2AMLogic/sky130-bandgap/layout/README.md

# layout/ — the klayout-tools (`klt`) DRC/LVS flow

Issue #14's deliverable: a headless, repeatable DRC/LVS flow driven by
[`klayout-tools`](https://github.com/2AMLogic/klayout-tools) (`klt`),
**proven on a trivial known-good cell**. Bandgap-core-specific layout
starts with issue #15's floorplan + matching plan (see "Extending to the
bandgap core" below) — the material above this section predates that and
is not core-specific.

Two rules from the root `CLAUDE.md` shape this directory the same way they
shape `sim/`:

- **Verification is the product.** A DRC/LVS "pass" claim ships with the
  actual reports it came from, plus a negative control proving the flow can
  also report failure.
- **Friction protocol, with force.** Every `klt` gap/awkwardness hit while
  standing this up gets checked against the public
  [`2AMLogic/klayout-tools`](https://github.com/2AMLogic/klayout-tools)
  tracker and filed (or, if already tracked, cross-confirmed) there —
  tool-gap description only, never this repo's design/spec content. See
  "Friction protocol: what was found" below.

## Quick start (cold machine)

```bash
# 1. install the pinned klt build (~10s; see requirements.txt for the pin)
layout/bin/setup-venv.sh

# 2. sanity-check the sky130A PDK resolves (same pin as sim/pdk.json)
layout/.venv/bin/klt pdk find --pdk sky130A

# 3. run the trivial-cell DRC/LVS proof (~5s)
layout/bin/run-trivial-cell-flow.sh
```

The last command writes a fresh, timestamped record under
`trivial-cell/reports/<record-id>/` and updates
`trivial-cell/reports/LATEST` to point at it. The current record is
whichever directory `trivial-cell/reports/LATEST` names (today
[`trivial-cell/reports/20260806-055840-3a4293a/record.md`](trivial-cell/reports/20260806-055840-3a4293a/record.md))
— **read that file first**; it is the actual pass/fail evidence this issue
delivers, not this README.

The oldest record, `20260803-133256-69a6ac2` (the original issue #14 proof
under `klt 0.1.0`, a different cell geometry and different LVS counts), is
retained as a historical citation, along with the other pre-`20260804-162626`
runs. Eight later runs that reproduced the current record's outcome were
pruned; see [`trivial-cell/PRUNED-RUNS.md`](trivial-cell/PRUNED-RUNS.md) for
the list and the recovery command.

## Why `klt`, and why a PyPI release pin

`klayout-tools` v0.8.0 on PyPI ships every verb this flow needs (`gen`,
`extract`, `lvs`, `drc`, `erc`, `pdk`, ...). Earlier in this repo's history
the PyPI release lagged `main` and the flow pinned an exact git commit
([2AMLogic/klayout-tools#342](https://github.com/2AMLogic/klayout-tools/issues/342));
issue #448 moved both requirements files to `klayout-tools==0.8.0`. A git
build now reports a dev version that fails an `==0.8.0` pin
(klayout-tools#2823), so the PyPI pin is preferred. `requirements.txt`
pins an **exact version**, not floating `main`, for the same reproducibility
discipline `sim/pdk.json` applies to the PDK version — a re-run months from
now installs the identical `klt` build instead of whatever `main` has
drifted to since. Bump the pin deliberately (and re-run
`layout/bin/run-trivial-cell-flow.sh` to refresh the checked-in report)
when picking up new `klt` capability.

## The flow

```
klt gen mos_array --pdk sky130A         (1) build the trivial known-good cell
        |
        v
klt drc <cell>.gds --deck sky130        (2) DRC against the sky130 deck
        |
        v
klt extract <cell>.gds --deck sky130    (3) layout -> schematic-equivalent netlist
        |
        v
klt lvs (extracted vs. hand-written      (4) LVS: topology compare
         reference netlist)
```

**The trivial cell**: `klt gen mos_array`'s documented defaults (a 2x2
array of unit NMOS devices with a one-column dummy guard on each side,
`nfet` flavor, no well) are chosen because the project's own docs guarantee
every generator's default `params` pass `klt drc --deck sky130` clean —
exactly the "trivial known-good cell" this issue's acceptance criteria
call for. `res_array` (the resistor-array generator — closer in spirit to
this repo's own poly-resistor-heavy topology) was tried first and rejected
for this specific proof: its output cannot round-trip through `klt
extract`'s resistor recognition today, a real `klt` gap, not a mistake on
this repo's side — see "Friction protocol" below. `mos_array` has no such
gap and round-trips cleanly through the whole flow.

**The reference netlist** (`trivial-cell/reference.spice`) is hand-written
to match `mos_array`'s pinned-default topology: 4 independent *real* unit
NMOS devices, each with its own isolated source/drain/gate net, bodies tied
to one shared `vsubs` pin. `klt lvs`/`NetlistComparer` compares topology, not
net *names* (see
[`docs/cli/lvs.md`](https://github.com/2AMLogic/klayout-tools/blob/main/docs/cli/lvs.md)
in the `klayout-tools` repo), so the reference's arbitrary net names do not
need to match the extracted netlist's own arbitrary `$N`-style names.
`mos_array` still physically draws 8 units (4 real + 4 dummy, the default
2x2-array-with-1-dummy-column shape) -- since issue #62's fourteenth
increment (2AMLogic/klayout-tools#490/#491, merged via #494/#495), sky130's
curated deck recognizes the 4 dummy-column units as dummies (no schematic
counterpart by construction) and `klt extract` drops them from the
comparison, so the reference only needs to state the 4 that matter. See
`trivial-cell/reference.spice`'s own header for the full history.

**Two negative controls** (`reference.broken-device.spice`,
`reference.broken-topology.spice`) prove the flow actually *fails* on a
real defect, not just that it produces a report — per `klt lvs`'s own
documented guidance, a device-parameter-only corruption and an independent
topology (shorted-net) corruption, since a single corruption class can
pass by accident on a compare that ignores the other axis. Both must (and
do) report `status: "mismatch"`.

## Repeatability

`layout/bin/run-trivial-cell-flow.sh` was run twice in immediate succession
from a clean worktree; both runs produced the identical four-way verdict
(DRC clean, LVS match on the good reference, LVS mismatch on both negative
controls) — `layout/bin/render-record.py` asserts all four and exits
non-zero if any flips, so a silent regression on a future `klt` pin bump
would fail loudly instead of quietly shipping a stale-looking "clean"
report. Only one of the two runs' reports is checked in (the redundant
second run added no evidence).

## Directory layout

```
layout/
  README.md                  # this file
  requirements.txt           # pinned `klt` install (PyPI `==0.8.0`) for the DRC/LVS flow
  bin/
    setup-venv.sh             # create/refresh layout/.venv from requirements.txt
    run-trivial-cell-flow.sh  # the repeatable driver: gen -> drc -> extract -> lvs -> report
    run-erc-supply-flow.sh    # T1 item 11: klt erc supply-spec run -> bandgap-core/erc/
    erc_supply_record.py      # that flow's gate + record.md renderer
    met1_bus.py               # hand-drawn met1 bussing + the met2/via1 escape plane
    met2_drc.py               # DRC for the met2 plane the curated deck has no rules for
    measure_mim_overlay_feasibility.py  # re-runnable "can MCC be a MiM overlay?" measurement
    measure_combine_devices_determinism.py  # re-runnable "does klt lvs's verdict reproduce?" measurement
    render-record.py          # renders + verdict-checks a record's record.md
  tests/                      # PDK-free unit coverage for the flows' own gates
  .venv/                      # gitignored -- `klt` install, created by setup-venv.sh
  bandgap-core/
    erc-supply-spec.json                    # T1 item 11 supply spec (klt 0.7.0 rejects comment keys)
    erc-supply-spec.rationale.md            # per-field rationale for that spec
    erc-nwell-tie-spec.negative-control.json  # same well boxes, nets swapped: must fail
    erc-nwell-tie-spec.known-gap.{vdd,vss}.json  # superseded klayout-tools#2339 reproduction (evidence)
    erc/
      README.md               # what the item-11 evidence does and does not establish
      <record-id>/            # erc.<gds-record-id>.json + record.md, one dir per flow run
    combine-determinism/
      <record-id>/            # determinism.<build-tag>.{json,md}: is the committed
                              # klt lvs verdict reproducible on a given klt build?
  trivial-cell/
    reference.spice                    # known-good LVS reference netlist
    reference.broken-device.spice      # negative control 1: device.property corruption
    reference.broken-topology.spice    # negative control 2: net.merged corruption
    reports/
      LATEST                    # plain-text pointer to the newest record id
      <record-id>/              # <YYYYMMDD-HHMMSS>-<short-git-sha>, one per run
        gen.json, trivial_mos_array.gds
        drc.json
        extract.json, trivial_mos_array.extract.spice
        lvs.request.json, lvs.json
        lvs.broken-device.request.json, lvs.broken-device.json
        lvs.broken-topology.request.json, lvs.broken-topology.json
        reference*.spice           # snapshot of the reference(s) used for this record
        report.md                  # `klt report --format github-summary` rendering
        record.md                  # human-readable pass/fail summary (read this first)
```

`<record-id>` mirrors `sim/`'s `<YYYYMMDD>-<HHMMSS>-<short-git-sha>` (UTC)
convention (see `sim/README.md`) so the two evidence trails read the same
way. Unlike `sim/`, this flow does not yet enforce a PDK-version pin the
way `sim/bin/corner-run.py` does — `record.md` surfaces the resolved PDK
version as a manual cross-check against `sim/pdk.json` instead.

## Friction protocol: what was found

Standing this flow up surfaced two real `klt` gaps. Both turned out to
already be tracked publicly (this canary's friction protocol has already
been exercised against this same tool from the sibling `gf180-bandgap`
repo, so a fresh, unrelated gap on every attempt is not expected) —
independently confirmed with a short reproduction comment on each rather
than filed as new duplicate issues, per the protocol's actual goal (surface
the gap, not inflate the tracker):

1. **[`klt gen res_array` never draws the resistor-ID marker layer its own
   PDK deck's resistor recognition requires](https://github.com/2AMLogic/klayout-tools/issues/369)**
   (open). Running the resistor-array generator's own output straight
   through `klt extract --deck sky130` extracts zero devices — the body
   geometry is silently absorbed into ordinary interconnect instead of
   recognized as a resistor. This is why the trivial-cell proof above uses
   `mos_array`, not `res_array`, even though poly resistors are closer to
   this repo's actual device mix — confirmed independently reproducing on
   `sky130`, tracked upstream, not re-filed.
2. **[PyPI's `klayout-tools` release lags `main` by 13 verbs](https://github.com/2AMLogic/klayout-tools/issues/342)**
   (open) — `gen`/`extract`/`lvs` (everything this flow needs beyond `drc`)
   were `main`-only when this was filed, hence this directory's then
   git-commit pin (superseded by the PyPI `==0.8.0` pin, issue #448). Confirmed as a downstream-consumer data point.

Both closed/already-fixed gaps hit along the way
([`__version__` drift from the released version](https://github.com/2AMLogic/klayout-tools/issues/69),
[no path to compose more than a single-generator layout](https://github.com/2AMLogic/klayout-tools/issues/210))
needed no action.

If a *new* gap (not already covered by the above) turns up in follow-on
layout issues, file it at `2AMLogic/klayout-tools` per the root `CLAUDE.md`
— tool-gap description only, no spec values or design content from this
repo.

## Known klt-deck limitations relevant to later, core-specific layout issues

Not gaps to file (both are documented, deliberate scope limits of the
curated `sky130` deck, not bugs) but worth flagging now for whichever later
issue takes on bandgap-core layout/LVS, since this issue's own scope
stops at the trivial-cell proof:

- **No NMOS substrate-tap extraction.** The curated deck ties every NMOS
  body to a single global `vsubs` net rather than a real drawn tap
  (`docs/cli/extract.md` → "Coverage"). Harmless for this issue's trivial
  cell (see `record.md`'s `device.body_unverified` note) but means an LVS
  reference netlist for a real block should also tie NMOS bodies to a
  single net, not model per-tap connectivity the extractor can't see.
- **No voltage-flavor distinction on MOS devices.** `klt extract`'s `nfet`/
  `pfet` classes are flavor-agnostic — a 5 V-flavor (thick-oxide) device
  and a core-voltage device both extract as the same generic class, with
  no `L`/`W`/oxide-thickness-based disambiguation. A future bandgap-core
  LVS reference netlist that mixes voltage flavors (per this repo's own
  device survey) will need `hints`/manual review to confirm the *intended*
  flavor correspondence, since `klt lvs` cannot check it structurally.
- The deck does recognize `pnp` (vertical bipolar) and three poly-resistor
  sheet-rho flavors as distinct device classes (see `klt extract`'s own
  `device_classes` field) — the primitive families this repo's core will
  need are already modeled in principle; #1's finding above is the one
  concrete blocker on the resistor family specifically, and only for the
  `klt gen`-generated fixture path, not for hand-drawn or PCell-instanced
  resistor geometry that already carries the marker layer.

## Extending to the bandgap core (issue #15)

Issue #15's deliverable: a floorplan + written matching plan for
`bandgap_core`/`error_amp`, plus an **initial placed layout skeleton**
proving the floorplan composes and DRC-cleans. Read
[`matching-plan.md`](matching-plan.md) first — it is the actual matching
rationale (which mismatch term dominates, per issue #12's Monte Carlo
contributor breakdown, and why the floorplan prioritizes it); this section
only points at where the generated evidence and tooling live.

The generate-place-guard-ring-DRC driver that produced this skeleton was
retired in issue #215 once issue #62 superseded it with a routed flow — see
"Routing the core and closing on LVS (issue #62)" below for the current
`layout/bin/run-bandgap-routed-flow.sh` command, which supersedes it end to
end (placement plus routing plus LVS). This section's own evidence stays
checked in as the historical record of issue #15's deliverable: it wrote a
fresh record under `bandgap-core/reports/<record-id>/` (same
`<YYYYMMDD-HHMMSS>-<short-sha>` convention as `trivial-cell/reports/`), and
the checked-in run is
[`bandgap-core/reports/20260803-192947-e7a30b4/record.md`](bandgap-core/reports/20260803-192947-e7a30b4/record.md)
— read that for the actual DRC-clean / area-budget evidence, and its
`renders/overview.png` for a visual check of the common-centroid/dummy-ring
placement.

`layout/requirements.txt`'s `klt` pin was bumped for this issue (see that
file's own comment) to pick up `gen-compose`'s `placement.strategy:
"explicit"` (2AMLogic/klayout-tools#330), which is what makes a real 2D
floorplan possible instead of the single-row-only composition #14's flow
used. The bump was verified non-regressing by re-running
`run-trivial-cell-flow.sh` unmodified before building on it — see
`trivial-cell/reports/` for the refreshed record with an identical PASS
verdict to the pre-bump one.

This skeleton is DRC-clean but explicitly **not** LVS-checked (two of its
matched-device generators, `bjt_array` and `res_array`, don't round-trip
through `klt extract` as recognized devices yet — see
`matching-plan.md` Section 7) and **not** a tape-out-ready layout (no
routing, and the resistor ladder is at reduced scale pending
2AMLogic/klayout-tools#415 — see `matching-plan.md` Section 4). Routing and
LVS are issue #62's scope, below.

## Routing the core and closing on LVS (issue #62)

```bash
layout/bin/setup-venv.sh                 # once, or after a requirements.txt bump
layout/bin/run-bandgap-routed-flow.sh    # gen -> draw -> compose+route -> drc -> extract -> lvs
```

Stages raw outputs in the git-ignored `bandgap-core/staging/<record-id>/`,
stores them in the fleet artifact store
(`manifests/artifacts/layout-bandgap-core-<record-id>.manifest.json`), and
commits only `record.md` and the verdict JSONs under
`bandgap-core/reports/<record-id>/` alongside (never replacing) earlier
records (issue #426). The records are kept in git;
the GDS blobs of the superseded 2026-08-03..05 runs now live in the artifact
store too, with pointers (sha256 per file) in
`manifests/artifacts/layout-bandgap-core-superseded-reports-440.manifest.json`
and the list in
[`bandgap-core/reports/ARTIFACT-STORE-RUNS.md`](bandgap-core/reports/ARTIFACT-STORE-RUNS.md)
(issue #440). It needs `$KLT_ARTIFACT_BROKER` and a `klt` with
`artifact put` on PATH, and exits before writing anything otherwise. It no
longer updates `bandgap-core/reports/LATEST`, which stays pinned to the last
fully tracked record (the label-collision regression test reads it).
`run-erc-supply-flow.sh` only checks the tracked GDS records; for a
store-backed record, fetch the GDS with `klt artifact get` first. **Read that record's `record.md` first** — it
carries a per-criterion scoreboard, the routed-net table, the promoted-pin
table, and a quantitative LVS mismatch analysis. Summary of what it measures:

| | #15 skeleton | #62 routed |
|---|---|---|
| inter-block routing | none drawn | 13/13 declared nets routed — **12/12 schematic inter-block nets fully joined** (criterion 1 MET), 7 hops via the met2 escape plane |
| promoted top-level pins | 0 | 11 |
| R2A/R2B ladder | 16 units (reduced) | **250 µm/leg (the real length, issue #99/#108-resized; was 270 µm before)** — 48 coarse 5 µm units folded into 10 rows, plus 40 fine 0.5 µm trim units in 4 rows carrying each leg's last 10 µm (issue #106/#112 halved the fine unit body length; was 46 coarse/20 fine 1 µm units before) |
| extracted `pnp` | 0 | 16 |
| extracted `nfet` | 0 | 16 |
| DRC | clean | clean |
| LVS | not attempted | runs; **`mismatch_count: 0`** as of issue #62's thirty-first increment (`MCC` now drawn) — see below |

Getting from the #15 skeleton to this state took roughly twenty-three
increments (`layout/matching-plan.md` Section 7 keeps a short entry for each
one; the full narratives are archived in
[`matching-plan-history.md`](matching-plan-history.md), not repeated here); a few changes are worth knowing before reading a record:

1. **Full-length ladder.** `res_array` gained a `rows` fold parameter
   (2AMLogic/klayout-tools#415, merged upstream), so the real R2A/R2B ladder
   folds into a compact block instead of a ~610 µm-long single row. It draws
   the schematic's whole 250 µm per leg (issue #99/#108's resize; was 270 µm
   before) — 48 coarse 5 µm units plus 20 fine 0.5 µm trim units (issue
   #106/#112 halved the fine unit body length, forcing the coarse count
   46 -> 48 to hold the leg fixed; was 46 coarse/20 fine 1 µm units before),
   so the trim taps *subtract* from the specified length rather than adding
   to it (issue #91; it drew 286 µm before that fix). The whole routed cell
   is 45,968 µm², inside the 50,000 µm² budget.
2. **PNP recognition is drawn by the generator itself now.** `klt gen
   bjt_array` originally drew no bipolar device-recognition marker on sky130
   and no well tap for its base pads, so its output extracted as *zero*
   devices — filed as
   [2AMLogic/klayout-tools#432](https://github.com/2AMLogic/klayout-tools/issues/432),
   resolved via [#440](https://github.com/2AMLogic/klayout-tools/issues/440):
   `bjt_array` now draws sky130's bipolar marker and a well tap per unit
   device on its own. The local `klt draw` overlay this flow used to compose
   to close the gap is retired.
3. **A met2 escape plane for inter-block hops met1 has no corridor for.**
   sky130's curated deck originally exposed exactly one routing metal above
   the device pads (`li1`/met1, the same layer every generator draws its own
   pads on) — filed as
   [2AMLogic/klayout-tools#433](https://github.com/2AMLogic/klayout-tools/issues/433),
   resolved via [#508](https://github.com/2AMLogic/klayout-tools/issues/508)
   (merged via #511): the curated *extraction* deck now has a met2/via1
   level too, which `gen_bandgap_routed.py`'s router uses as a last-resort
   escape for the three hops (`D1`, `GDRV`, `VSS`) that had no met1 corridor
   under any router lever tried (search depth, channel window, row-0
   margin/re-placement, a genuine 2D row split — `matching-plan.md` Sections
   7d-7o). The escape plane's own DRC is checked by this repo's own
   `layout/bin/met2_drc.py` against the installed PDK's source rules, since
   the curated *DRC* deck's met2/via coverage is still incomplete:
   [klayout-tools#513](https://github.com/2AMLogic/klayout-tools/issues/513)
   (closed, merged via #515) added the met2/via width, spacing, and
   via-enclosure rules, but the met2 min-area rule (`m2.6`) is still missing.

**All 12 of 12 schematic inter-block nets are joined across every block they
reach — criterion 1 is MET, not partial.** Measured against
`design/bandgap_core.sch`'s own inter-block node list, not just the flow's
own `connectivity[]` declaration; the record's "Schematic inter-block nets:
drawn vs. labelled only" table is the per-net evidence.

**LVS is not clean, but the one remaining cause is disclosed, non-topology,
and a deliberate scope choice, not a defect.** `mismatch_count` is **1** as
of issue #108 (was **4** from issue #62's twenty-first increment through
issue #98/#99's head-resistance investigation and resize); `devices.matched`
is 15, and there is no `device.class`, `net.split`, `net.merged`, or
`net.unmatched` mismatch left. Issue #112's `r_lseg_trim` propagation
(re-partitioning the R2A/R2B coarse/fine split and re-deriving
`reference.spice`'s chained values to match) re-measured this at the new
decomposition and holds it at 1 — not a carried-over number. The one cause:

1. **`MCC`** (the error amp's compensation cap) is in the schematic and
   deliberately not drawn — a single-ended layout omission documented since
   issue #15's own area-budget section, not a defect. The only
   `device.unmatched` entry.

**Update (issue #62's thirtieth/thirty-first increments, 2026-08-11):** the
operator ruled `MCC` is not a waivable exception (it sets the amp's
dominant pole; the loop-stability sim assumes it exists) and directed
realizing it — a `cap_mim` MIM-cap overlay if feasible, or the MOS cap the
schematic already states otherwise. Checked and found infeasible on two
independent grounds (tooling: PR #124, `layout/matching-plan.md` Section
7bb, filed as [klayout-tools#775](https://github.com/2AMLogic/klayout-tools/issues/775);
LVS device-class matching: Section 7cc, `MCC_MIM_INFEASIBLE_NOTE` in
`gen_bandgap_routed.py`). `MCC` is now drawn as the `pfet` MOS-as-capacitor
device the schematic already specifies (block `amp_cc`), and `klt lvs`
reports **`mismatch_count: 0`** — the cause above is retired. The composed
cell now measures 73,989 µm². The Area budget was relaxed from 50,000 µm² to
80,000 µm² (`< 0.08 mm²`) by
[DR-007](../spec/decision-records/DR-007-mcc-area-budget.md) (operator-ratified,
#62) to accommodate the drawn `MCC` cap, so `run-bandgap-routed-flow.sh`'s
`within_budget` gate now passes (73,989 ≤ 80,000 µm²) alongside the clean
`klt lvs` — see `layout/matching-plan.md` Section 7cc for the full measurement.

**A second cause was open through issue #62's twenty-third increment and is
now closed (issue #108): `res_high_po`'s per-device head/contact resistance
was charged once per drawn primitive, not once per logical device.**
sky130's real `sky130_fd_pr__res_high_po` SPICE model card has a fixed
per-instance head/end-resistance term in addition to its length-scaling
term, and `klt extract` models that term
([klayout-tools#518](https://github.com/2AMLogic/klayout-tools/issues/518),
merged). This repo's own trim-tap ladder draws each schematic `R1`/`R2A`/
`R2B` device as many (66, or 7) separately-contacted series primitives —
required so every DR-002 trim tap lands on real, individually contacted
metal — and `klt lvs`'s `combine_devices` sums the per-instance offset once
per primitive when it folds the series chain, not once for the logical
device (filed generically as
[klayout-tools#559](https://github.com/2AMLogic/klayout-tools/issues/559),
still open as a **request for a continuous-poly-with-taps generator
capability**, not as a live blocker of this repo's own LVS result). What
closed the cause on this repo's side, without needing #559: `reference.spice`
now states the CHAINED value (the sum of every drawn primitive's own
sheet-resistance-plus-head-offset, using the real device model's own two
constants) instead of design/bandgap_core.sch's single-device approximation
— exactly what `combine_devices` sums the layout side to, and exactly the
value issue #99's own resize was PVT-verified against. See
`layout/bandgap-core/reference.spice`'s own RESISTOR VALUE CONVENTION note
and `layout/matching-plan.md` Section 7y.

**The upstream tool fix for that cause now exists, is reachable, and is
deliberately not adopted — because adopting it would put the cause back.**
[klayout-tools#583](https://github.com/2AMLogic/klayout-tools/pull/583)
(closing #559) defers the `fixed_offset_ohm` correction until after
`combine_devices()` folds a series chain, applying it once per combined
device, and
[klayout-tools#587](https://github.com/2AMLogic/klayout-tools/pull/587)
(closing #585/#586) made that deferral reachable from this flow's own
pre-extracted (`{netlist, top}`) request shape. The reason #583 alone did not
reach it is worth stating precisely, because an earlier draft of this
increment got it wrong: `klt lvs` does **not** ignore `layout.deck` on the
pre-extracted shape — `layout_deck` resolves unconditionally inside
`run_lvs`, straight from the request dict. The real blocker was a
case-sensitivity bug, fixed by #587: the post-combine correction looked its
device class up by the deck's lowercase name (`res_high_po`) while a netlist
round-tripped through `kdb.NetlistSpiceReader` reports it uppercased
(`RES_HIGH_PO`).

`layout/bin/measure_fixed_offset_variants.py` re-runs `klt lvs` against the
shipped record's own drawn `.gds` under all four accounting combinations and
writes the evidence to
`layout/bandgap-core/fixed-offset-variants/<record-id>/`. At the shipped
record: the flow's own per-primitive/no-deck shape reports
`mismatch_count=1` with `devices.matched=15` and every resistor matched,
while #587's intended defer-plus-deck pairing reports `mismatch_count=4`,
`devices.matched=12`, and `R2A`/`R2B` at 81,586.52 Ω against the reference's
106,267.35 Ω. Since `reference.spice` now states the chained value the
layout's own decomposition sums to, the shipped accounting is the only one
that agrees with it — so the deferral is declined as a measured regression,
not merely on principle. The principle agrees anyway: DR-003 ratified that
this layout physically pays the head resistance once per separately contacted
instance, so re-reporting each leg at the single-device value would state a
resistance the fabricated cell does not have. See
`layout/matching-plan.md` Section 7z.

### The LVS verdict is reproducible on the pinned build — and not on newer ones

A `mismatch_count: 0` is only evidence if re-running the same request gets the
same answer. `layout/bin/measure_combine_devices_determinism.py` checks exactly
that: it re-runs the record's own committed `lvs.combined.request.json` N times
and tallies the verdict, writing to
`layout/bandgap-core/combine-determinism/<record-id>/`.

At the shipped record, on the `klt` build `requirements.txt` pins, the answer is
`mismatch_count: 0` on **1000 of 1000** trials. On the newer `klt` builds it is
`0` on 762 and a false `mismatch_count: 12` on 238 — same request, same
netlists, same process. Setting `options.combine_devices_max_attempts: 1`
restores 1000/1000, which isolates the cause to the `Netlist.dup()` copy that
klayout-tools#1185/#1186's combine-retry mitigation runs its adopted attempt
against (bisected to `66f73d0c`, the #1186 merge itself). The twelve findings
are all `device.property` on the two PNP groups, reporting a combined device
whose emitter/base/collector geometry was accumulated under an inverted rule —
so it is a tool defect, not a newly-detected layout defect, and **not** a
repeat of the `fixed_offset_ohm` accounting question above (the resistors match
in both outcomes). Filed as
[klayout-tools#2374](https://github.com/2AMLogic/klayout-tools/issues/2374);
full disposition in `layout/matching-plan.md` Section 7ff.

Two consequences worth stating plainly: (1) any future `requirements.txt` bump
that crosses `66f73d0c` inherits this, so it should wait for #2374 or pass
`options.combine_devices_max_attempts: 1` in this flow's request documents as
part of the same bump; (2) T1 item 4 stays uncited in
`signoff/block-manifest.json` — the only builds that populate
`provenance.input.content_hash` (which a manifest citation needs) are the ones
whose combine step is intermittently wrong.

**The underlying real-electrical finding behind that cause is still true and
is why the resize happened at all — issue #98 confirmed it is real and
material, independent of the LVS numbers themselves.** A standalone SPICE
testbench (`sim/res-array-head-resistance/run_res_array_head_resistance.py`)
chains real `sky130_fd_pr__res_high_po` unit-device model instances at the
routed array's own N/L shapes and reproduces `klt`'s LVS-extracted
`R1`/`R2A`/`R2B` values to 5-6 significant figures via a completely
independent mechanism — ruling out an extraction-only bookkeeping artifact.
At the pre-resize sizing this pushed `VOUT(27 °C)` outside the draft ±1%
window at all 5 PVT corners checked and collapsed regulation entirely at the
two hot corners issue #46/#91 already flagged as margin-thin. Ratified in
[DR-003](../spec/decision-records/DR-003-res-array-head-resistance-sizing.md);
the corrective resize (`n_r2` 54 -> 50, `n_r1` held at 7) landed in
`design/bandgap_core.sch` via issue #99 (PR #105) and was propagated into
this drawn layout, its `reference.spice` and this record by issue #108 —
DR-003's closure section and `layout/matching-plan.md` Section 7y have the
full before/after.

`MCC` is the only thing left between this layout and an LVS-clean result,
and it is a deliberate scope choice (see above), not something either
netlist needs a fix for — see `layout/matching-plan.md` Section 7y for the
current, fully-reasoned status and what it means for issue #62 and for
issue #16 (the post-layout extracted verification-suite re-run this issue
exists to unblock).

### The flow's own gates, and their unit tests

`run-bandgap-routed-flow.sh`'s exit status is not `klt`'s verdict — it is
`gen_bandgap_routed.flow_gate()`, ten named conditions that must all hold
(DRC clean, met2 DRC clean, area within budget, ladder at full scale, **the
drawn R2 leg length equal to the schematic's**, every device class extracted,
pins promoted, **no drawn shorts**, **no merged pin names**, **no split
routed nets**).
`klt lvs`-clean and full schematic-net coverage are deliberately *not* gated:
both are blocked on open upstream `klt` gaps, and gating on them would stop
the flow producing the very record that measures how far short it falls.

Two of those conditions are checks nothing else performs, and both catch the
same class of defect — the layout claiming connectivity the schematic does
not contain, which reads as a *better* LVS result and is therefore the one
failure mode that must never pass silently:

- **Drawn-short check** (`met1_bus.Met1Bus.conflicts()`). Every met1
  rectangle this flow hand-draws is tagged with its electrical node, so two
  nodes' wires touching — or sitting inside the deck's `met1.space.1` /
  `mcon.space.1` thresholds — is detectable here rather than showing up as a
  mystery LVS merge.
- **Label-collision check**
  (`gen_bandgap_routed.assert_no_merged_pin_names()`). A pin label landing on
  a pad another node's metal already contacts renames *that* node, and
  `klt extract` emits the result as a single `A|B` net with no diagnostic
  ([2AMLogic/klayout-tools#470](https://github.com/2AMLogic/klayout-tools/issues/470)).
  Invisible to DRC and to the drawn-short check — the shapes are legal and
  well separated; it is the labels that collide.
- **met2 DRC** (`layout/bin/met2_drc.py`). Since
  [klayout-tools#511](https://github.com/2AMLogic/klayout-tools/pull/511)
  sky130's curated *extraction* deck has a third connectivity level (met2
  over `via.drawing`), which is what lets the router escape a saturated met1.
  [klayout-tools#513](https://github.com/2AMLogic/klayout-tools/issues/513)
  (closed, merged via #515) has since added the width/spacing/enclosure rules
  for that level to the curated *DRC* deck (`met2.width.1`, `met2.space.1`,
  `via.width.1`, `via.space.1`, `met1.enclosing.via.1`, `met2.enclosing.via.1`),
  so `klt drc` now checks met2/via1 width, spacing, and via enclosure. What it
  still can't check is the met2 min-area rule (`m2.6`): #515 left it out because
  no `area` check primitive exists in the curated deck's rule vocabulary. This
  checker applies the installed sky130A PDK's own source rules (`m2.1`, `m2.2`,
  `m2.6`, `via.1a`, `via.2`, `via.4a`/`via.5a`, `m2.4`/`m2.5`) to the composed
  stream instead — its remaining reason to exist is the uncovered `m2.6` area
  gate.
- **R2 leg-length check** (`gen_bandgap_routed.r2_leg_length()`). The drawn
  divider leg's length against `design/bandgap_core.sch`'s own
  `L = r_lseg*n_r2 + r_lseg_trim*n_r2_trim`. `klt lvs` can only report a
  resistor's *value*, and only once both sides pair; `klt drc` has no opinion
  about length at all. For nineteen increments neither noticed that the trim
  ladder was wired in series *after* a full-length leg, drawing 286 um where
  the schematic states 270 and making every trim tap move the leg the one
  direction DR-002 forbids (issue #91). The check itself already existed and
  reported the defect — into `record.md` only. It is a gate row now.
- **Split-node check** (`met1_bus.Met1Bus.components()` scored by
  `gen_bandgap_routed.split_routed_nets()`). The inverse of the drawn-short
  check: a node this router reports as routed whose own metal is still in
  two pieces. It spans both routing planes — a met1 piece counts as joined
  to a met2 piece only where a via1 cut of the same net sits inside both —
  so a via stack that missed its own met1 is reported rather than reading as
  connected because each plane is individually in one piece.

Alongside them, `schematic_net_coverage()` scores acceptance criterion 1
against `design/bandgap_core.sch`'s own inter-block node list (never against
this flow's `connectivity[]` declaration) and also drives the router's
ordering search, so a scoring bug silently changes which layout gets drawn.

```bash
npm run test:unit    # or: python3 -m unittest discover -s layout/tests
```

`layout/tests/test_routed_flow_gates.py` covers those plus the gate
composition, in milliseconds, with **no `klt` install and no PDK** — so they
run in `npm run check:ci` on every push. Before these existed the three were
exercised only end-to-end, which meant their *failure* paths were never
exercised at all: a passing flow run by construction never reaches them. The
suite includes two regression cases read from this directory's own
append-only evidence (the record whose `VOUT`/trim-tap labels really did
collide, and the current clean one), so the gates are pinned against the
exact netlists they were written to judge.

`bandgap-core/reference.spice` is the schematic side of that comparison —
transcribed from `design/bandgap_core.sch` + `design/error_amp.sch`
(topology corroborated by the checked-in `n_r2=54` xschem snapshot its
header cites (`sim/output-voltage-tc/netlist-snapshots/`), which predates
issue #99's resize but is still correct evidence for the topology; the R2A/
R2B/R1 *values* are transcribed from the resized `n_r2=50` chained-array
sizing instead, per `sim/res-array-resize/records/` and the file's own
RESISTOR VALUE CONVENTION note), never derived from the layout.
It states the schematic even where the layout falls short of it: there is no
0-ohm bridge device standing in for the unrouted `AOUT`→`GDRV` net.

## Structural power-delivery check (`klt erc`, T1 item 11, issue #281)

A third flow lives alongside the trivial-cell and routed-core flows above,
answering the one question neither of them asks: **is the supply actually
connected to what it powers.** DRC checks geometry against rules; LVS checks
the extracted netlist against a reference; neither of them asserts that `VDD`
and `VSS` each form a single electrical island across the drawn stack. That is
T1 checklist **item 11** (power delivery, *structural*), added upstream on
2026-09-17, and it is graded from a `klt erc` supply-spec run.

```bash
layout/bin/run-erc-supply-flow.sh    # ~seconds, no PDK install needed
```

The flow needs **no PDK**: `--deck sky130` resolves the curated extraction deck
from inside the `klt` package, and `--pdk sky130` selects a built-in
antenna-limit table. It writes one record per run under
`bandgap-core/erc/<record-id>/` — same `<YYYYMMDD-HHMMSS>-<short-sha>` UTC
convention as `bandgap-core/reports/` — containing the raw `klt erc --format
json` output for every committed routed GDS plus a gated `record.md`.

- **The spec**: `bandgap-core/erc-supply-spec.json`, with
  `erc-supply-spec.rationale.md` beside it justifying every `stackup` entry,
  every `label_layer`, and the two n-well `ties[]` (klt 0.7.0 rejects unknown
  spec keys, so the rationale can no longer live inside the JSON). Each layer/datatype pair was resolved twice — against the sky130A
  PDK's own `libs.tech/klayout/tech/sky130A.lyp` **and** against
  klayout-tools' curated sky130 deck layer table.
- **The gate** (`layout/bin/erc_supply_record.py`, unit-covered by
  `layout/tests/test_erc_supply_gate.py`) is item 11's own pass condition and
  deliberately **not** the report's overall `status`: both supplies present in
  `erc_coverage.checked`, zero `erc.unconnected_net` / `erc.supply_short`
  naming either of them, and the report's `provenance.input.content_hash`
  equal to the sha256 of the GDS it names; both n-well ties in
  `erc_coverage.checked`, `skipped` empty, zero `erc.missing_tie`, and no
  `ties_disclosure`; and the swapped-net negative control must flag every
  n-well shape. An antenna verdict or a
  floating-gate finding is a real defect but is not this item's subject and
  does not fail the gate (klayout-tools#1994).
- **One `klt` pin.** The ERC flow runs from the same `layout/.venv` and
  `requirements.txt` pin as DRC/LVS. It was once pinned separately
  (`requirements-erc.txt` / `layout/.venv-erc`, so `klt erc`'s September
  capability did not drag the DRC/LVS evidence trail along); the two pins
  converged on `==0.8.0` in issue #448 and the split was removed. Committed
  v0.7.0 ERC records still cite the old file in their provenance.
- **Result**: the supply half and the `erc.missing_tie` half are both
  computed. The eight n-well shapes (five PMOS-body wells at `VDD`, three
  vertical-PNP base tubs at `VSS`) are scoped per class with
  `ties[].well_requires_boxes`, so the ties rest on caller-named coordinates
  (listed in `erc_coverage.checked_by_well_assertion`); the swapped-net
  negative control committed beside each record is what makes the clean result
  falsifiable. Read [`bandgap-core/erc/README.md`](bandgap-core/erc/README.md)
  for the full claim.

### Friction protocol: what this flow found

**[2AMLogic/klayout-tools#2339](https://github.com/2AMLogic/klayout-tools/issues/2339)**
(filed from this flow, **cleared on klt 0.7.0**): `ties[].well_layer` checked
*every* merged shape on its layer against one `net`, so a block whose single
tub layer holds two differently-biased well classes could not declare either
tie. 0.7.0 adds `ties[].well_requires_boxes` / `well_excludes_boxes` (#2540),
which this flow now uses. The pre-0.7.0 reproduction
(`bandgap-core/erc-nwell-tie-spec.known-gap.{vdd,vss}.json` and the reports in
the older records) is kept as append-only evidence and is no longer run.

Two already-tracked upstream gaps were **re-confirmed fixed** rather than
re-filed, per this directory's own protocol (surface the gap, do not inflate
the tracker):

- [klayout-tools#2169](https://github.com/2AMLogic/klayout-tools/issues/2169)
  (`ties[]` collapsing a routed design into one island and reporting a false
  `erc.supply_short`) — fixed by #2186 and confirmed not to reproduce here:
  both known-gap runs declared a real tie and reported **zero**
  `erc.supply_short`; so does the current spec.
- [klayout-tools#2183](https://github.com/2AMLogic/klayout-tools/issues/2183)
  (a drawn resistor body read as a wire, fabricating a supply short across any
  rail-to-rail device string) — fixed by the `--deck` device-marker
  auto-detection, which carves this block's `res_high_po` poly bodies out of
  the `poly` conductor role; the carve-out and its area are recorded in every
  report's own `provenance.devices`.
