2AMLogic/sky130-bandgap/sim/startup-stability-post-layout/README.md

# `startup-stability-post-layout` — divergence finding

Post-layout (`provenance: extracted`) re-run of `sim/startup-stability`'s
degenerate-state / single-equilibrium claim against the ROUTED, LVS-clean
`layout/bandgap-core/` GDS (issue #62) wired to the SCHEMATIC-netlisted
`design/startup_injector.sch` (issue #10 has no layout yet for the
injector), for issue #16. Records here are append-only and are **new**
evidence — they neither overwrite nor retire `sim/startup-stability/`'s
schematic-level records.

This file exists because issue #16 requires any divergence from the
schematic-level result to be **documented as a finding, not reconciled
away**. The core claim — exactly one DC equilibrium, actively driven away
from the degenerate state — holds identically post-layout; the divergence is
a quantitative one, in the injector-attach cost (`dvref`), that grows at
every corner but stays well inside the bench's own bound.

## What the record says

Record `20260812-065107-7eb5be4` — worst-corner 8-point subset (process in
{ff, ss} x temperature in {-40, 125} °C x supply in {2.97, 3.63} V; see the
record body for the full subset justification), `Overall: PASS`, 8/8.

| Quantity | Post-layout (extracted) range | Limit | Verdict |
|---|---|---|---|
| `ncross_su` (equilibrium count, injector attached) | 1 at every corner | == 1 | pass, 8/8 |
| `ncross_bare` (control: bare-core equilibrium count) | ~1.00001 … 3 | reported, not gated | n/a (control) |
| `dvref` (injector-attach cost) | 0.0215 … 15.5479 mV | ±20 mV | pass, 8/8 |
| `vgdrv_dut` spread check | 0.9136 V observed | ≥ 0.3 V | pass |
| `vref_dut` spread check | 0.0512 V observed | ≥ 0.01 V | pass |

## Why a new schematic-level baseline was needed

`sim/startup-stability/`'s existing committed records all predate the `n_r2`
resize chain (`54 -> 50`, DR-003 close-out issue #99, PR #105/#110/#111/#113)
— the same conflation-with-a-resize trap `sim/line-regulation-post-layout/README.md`
and `sim/startup-ramp-post-layout/README.md` already document for their own
benches. A new same-sizing schematic-level record,
`sim/startup-stability/records/20260812-081515-7eb5be4`, was appended at the
identical 8-point worst-corner subset for a clean, corner-for-corner
comparison against this post-layout record (same bench, same manifest, same
measurement expressions, same commit `7eb5be4`; the only variable is the DUT
body).

## The divergence: `dvref` (injector-attach cost) grows at every corner

`dvref` is `v(vrefd)[0] - v(vrefr)[0]` — the shift attaching the injector
puts on the reference, measured within one DUT (free-running core+injector
minus the bare-core control at the same corner), not a schematic-vs-layout
comparison by itself. Comparing the two same-sizing, same-corner records:

| Corner | schematic `dvref` | post-layout `dvref` | delta |
|---|---|---|---|
| `ff_-40c_2.97v` | 0.2845 mV | 0.4537 mV | +0.1692 mV |
| `ff_-40c_3.63v` | 0.9242 mV | 1.4633 mV | +0.5391 mV |
| `ff_125c_2.97v` | 0.2442 mV | 0.3911 mV | +0.1468 mV |
| `ff_125c_3.63v` | **8.0001 mV** | **15.5479 mV** | **+7.5479 mV** |
| `ss_-40c_2.97v` | 0.0215 mV | 0.0349 mV | +0.0134 mV |
| `ss_-40c_3.63v` | 0.0748 mV | 0.1206 mV | +0.0458 mV |
| `ss_125c_2.97v` | 0.0594 mV | 0.0910 mV | +0.0316 mV |
| `ss_125c_3.63v` | 0.2154 mV | 0.7592 mV | +0.5438 mV |

`dvref` grows at all 8 corners, roughly in proportion to its own schematic
value (worst corner nearly doubles: 8.00 -> 15.55 mV), and the worst corner
is the same one in both records (`ff/125 °C/3.63 V`) — the same shape as
`sim/quiescent-current-post-layout/README.md`'s finding that extraction acts
as a *scale factor* rather than a new mechanism. `dvref`'s own note in
`sim/startup-stability/experiment.json` explains why: it is a residual
current out of the high-impedance `GDRV` node read back as a voltage
(roughly 0.2 mV per nA), so anything that changes the resistance network
around that node moves it — exactly the star-R parasitic network
`sim/quiescent-current-post-layout/README.md` (R1 +55 %) and
`sim/line-regulation-post-layout/README.md` (K = R2/R1 -0.2 % from
parasitics alone, +9.7 % from the drawn chained array) already attribute
this extraction's other shifts to.

**The claim itself does not weaken.** `ncross_su` is exactly 1 at every one
of the 8 corners in both records — the single-equilibrium property `sim/startup-stability`
exists to verify is untouched by extraction. Even at its worst corner,
post-layout `dvref` (15.5 mV) is comfortably inside the bench's own ±20 mV
bound, with headroom to spare; the finding is that the margin shrinks from
schematic's 12.0 mV to 4.45 mV at that one corner, not that the bound is
threatened.

## Update (2026-09-10, issue #279): re-run against the post-#193 chained-array design — margin now thin, not just narrowed

Issue #279 re-ran this bench (and its schematic-level sibling, at the same
8-point worst-corner subset) against the current design after issue #193
changed `design/bandgap_core.sch`'s resistor network (chained-array model,
`n_r2` 50 → 51). New records:
`sim/startup-stability/records/20260909-232410-e8e2e46.md` (schematic,
supersedes `20260815-032111-001d1b7`) and
`sim/startup-stability-post-layout/records/20260909-232410-e8e2e46.md`
(post-layout, supersedes `20260815-040144-001d1b7`), both against the routed
layout report `layout/bandgap-core/reports/20260817-020222-13476b7/`.

Both are `Overall: PASS`, 45/45 and 8/8 respectively — `ncross_su` is still
exactly 1 at every corner in both, so the single-equilibrium claim itself is
untouched. **But the worst-corner `dvref` margin has shrunk sharply**, not
merely narrowed as the prior cycle's finding described:

| Corner | prior schematic | prior post-layout | **new schematic** | **new post-layout** |
|---|---|---|---|---|
| `ff_125c_3.63v` (worst) | 8.00 mV | 15.55 mV | **14.66 mV** | **19.31 mV** |

Post-layout `dvref` at the worst corner is now **19.31 mV against the ±20 mV
bound — 0.69 mV of headroom**, down from the prior cycle's 4.45 mV headroom
and the cycle before that's comfortable margin. The verdict is still PASS,
but this is materially closer to the bound than either prior record showed,
and worth flagging explicitly rather than only noting "the margin shrinks":
a further resistor-network change of similar magnitude to #193's could flip
this corner to FAIL without any change to the single-equilibrium property
itself. All 7 non-worst corners remain far from the bound (see the record for
full values), so this is a single-corner watch item, not a broad regression.
Same attributed mechanism as before (the `GDRV`-node residual-current
readback scaling with the resistance network around it) — `dvref` grew at
schematic level too (8.00→14.66 mV), confirming the shift is the design
change, not a new extraction artifact.

Per this repo's append-only convention, the sections above are left exactly
as written — this is a dated addendum, not a rewrite.

## Known gaps (not closed by this record)

- This record and its schematic-level comparison baseline only cover the
  8-corner worst-case subset, not the full 45-point matrix — see the record
  body's subset justification (citing `sim/startup-ramp`'s and
  `sim/startup-stability`'s own notes for where this design's margin is
  thinnest). The sibling `sim/startup-ramp-post-layout/` runs the full
  matrix instead, since a single corner there is far cheaper.

## Update (2026-09-24, issue #299): the bench was restructured, and `dvref` is no longer measured here

Issue #285 drew `design/startup_injector.sch` into the composed layout cell.
That ended the mixed-provenance construction every record above was taken
with — extracted core + separately netlisted schematic injector + bare-core
control instances — because against an injector-inclusive extracted body the
DUT instances (XDUT/XSW) would carry **two** injectors and the control
instances (XREF/XSWN) would silently stop being bare. Neither shows up in the
output.

**Decided DUT shape: the composed cell alone, with no schematic-level
control.** This bench no longer wraps `sim/startup-stability/`'s testbench or
manifest. It carries its own `testbench/tb_startup_stability_pl.sch` —
`design/bandgap_core.sym` instances only (XSW with GDRV forced, XDUT
free-running), with no `design/startup_injector.sym` anywhere in the deck —
and its own `experiment.json`.

A schematic-netlisted bare core placed *alongside* the extracted one was
considered and rejected: every difference it produced would be a mixture of
"what the injector costs" and "what the extraction costs", which is the
mixed-provenance mistake being removed rather than a repair of it.

### What that costs, stated rather than absorbed

Six measurements are gone from this bench: `imin_off_bare`, `i_off_bare`,
`ncross_bare` (statements about the unprotected core) and `dvref`,
`i_standing`, `i_su_standing` (the price of *attaching* the injector). The
first three remain a schematic-level claim, carried by report row 8a. The
last three have **no post-layout meaning at all** against a monolithic drawn
cell — there is no "before attaching" instance to difference against.

**So the `dvref` watch item this README's 2026-09-10 addendum raised is no
longer tracked by this bench.** That is a real, disclosed reduction in
coverage, not a resolution: the 19.31 mV-against-±20 mV worst corner was a
post-layout number, and nothing post-layout measures it now. What did not
disappear is the schematic-level half of the same trend (8.00 → 14.66 mV over
the same two cycles), which `sim/startup-stability/` still measures at all 45
corners, and the post-layout *consequences* of the injector being in the cell,
which report rows 1b / 4b / 6b each measured by re-running the same layout
record before and after #285. Anyone picking the watch item back up should
start from row 4b (`sim/psrr-dc-with-injector/`, #300), which is the
schematic-level-control pattern that works here.

### What replaces the control's falsifiability job

Two things, both in-bench:

- **Structurally**: `post_layout_common.require_layout_draws_injector()` — the
  mirror image of the `refuse_if_layout_draws_injector()` guard this bench used
  to call — aborts before any ngspice time is spent unless the layout record
  under test states the injector's six device cards (`MMPC1`, `MMPC2`,
  `MMNS`, `MMNI`, `MMNC`, `QQS` — the SPICE cards `design/startup_injector.sch`'s
  `MPC1`/`MPC2`/`MNS`/`MNI`/`MNC`/`QS` netlist to) in its own LVS reference
  netlist. The dangerous direction
  is now a core-only layout being measured and recorded as the composed cell.
- **Numerically**: `imin_off_su` (≥ 1e-8 A) and `i_off_su` (≥ 1e-6 A) *are* the
  bare core's failure mode stated as a bound. An absent injector collapses both
  onto the leakage level `imin_off_bare`/`i_off_bare` used to report — orders of
  magnitude under the floor.

### First record from the new shape

`20260924-041313-999407b`, against layout record `20260923-070209-dbd57a9`
(the injector-inclusive composed cell), same 8-point worst-corner subset:
`Overall: PASS`, 8/8, plus both corner-sensitivity checks. `ncross_su = 1` at
every corner. `imin_off_su` 23.5 µA – 1.00 mA and `i_off_su` 306 µA – 1.25 mA,
three to five orders of magnitude clear of their floors.

Comparison with the records above is **not** a like-for-like extraction
divergence: the DUT construction changed at the same time as the layout, so
the two are not separable in this pair. That is why this addendum reports the
new record's own absolute numbers and their distance from their own bounds,
rather than a delta against `20260909-232410-e8e2e46`.

Per this repo's append-only convention, the sections above are left exactly as
written — this is a dated addendum, not a rewrite.

## Experiment description and record history

Moved verbatim from the "Experiments that do not go through the corner runner" table in `sim/README.md` (issue #339). The newest entry under `records/` is authoritative for the current verdict; the text below was written when the cited records were current.

**RESTRUCTURED by issue #299 — this is one of only two post-layout benches that does NOT wrap its schematic-level sibling.** It carries its own `testbench/tb_startup_stability_pl.sch` and its own `experiment.json`. The DUT is the **composed cell alone**: `design/bandgap_core.sym` instances only (XSW forced, XDUT free-running), with no `design/startup_injector.sym` anywhere in the deck, because since issue #285 the extracted body supplies the injector itself. The manifest **drops** the six measurements that were readings on or differences against a bare-core control instance (`imin_off_bare`, `i_off_bare`, `ncross_bare`, `dvref`, `i_standing`, `i_su_standing`) — a drawn monolithic cell cannot express such a control, and a schematic-netlisted bare core placed alongside an extracted one would mix "what the injector costs" with "what the extraction costs". Those claims stay at schematic level (report row 8a). What replaces the delta is a bound plus a precondition: `imin_off_su` ≥ 1e-8 A and `i_off_su` ≥ 1e-6 A are the bare core's failure mode stated as a floor, and `post_layout_common.require_layout_draws_injector()` refuses the run outright against a layout record whose LVS reference netlist does not state the injector's six device cards (`MMPC1`, `MMPC2`, `MMNS`, `MMNI`, `MMNC`, `QQS`) (the mirror image of the `refuse_if_layout_draws_injector()` guard it replaces). Current record `20260924-041313-999407b`, `Overall: PASS` 8/8, against layout record `20260923-070209-dbd57a9`; report row 8b. Historical description (the pre-#299 mixed-provenance shape, which produced every earlier record here): **Post-layout (`provenance: extracted`) re-run of `sim/startup-stability`'s degenerate-state / single-equilibrium claim (issue #16, the first of the two remaining "#10 startup/degenerate-state checks" increments)** — a MIXED-provenance DUT, not all-extracted like the six rows above: the extracted, translated `bandgap_core` swaps in for every `design/bandgap_core.sym` instance, but `design/startup_injector.sch` stays netlisted unmodified since it has no layout yet (`layout/bandgap-core/` composes core + amplifier only). Worst-corner 8-point SUBSET (process in {ff, ss} x temperature in {-40, 125} C x supply in {2.97, 3.63} V — issue #16's Acceptance Criteria phrase this bullet "at worst corners", unlike the full-matrix "#11 testbench suite" bullet). `Overall: PASS`, 8/8 — exactly one DC operating point at every corner, the degenerate zero-current state actively driven away from by microamps. Its own worst injector-attach cost (`dvref`) is +15.5 mV at `ff/125 C/3.63 V`, well inside the bench's ±20 mV bound but nearly double the schematic-level design's own +8.70 mV worst case (record `20260803-204236-f41373d`) — a real, documented divergence, see its `README.md`. This pair of benches is also where a `sim/bin/post_layout_common.py` `strip_schematic_subckts()` bug was found and fixed: a lazy-wildcard header-matching gap could let stripping `error_amp` collaterally delete the `startup_injector` block sandwiched between it and `bandgap_core` in netlisting order — see that function's docstring

### Note shared with `sim/startup-ramp-post-layout/` (moved verbatim from `sim/README.md`)

Both `startup-stability-post-layout` and `startup-ramp-post-layout` needed no
new body-assembly code beyond the bugfix above: `build_extracted_body()`'s
`.subckt`-scoped `strip_schematic_subckts()` already only removes the NAMED
`bandgap_core`/`error_amp` blocks, so a testbench that also netlists
`design/startup_injector.sym` (untouched by that name) gets a correct mixed
extracted-core/schematic-injector body for free once the collateral-deletion
bug above is fixed — no separate mixed-provenance assembly path was required
after all. This closes out issue #16's own "Adding the remaining post-layout
re-runs" note that used to live here.

**Superseded by issue #285/#299, kept for the record.** The paragraph above
describes a construction that no longer exists: the composed cell draws the
injector now, so there is no schematic injector left to assemble alongside the
extracted core, and both benches instantiate `design/bandgap_core.sym` alone.
`build_extracted_body()` and `strip_schematic_subckts()` are unchanged and the
bugfix they carry is still load-bearing for every other bench — what changed is
only that these two benches no longer exercise the mixed case. The DUT-shape
decision and what it costs are stated in each bench's own `experiment.json`
("WHY THIS MANIFEST EXISTS" / "DROPPED MEASUREMENTS") and in
`design/block-characterization-report.md`'s 2026-09-24 revision entry.
