2AMLogic/sky130-bandgap/layout/bandgap-core/reports/20260923-070209-dbd57a9/record.md

# Bandgap-core routed layout record: 20260923-070209-dbd57a9

Routed-and-extracted successor to the issue #15 placement-only floorplan skeleton (`layout/bandgap-core/reports/` earlier records). Read `layout/matching-plan.md` for the matching rationale this layout implements; this record is the measured evidence, not the rationale.

## Acceptance-criteria scoreboard (issue #62)

| # | Criterion | Status | Evidence |
| --- | --- | --- | --- |
| 1 | Full inter-block routing | MET | 14/14 **schematic** inter-block nets fully drawn (15/15 declared met1 nets routed, 0 unrouted) -- see "Schematic inter-block nets" below |
| 2 | Resistor ladder at real unit count | MET | `res_r2` num=98 (= 2 legs x 49 coarse 5um units) + `res_trim` num=40 (= 2 legs x 20 fine 0.5um units) = 255 um/leg at DR-002 code 0, against design/bandgap_core.sch's `r_lseg*n_r2` = 255 um (delta +0 um); composed bbox 70,360 um^2 vs 80,000 um^2 budget |
| 3 | Extract: correct device classes + promoted pins | MET | device_counts={"nfet": 19, "pfet": 54, "pnp": 24, "res_high_po": 145}, pin_count=13 |
| 4 | `klt lvs` clean | MET | status=match, mismatch_count=0 |
| 5 | Blocking `klt` gaps filed as friction | MET | every gap this flow ever named as *blocking* is now CLOSED upstream and this record is the re-run against them: 2AMLogic/klayout-tools#461 via #474, #462 via #471, #463 via #475, #454 via #468, #470 via #481, #490 via #495, #491 via #494, #492 via #497/#498, #504 via #505, and -- turned on by the nineteenth increment -- **#508 via #511** (sky130's curated deck gains met2 as a third connectivity level, which is what makes criterion 1's escape plane real connectivity rather than inert geometry; see ROUTING_PLANE_NOTE / MET2_ESCAPE_NOTE). 2AMLogic/klayout-tools#506 (the generic arity reconciliation #505 deferred, filed by the fifteenth increment) has since closed as COMPLETED too -- this flow never needed it, because its own reference can state the bulk net directly. **Every gap this flow has ever filed as blocking is now closed upstream.** Two non-blocking gaps were filed by the nineteenth increment: **klayout-tools#513** is the flip side of #511 -- the curated sky130 **DRC** deck was not extended alongside the extraction deck, so `klt drc` returns violation_count=0 on any met2 geometry whatsoever, and this flow checks the plane itself instead (`layout/bin/met2_drc.py`, gated; see the met2 DRC row in Results). **klayout-tools#514** is the labelling gap INTERNAL_NODE_LABEL_NOTE describes: there is no way to name a net without promoting it to a pin, and a pin on a node interior to a schematic device silently blocks `combine_devices` with nothing attributing the resulting mismatches to it. The twenty-first increment filed no new gap (the PNP `ae`/`pe`/`ne` fix was a `reference.spice` transcription fix, needing no new `klt` capability). **This (twenty-third) increment picks up 2AMLogic/klayout-tools#518 via #519 and #521 via #526** (the `res_high_po` fixed head/end-resistance term, and the fix that makes it reach the written netlist `klt lvs` compares) and, having measured that picking them up does not close AC4's resistor cause, files one new non-blocking gap: **klayout-tools#559** -- `ResistorDevice.fixed_offset_ohm` is charged once per drawn primitive, not once per logical device, so `combine_devices` folding a caller's own multi-primitive series decomposition (this flow's trim-tap ladder) sums it once per primitive instead of once for the schematic-level device. **This (twenty-eighth) increment bumps the klt pin past #583 (which closed #559 by deferring that correction until after `combine_devices()` folds) and #587 (which made the deferral reachable from this flow's own pre-extracted request shape, closing #585/#586 -- the real blocker was a case-sensitive device-class lookup that missed the `NetlistSpiceReader`-uppercased `RES_HIGH_PO` name, NOT `layout.deck` being ignored on that shape: `layout_deck` resolves unconditionally in `run_lvs`).** The once-per-combined-device correction is therefore reachable now, and is measured with `layout/bin/measure_fixed_offset_variants.py` across all four accounting combinations (`layout/bandgap-core/fixed-offset-variants/<record-id>/`). It is **deliberately NOT adopted**, and at this repo's current state adopting it would be a measured REGRESSION rather than a neutral choice: since issue #108 settled `reference.spice` on the CHAINED value this flow's own multi-primitive decomposition sums to, the shipped per-primitive accounting is the only variant that matches at all -- #587's own defer-plus-deck pairing takes `mismatch_count` 1 -> 4 and `devices.matched` 15 -> 12. DR-003's ratified finding points the same way: this layout physically pays the head resistance once per separately-contacted instance, so re-reporting each leg at the single-device value would state a resistance the fabricated cell does not have. See RES_HEAD_RESISTANCE_NOTE, DR-003 and layout/matching-plan.md Section 7z |

- [x] DRC on the composed, routed layout is clean
- [x] Composed bbox area (70,360 um^2) is within the < 0.05 mm^2 (80,000 um^2) budget, **at the real full-length ladder count** (98 coarse + 40 fine units)

## Flow

1. `klt gen` once per matched device group (16 blocks).
2. `klt draw` once, for the whole cell: every intra-block bus and every inter-block net, on met1 over mcon -- plus, for the hops met1 has no corridor for, a met2 escape over `via.drawing` (MET2_ESCAPE_NOTE) -- and one met1 net label per *schematic* node. `bandgap_core_bus.draw.json`, summarised in `bus-summary.json`.
3. `klt gen-compose` with `placement.strategy: "explicit"`, an empty `connectivity[]` (routing is drawn above) and an empty `pins[]` -- every pin this cell promotes is now a net label from step 2, and the four trim-tap pin entries earlier records carried are gone (INTERNAL_NODE_LABEL_NOTE). `compose.request.json`.
4. `klt drc <composed> --deck sky130`.
4b. `layout/bin/met2_drc.py <composed>` -- the escape plane's own DRC, because the curated deck step 4 runs is still missing the met2 min-area rule (`m2.6`; klayout-tools#513/#515 added the rest).
5. `klt extract <composed> --deck sky130 --top bandgap_core_routed`.
6. `klt lvs` against the xschem-derived reference netlist (issue #8), twice -- with and without `options.combine_devices`.
7. `klt render` for the visual check below.

## Device-half binding

A `klt gen diff_pair` reports its two transistors as two port families (`M1_*`/`M2_*`, or `Q1_*`/`Q2_*` when `mirror` is false). Which family is which schematic device is *this flow's* choice, not the generator's -- the halves are geometrically interchangeable. Until this increment that choice was never made: every net picked whichever candidate pad sat nearest its own centroid, independently. Two consequences were live in the previous record. `PN` took a finger of the same amp_pmirr half the `AOUT` label named, so MP3's drain and MP4's drain were the same physical transistor; and amp_nload's `D1` route and `D1_GATE` label disagreed about which half is MN1. Neither is visible to DRC or to the drawn-short check -- every terminal involved is legal, well-separated metal.

| block | port family | schematic device | drain pad | source pad |
| --- | --- | --- | --- | --- |
| `core_mirror` | `M1_*` | `MPOUT` | `M1_*_D` | `M1_*_S` |
| `core_mirror` | `M2_*` | `MPAMP` | `M2_*_D` | `M2_*_S` |
| `amp_input_pair` | `Q2_*` | `MP1` | `Q2_*_D` | `Q2_*_S` |
| `amp_input_pair` | `Q1_*` | `MP2` | `Q1_*_D` | `Q1_*_S` |
| `amp_nload` | `M1_*` | `MN1` | `M1_*_S` | `M1_*_D` |
| `amp_nload` | `M2_*` | `MN2` | `M2_*_S` | `M2_*_D` |
| `amp_pmirr` | `M1_*` | `MP3` | `M1_*_D` | `M1_*_S` |
| `amp_pmirr` | `M2_*` | `MP4` | `M2_*_D` | `M2_*_S` |
| `amp_nmirr` | `M1_*` | `MN4` | `M1_*_S` | `M1_*_D` |
| `amp_nmirr` | `M2_*` | `MN3` | `M2_*_S` | `M2_*_D` |
| `amp_cc` | `M1_*` | `MCC_A` | `M1_*_D` | `M1_*_S` |
| `amp_cc` | `M2_*` | `MCC_B` | `M2_*_D` | `M2_*_S` |
| `su_ref` | `M1_*` | `MPC1` | `M1_*_D` | `M1_*_S` |
| `su_ref` | `M2_*` | `MPC2` | `M2_*_D` | `M2_*_S` |

Every routed terminal and every gate pin label now resolves through that table (`mos_terminal()` / `bulk_terminal()`), so a node can only land on the transistor the schematic names.

## Blocks

| id | generator | matched group | real target |
| --- | --- | --- | --- |
| `pnp_ctat` | `bjt_array` | Q1 (CTAT PNP, small unit W0p68L0p68) | m=8 sky130_fd_pr__pnp_05v5_W0p68L0p68 (design/bandgap_core.sch); drawn 1:1 (8 real units, 2x4 common-centroid) |
| `res_r2` | `res_array` | R2A/R2B interdigitated ladder (K = R2/R1 divider) | 49 coarse 5um segments PER LEG x 2 legs = 98 total = 245 um/leg, the coarse part of design/bandgap_core.sch's 255 um (`r_lseg*n_r2` at n_r2=51); the remaining 10 um is `res_trim`'s fine ladder, so the trim taps subtract from the specified length instead of adding to it (issue #91). The skeleton's 16-unit reduction is closed by `res_array`'s `rows` fold parameter (2AMLogic/klayout-tools#415, merged via #418) |
| `res_trim` | `res_array` | Downward-only trim ladder taps (both legs) | 20 fine 0.5um units PER LEG x 2 legs = 40 unit taps, the fine part of the same 255 um leg -- code 0 puts all 20 in circuit and code -k skips k of them, so the ladder spans 0..-20 of which DR-002 certifies 0..-16 (design/bandgap_core.sch CORE_PARAMS, DR-002); drawn 1:1 |
| `res_r1` | `res_array` | R1 (dVBE-to-current leg) | n_r1=7 unit segments (design/bandgap_core.sch); drawn 1:1 |
| `pnp_ptat` | `bjt_array` | Q2 (PTAT PNP, large unit W3p40L3p40) | m=8 sky130_fd_pr__pnp_05v5_W3p40L3p40 (design/bandgap_core.sch); drawn 1:1 (8 real units, 2x4 common-centroid) |
| `core_mirror` | `diff_pair` | MPOUT/MPAMP (core PMOS output/bias mirror) | m_out=m_ampbias=2, W=8 L=2 (design/bandgap_core.sch); drawn 1:1 |
| `amp_input_pair` | `diff_pair` | MP1/MP2 (amp PMOS input pair) | amp_m_in=8, W=20 L=10 (design/error_amp.sch); drawn 1:1 -- the dominant mismatch contributor per layout/matching-plan.md Section 1 |
| `amp_nload` | `diff_pair` | MN1/MN2 (amp NMOS diode loads) | amp_m_nmirr=4, W=8 L=20 (design/error_amp.sch); drawn 1:1 |
| `amp_pmirr` | `diff_pair` | MP3/MP4 (amp PMOS mirror) | amp_m_pmirr=8, W=6 L=20 (design/error_amp.sch); drawn 1:1 |
| `amp_nmirr` | `diff_pair` | MN3/MN4 (amp NMOS mirror outputs) | amp_m_nmirr=4, W=8 L=20 (design/error_amp.sch); drawn 1:1 |
| `su_clamp` | `mos_array` | MNC (railed-branch clamp NMOS, issue #52) | m_clamp=1, W=4 L=1 (design/startup_injector.sch); drawn 1:1 as a single unit device -- it pairs with nothing else in the cell |
| `su_sense` | `mos_array` | MNS (VBE-referenced sense NMOS) | m_sense=1, W=48 L=0.5 (design/startup_injector.sch); drawn 1:1 as a single unit device, gate on the core's own VOUT (the schematic's VSENSE input) |
| `pnp_su` | `bjt_array` | QS (startup threshold PNP, small unit W0p68L0p68) | m_pnp=8 sky130_fd_pr__pnp_05v5_W0p68L0p68 (design/startup_injector.sch); drawn 1:1 (8 real units, 2x4 common-centroid) -- the identical unit device and count as `pnp_ctat`, so it is drawn with identical params |
| `su_ref` | `diff_pair` | MPC1/MPC2 (two-high diode-connected PMOS reference, fed from GDRV) | m_ref=1, W=1 L=20 each (design/startup_injector.sch); drawn 1:1 -- the injector's only matched pair, and the only one of its six devices a `diff_pair` can express. NC1, the node between the two diodes, is entirely internal to this block and is drawn by its own intra-block comb |
| `su_inj` | `mos_array` | MNI (degenerate-state eviction NMOS) | m_inj=1, W=10 L=0.5 (design/startup_injector.sch); drawn 1:1 as a single unit device |
| `amp_cc` | `diff_pair` | MCC (amp Miller compensation cap, PMOS-as-capacitor) | amp_m_cc=16, W=30 L=20 (design/error_amp.sch); drawn as two mult=8 groups (`MCC_A`/`MCC_B`) tied identically to VDD (drain+source) and GDRV (gate) so `combine_devices` folds them into the schematic's single m=16 device -- see MCC_MIM_INFEASIBLE_NOTE for why a `cap_mim` overlay (the operator's primary-path ruling on issue #62) cannot close this device instead |

Note: MCC (amp compensation cap, amp_m_cc=16 x W=30 x L=20 = 9600 um^2 analytic) is now drawn, as of issue #62's thirtieth increment -- see the `amp_cc` block above and MCC_MIM_INFEASIBLE_NOTE for why it is a MOS-as-capacitor block rather than a cap_mim overlay. Drawing it pushes the composed cell over the ratified 50,000 um^2 (DR-005) Area budget; see spec/decision-records/DR-007-mcc-area-budget.md (proposed, not ratified) and this record's own `within_budget` gate result

## Intra-block busses drawn on met1

Each matched group's units are tied into the node the schematic says they form, on met1 over mcon -- the sky130 extraction deck's own second conductor and via (`metals = (li1, met1, met2)`, `vias = (mcon, via)` since klayout-tools#511; met2 is reserved for the inter-block escape plane above and no intra-block bus uses it). This flow draws them itself from each block's reported `ports[]` (MET1_BUS_NOTE). That is what turns a 100-segment coarse ladder (and its 40-segment fine trim ladder) into two real series resistors, an 8-unit PNP array into one real m=8 device, and -- new in this increment -- each split MOS group's 4 to 32 fingers into the single m=N transistor the schematic names.

| block | bus | detail |
| --- | --- | --- |
| `pnp_ctat` | parallel unit bus | `VA` = 8 pads on 4 columns; `VSS` = 8 pads on 4 columns |
| `res_r2` | 2 interdigitated series string(s) | 96 unit-to-unit met1 links |
| `res_trim` | 2 interdigitated series string(s) | 38 unit-to-unit met1 links |
| `res_r1` | 1 interdigitated series string(s) | 6 unit-to-unit met1 links |
| `pnp_ptat` | parallel unit bus | `VBQ` = 8 pads on 4 columns; `VSS` = 8 pads on 4 columns |
| `core_mirror` | split-device finger bus | `VDD` = 4 finger pads joined on the W spine; `GDRV` = 4 finger pads (4 gate contacts) joined on the W spine; `TAIL` = 2 finger pads joined on the W spine; `VOUT` = 2 finger pads joined on the W spine |
| `amp_input_pair` | split-device finger bus | `D1` = 8 finger pads joined on the W spine; `D2` = 8 finger pads joined on the W spine; `VB` = 8 finger pads (8 gate contacts) joined on the W spine; `VA` = 8 finger pads (8 gate contacts) joined on the W spine; `TAIL` = 16 finger pads joined on the W spine |
| `amp_nload` | split-device finger bus | `D1` = 8 finger pads (4 gate contacts) joined on the E spine; `D2` = 8 finger pads (4 gate contacts) joined on the E spine; `VSS` = 8 finger pads joined on the E spine |
| `amp_pmirr` | split-device finger bus | `GDRV` = 8 finger pads joined on the W spine; `PN` = 24 finger pads (16 gate contacts) joined on the W spine; `VDD` = 16 finger pads joined on the W spine |
| `amp_nmirr` | split-device finger bus | `GDRV` = 4 finger pads joined on the E spine; `PN` = 4 finger pads joined on the E spine; `D1` = 4 finger pads (4 gate contacts) joined on the E spine; `D2` = 4 finger pads (4 gate contacts) joined on the E spine; `VSS` = 8 finger pads joined on the E spine |
| `pnp_su` | parallel unit bus | `NE` = 8 pads on 4 columns; `VSS` = 8 pads on 4 columns |
| `su_ref` | split-device finger bus | `NC1` = 3 finger pads (1 gate contacts) joined on the W spine; `NG` = 2 finger pads (1 gate contacts) joined on the W spine; `GDRV` = 1 finger pads joined on the W spine |
| `amp_cc` | split-device finger bus | `VDD` = 32 finger pads joined on the W spine; `GDRV` = 16 finger pads (16 gate contacts) joined on the W spine |

Drawn-short / spacing proof: every met1 rectangle carries the electrical node it belongs to, and **0** pairs of rectangles belonging to *different* nodes come within the deck's 0.14 um `met1.space.1` clearance. The flow fails on any nonzero count -- a drawn short the DRC deck happens not to model would otherwise read as connectivity.

Split-node proof (the inverse check): every node's own met1 is counted into connected components, and **0** of the nodes this router reports as fully routed are drawn in more than one piece. The flow fails on any nonzero count. A node drawn as two islands that never touch is not a connected node, and unlike a drawn short *nothing downstream reports it*: DRC sees two legal wires, `klt extract` sees two anonymous nets with nothing in `warnings[]`, and the coverage table below scores this flow's own hop bookkeeping rather than the geometry, so it would still call the node drawn. Nodes that came up a hop short are excluded on purpose -- they are *supposed* to be in more than one piece, and the coverage table already says so. Their piece counts, and every other node's, are in `bus-summary.json`'s `_components` (every node is a single piece).

Label-collision proof: **0** extracted net(s) carry more than one label. This is the pad-side counterpart of the check above and is gated the same way. A `pins[]` entry labels a *port*, i.e. a pad, so a label placed on a pad another node's metal already contacts does not name its own node -- it renames that node, and `klt extract` emits the result as a single net called `A|B` with nothing in `warnings[]` and DRC still clean. The previous increment's composed layout shipped exactly that: `VOUT`'s label sat on `core_mirror.M2_1_D`, which is MPAMP's drain and the pad the drawn `TAIL` net contacts, so its extracted netlist contained a net named `TAIL|VOUT` -- the layout asserting that the reference output and the amp tail are one node. The pin selector and the router now share one claimed-pad set, and this line is the proof. Filed upstream as 2AMLogic/klayout-tools#470 (the silence, not the collision, is the tool gap).
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
