2AMLogic/sky130-bandgap/layout/trivial-cell/reports/20260806-055840-3a4293a/record.md

# Layout DRC/LVS record: 20260806-055840-3a4293a

Trivial-cell proof of the `klt`-driven DRC/LVS flow (issue #14) -- **not** bandgap-core layout, which is a later issue's scope.

## Overall verdict: PASS

- [x] DRC on trivial_mos_array is clean
- [x] LVS matches the known-good reference
- [x] LVS negative control (device-parameter corruption) reports mismatch
- [x] LVS negative control (topology corruption) reports mismatch

## Flow

1. `klt gen mos_array --pdk sky130A --cell-name trivial_mos_array` -- default params (2x2 array, 1 dummy column/side, nfet, no well).
2. `klt drc trivial_mos_array.gds --deck sky130`
3. `klt extract trivial_mos_array.gds --deck sky130 --top trivial_mos_array`
4. `klt lvs` against `reference.spice` (known-good) and two negative-control references (`reference.broken-device.spice`, `reference.broken-topology.spice`).

## Cell

- Generator: `mos_array` (`klt gen --list` for the full params schema)
- `device_count` (real, non-dummy): 4
- bbox (um): {'x0': -1.52, 'y0': 0.0, 'x1': 4.16, 'y1': 2.08}
- `matched_group_id`: mos_array:2x2:common_centroid
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
