2AMLogic/sky130-bandgap/layout/bandgap-core/reports/20260803-232955-05e1b99/renders/67_5.png

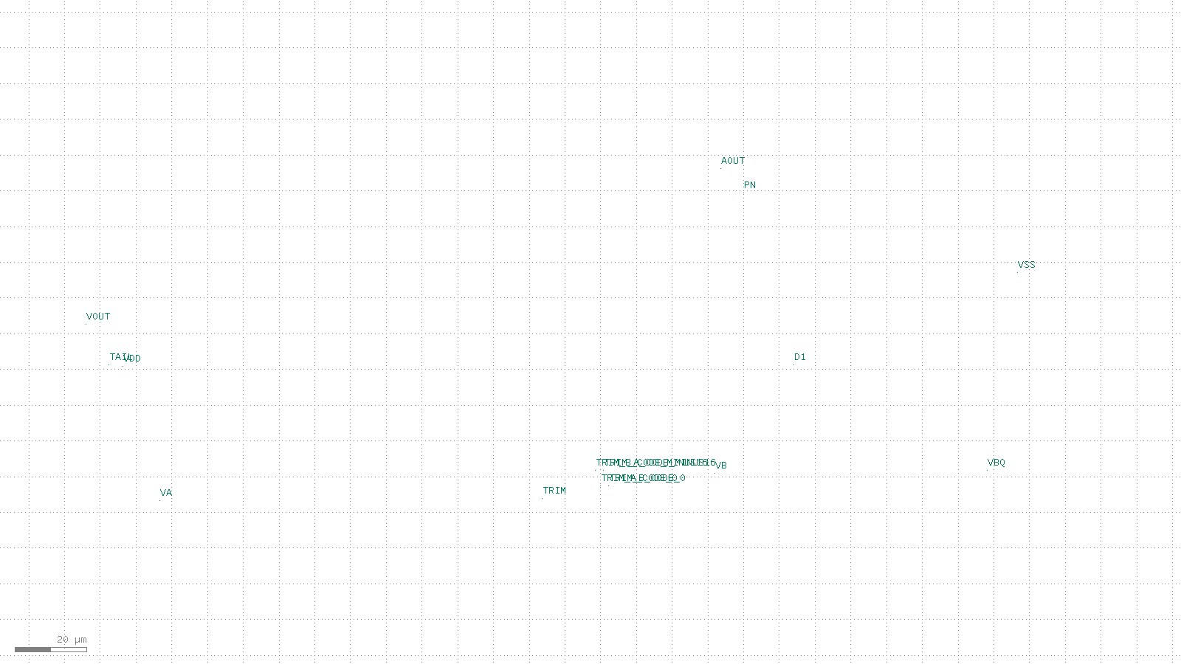
layout/bandgap-core/reports/20260803-232955-05e1b99/renders/67_5.png
