2AMLogic/sky130-bandgap/layout/bandgap-core/reports/20260923-070209-dbd57a9/renders/65_44.png

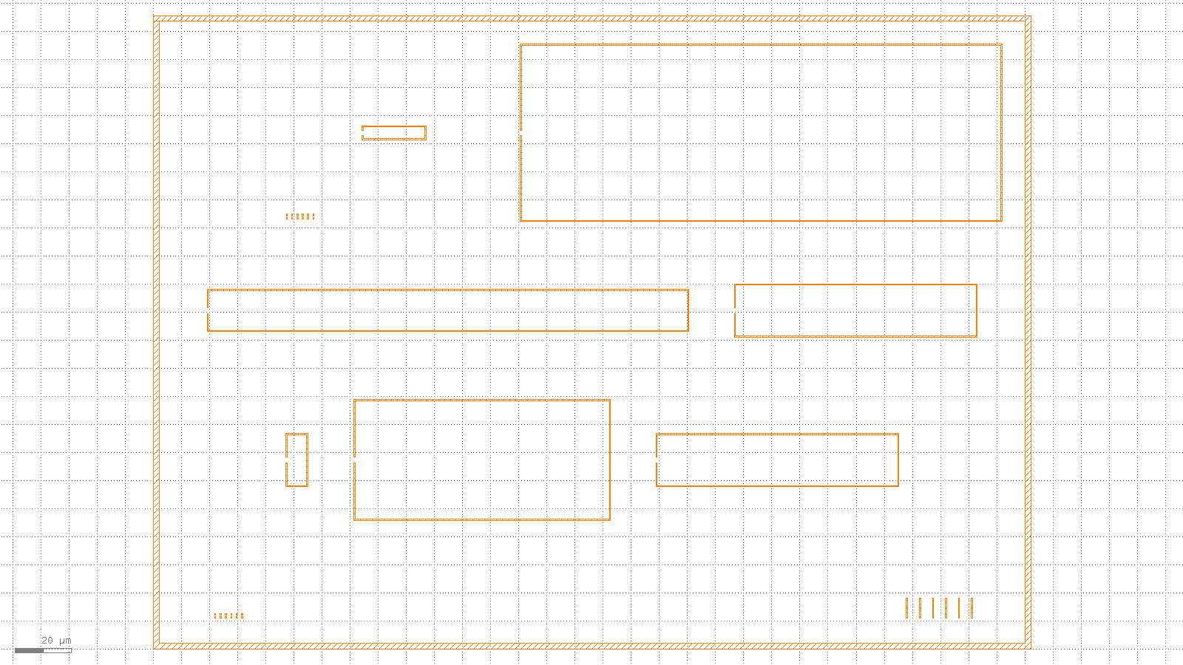
layout/bandgap-core/reports/20260923-070209-dbd57a9/renders/65_44.png
