2AMLogic/sky130-bandgap/layout/bandgap-core/reports/20260923-070209-dbd57a9/renders/66_13.png

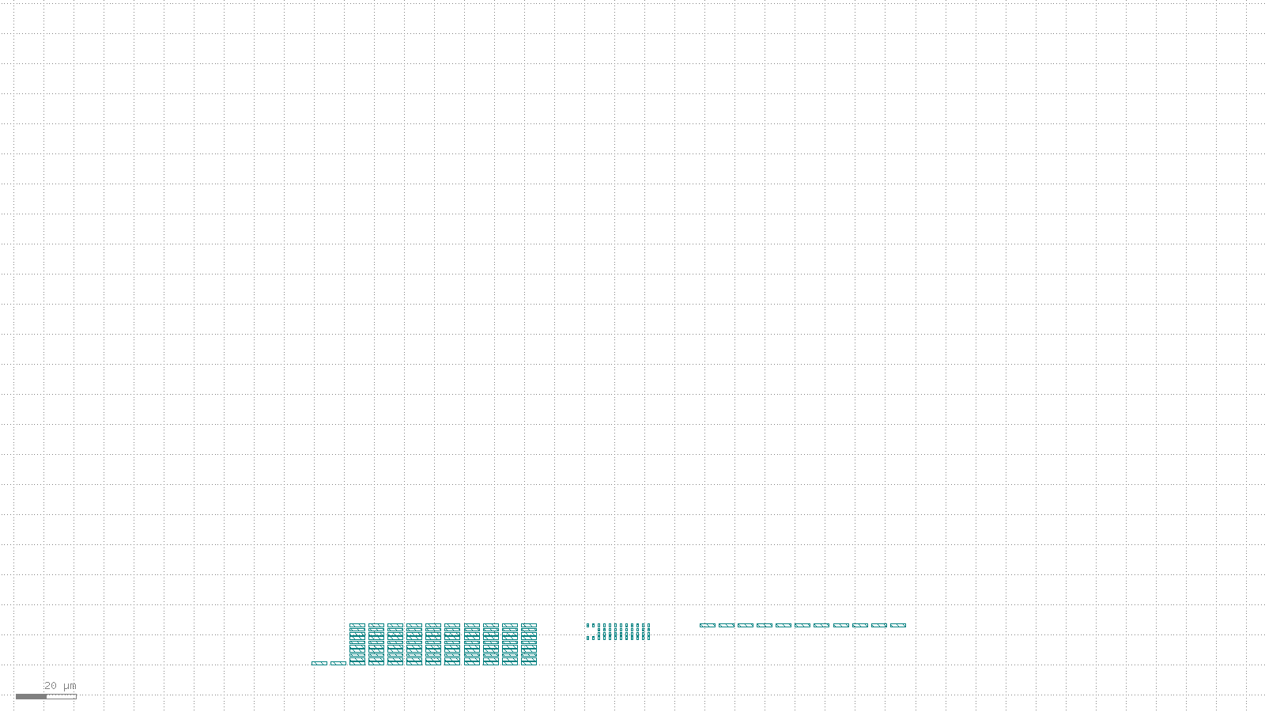
layout/bandgap-core/reports/20260923-070209-dbd57a9/renders/66_13.png
