2AMLogic/sky130-bandgap/layout/bandgap-core/combine-determinism/20260923-062919-1e38c62/record.installed-0.5.0-g2f64ab8.md

# `klt lvs` combine-determinism measurement

- Record ID: `20260923-062919-1e38c62`
- Source layout record: `layout/bandgap-core/reports/20260817-020222-13476b7`
- Request measured: `layout/bandgap-core/reports/20260817-020222-13476b7/lvs.combined.request.json` (committed, unmodified)
- Trials per variant: 1000
- `klt` build measured: `0.5.0+g2f64ab88bfcc` (`git_commit` `2f64ab88bfccbdeb9e9b5e46325977fe82a6e17f`, `is_release` `False`), klayout `0.30.10`
- `klayout_tools` imported from: `(outside this repo -- pinned by lvs_module_sha256 below)`
- `klayout_tools/lvs.py` `sha256`: `sha256:4e89c659a40632a867348f220bf5087cc2731d0799e0aacad75ffb512d2cb9f2` (declared as `git 2f64ab88bfccbdeb9e9b5e46325977fe82a6e17f (editable checkout on PATH)`)
- `layout/requirements.txt` pin: `klayout-tools @ git+https://github.com/2AMLogic/klayout-tools@acb0ae6c11e667eb93ee7de272d64298517f7fab`
- Repo state: `1e38c626225f7e338f72f4ceac10945cb1ad4308`
- Host python: `3.12.3`

Generated by `layout/bin/measure_combine_devices_determinism.py`. Re-runs
the source record's own committed `klt lvs` request document N times and
tallies the verdict, under two `options.combine_devices_max_attempts`
settings. Nothing here feeds the routed flow's gate.

| variant | `combine_devices_max_attempts` | deterministic | verdict tally |
| --- | --- | --- | --- |
| `as_committed` | build default | **NO** | 762x `0`, 238x `12` |
| `max_attempts_1` | 1 | **yes** | 1000x `0` |

`verdict tally` counts trials by the `mismatch_count` they reported.

## Where the findings land

Summed over all trials, keyed `<category>/<device class>/<reference device>/<parameter>`. A flake confined to one device class, with every other class matched on every trial, is a mis-combine rather than a newly-detected layout defect.

| variant | finding | total across trials |
| --- | --- | --- |
| `as_committed` | `device.property/PNP/Q1/ab` | 238 |
| `as_committed` | `device.property/PNP/Q1/ac` | 238 |
| `as_committed` | `device.property/PNP/Q1/ae` | 238 |
| `as_committed` | `device.property/PNP/Q1/ne` | 238 |
| `as_committed` | `device.property/PNP/Q1/pb` | 238 |
| `as_committed` | `device.property/PNP/Q1/pc` | 238 |
| `as_committed` | `device.property/PNP/Q2/ab` | 238 |
| `as_committed` | `device.property/PNP/Q2/ac` | 238 |
| `as_committed` | `device.property/PNP/Q2/ae` | 238 |
| `as_committed` | `device.property/PNP/Q2/ne` | 238 |
| `as_committed` | `device.property/PNP/Q2/pb` | 238 |
| `as_committed` | `device.property/PNP/Q2/pc` | 238 |

## Conclusion recorded by this run

The committed request is **not deterministic** on this build: across 1000 repetitions of the *same* request document against the *same* committed netlists it reported `mismatch_count` = 0 on 762 trials, `mismatch_count` = 12 on 238 trials (76.2% clean). Nothing about the inputs changed between trials.

A verdict that is only sometimes `match` cannot be cited as signoff evidence in either direction: the clean runs do not establish that the layout matches, and the dirty runs do not establish that it does not.

Setting `options.combine_devices_max_attempts: 1` restores determinism: 1000/1000 trials reported `mismatch_count` = 0. A budget of 1 makes the only combine attempt the *last* one, which klayout-tools#1185's `_combine_devices_safely` runs directly against the netlist instead of against a `Netlist.dup()` copy adopted back via `Netlist.assign()`. The variable is therefore that round trip, not the netlists, the request, or the comparer.

See `layout/matching-plan.md` Section 7ff for the disposition this
measurement supports, and `signoff/README.md`'s item-4 row for what it
means for the T1 checklist.
