2AMLogic/sky130-bandgap/design/block-characterization-report.md

# Block-level characterization report — `bandgap-core` (sky130)

**T1/bronze checklist item 8 artifact** (the gap #39 flagged 2026-08-04 and #175's
2026-08-15 re-read confirmed still open). This is the single, current, block-level
roll-up of items 3–7's evidence — one row per **ratified** spec parameter
([DR-005](../spec/decision-records/DR-005-ratify-target-spec.md), amended by
[DR-006](../spec/decision-records/DR-006-psrr-frequency-qualification.md),
[DR-007](../spec/decision-records/DR-007-mcc-area-budget.md),
[DR-008](../spec/decision-records/DR-008-psrr-post-layout-margin-proposal.md)) —
with target, measured value, binding corner, verdict, and the evidence record each
verdict rests on.

**Coverage-honesty rule (this repo's own, restated so it travels with the claim
below): a FAIL is reported as FAIL, with its number, not omitted or rounded toward
the target.** One row (box-method temp coefficient, schematic and post-layout) fails
at every corner on the freshest evidence — the TC-floor disposition is an open
operator question tracked in #179, out of this report's scope to resolve. The
post-layout output-accuracy row also fails at almost every corner; re-investigated by
issue #283, it is neither a resolved "fixed-upstream" tool artifact (the prior
citation, klayout-tools#800, was closed **not planned**, not fixed) nor
confirmed to be a design defect — a re-run against a `klt` build five weeks past
#800's closure reproduces the same parasitics bit-for-bit and matches a different,
still-**open** upstream defect (klayout-tools#2359) digit-for-digit. **Row 4b (PSRR,
post-layout) now fails 25 of 45 corners** — a verdict flip, and the single most
important number in this revision: it is the measured cost of drawing the startup
injector into the composed cell (#285), and it is tracked as a real, open spec
violation in **#300**, not re-graded away here. **Its cause is now measured, not
inferred**: new row 4d attaches the injector at *schematic* level, where no
extraction step exists, and reproduces the same collapse at the same binding
corner (24.78 dB vs. 22.75 dB, FAIL 24/45) — so row 4b is a design property of
the injector, not a `klt extract --parasitics` artifact. **And the dominant device
inside the injector is now measured too** (new row 4e, #306): cutting the
`MPC1`/`MPC2` diode-connected PMOS reference stack recovers the bench to PASS 45/45
(worst 65.64 dB), while cutting the `MNC` clamp changes nothing (≤0.25 dB at every
corner) — so the `MPC1`/`MPC2` attribution is no longer a corner-signature
inference. **The fix itself has not landed**: three resize candidates were tried
and rejected
([DR-011](../spec/decision-records/DR-011-startup-injector-psrr-fix-infeasible-by-resize.md)),
so row 4b and row 4d stay FAILing and the remaining fix-plus-layout cycle is
tracked in **#315**. The startup-ramp rows (schematic and
post-layout) partially fail at the fastest process corners. Trim now has
current-design evidence and passes DR-002's engineering checks (issue #327), but
**fails** the literal DR-005 Trim row on range and ≥5-bit code coverage
(resolution passes; issue #333, row 2). Everything else — output
accuracy (schematic), Iq, supply operability, line regulation, area, and startup
self-starting — passes (schematic accuracy). The mismatch Monte Carlo passes only its
≥50 % harness sanity floor; the literal DR-005 3σ accuracy qualification **FAILS** and is
incomplete on N and joint coverage (issue #334, row 1c). **The startup-time row 8e's post-layout half flips the other
way, FAIL 45/45 → PASS 45/45**, for the same reason: the composed cell that used to
ship no injector now draws one. All of that is stated plainly below, not summarized
away.

## 0. Freshness / regeneration rule

- **Generated against**: commit `e8e2e46` (2026-09-09), the tip of `main` at the time
  this report was written (regenerated by issue #279, re-running the PSRR / Iq /
  startup benches — the five ratified rows issue #178/#193 left on superseded
  evidence — and re-deriving every other row from the newest record on disk).
  **Read every citation's own commit/record-id, not this header** — this report is a
  snapshot; a record it cites is authoritative for its own claim only as of that
  record's own `Repo state` field.
- **Freshest layout report cited throughout**: `layout/bandgap-core/reports/20260923-070209-dbd57a9/`
  (routed, DRC-clean, met2-DRC-clean, `klt lvs`-clean, `mismatch_count: 0`, **22/22
  devices matched — 16 core + the 6 startup-injector devices #285 drew in**,
  generated against the current chained-array `n_r2=51` design). It supersedes
  `20260817-020222-13476b7`, which is still on disk but is no longer cited by any row:
  rows 8b/8d, the last two holdouts, were restructured and re-run against the
  injector-inclusive record by issue #299. **Every post-layout row in this report now
  cites the same layout record.**
- **This artifact is stale, not wrong, the moment any of the following changes**:
  a new `sim/output-voltage-tc(-post-layout)/`, `sim/monte-carlo-untrimmed/`,
  `sim/psrr-dc(-post-layout)/`, `sim/psrr-dc-with-injector/` (row 4d),
  `sim/psrr-injector-attribution/` (row 4e), `sim/quiescent-current(-post-layout)/`,
  `sim/startup-*/` record is appended, a new `layout/bandgap-core/reports/<stamp>/`
  lands, or a spec/DR is ratified/amended. **Regeneration rule**: re-derive every row
  below from the *newest* record under each cited `sim/*/records/` and
  `layout/bandgap-core/reports/` directory (not the ones named here) before relying on
  this report; `sim/README.md`'s "Draft-graded vs. ratified-graded records" section is
  the authoritative way to tell which record is graded against which spec vintage —
  read the record's own `**Claim**` line, never infer from its date or this report's.
  Whoever regenerates this report should append a **new** file revision noting the
  commit/report-dir it was generated against (this file is a normal committed doc, not
  an append-only `sim/` record, but should still name its own freshness basis in its
  first commit and every subsequent one).
- **A pointer to this rule also lives in [`sim/README.md`](../sim/README.md)** (added by
  this same change) so a reader who starts there is routed here.
- **Revision, 2026-09-23 (issue #292) — tool-claim correction only, no row re-derived.**
  §1, §3 row 7, and §4 asserted three things about `klt` that had gone stale since this
  report was generated: that `klt signoff --manifest` "does not work in this
  environment" (klayout-tools#1050, closed upstream 2026-08-16) and that `klt pex` "is
  still not implemented upstream" (klayout-tools Epic #709, closed 2026-08-14). Both are
  corrected in place, with the superseded claim quoted rather than deleted. **No
  measured value, verdict, binding corner, or citation in §2/§3 was touched** — the
  "Generated against `e8e2e46`" basis above still describes every row, and this revision
  is not a regeneration. It does change this file's bytes, which is deliberate: T1 item
  8 pins this report's `sha256`, so `./signoff/regenerate.sh` was re-run and
  `signoff/evidence/characterization.generic.json`, `signoff/block-manifest.json`, and
  `signoff/signoff-report.json` were re-committed with it.
- **Revision, 2026-09-23 (issue #285) — the composed cell now contains the startup
  injector, and six rows are re-derived against it.** `design/startup_injector.sch`
  had no layout, so every post-layout row in this report was a measurement of a
  circuit the schematic rows do not describe. It is now drawn into the composed cell
  (`layout/bandgap-core/reports/20260923-070209-dbd57a9/`, DRC-clean, LVS-clean at
  22/22 devices) and `layout/bandgap-core/reference.spice` carries its six devices
  too, so both sides of LVS stop sharing the omission. Rows **1b, 3b, 4b, 4c, 5c, 6b,
  7 and 8e** are re-derived from post-layout records appended the same day against
  that layout record; rows **8b and 8d** are deliberately **not** re-run (see their
  own rows and #299). Two verdict flips, both real and both disclosed: 8e's
  post-layout half FAIL 45/45 → **PASS 45/45**, and 4b PASS 45/45 → **FAIL 25/45**
  (tracked as #300). §3 items 3/4/5/7 are re-derived to match.
- **Revision, 2026-09-23 (issue #300) — row 4b's cause determined by a new
  schematic-level experiment; one row added, no existing row re-measured.** #285 changed
  two things at once in row 4b's record (the injector was added to the cell, *and* the
  injector was extracted), so that record alone could not say whether the PSRR collapse
  is a property of the design or of `klt extract --parasitics` (klayout-tools#2359, the
  defect already implicated on rows 1b/6b). A new schematic-level bench,
  `sim/psrr-dc-with-injector/`, attaches `design/startup_injector.sym` to
  `design/bandgap_core.sym` with **no extraction step in the loop** and reuses
  `sim/psrr-dc/experiment.json`'s 45-corner matrix, measurements and DR-006 floor
  unchanged. It reproduces the collapse: **FAIL 24/45, `psrr_band_min` 24.78 dB at the
  same binding corner** `ff / 125 °C / 3.63 V`, median per-corner agreement with row 4b
  of 0.21 dB, exactly one corner differing in verdict. **Row 4d is new** (the bench and
  its record); rows **4b and 4c** gain that disposition and the new citation; **no
  measured value, verdict or binding corner on any pre-existing row changed** — row 4b is
  still FAIL 25/45 on the same record, now with its cause attributed. §3 items 5/7 and §5
  are updated to match. The remaining `MPC1`/`MPC2`-side circuit fix is deliberately not
  in this revision (see row 4d's own note and #300's scope); it is filed as **#306**.
- **Revision, 2026-09-24 (issue #299) — rows 8b and 8d re-derived against the
  injector-inclusive layout; the last superseded-layout citations in this report are
  retired.** #285's revision entry above left these two rows deliberately un-re-run,
  because their DUT was the extracted core wired to a *separately netlisted* schematic
  injector plus bare-core control instances — a construction that, against a cell which
  now draws its own injector, would have put two injectors on every DUT instance and
  silently made the controls injector-equipped, with nothing in the output saying so.
  **The decided DUT shape is the composed cell alone, with no schematic-level control.**
  Each bench now carries its own testbench (`tb_startup_stability_pl.sch`,
  `tb_startup_ramp_pl.sch` — `design/bandgap_core.sym` instances only, no
  `design/startup_injector.sym` anywhere) and its own `experiment.json`, which drops the
  control-dependent measurements **with a stated reason and a pointer to where the claim
  still lives** rather than silently. What is dropped: `imin_off_bare`, `i_off_bare`,
  `ncross_bare`, `dvref`, `i_standing`, `i_su_standing` (8b) and `vref_n`, `gn_n` (8d).
  Where those claims live instead: rows **8a/8c** (bare-core statements, schematic level,
  where the control is a real instance) and row **8e** (`gdrv_final`, the post-layout
  counterpart of `gn_n`, on this same composed cell). The injector-attach *cost* —
  `dvref`/`i_standing` — is **not representable** against a monolithic drawn cell and is
  no longer claimed post-layout; that is a real, disclosed reduction in this report's
  coverage, not a re-derivation. Rows **8b and 8d** are re-derived; §0's freshest-layout
  bullet, §2's "Reading the Startup row as one ratified claim" subsection and §3 item 7
  are updated to match. **No verdict changed in kind**: 8b stays PASS (8/8), 8d stays
  MIXED with its ratified `< 1 ms` half PASS 45/45; 8d's DR-010 consistency-check count
  moves 16/45 → **13/45**, which is now identical to row 8c's schematic-level count
  (12 of the 13 corners are the same corners). No other row was touched.
- **Revision, 2026-10-02 (issue #306) — the PSRR violation is now localized to a
  device by measurement; no verdict moves, and no fix lands.** #300's revision above
  closed the design-vs-extraction question but explicitly left open *which* of the
  injector's six devices dominates — row 4d attaches the whole cell at once, so the
  `MPC1`/`MPC2` attribution was a corner-signature inference. A new bench,
  `sim/psrr-injector-attribution/`, closes that: it runs the full 45-corner matrix on
  **five bodies that differ by exactly one GDRV-touching device branch each** (225
  ngspice points), cutting the netlist snapshot row 4d's own record measured rather
  than re-netlisting `design/`, so every number is corner-for-corner comparable to
  rows 4a/4d. Result (**new row 4e**): cutting `MPC1`/`MPC2` recovers **PASS 45/45**
  (worst 65.64 dB, vs. the bare core's 67.34 dB), cutting `MNI` recovers only to
  **43/45** (worst 48.48 dB), and cutting `MNC` recovers **nothing** (FAIL 24/45,
  ≤0.25 dB from `base` at every corner — the #52 railed-branch clamp is exonerated).
  **Reported honestly, the record's own verdict is `Overall: FAIL`** — 425 of its 429
  attribution assertions hold, and the 4 that do not are the limit of the claim: at
  `sf, 125 °C, 3.30/3.63 V` cutting the stack leaves **2.03/3.07 dB** unrecovered
  against the bare-core control, and at `ff, 125 °C, 3.30 V` / `sf, 125 °C, 3.63 V`
  cutting `MNI` instead recovers marginally *more* than cutting the stack (by 0.69 dB
  and 0.10 dB). So the stack is the **dominant** contributor, not the only one, and
  `MNI`'s own GDRV conductance is a measured hot-corner residual. **No fix lands in
  this revision, and not for lack of trying**: three device-resize candidates (a
  3-high `MPC1`/`MPC2`/`MPC3` stack, resizing `MNI`, and re-verifying the 3-high
  stack) were each investigated and rejected — see
  [DR-011](../spec/decision-records/DR-011-startup-injector-psrr-fix-infeasible-by-resize.md),
  which records why, including that the 3-high candidate's `sim/startup-stability`
  re-run was *inconclusive* (per-corner `gmin` homotopy stepping past the harness
  timeout), not failed. **Row 4e is new**; rows **4b and 4d** gain the measured
  attribution and the new citation; **no measured value, verdict or binding corner on
  any pre-existing row changed** — row 4b is still FAIL 25/45 and row 4d still FAIL
  24/45, on the same records. §3 item 5, §4's localization bullet and §5 are updated
  to match. The remaining circuit fix plus its whole layout/DRC/LVS/post-layout
  re-sim cycle is tracked in **#315**; #306 stays open until its own criteria can be
  checked against that work. This revision changes this file's bytes, so — as with the
  #292 revision above — `./signoff/regenerate.sh` was re-run and
  `signoff/evidence/characterization.generic.json`, `signoff/block-manifest.json` and
  `signoff/signoff-report.json` were re-committed with it.
- **Revision, 2026-10-02 (issue #315) — DR-011's three-high-stack candidate is
  dead on *startup margin*, not on convergence; a non-resize `NG` clamp is the
  surviving half; no verdict moves.** The #306 revision above left two things
  open: whether that candidate survives its own `sim/startup-stability`
  regression, and what a *non-resize* fix for `MNI`'s residual GDRV conductance
  would look like. Both are answered, in
  [DR-012](../spec/decision-records/DR-012-startup-injector-psrr-ng-clamp-and-stack-height-margin.md),
  and neither answer moves a verdict. (i) A second bench,
  `sim/psrr-injector-candidates/`, is the **ADD-side counterpart** of row 4e's
  cut-side attribution: it adds candidate devices to the same committed snapshot
  row 4d's FAIL was measured on, and runs the same 45-corner matrix (**new row
  4f**). It records the three-high stack alone at **27/45** (worst 30.35 dB,
  reproducing DR-011's hand-run FAIL 18/45) and the two-device candidate
  `+MPC3` + `+MNG` at **45/45** (worst 65.64 dB). (ii) **That 45/45 is still not
  a fix**: a targeted 11-point probe of `sim/startup-stability`'s own
  degenerate-region window — the only quantity needed, at 340 s per body instead
  of 6.4 ks, validated against the committed record to within 1.5 % on the stock
  design — measures `+MPC3` taking the matrix's tightest `itrav_min` corner
  (`ss, 125 °C, 2.97 V`) from **6.87 nA (6.9× the 1 nA floor) to 0.65 nA, below
  it**, while `+MNG` alone costs 3 %. So the device that buys the hot corners is
  the device that breaks the startup floor, and DR-011's candidate 1 is dead for
  a *measured margin* reason rather than an inconclusive run. (iii) The
  certifying 45-corner regression is also unaffordable here, priced rather than
  asserted: that bench's 251-point DC sweep costs **≈ 114 s + ≈ 25 s per sweep
  point ≈ 1.8 h per corner** on an x86_64 Linux sweep host (≈ 17–33 h for the
  matrix), against 285.8 s for the identical deck and corner on the Darwin host
  that minted its 45/45 record — and ≈ 10× faster again under `ngspice-47`, per
  that bench's own record chain; filed as **#320**.
  **Row 4f is new**; **no measured value, verdict, binding corner or
  citation on any pre-existing row changed** — rows 4b/4d keep their FAIL
  verdicts and their records, because `design/startup_injector.sch` is
  unchanged. §4's PSRR bullet is updated to match. This revision changes this
  file's bytes, so `./signoff/regenerate.sh` was re-run and
  `signoff/evidence/characterization.generic.json`, `signoff/block-manifest.json`
  and `signoff/signoff-report.json` were re-committed with it.

## 1. What `klt signoff` already produces, and what it does not

Per this issue's own instruction, this was evaluated **before** hand-rolling the table
below.

- **Envelope-aggregation mode (`klt signoff <files...>`) works and is used**: running it
  against the freshest layout report's own four `klt`-envelope JSON files —

  ```
  klt signoff layout/bandgap-core/reports/20260817-020222-13476b7/{drc,met2-drc,lvs.combined,extract}.json
  ```

  returns `status: "pass"`, `check_count: 4`, `passed_count: 4`, `failed_count: 0`,
  `provenance_consistency.ok: true` — a machine-checked, cross-validated (same
  input-layout `content_hash` on every check) confirmation of DRC, the met2 DRC
  supplement, LVS (11/11 nets, 16/16 devices matched, `mismatch_count: 0`), and
  extraction agreeing on one input. That result backs item 3/4's rows in Section 2
  directly, instead of this report re-deriving pass/fail by hand. Re-run directly for
  this regeneration (issue #279), not merely re-cited.
- **Tier-verdict mode (`klt signoff --manifest`) works, and is now this block's T1
  verdict of record** (corrected 2026-09-23, issue #292 — see the revision note in §0).
  `signoff/block-manifest.json` + the committed, mechanically re-graded
  `signoff/signoff-report.json` are the authoritative per-item T1 reading for this
  block; [`signoff/README.md`](../signoff/README.md) explains the verdict row by row and
  CI re-grades it on every push/PR. **This report is no longer the T1 checklist's
  reading**; it remains item 8's own evidence artifact (the aggregated per-spec-row
  roll-up in §2), cited from that manifest via
  `signoff/evidence/characterization.generic.json`.

  The earlier revision of this section recorded the opposite, correctly for its time:
  the then-pinned `klt` build (`0.2.0`, `uv tool install`) could not locate
  `docs/design-evidence-tiers.md`, because the doc-parsing modes computed that path
  relative to the installed package's own site-packages location, which resolves only
  for an in-place source checkout and not a packaged install — and there was no
  `--tiers-doc` override flag. That was a packaging gap in `klt` itself, generic to any
  consumer installing it the documented way, and was filed upstream per this repo's
  friction protocol as
  **[2AMLogic/klayout-tools#1050](https://github.com/2AMLogic/klayout-tools/issues/1050)** —
  **closed upstream 2026-08-16**. `--tiers-doc` is exactly how `signoff/regenerate.sh`
  now grades (against a vendored, pinned copy of the checklist doc).

  What has *not* changed: items 5–7 (PVT vs. ratified spec, Monte Carlo, post-layout)
  are still graded by hand below, and are still **uncited** in the manifest. This repo's
  `sim/*/records/*.json` use **this repo's own** corner-run/record schema
  (`record_id`/`matrix`/`corners`/…), not `klt`'s `schema_version`/`kind` envelope
  contract (`klt` has no `sim` verb of its own), so a working `--manifest` mode still
  needs a translation step for items 5–7 that items 3/4 do not — citing a near-miss
  envelope to turn those rows green is the documented anti-pattern, not a shortcut.

## 2. Per-ratified-spec-row scoreboard

Read against DR-005's eight rows (Output reference, Trim, Temp coefficient, PSRR,
Supply, Iq, Area, Startup), each amended where a later DR applies.

| # | Parameter | Target | Measured (binding corner) | Verdict | Evidence |
|---|---|---|---|---|---|
| 1a | Output reference — untrimmed, corner-matrix half (schematic) | 1.20 V ±2 % (1.176–1.224 V), −40…125 °C | `vref_27` 1.210068–1.212093 V; `vref_min` 1.186028–1.189076 V — inside the [1.176, 1.224] V window at **every** corner (this row's own `vref_min`/`vref_27`/`vref_max` measurements all pass; the bench's separate `tc_ppm` measurement is what fails, see row 3a — the two are graded independently within the same corner run) | **PASS 45/45** — a verdict flip from the pre-#193 evidence, which measured `vref_min` as low as 1.12969 V (below the floor at every corner) | `sim/output-voltage-tc/records/20260817-015751-13476b7.md` (post-#193 chained-array design; unchanged since — out of this issue's rerun scope, cited as the newest record on disk) |
| 1b | Output reference — untrimmed, corner-matrix half, post-layout (extracted) | same | `vref_27` 1.193300–1.199550 V (passes); `vref_min` 1.167045–1.186483 V — below the 1.176 V floor at 14 of 15 corners (`ff, 3.63 V` clears it at 1.186483 V). Re-measured for issue #285 against the injector-inclusive composed cell, which moved the numbers (the injector loads GDRV — see rows 4b/5c) without changing the disposition; the immediately preceding record, `20260923-061116-1e38c62` (#283, pre-injector), read 1.166584–1.169708 V and failed at every corner. **The prior "artifact FAIL" attribution was corrected by issue #283 and stands**: klayout-tools#800 was closed **not planned** (2026-08-12), not fixed — its own closing investigation showed the described body-double-count mechanism does not exist in the code, and a fresh `klt extract --parasitics` at the currently-installed `klt` 0.5.0 (git `6bf5610`, released 2026-09-15, 5+ weeks past #800's closure) reproduced the prior snapshot's parasitics bit-for-bit (`total_resistance_ohm` 226256.0625; internal chain-node signature 2×229.7271/229.7272=459.4543 Ω), so no `klt` version bump clears this row. The matching signature is instead traced to a different, still-**open** upstream defect, klayout-tools#2359 (a sibling investigation under issue #284): `klt extract --parasitics`'s single-rectangle squares-fit overstates a short/wide fragment's resistance (a resistor's own unmarked head + landing pad) — that issue's own generic repro reports 359.96 Ω on an internal chain node, matching this design's measured 359.9576 Ω to four significant figures. This is evidence *against*, not for, a real design defect, though it remains formally unconfirmed either way pending an upstream fix | **FAIL 14/15 (disclosed, open upstream defect klayout-tools#2359 — not a version-bumpable artifact, not confirmed as a design defect)** | `sim/output-voltage-tc-post-layout/records/20260923-074724-dbd4dda.md` (issue #285 re-run against the injector-inclusive cell; supersedes `20260923-061116-1e38c62`, which supersedes `20260817-020357-13476b7` and its "artifact, fixed upstream" citation) |
| 1c | Output reference — untrimmed, mismatch-MC half (3σ, N≥300, local mismatch, `tt_mm`) | The record's own per-point PASS/FAIL gate: ≥50 % of converged draws inside the ±2 % window — a **sanity floor**, per the record's own caveat, not itself the literal 3σ spec threshold | Yield (of converged draws) inside [1.176, 1.224] V: **79.41 %** (−40 °C) / **95.67 %** (27 °C) / **93.33 %** (125 °C), N=300 each, MC-off control and second-seed checks pass. Binding: **−40 °C** (79.41 %, still comfortably above the 50 % sanity floor) | Three separately graded verdicts (issue #334). **(i) Evidence existence: PRESENT.** **(ii) Harness sanity floor (≥50 % in window): PASS** — a verdict flip from the pre-#193 evidence, which measured 0.00 % yield at 125 °C; this is a sanity check, not conformance. **(iii) DR-005 spec (mean ± 3σ inside [1.176, 1.224] V): FAIL** — mean/sample σ/mean±3σ: −40 °C 1.21884 V / 6.771 mV / [1.19853, 1.23915] V; 27 °C 1.21117 V / 7.145 mV / [1.18974, 1.23261] V; 125 °C 1.18714 V / 7.347 mV / [1.16510, 1.20918] V — outside the window at every temperature; empirical yield 79.41 % [73.71, 84.36] / 95.67 % [92.70, 97.67] / 93.33 % [89.89, 95.88] (Clopper-Pearson 95 %). Requested N=300 at each temperature, but only **238** converged at −40 °C (below N≥300). Disclosed: a 3σ calculation is parametric, not an empirical confidence guarantee; `tt_mm` is local mismatch at the nominal process point only; joint process×mismatch coverage is **unavailable** and the process-corner extrema (row 1a) are deliberately not combined with the MC spread. A FAIL/incomplete verdict is a reporting outcome — circuit correction or broader MC is follow-up work, DR-005 is not relaxed | `sim/monte-carlo-untrimmed/records/20260817-121131-d7d85b6.md` (post-#193 chained-array design, closed by issue #180/PR #196; out of this issue's rerun scope, cited as the newest record on disk); derived qualification, recomputed from the same committed samples with no new simulation: `sim/monte-carlo-untrimmed/records/20260817-121131-d7d85b6-dr005-qualification.md` |
| 2 | Trim (1-point `res_high_po`, ≥±5 % range, ≤0.25 %/step) — two separately graded layers: **(i) DR-002 engineering checks**, **(ii) DR-005 ratified-spec qualification** | (i) monotonic-in-code, downward span ≥1.5×3σ MC spread, LSB ≤25 % of window half-width; (ii) range ≥±5 % of 1.20 V (60 mV each direction), adjacent-code step ≤0.25 % (3.0 mV), ≥5 bits equivalent (≥32 effective codes) | Re-derived at the current design (`n_r1=7`, `n_r2=51`, `r_lseg_trim=0.5` µm, explicit chained fine-trim topology, 5 process × 3 supply × 17 codes, −40…125 °C, Spot batch fleet). Monotonic 15/15; downward span 38.46–38.75 mV (needs ≥23.43 mV on DR-002's ratified 3σ and ≥33.06 mV on the current-design MC 3σ) 15/15; LSB 2.404–2.422 mV/code vs ≤3.000 15/15; collapse-free 15/15; schematic lumped model agrees with the explicit chain to 0.0000 mV. Schematic-level only (a post-layout extracted-chain trim check remains a possible follow-up). **DR-005 qualification (issue #333, derived from the same measurements, no new simulation):** range up **0.000 mV** (no upward code exists; DR-002 certifies downward only) vs 60 mV; range down **38.46–38.75 mV = 3.20–3.23 % of 1.20 V** vs 60 mV (5 %); largest adjacent step **2.43 mV = 0.2025 %** vs ≤0.25 %; effective coverage **17 monotonic codes = 4.09 bits** vs ≥5 bits (32 codes). 'Magnitude only' is undefined in DR-005; the range verdict is the same under either reading (even a one-sided trim must reach 5 % and reaches only 3.2 %), narrow operator question disclosed in the qualification record, range not waived | **(i) DR-002 engineering: PASS** (15/15 corners, unchanged). **(ii) DR-005 qualification: FAIL** — range up FAIL, range down FAIL, resolution PASS, ≥5-bit coverage FAIL | `sim/trim-lsb-chained/records/20261008-163545-ffa415c.md` (2026-10-08; supersedes the STALE `20260806-052035-dea0ca5.md`, left unchanged); DR-005 qualification: `sim/trim-lsb-chained/records/20261008-163545-ffa415c-dr005-qualification.md` (derived, append-only; pins the source record and its input hashes) |
| 3a | Temp coefficient (schematic) | < 50 ppm/°C (box method) | 142.44–158.97 ppm/°C at **every** corner. Binding: **fs** (158.97 ppm/°C, worst; best corner `sf` at 142.44 ppm/°C still fails) | **FAIL 45/45** | `sim/output-voltage-tc/records/20260817-015751-13476b7.md` (TC-floor disposition tracked in #179; out of this issue's rerun scope) |
| 3b | Temp coefficient, post-layout | same | 89.81–185.61 ppm/°C. Binding: **sf, 3.63 V** (185.61 ppm/°C, worst); the best corner (`ff, 3.63 V`, 89.81 ppm/°C) is the same one whose `vref_min` clears row 1b's floor, and is still 1.8× the 50 ppm/°C line | **FAIL 15/15** | `sim/output-voltage-tc-post-layout/records/20260923-074724-dbd4dda.md` (supersedes `20260817-020357-13476b7`) |
| 4a | PSRR (schematic) | > 60 dB DC–1 kHz (band-min, DR-006) | `psrr_band_min` 67.34–75.18 dB. Binding: **sf, −40 °C, 2.97 V** (67.34 dB, closest to the floor). **This row instantiates `design/bandgap_core.sym` ALONE** — no startup injector. That is not a defect in the row (it is the bare-core claim, and the core is what DR-006's PSRR line was written against), but it does mean this row does not describe the composed cell, which has contained the injector since #285: **see row 4d for the same bench with the injector attached** | **PASS 45/45** | `sim/psrr-dc/records/20260909-232410-e8e2e46.md` (re-run against the post-#193 design; supersedes `20260815-020301-001d1b7`) |
| 4b | PSRR, post-layout | same | `psrr_band_min` **22.75**–74.32 dB. Binding: **ff, 125 °C, 3.63 V** (22.75 dB — **37.25 dB below** the floor). **Verdict flip, and a real open spec violation (#300), not a re-grade**: the bench, its manifest and the harness are unchanged from the 45/45-PASS baseline (`20260909-232410-e8e2e46`, 66.30–75.54 dB); the only variable is that the composed cell now contains the startup injector (#285). Degradation is monotone in supply and fast-PMOS-selective (worst at `sf`/`ff` and 3.63 V, ~0 dB at `fs`/−40 °C), the signature of MPC1/MPC2's supply-dependent standing current out of the amplifier's high-impedance GDRV node. Independently corroborated by row 5c, which moved the same way at the same corners. **This is the first PSRR number this repo has ever measured with the injector attached at all** — row 4a instantiates `design/bandgap_core.sym` alone — so it is newly *measured*, not necessarily newly *introduced*. **Cause determined 2026-09-23 (#300): DESIGN, not extraction.** Row 4d re-measures the same claim with the injector attached at *schematic* level (no extraction step in the loop) and reproduces this collapse — same binding corner, 24.78 dB vs. 22.75 dB, median per-corner agreement 0.21 dB across all 45 points, exactly one corner differing in verdict. `klt extract --parasitics` (klayout-tools#2359) is therefore **exonerated as the dominant term here** (unlike rows 1b/6b) and accounts for at most ≈2 dB, concentrated at the 125 °C corners. **Device localized 2026-10-02 (#306): the `MPC1`/`MPC2` hypothesis in #300's body is now PROVEN by measurement, not just corroborated.** Row 4d attaches the whole injector cell at once, so it identified *the injector*, not which of its six devices dominates; new row 4e cuts one GDRV-touching device branch at a time on row 4d's own netlist snapshot and measures the recovery — cutting `MPC1`/`MPC2` restores PASS 45/45, cutting `MNC` restores nothing, cutting `MNI` restores only 43/45. **The verdict on this row does not move**: no fix has landed (DR-011 rejected three resize candidates), so row 4b is still FAIL 25/45 on the same record, now with both its cause *and* its dominant device attributed. Remaining fix + layout cycle tracked in **#315** | **FAIL 25/45** (was PASS 45/45) | `sim/psrr-dc-post-layout/records/20260923-073641-dbd4dda.md` (supersedes `20260909-232410-e8e2e46`); cause established by `sim/psrr-dc-with-injector/records/20260923-124813-af9ff1e.md` (row 4d); dominant device established by `sim/psrr-injector-attribution/records/20261002-070506-29da08e.md` (row 4e); disposition tracked in **#300** (cause) and **#315** (fix) |
| 4c | PSRR stretch (> 30 dB @ 1 MHz) | informational | `psrr_1m` 15.72–16.87 dB (schematic, bare core), **15.53–16.71 dB (schematic, injector attached — row 4d)**, 13.40–14.69 dB (post-layout) — **below** the stretch line at every corner. The injector costs essentially nothing at 1 MHz (≤0.2 dB), in stark contrast to its 20–44 dB cost inside the DC–1 kHz band: the ≈1.5–2 dB the post-layout column loses at this spot is extraction's, not the injector's, which is consistent with row 4b's cause being a low-frequency loop effect rather than a broadband one | **FAIL (stretch, non-blocking)** | `sim/psrr-dc/records/20260909-232410-e8e2e46.md` (schematic), `sim/psrr-dc-with-injector/records/20260923-124813-af9ff1e.md` (schematic + injector), `sim/psrr-dc-post-layout/records/20260923-073641-dbd4dda.md` (post-layout) |
| 4d | PSRR, schematic, **with the startup injector attached** — the design-vs-extraction discriminator for row 4b (#300) | same (> 60 dB DC–1 kHz band-min, DR-006) | `psrr_band_min` **24.78**–73.03 dB. Binding: **ff, 125 °C, 3.63 V** (24.78 dB — **35.22 dB below** the floor), the *same* binding corner as row 4b. Bench is `sim/psrr-dc/testbench/tb_vref_psrr.sch` with exactly one change — an `XSU` `design/startup_injector.sym` instance on GDRV/VREF — and reuses `sim/psrr-dc/experiment.json`'s corners, deck, measurements, limits and spread checks unchanged, so the injector is the only variable between this row and row 4a. **This is the decisive experiment #300 asked for**: no extraction step exists anywhere in this bench, and the collapse reproduces in full (median per-corner agreement with row 4b 0.21 dB, mean 0.96 dB, max 4.32 dB; 29/45 corners within 0.5 dB; exactly one corner — `fs, 27 °C, 3.63 V`, 62.29 dB here vs. 59.14 dB post-layout — differs in verdict, which is why the counts read 24/45 and 25/45). Corner signature reproduces too: monotone in supply (mean −21.51 dB at 3.63 V vs. −6.21 dB at 2.97 V) and fast-PMOS-selective (mean −21.58 dB at `sf`, −21.02 dB at `ff`, −6.91 dB at `fs`). Also the **first** record in this repo where issue #127's band-interior guard is not redundant: 11 of 45 corners show a genuine interior dip below both band edges (largest 0.90 dB at `sf, −40 °C, 2.97 V`), so the monotonic-rolloff assumption the pre-#127 two-edge check rested on is now empirically false for this circuit. **No fix has landed as of 2026-10-02, and this row is still the one that certifies the DR-006 claim.** #306 carried this evidence forward and (a) localized the collapse to `MPC1`/`MPC2` by measurement — see row 4e — and (b) tried and rejected three device-resize fixes (DR-011), each of which either failed to clear 45/45 or eroded `sim/startup-stability`'s own margin/convergence. The remaining fix, its `sim/startup-stability` / `sim/startup-time-post-layout` re-verification, and the layout/extraction cycle it implies are tracked in **#315** | **FAIL 24/45** | `sim/psrr-dc-with-injector/records/20260923-124813-af9ff1e.md` (new bench, first record; `sim/psrr-dc-with-injector/README.md` carries the full cross-record comparison) |
| 4e | PSRR, schematic, **per-device attribution inside the startup injector** — which of row 4d's six devices dominates (#306) | not a spec row: an **attribution**, graded against row 4a's bare-core control and DR-006's 60 dB floor as a recovery target | Five bodies differing by exactly one GDRV-touching device branch, each over the full 45-corner matrix (225 ngspice points), cut from row 4d's own committed netlist snapshot (`sim/psrr-dc-with-injector/netlist-snapshots/20260923-124813-af9ff1e.spice`) rather than from a fresh netlist of `design/`, so every number is corner-for-corner comparable to rows 4a/4d. `base` (all six devices) reproduces row 4d exactly: worst **24.78 dB** at `ff, 125 °C, 3.63 V`, 21/45 above the floor. `ref_open` (**`MPC1`/`MPC2` cut**, `NG` held at `VSS`): worst **65.64 dB**, **45/45** — a recovery to within 1.7 dB of the bare core's 67.34 dB, and up to **+42.29 dB** at the binding corner. `inj_open` (**`MNI` cut**): worst **48.48 dB**, 43/45 — partial only. `clamp_open` (**`MNC` cut**, the #52 railed-branch clamp): worst **24.78 dB**, 21/45, within **0.25 dB of `base` at every corner** — exonerated outright. `core_only` (CONTROL, no injector): 45/45, matching row 4a. **Mechanism**: at the binding corner `v(NG)` reads **0.2560 V** in `base` and 0 V in `ref_open` — the reference stack's failure to switch fully off is what leaves `MNI`'s gate biased and turns it into a supply-dependent drain current out of the amplifier's high-impedance GDRV node. **Limits of the claim, reported rather than rounded away (the record's own verdict is `Overall: FAIL` — 425 of 429 attribution assertions hold, 4 do not)**: at `sf, 125 °C, 3.30 V` and `sf, 125 °C, 3.63 V`, cutting the stack leaves **2.03 dB** and **3.07 dB** unrecovered against the bare-core control (over the record's 2.0 dB "nothing large left unattributed" bar); and at `ff, 125 °C, 3.30 V` and `sf, 125 °C, 3.63 V`, cutting `MNI` instead recovers marginally *more* than cutting the stack (+0.69 dB, +0.10 dB). So `MPC1`/`MPC2` is the **dominant** contributor, not the sole one, and `MNI`'s own GDRV conductance is a measured hot-corner residual — which is exactly the residual DR-011 found blocks a resize-only fix | **ATTRIBUTION ESTABLISHED** (`MPC1`/`MPC2` dominant; `MNC` exonerated; `MNI` a measured residual). Record's own `Overall: FAIL` — 4/429 assertions unmet, quantified above. **No spec verdict is claimed or changed by this row** | `sim/psrr-injector-attribution/records/20261002-070506-29da08e.md` (new bench, first record; 45-corner × 5-variant table and per-axis degradation breakdowns in the record itself); fix disposition in [DR-011](../spec/decision-records/DR-011-startup-injector-psrr-fix-infeasible-by-resize.md) and **#315** |
| 4f | PSRR, schematic, **candidate screening for the injector fix** — does a non-resize change to row 4d's circuit clear DR-006 at 45/45 *before* the layout/DRC/LVS/post-layout cycle is paid for (#315) | not a spec row: a **screen** against DR-006's 60 dB DC–1 kHz band-min floor, read against row 4a's bare-core ceiling | Three bodies over the full 45-corner matrix (135 ngspice points), each **adding** devices to the same committed snapshot row 4e cuts from (`sim/psrr-dc-with-injector/netlist-snapshots/20260923-124813-af9ff1e.spice`), so every number is corner-for-corner comparable to rows 4a/4d/4e. **No existing device is resized in any variant** — DR-011 closed the resize path empirically. `base` (shipped): worst **24.78 dB**, 21/45, reproducing row 4d within 0.5 dB at every corner. `ref3` (**+`MPC3`**, the reference stack extended two-high → three-high, DR-011's candidate 1 and #315's item 1): worst **30.35 dB** at `sf, −40 °C, 3.63 V`, **27/45** — the hot-corner failure closes outright (24.78 → 67.50 dB at `ff, 125 °C, 3.63 V`) and a *cold-corner* residual appears, so it reproduces DR-011's hand-run FAIL 18/45 as a committed record. `ref3_ngclamp` (**+`MPC3` and +`MNG`**, `MNG` = a weak `W=1 L=20` NMOS from `NG` to `VSS` gated by `VSENSE`): **45/45, worst 65.64 dB** at `sf, 125 °C, 3.63 V`. **Mechanism measured, not inferred**: at `sf, −40 °C, 3.63 V` the shipped body reads `v(NG)` = `v(NE)` = **0.506 V** — `NG` pinned at `QS`'s VBE with `MNS` in deep triode, i.e. `MNI`'s gate parked within a few hundred mV of its threshold — and **0.000 V** with `MNG`, taking `psrr_band_min` 34.79 → 68.47 dB against a 68.30 dB ceiling. Cutting one branch at a time out of the best *stacking-only* candidate at that corner shows why stacking saturates ≈5 dB short: cutting **either** the stack (68.47 dB) **or** `MNI` (68.35 dB) recovers the whole ceiling, so the residual is the **series path `GDRV → stack → NG → MNI → VSS`**, not either device | **PSRR SCREEN PASS 45/45 FOR `ref3_ngclamp` — NOT A FIX, AND NOT LANDED.** `design/startup_injector.sch` is unchanged, so rows 4b/4d keep their FAIL verdicts, and two separate findings keep it that way. (a) **`+MPC3` breaks a different ratified floor**: an 11-point probe of `sim/startup-stability`'s own degenerate-region window (orientation, validated to within 1.5 % against that bench's committed record on the stock design) measures the tightest `itrav_min` corner `ss, 125 °C, 2.97 V` at **6.87 nA stock → 0.65 nA with `+MPC3`**, i.e. **below** the manifest's 1 nA floor, with `+MNG` alone costing 3 % — so the device that buys the hot corners is the one that breaks startup, and DR-011's candidate 1 is dead on margin rather than inconclusive. (b) The certifying 45-corner regression costs ≈17–33 h on an x86_64 Linux sweep host (DR-012 Part 1, filed as **#320**), and landing a change next to a regression that cannot be run to a conclusion is what DR-011 refused. The record's own verdict is `Overall: FAIL` on **2 of 317** checks — the ceiling-margin bar (2.0 dB) at `sf, 125 °C, 3.30/3.63 V`, where the candidate sits 2.018/3.062 dB under row 4a; those are the *same two corners, to within 0.01 dB*, where row 4e already measured 2.03/3.07 dB unrecovered when the stack is cut outright, i.e. the second-order contributor that row disclosed, 5.6 dB **above** DR-006's floor rather than below it. **No spec verdict is claimed or changed by this row** | `sim/psrr-injector-candidates/records/20261002-200944-fe334b1.md` (new bench, first record; 45-corner × 3-variant table, per-candidate summary and the binding-corner operating points in the record itself); the startup-window probe numbers and the full candidate table (including the ones this bench does not carry — bulk-to-`GDRV`, `MNI` cascoding, a four-high stack) are in [DR-012](../spec/decision-records/DR-012-startup-injector-psrr-ng-clamp-and-stack-height-margin.md) Parts 1b/3; the landing + layout cycle stays in **#315**, its compute blocker in **#320** |
| 5 | Supply — operability (3.3 V ±10 %) | operate 2.97–3.63 V | every corner-matrix bench in this table (rows 1a/1b/3a/3b/4a/4b/4d/4e/6a/6b/8a–8d) sweeps this full 2.97–3.63 V range without solver divergence | **PASS** | as cited per row |
| 5b | Supply — line-regulation shift (informational; no dedicated ratified line item yet, see `sim/line-regulation`'s own claim text) | shift must fit inside the ±2 % accuracy window (48 mV p-p) — necessary, not sufficient | Overall: PASS 45/45 (out of this issue's rerun scope) | **PASS 45/45** | `sim/line-regulation/records/20260817-021208-13476b7.md` |
| 5c | Supply — line regulation, post-layout | same | Overall: PASS 15/15, but with the **margin substantially eroded** by the injector (#285): `line_shift_mv` 0.065–**18.47** mV (was 0.015–0.038 mV) against the 48 mV p-p window, and `line_psrr_db` **31.06**–80.19 dB (was 84.90–93.13 dB). Worst corner `ff, 125 °C` — the same corner and the same magnitude as row 4b's worst, which is what makes the two benches corroborate each other rather than repeat each other. Still passes its own bound; recorded here because the shift is 480× and the cause is #300's | **PASS 15/15 (margin eroded)** | `sim/line-regulation-post-layout/records/20260923-075227-dbd4dda.md` (supersedes `20260817-022402-13476b7`) |
| 5d | Supply stretch (1.8 V-core Banba variant) | — | not implemented; wave-1 scope explicitly defers it | **N/A / deferred** | [DR-001](../spec/decision-records/DR-001-supply-flavor-scope.md) |
| 6a | Iq (schematic) | < 50 µA | 20.08–32.82 µA | **PASS 45/45** | `sim/quiescent-current/records/20260909-232410-e8e2e46.md` (re-run against the post-#193 design; supersedes `20260816-085818-69a8867`) |
| 6b | Iq, post-layout | same | 14.62–26.85 µA — the injector costs at most **+0.74 µA** (worst corner `ff, 125 °C, 3.63 V`: 26.85 µA against the pre-injector 26.11 µA), leaving 23 µA of headroom under the 50 µA line | **PASS 45/45** | `sim/quiescent-current-post-layout/records/20260923-072514-dbd57a9.md` (re-run against the injector-inclusive layout, #285; supersedes `20260909-232410-e8e2e46`) |
| 6c | Iq stretch (< 20 µA) | informational | not met at any corner (20.08 µA best case, schematic) | **FAIL (stretch, non-blocking)** | same two records |
| 7 | Area | < 0.08 mm² (80,000 µm², DR-007) | composed bbox **70,360 µm²** (≈12 % margin under budget). Grew 66,293 → 70,360 µm² (+4,067 µm², +6.1 %) when the startup injector's five blocks were drawn in (#285); they share the existing `amp_cc` row rather than opening a sixth one, which is what keeps the growth to one row's width instead of ~21,000 µm² of new cell height. **DR-007's 80,000 µm² budget is unchanged** — this row records a measured area inside the ratified budget, not a request to raise it, so the AREA-EFF efficiency-read precondition on *growing* an AREA row is not engaged | **PASS** | `layout/bandgap-core/reports/20260923-070209-dbd57a9/record.md` |
| 8a | Startup — self-starting (no other stable state), schematic, core+injector | exactly one DC operating point over 0…VDD on GDRV | **45/45 corner-point checks PASS** (plus 2 corner-sensitivity checks, also PASS) | **PASS** | `sim/startup-stability/records/20260909-232410-e8e2e46.md` (re-run against the post-#193 design; supersedes `20260815-032111-001d1b7`) |
| 8b | Startup — self-starting, post-layout, **composed cell** (core + drawn injector) | same | **8/8 corner-point checks PASS** (by-design worst-corner subset — see the record's own subset reason), plus both corner-sensitivity checks. **Re-run against the freshest, injector-inclusive layout record; the superseded-layout disclosure this row carried is retired (#299).** The bench no longer wraps `sim/startup-stability/`'s testbench and manifest. It carries its own `testbench/tb_startup_stability_pl.sch`, which instantiates `design/bandgap_core.sym` **alone** — the extracted body supplies the injector, and no `design/startup_injector.sym` appears anywhere in the deck — and its own `experiment.json`, which **drops the six bare-core-control measurements** (`imin_off_bare`, `i_off_bare`, `ncross_bare`, `dvref`, `i_standing`, `i_su_standing`) because a drawn monolithic cell cannot express a bare-core control at all. Those claims are relocated, not discarded: the bare-core statements are **row 8a's**, at schematic level, where the control is a real instance; the injector-attach *cost* (`dvref`, `i_standing`) is **not representable post-layout** and is not claimed here. What replaces the delta is a bound, which is stronger: `ncross_su = 1` at every corner, and `imin_off_su` 23.5 µA–1.00 mA / `i_off_su` 306 µA–1.25 mA — three to five orders of magnitude above the 10 nA / 1 µA floors an injector-less core collapses onto, i.e. the bare core's failure mode stated as a bound rather than as a difference. `sim/bin/post_layout_common.require_layout_draws_injector()` structurally refuses to run this bench against a layout record whose own LVS reference netlist does not state the injector's six device cards (`MMPC1`, `MMPC2`, `MMNS`, `MMNI`, `MMNC`, `QQS`) | **PASS 8/8** | `sim/startup-stability-post-layout/records/20260924-041313-999407b.md` (layout record `20260923-070209-dbd57a9`). The prior `20260909-232410-e8e2e46` stays on disk as history; it measures a different DUT construction against a different layout record, so it is superseded **in role** rather than by a `Supersedes` field |
| 8c | Startup — time < 1 ms, schematic, core+injector | **Two things, graded separately since #284/DR-010.** (i) the ratified half: `t_start` < 1 ms; (ii) the bench's own additional cross-condition `vref` convergence-spread check, ≤ 1 mV — a bound **no ratified row states** | (i) **PASS 45/45** — worst `t_start` over all corners and all three ramp profiles is `+147 µs` (147.143 µs, unchanged from the superseded record) against the 1 ms bound, and no `t_start_*` measurement has failed in any record this bench has ever produced. (ii) **FAIL 13/45** at `ff`/`sf` process plus `tt/−40 °C/3.63 V`, 1.15–13.66 mV. Root-caused by #284 as a **fixed-sample-time artifact, not a second operating point**: cross-reading `sim/startup-stability/`'s free-running DC solve (`vref_dut`) at the same 45 corners puts the DC equilibrium **strictly inside** the interval the three copies span at all 13 failing corners — the slow-ramp copy above it at 13/13, the fast-ramp copy below it at 13/13 — i.e. all three are still converging on one point from opposite sides. The #303 full-matrix re-run `20260923-202758-81803b1` now carries the contraction gate at all 45 corners: `vref_converge` **PASS 45/45** (≤ 0 V everywhere, so the spread is still shrinking at every corner when the sample window ends). `ncross_su = 1` at all 45 corners (row 8a) independently excludes a second equilibrium | **MIXED** — ratified `< 1 ms` half **PASS 45/45**; consistency check **FAIL 13/45** (up from 10/45 pre-#193 — the resistor-array resize measurably widens this margin gap), carried as the bounded, characterized exception **DR-010**, which keeps the 1 mV bound and the sample point unchanged and leaves the residual charged against issue #11's budget | `sim/startup-ramp/records/20260923-202758-81803b1.md` (full 45-point matrix on the post-#284 manifest, #303 — the first full-matrix record carrying the convergence gates: **`vref_converge` PASS 45/45** and `vref_spread_early` informational at every corner; supersedes `20260910-010233-e8e2e46.md`, which it re-derives **bit-identically** on every shared measurement at all 45 corners, so this row's counts are unchanged by construction; the superseded record and the #284 4-point subset `20260923-092903-079a778.md` remain in `records/` as history). Disposition: [DR-010](../spec/decision-records/DR-010-startup-ramp-vref-spread-settling-tail.md) |
| 8d | Startup — time, post-layout, **composed cell** (core + drawn injector) | same two things as 8c, graded separately. **Re-run against the freshest, injector-inclusive layout record; the superseded-layout disclosure this row carried is retired (#299).** Restructured the same way as row 8b: own `testbench/tb_startup_ramp_pl.sch` (`XSLOW`/`XFAST`/`XDEG`, each `design/bandgap_core.sym` **alone**, no `design/startup_injector.sym` in the deck) and own `experiment.json`, which **drops the two bare-core-control measurements** `vref_n` and `gn_n` — readings on the control copy `XDEGN` the drawn cell cannot express. Those claims relocate to **row 8c** (schematic level, control real) and **row 8e** (`sim/startup-time-post-layout/`'s `gdrv_final` measures `gn_n`'s post-layout counterpart on this same composed cell, 1.598–2.611 V, 45/45) | (i) **PASS 45/45** — worst `t_start` over all 45 corners and all three ramp profiles is **+169 µs** (`t_start_s` at `ss/125 °C/2.97 V`) against the 1 ms bound; `t_start_f` ≤ 27.1 µs, `t_start_g` ≤ 45.6 µs. `t_start_g` **resolving at all** is itself the injector working: it is the time to leave the degenerate state, and a cell with no working injector never produces the `v(VREFG) = 1.05 V` crossing the measurement is the difference of. (ii) **FAIL 13/45**, worst 18.46 mV at `sf/−40 °C/3.63 V`; `vref_converge` **PASS 45/45** (≤ 0 V everywhere — the spread is still contracting at the sample point at every corner). Post-layout **inherits** 8c's DR-010 artifact rather than adding a mechanism, and now does so almost exactly: this record fails the **same 13-corner count and 12 of the same 13 corners** as the 8c record (`ff_27c_3.63v` fails at schematic and passes here; `tt_-40c_3.30v` the reverse), so extraction only nudges already-near-threshold corners across the 1 mV cliff, in both directions | **MIXED** — ratified `< 1 ms` half **PASS 45/45**; consistency check **FAIL 13/45**, same DR-010 exception as 8c, at the same corner count | `sim/startup-ramp-post-layout/records/20260924-041313-999407b.md` (full 45-point matrix, layout record `20260923-070209-dbd57a9`). The prior `20260910-004925-e8e2e46` (FAIL 16/45) and the #284 2-point subset `20260923-093126-079a778` stay on disk as history; both measure the pre-#299 mixed-provenance DUT against the pre-#285 layout, so they are superseded **in role** rather than by a `Supersedes` field |
| 8e | Startup — core-as-composed | informational — and no longer a by-construction FAIL on the post-layout side. `design/startup_injector.sch` is now **drawn into the composed cell** (#285), so the two halves of this row deliberately measure different circuits: the schematic half is still `design/bandgap_core.sym` alone (the unprotected core), the post-layout half is the cell that would be fabricated | Schematic: 45/45 **FAIL**, unchanged and still expected — the bare core parks in the all-off degenerate state. Post-layout: **45/45 PASS**, `t_start` 0.0678–0.1818 ms against the < 1 ms budget, and `gdrv_final` 1.598–2.611 V at every corner (the degenerate state parks GDRV at VDD ≥ 2.97 V, so this is the drawn injector actively evicting it) | **Schematic FAIL 45/45 (expected) · post-layout PASS 45/45 (verdict flip)** | `sim/startup-time/records/20260909-232410-e8e2e46.md` (schematic, unchanged), `sim/startup-time-post-layout/records/20260923-070906-dbd57a9.md` (supersedes `20260910-010233-e8e2e46`) |

### Reading the "Startup" row as one ratified claim

DR-005's single "Startup: self-starting, < 1 ms" line is verified by **three** distinct
benches, each disclosing exactly what it does and doesn't cover in its own `**Claim**`
text (not a report-writing simplification — the benches say this themselves):
`startup-stability` (the no-other-stable-state half, **passes**),
`startup-ramp` (the < 1 ms half — **the ratified `t_start` measurement passes at every
corner of every record this bench has ever produced**; what fails at 13–16 of 45 corners
is the bench's *own additional* `vref_spread` convergence-consistency check, a 1 mV bound
no ratified row states, up from 10–12/45 pre-#193), and `startup-time` (the core
exactly as composed today — which, since #285, **includes** the drawn injector on the
post-layout side and still excludes it on the schematic side, so that bench now
**passes 45/45 post-layout** and still **fails 45/45 at schematic level**, both
correctly). Reporting only `startup-stability`'s PASS (as the
top-level README currently does in its maturity-ladder summary line) would round the
Startup row toward the target — this report does not do that; the row is **mixed**, not
a clean PASS, and the `startup-ramp` partial FAIL plus the bare-core `startup-time`
FAIL are both disclosed here rather than omitted. This report does not modify the
README; see §5.

**What #285 changed about this subsection.** Before it, all three benches agreed that
the *composed* cell had no injector, and row 8e's FAIL was the honest statement of
that gap. Now the composed cell has one. That splits the three benches into two
groups rather than three: `startup-time` measures the composed cell directly and its
post-layout half flipped to PASS; `startup-stability` and `startup-ramp` still wired a
*separately netlisted* schematic injector onto the core and therefore could not be
re-run post-layout without double-counting it (#299).

**What #299 then changed (2026-09-24).** The two post-layout benches were given their
own testbenches and their own manifests instead of wrapping their schematic-level
siblings', so all three benches now measure the composed cell on the post-layout side
and the grouping collapses to one. The cost is stated rather than absorbed: the
**bare-core control instances are gone** from the post-layout side, because a drawn
monolithic cell cannot express one, and with them the eight control-dependent
measurements (`imin_off_bare`, `i_off_bare`, `ncross_bare`, `dvref`, `i_standing`,
`i_su_standing` on 8b; `vref_n`, `gn_n` on 8d). A schematic-netlisted bare core placed
*alongside* an extracted one was considered and rejected: every difference it produced
would mix "what the injector costs" with "what the extraction costs", which is the
mixed-provenance mistake being removed, not a repair of it. The bare-core claims
therefore stay where they are already carried and falsifiable — **rows 8a/8c** at
schematic level, where the control is a real instance, and **row 8e**, whose
post-layout half is the bare-vs-drawn comparison stated as two separately graded
halves of one row. What the post-layout rows keep in place of a delta is a *bound*
that an injector-less cell cannot clear (8b's `imin_off_su`/`i_off_su` floors, 8d's
`t_start_g` resolving at all) plus a structural precondition,
`require_layout_draws_injector()`, that refuses the run outright if the layout record
under test does not draw the injector.

**Update (2026-09-23, issue #284 / [DR-010](../spec/decision-records/DR-010-startup-ramp-vref-spread-settling-tail.md)):
rounding the other way is also a rounding.** Rows 8c/8d previously folded
`startup-ramp`'s `vref_spread` check into the same Target cell as `t_start`, so a
`vref_spread` FAIL read as the ratified `< 1 ms` line failing. It is not: `vref_spread`
is a consistency check this bench invented on top of the ratified halves, with a bound no
ratified row states, and #284 root-caused its failures as a **fixed-sample-time artifact**
— `sim/startup-stability/`'s free-running DC solve puts the true equilibrium strictly
inside the interval the three startup-condition copies span, at all 13 failing corners, so
they are converging on one point from opposite sides rather than settling anywhere
different. The response was deliberately *not* to loosen anything: the 1 mV bound, the
`at=2.45e-3` sample point and the 2.5 ms window are all unchanged, the rows stay **FAIL**
on that check, and the residual stays charged against issue #11's ±1 % budget. What
changed is that rows 8c/8d now grade the two claims in separate cells, the bench measures
its own convergence (`vref_converge`, a new bounded gate), and the residual is carried
under a numbered, bounded exception (DR-010) instead of a testbench comment. The Startup
row remains **mixed** — DR-010 makes the mixture legible, it does not dissolve it.

## 3. Items 3–7 verification rollup, with freshness

| Item | Verdict | Freshness | Artifact(s) |
|---|---|---|---|
| 3. DRC | **PASS, disclosed gaps** | 2026-09-23, `layout/bandgap-core/reports/20260923-070209-dbd57a9/` (the injector-inclusive cell, #285) | `drc.json` (`violation_count: 0`, deck `sky130` content-hash `sha256:aa7aca65…`) + `met2-drc.json` (supplementary met2-min-area checker, `violation_count: 0`). The `klt signoff` envelope-aggregation run quoted in §1 was made against the previous report dir; its four envelopes are the same four checks, still clean, on the new one |
| 4. LVS | **PASS, single-engine** | same report dir | `lvs.combined.json` (`mismatch_count: 0`, 14/14 nets, **22/22 devices** — 16 core + the 6 injector devices #285 drew in, up from 11/11 and 16/16 — engine `klayout` only). This is the item the whole of #285 turns on: LVS was previously clean across a gap **both sides shared**, because `reference.spice` transcribed `design/bandgap_core.sch` alone. Both sides now carry the injector |
| 5. Full PVT vs. ratified spec | **MIXED, one new open violation** | 2026-08-17 (schematic rows) through 2026-09-23 (`sim/*-post-layout/records/20260923-*-dbd*`, #285; `sim/psrr-dc-with-injector/records/20260923-124813-af9ff1e`, #300) | row 1a (output accuracy, schematic) **PASSES 45/45**; row 1b (post-layout) **FAILs 14/15**, attributed to the still-open upstream defect klayout-tools#2359 rather than to a design defect (issue #283 corrected the earlier "fixed upstream, klayout-tools#800" citation — #800 was closed *not planned*, and no `klt` version bump clears this row), and re-measured by #285 against the injector-inclusive cell; rows 3a/3b (box-method TC) still **FAIL 45/45 and 15/15** — TC-floor disposition tracked in #179, out of scope here; **row 4b (PSRR, post-layout) flipped to FAIL 25/45** once the injector was drawn into the cell, tracked as an open spec violation in **#300** and corroborated by row 5c's eroded line-regulation margin. **New row 4d (#300) closes the design-vs-extraction question on that row**: the same claim, measured at schematic level with the injector attached and no extraction step in the loop, **FAILs 24/45 at the same binding corner** (24.78 dB vs. 22.75 dB) — so row 4b is a design property, not a `klt extract --parasitics` artifact, and unlike row 1b it is **not** attributable to klayout-tools#2359. The open violation therefore stands and is a circuit problem; the `MPC1`/`MPC2`-side fix is out of #300's own scope. **#306 then localized it to a device by measurement (new row 4e, 2026-10-02)** — cutting `MPC1`/`MPC2` recovers PASS 45/45, cutting `MNC` recovers nothing, cutting `MNI` recovers only 43/45 — and **rejected three device-resize fixes for it (DR-011)**, so the violation is unchanged in verdict but no longer unlocalized. The remaining fix and its layout cycle are tracked in **#315** |
| 6. Monte Carlo | **Evidence present** (fresh, not stale); harness sanity floor PASS; DR-005 3σ spec **FAIL** (row 1c, issue #334) | 2026-08-17, commits `d7d85b6`/`aa5324e` | `sim/monte-carlo-untrimmed/records/20260817-121131-d7d85b6.md` — re-run against the **current** chained-array design (`n_r2=51`, issue #193) and the ratified ±2 % window; yield is now 79.4–95.7 % across all three temperatures (row 1c), a verdict flip from the pre-#193 0.00 % yield at 125 °C. The contributor-breakdown half `sim/error-amp-offset-mc/records/20260817-130441-aa5324e.md` (closed by issue #180/PR #196) is likewise current, closing the staleness this report previously flagged. |
| 7. Post-layout | **CURRENT, one disclosed artifact, one open violation** | 2026-09-24 (#285, #299), layout report `20260923-070209-dbd57a9` | **The extracted netlist is now a netlist of the whole ratified design, and every post-layout row measures it.** Until #285 the composed cell omitted `design/startup_injector.sch` entirely, so every row in this section measured a circuit the schematic rows do not describe; that is closed. Mechanism is unchanged: `klt extract --parasitics` → `sim/bin/post_layout_common.py`. Five of the seven post-layout benches were re-run against the injector-inclusive cell on 2026-09-23 (rows 1b, 3b, 4b, 5c, 6b, 8e); the remaining two — `startup-stability-post-layout` and `startup-ramp-post-layout`, rows 8b/8d — were **restructured and re-run on 2026-09-24 by #299**, closing the deferral this item previously carried. Those two no longer *re-run a schematic-level bench* at all: their mixed-provenance construction (extracted core + separately netlisted schematic injector + bare-core control instances) became unrunnable the moment the cell drew its own injector, so each was given its own testbench and its own manifest, instantiating `design/bandgap_core.sym` alone and dropping the eight measurements that were differences against a bare-core control the drawn cell cannot express. Neither row's verdict moved in kind (8b PASS 8/8; 8d MIXED — ratified half PASS 45/45, DR-010 consistency check FAIL 13/45, now matching row 8c's count exactly). Outcomes: one verdict flip up (8e, FAIL 45/45 → PASS 45/45 — the injector demonstrably works in the drawn cell), one verdict flip down (4b, PASS 45/45 → FAIL 25/45, **#300**), one margin erosion inside its bound (5c), and no change of disposition on rows 1b [artifact] / 3b / 6b. **Attribution discipline within this item (#300, 2026-09-23)**: two of these rows now point in *opposite* directions about extraction, and that is a measured distinction rather than a stylistic one. Row 1b's FAIL is attributed to klayout-tools#2359 because a schematic-level control passes; row 4b's FAIL is attributed to the **design**, because the schematic-level control with the injector attached (new row 4d, `sim/psrr-dc-with-injector/`) fails the same way at the same binding corner with no extraction step in the loop. Whenever a post-layout row in this item is attributed to an extraction artifact, that attribution should rest on a schematic-level control like row 4d's, not on plausibility — row 4b is the case where the plausible attribution turned out to be the wrong one. `klt pex` (the machine-checkable parasitic-delta grader `docs/cli/signoff.md` names as the only accepted automated evidence for this item) **has landed upstream** — [klayout-tools Epic #709](https://github.com/2AMLogic/klayout-tools/issues/709) closed 2026-08-14 and `docs/cli/pex.md` documents the verb (corrected 2026-09-23, issue #292; this row previously said it was "still not implemented upstream"). What is true is that **this repo has not produced a `klt pex` report**: the extraction-based re-run above is still the substitute it actually has, and T1 item 7 is uncited in `signoff/block-manifest.json` for exactly that reason (`klt extract --parasitics` output is not the `delta[]`/`reference_netlist`/`corner_count` shape item 7 accepts). The gap is now this repo's, not the tool's. **No bench remains draft-graded**: `sim/quiescent-current-post-layout/` and `sim/startup-time-post-layout/` (the two issue #279 named) now carry their first ratified-graded records; `sim/line-regulation-post-layout/` was already cleared by issue #193. |

## 4. Known blind spots (disclosed, not fixed here)

Carried forward from items 3/4/7's own citations, plus what this rollup itself
surfaced:

- **DRC deck coverage gap.** `drc.json`'s own `layers_in_stream_without_rules` lists 8
  layers the curated sky130 deck does not check (`64/20`, `65/44`, `66/13`, `68/5`,
  `82/44`, `83/20`, `86/20`, `94/20`).
- **met2 deck gap.** The curated sky130 **DRC** deck lacked met2 rules until
  [klayout-tools#513](https://github.com/2AMLogic/klayout-tools/issues/513) (merged via
  #515) added width/spacing/enclosure; the met2 **min-area** rule (`m2.6`) is still
  outside the deck's rule vocabulary and is covered by this repo's own supplementary
  checker (`met2-drc.json`, `layout/bin/met2_drc.py`), not upstream `klt drc` alone.
- **Single-engine LVS.** `lvs.combined.json`'s `mismatch_count: 0` is one toolchain
  (`klayout`) agreeing with itself — the independent-second-engine cross-check
  [klayout-tools#343](https://github.com/2AMLogic/klayout-tools/issues/343) describes
  has not landed.
- **No `klt pex` *run* in this repo** (corrected 2026-09-23, issue #292 — this bullet
  previously read "No `klt pex`", claiming the verb did not exist upstream). The
  machine-checkable parasitic-delta post-layout grader named by `docs/cli/signoff.md`
  **does** exist upstream now:
  [klayout-tools Epic #709](https://github.com/2AMLogic/klayout-tools/issues/709) closed
  2026-08-14 and `docs/cli/pex.md` documents it. This repo has simply never run it — its
  post-layout evidence is still extraction-based re-simulation (`klt extract
  --parasitics` translated and re-run through every schematic-level bench), which T1
  item 7 does not accept, so that item stays uncited in `signoff/block-manifest.json`.
  The blind spot is real; its cause is this repo's, not the tool's.
- **`klt signoff --manifest`/`--fleet` — resolved, no longer a blind spot** (corrected
  2026-09-23, issue #292; this bullet previously read "unusable from a packaged
  install"). [2AMLogic/klayout-tools#1050](https://github.com/2AMLogic/klayout-tools/issues/1050)
  closed upstream 2026-08-16, and tier-verdict mode is what
  [`signoff/`](../signoff/README.md) now grades this block with on every push/PR (§1
  above). The envelope-aggregation mode (no `--manifest`) also still works and is used
  in §1/§3.
- **A manifest pin does not prove the artifact behind it is unchanged** (issue #292).
  `klt signoff` compares each citation's `content_hash` against the hash the cited
  envelope *recorded*, never against the artifact itself
  (`citation.input_verified: null` on every row of `signoff/signoff-report.json`), so
  re-grading alone cannot detect an edit to this report or a rewrite of the routed GDS.
  That is covered separately, and only since #292, by `scripts/ci/check_signoff_pins.py`
  in CI's `checks` job — which is why editing this file requires re-running
  `./signoff/regenerate.sh` (it re-pins item 8's envelope from this file's bytes).
- **Trim-network evidence refreshed** (row 2, issue #327) — `sim/trim-lsb-chained/` was
  re-run at the current `n_r2=51` design and passes all of DR-002's criteria at every
  corner (engineering checks). Issue #333 grades the ratified DR-005 Trim row separately
  from the same measurements and it **FAILS** range (0 mV up, 3.2 % down vs ±5 %) and
  ≥5-bit coverage (17 codes = 4.09 bits); resolution (0.2025 % ≤ 0.25 %) passes. It is schematic-level only; a post-layout (extracted routed chain) trim check
  is a possible follow-up, not currently tracked.
- **No post-layout bench remains draft-graded** (resolved by issue #279 — previously
  three benches, `sim/line-regulation-post-layout/` [cleared by #193],
  `sim/quiescent-current-post-layout/`, `sim/startup-time-post-layout/` [both cleared by
  #279], carried pre-ratification claim text on their newest record; none do now, per
  `sim/README.md`'s own "Draft-graded vs. ratified-graded records" grep). Kept as a
  bullet here, now marked resolved, so the history travels with the claim.
- **The PSRR violation is in the schematic design and is now localized to a device —
  but it is not fixed** (issue #300 for the cause, issue #306 for the device, updated
  2026-10-02). Row 4d establishes that the composed circuit — core *plus* the startup
  injector the cell has drawn since #285 — misses DR-006's 60 dB band-min floor at 24
  of 45 corners **at schematic level**, so this is not a post-layout-only problem and
  cannot be cleared by any `klt` fix. Row 4e then closes the per-device question #300
  left open: cutting `MPC1`/`MPC2` recovers the bench to **PASS 45/45** (worst
  65.64 dB, +42.29 dB at the binding corner), cutting `MNC` recovers **nothing**
  (≤0.25 dB everywhere), and cutting `MNI` recovers only to **43/45** — so the
  `MPC1`/`MPC2` attribution is a measurement now, not a corner-signature inference.
  Three limits on what all of that buys: (i) the dominance is **not exclusive** — the
  attribution record's own verdict is `Overall: FAIL` on 4 of 429 assertions, because
  the two hot `sf, 125 °C` corners leave 2.03/3.07 dB unrecovered when only the stack
  is cut, and at two 125 °C corners cutting `MNI` recovers marginally more; `MNI`'s
  own GDRV conductance is a real residual, which is precisely why a resize-only fix
  did not close the matrix; (ii) **no fix has landed** — DR-011 records three resize
  candidates tried and rejected (a 3-high `MPC1`/`MPC2`/`MPC3` stack, resizing `MNI`,
  and a re-verification of the 3-high stack whose `sim/startup-stability` run was
  *inconclusive* rather than failed, timing out under per-sweep-point `gmin` homotopy),
  so rows 4b/4d keep their FAIL verdicts and this report claims no improvement; (iii)
  row 4a still passes 45/45 and is still the row DR-006 was written against, so the
  two schematic rows disagree about the same spec line for a legitimate reason
  (different DUT), and a reader who quotes only row 4a will overstate this design's
  supply rejection. Any `MPC1`/`MPC2` change still has to be re-verified against
  `sim/startup-stability` and `sim/startup-time-post-layout`, since starving that stack
  is what would stop the injector working. The remaining fix, that re-verification,
  and the layout/DRC/LVS/post-layout re-sim cycle it implies are tracked in **#315**;
  **#306** stays open until its own criteria can be checked against that work.
  **Updated 2026-10-02 (#315, DR-012)**: the cold-corner residual DR-011 could not
  resize away is now explained — it is the series path
  `GDRV → stack → NG → MNI → VSS`, with `NG` pinned at `QS`'s VBE (measured
  0.506 V at `sf, −40 °C, 3.63 V`) so `MNI` never fully turns off — and a body that
  clears DR-006 at **45/45** at schematic level exists (new row 4f: `+MPC3` plus
  `+MNG`, a weak `W=1 L=20` NMOS clamping `NG` to ~0 V once the core is running;
  worst corner 65.64 dB). **It is not a fix**: a targeted probe of
  `sim/startup-stability`'s degenerate-region window measures `+MPC3` taking the
  tightest `itrav_min` corner from 6.87 nA to **0.65 nA, below the 1 nA floor**
  (`+MNG` alone costs 3 %), so the half that buys the hot corners breaks a
  *different* ratified row, and DR-011's candidate 1 is dead on margin rather than
  inconclusive. The certifying 45-corner regression is separately unaffordable on
  the sweep hosts (≈1.8 h/corner, ≈17–33 h for the matrix, vs 285.8 s for the
  identical deck and corner on the Darwin host that minted its 45/45 record, and
  ~10× faster again under `ngspice-47`) — filed as **#320**. Rows 4b/4d therefore
  keep their FAIL verdicts and their records, unchanged, and the surviving device
  for the next attempt is `+MNG`, with the hot corner still needing a remedy that
  is not reference-stack height.
- **Area figure drift across docs, not fixed here.** The top-level `README.md`,
  `layout/README.md`, and DR-007/DR-008 all cite a composed-bbox figure of
  **73,989 µm²**, measured against an earlier layout report
  (`layout/bandgap-core/reports/20260811-221633-a0ee5e7/`). The freshest layout report
  (`20260923-070209-dbd57a9`, the injector-inclusive cell of #285) measures
  **70,360 µm²** — still smaller than the figure those docs cite, and still comfortably
  within the DR-007 80,000 µm² budget either way, so no verdict changes. The
  intermediate `20260817-020222-13476b7` (pre-injector) measured 66,293 µm². This
  report cites the freshest number (row 7) and flags the drift rather than editing
  those other files, which are outside this issue's scope.

## 5. What this report deliberately does not do

- **Does not modify** any spec row, decision record, `product/` file, or existing
  `sim/*/records/*` file (append-only, per `CLAUDE.md` and this issue's own
  constraints). Row values above are transcribed from records, never re-derived by
  hand. (The 2026-09-23 #285 revision *appended* new records — five post-layout benches
  re-run against the injector-inclusive layout — and transcribed those; it edited none.
  In particular it does **not** relax DR-006 to accommodate row 4b's new FAIL: that
  disposition is #300's, and a failing row is reported failing. The 2026-09-23 #300
  revision likewise only *appends*: one new bench directory and its first record, plus
  row 4d transcribed from it. It determines row 4b's **cause** — design, not extraction —
  and it does not change row 4b's verdict, its numbers, or DR-006's floor, and it does
  not attempt the circuit fix that cause implies. The 2026-10-02 #306 revision is
  append-only in the same way: one new bench directory (`sim/psrr-injector-attribution/`)
  and its first record, plus row 4e transcribed from it. It determines **which device**
  dominates row 4b/4d's collapse, and it does not change either row's verdict, numbers
  or binding corner, does not relax DR-006, and does not land a circuit fix — the three
  resize candidates it investigated were all rejected in DR-011 rather than
  half-landed, and `design/startup_injector.sch` is byte-unchanged by it.)
- **Does not fix** the currently-failing TC-floor row — its disposition is an open
  operator question tracked in #179, a separate issue by design (see #175's
  decomposition, #176), and this report's job is to state the current verdicts
  honestly, not improve them. Does not touch the TC row's verdict logic or any spec
  text, per #279's own scope.
- **Does not duplicate** device-level characterization. `design/device-characterization-summary.md`
  (654 lines: PNP/resistor/MOS local-matching, five experiment families, all PASS at the
  *device* level) stands as the device-level companion to this *block*-level report and
  is cited, not re-derived, here.
- **Does not record a tier grant.** `product/everyblock/grants.md` is the authoritative
  ledger and grants are the operator's call, per its own "How a grant gets recorded
  here" procedure — nothing here should be read as one.
