2AMLogic/sky130-bandgap/sim/pnp-characterization/records/20260801-041501-48ac24d.md

# Record 20260801-041501-48ac24d

- **Record ID**: 20260801-041501-48ac24d
- **Experiment**: `pnp-characterization` — Substrate PNP (pnp_05v5) VBE / dVBE vs Ic and temperature
- **Claim**: Issue #4 -- characterizes sky130_fd_pr__pnp_05v5_W0p68L0p68 (small unit) and sky130_fd_pr__pnp_05v5_W3p40L3p40 (large unit) VEB vs collector current (100nA..100uA, half-decade steps) and vs temperature/process corner, plus the PTAT dVBE between the two emitter sizes at matched current. Informs the usable current-density window / effective ideality factor for spec/topology-survey.md and the amplifier offset budget (#9). Supply axis intentionally fixed at nominal 3.30V: both devices are diode-connected (base=collector=0) and biased by ideal DC current sources with no supply-referenced terminal in the DUT, so sweeping supply would not change any result -- see design/device-characterization-summary.md. Issue #35: the EMITTER is the driven terminal (the connection a bandgap core has); the original record 20260731-043353-a8c4147 drove the collector by mistake and is superseded. The veb_* sanity window is [0.30, 1.10] V: the upper bound admits the legitimate -40C/100uA point (~1.00V, still well under the ~1.2V 0-K VEB extrapolation), and the lower bound is set below the emitter-driven 125C floor (0.403V) but ABOVE the collector-driven 125C values (0.22-0.26V), so a recurrence of the pin-order mis-wire fails the harness at the hot corners instead of passing silently.
- **Netlist provenance**: schematic (`sim/pnp-characterization/testbench/tb_pnp_vbe.sch`)
- **PDK**: sky130A @ open_pdks `c6d73a35f524070e85faff4a6a9eef49553ebc2b` (matches sim/pdk.json pin); models `/Users/rwalters/.volare/sky130A/libs.tech/combined/sky130.lib.spice`
- **Tools**: ngspice-46 : Circuit level simulation program; XSCHEM V3.4.7; Darwin 25.6.0 arm64
- **Repo state**: `48ac24d` on `feature/issue-35` (working tree dirty at run time)
- **Corner matrix run**:
  - Process: tt, ss, ff, sf, fs
  - Temperature: -40 °C, 27 °C, 125 °C
  - Supply: 3.30 V
  - 15 corner point(s) executed
  - Full PVT matrix declared in `experiment.json` (−40/27/125 °C × ±10 % supply × process corners)
- **Statistical convention**: N/A (corner-matrix / bias-ladder characterization, not a distribution claim)
- **Result**:
  - tt_-40c_3.30v: PASS (veb_small_100n=0.805168V; veb_large_100n=0.757329V; dvbe_100n=0.0478391V; veb_small_316n=0.829201V; veb_large_316n=0.780722V; dvbe_316n=0.0484783V; veb_small_1u=0.853575V; veb_large_1u=0.804122V; dvbe_1u=0.0494524V; veb_small_3p16u=0.878946V; veb_large_3p16u=0.827537V; dvbe_3p16u=0.0514091V; veb_small_10u=0.907341V; veb_large_10u=0.851195V; dvbe_10u=0.0561457V; veb_small_31p6u=0.943347V; veb_large_31p6u=0.87552V; dvbe_31p6u=0.0678264V; veb_small_100u=0.998624V; veb_large_100u=0.901838V; dvbe_100u=0.0967858V)
  - tt_27c_3.30v: PASS (veb_small_100n=0.679826V; veb_large_100n=0.619309V; dvbe_100n=0.060517V; veb_small_316n=0.710923V; veb_large_316n=0.649424V; dvbe_316n=0.0614994V; veb_small_1u=0.742539V; veb_large_1u=0.679573V; dvbe_1u=0.0629664V; veb_small_3p16u=0.775606V; veb_large_3p16u=0.709761V; dvbe_3p16u=0.0658453V; veb_small_10u=0.812833V; veb_large_10u=0.740293V; dvbe_10u=0.0725403V; veb_small_31p6u=0.859405V; veb_large_31p6u=0.771736V; dvbe_31p6u=0.0876683V; veb_small_100u=0.925727V; veb_large_100u=0.80577V; dvbe_100u=0.119956V)
  - tt_125c_3.30v: PASS (veb_small_100n=0.483709V; veb_large_100n=0.40457V; dvbe_100n=0.0791382V; veb_small_316n=0.5248V; veb_large_316n=0.444554V; dvbe_316n=0.0802452V; veb_small_1u=0.566849V; veb_large_1u=0.48461V; dvbe_1u=0.0822389V; veb_small_3p16u=0.611515V; veb_large_3p16u=0.524764V; dvbe_3p16u=0.0867503V; veb_small_10u=0.662951V; veb_large_10u=0.565476V; dvbe_10u=0.0974755V; veb_small_31p6u=0.726975V; veb_large_31p6u=0.607638V; dvbe_31p6u=0.119337V; veb_small_100u=0.811449V; veb_large_100u=0.653631V; dvbe_100u=0.157819V)
  - ss_-40c_3.30v: PASS (veb_small_100n=0.805564V; veb_large_100n=0.757735V; dvbe_100n=0.0478289V; veb_small_316n=0.829603V; veb_large_316n=0.781135V; dvbe_316n=0.0484685V; veb_small_1u=0.85399V; veb_large_1u=0.804539V; dvbe_1u=0.0494513V; veb_small_3p16u=0.879393V; veb_large_3p16u=0.827957V; dvbe_3p16u=0.0514357V; veb_small_10u=0.907868V; veb_large_10u=0.85162V; dvbe_10u=0.0562482V; veb_small_31p6u=0.944014V; veb_large_31p6u=0.875952V; dvbe_31p6u=0.0680625V; veb_small_100u=0.999168V; veb_large_100u=0.902272V; dvbe_100u=0.0968958V)
  - ss_27c_3.30v: PASS (veb_small_100n=0.680124V; veb_large_100n=0.61965V; dvbe_100n=0.0604744V; veb_small_316n=0.711227V; veb_large_316n=0.64977V; dvbe_316n=0.0614574V; veb_small_1u=0.742857V; veb_large_1u=0.679922V; dvbe_1u=0.0629342V; veb_small_3p16u=0.775961V; veb_large_3p16u=0.710115V; dvbe_3p16u=0.065845V; veb_small_10u=0.813288V; veb_large_10u=0.740655V; dvbe_10u=0.0726327V; veb_small_31p6u=0.860077V; veb_large_31p6u=0.772116V; dvbe_31p6u=0.0879609V; veb_small_100u=0.926493V; veb_large_100u=0.80618V; dvbe_100u=0.120313V)
  - ss_125c_3.30v: PASS (veb_small_100n=0.483915V; veb_large_100n=0.404844V; dvbe_100n=0.0790711V; veb_small_316n=0.525012V; veb_large_316n=0.444831V; dvbe_316n=0.080181V; veb_small_1u=0.567078V; veb_large_1u=0.484891V; dvbe_1u=0.0821866V; veb_small_3p16u=0.611788V; veb_large_3p16u=0.525051V; dvbe_3p16u=0.0867373V; veb_small_10u=0.663354V; veb_large_10u=0.565773V; dvbe_10u=0.097581V; veb_small_31p6u=0.727694V; veb_large_31p6u=0.607962V; dvbe_31p6u=0.119732V; veb_small_100u=0.812535V; veb_large_100u=0.654013V; dvbe_100u=0.158522V)
  - ff_-40c_3.30v: PASS (veb_small_100n=0.804771V; veb_large_100n=0.756904V; dvbe_100n=0.0478678V; veb_small_316n=0.828798V; veb_large_316n=0.78029V; dvbe_316n=0.048508V; veb_small_1u=0.85316V; veb_large_1u=0.803686V; dvbe_1u=0.0494739V; veb_small_3p16u=0.878501V; veb_large_3p16u=0.827097V; dvbe_3p16u=0.0514044V; veb_small_10u=0.90682V; veb_large_10u=0.85075V; dvbe_10u=0.0560701V; veb_small_31p6u=0.942699V; veb_large_31p6u=0.875069V; dvbe_31p6u=0.0676293V; veb_small_100u=0.998086V; veb_large_100u=0.901385V; dvbe_100u=0.0967013V)
  - ff_27c_3.30v: PASS (veb_small_100n=0.679526V; veb_large_100n=0.618943V; dvbe_100n=0.0605833V; veb_small_316n=0.710617V; veb_large_316n=0.649058V; dvbe_316n=0.0615583V; veb_small_1u=0.742219V; veb_large_1u=0.679203V; dvbe_1u=0.0630158V; veb_small_3p16u=0.77525V; veb_large_3p16u=0.709386V; dvbe_3p16u=0.0658637V; veb_small_10u=0.81238V; veb_large_10u=0.73991V; dvbe_10u=0.0724693V; veb_small_31p6u=0.858746V; veb_large_31p6u=0.771337V; dvbe_31p6u=0.087409V; veb_small_100u=0.924982V; veb_large_100u=0.80534V; dvbe_100u=0.119642V)
  - ff_125c_3.30v: PASS (veb_small_100n=0.483499V; veb_large_100n=0.40428V; dvbe_100n=0.0792194V; veb_small_316n=0.524584V; veb_large_316n=0.44426V; dvbe_316n=0.0803235V; veb_small_1u=0.566618V; veb_large_1u=0.484312V; dvbe_1u=0.0823055V; veb_small_3p16u=0.611239V; veb_large_3p16u=0.52446V; dvbe_3p16u=0.086778V; veb_small_10u=0.662547V; veb_large_10u=0.56516V; dvbe_10u=0.0973867V; veb_small_31p6u=0.726266V; veb_large_31p6u=0.607296V; dvbe_31p6u=0.11897V; veb_small_100u=0.810401V; veb_large_100u=0.653228V; dvbe_100u=0.157173V)
  - sf_-40c_3.30v: PASS (veb_small_100n=0.803248V; veb_large_100n=0.755109V; dvbe_100n=0.0481388V; veb_small_316n=0.827252V; veb_large_316n=0.778485V; dvbe_316n=0.0487674V; veb_small_1u=0.851572V; veb_large_1u=0.801866V; dvbe_1u=0.0497067V; veb_small_3p16u=0.87681V; veb_large_3p16u=0.825261V; dvbe_3p16u=0.0515493V; veb_small_10u=0.904878V; veb_large_10u=0.848899V; dvbe_10u=0.0559799V; veb_small_31p6u=0.940357V; veb_large_31p6u=0.873196V; dvbe_31p6u=0.0671605V; veb_small_100u=0.996078V; veb_large_100u=0.899498V; dvbe_100u=0.0965803V)
  - sf_27c_3.30v: PASS (veb_small_100n=0.678349V; veb_large_100n=0.617403V; dvbe_100n=0.0609453V; veb_small_316n=0.709416V; veb_large_316n=0.647503V; dvbe_316n=0.0619135V; veb_small_1u=0.740969V; veb_large_1u=0.677631V; dvbe_1u=0.0633375V; veb_small_3p16u=0.773868V; veb_large_3p16u=0.707795V; dvbe_3p16u=0.0660735V; veb_small_10u=0.810649V; veb_large_10u=0.738287V; dvbe_10u=0.0723624V; veb_small_31p6u=0.856319V; veb_large_31p6u=0.769649V; dvbe_31p6u=0.0866702V; veb_small_100u=0.922285V; veb_large_100u=0.803527V; dvbe_100u=0.118759V)
  - sf_125c_3.30v: PASS (veb_small_100n=0.482668V; veb_large_100n=0.403025V; dvbe_100n=0.0796429V; veb_small_316n=0.523728V; veb_large_316n=0.44299V; dvbe_316n=0.0807374V; veb_small_1u=0.565701V; veb_large_1u=0.483025V; dvbe_1u=0.0826759V; veb_small_3p16u=0.610151V; veb_large_3p16u=0.523149V; dvbe_3p16u=0.0870023V; veb_small_10u=0.66098V; veb_large_10u=0.563801V; dvbe_10u=0.0971792V; veb_small_31p6u=0.723614V; veb_large_31p6u=0.605826V; dvbe_31p6u=0.117788V; veb_small_100u=0.806643V; veb_large_100u=0.651513V; dvbe_100u=0.15513V)
  - fs_-40c_3.30v: PASS (veb_small_100n=0.806025V; veb_large_100n=0.75818V; dvbe_100n=0.0478451V; veb_small_316n=0.830072V; veb_large_316n=0.781585V; dvbe_316n=0.0484865V; veb_small_1u=0.854474V; veb_large_1u=0.804994V; dvbe_1u=0.0494803V; veb_small_3p16u=0.879915V; veb_large_3p16u=0.828416V; dvbe_3p16u=0.0514991V; veb_small_10u=0.908492V; veb_large_10u=0.852085V; dvbe_10u=0.0564067V; veb_small_31p6u=0.94482V; veb_large_31p6u=0.876425V; dvbe_31p6u=0.0683945V; veb_small_100u=0.999805V; veb_large_100u=0.902746V; dvbe_100u=0.0970592V)
  - fs_27c_3.30v: PASS (veb_small_100n=0.680468V; veb_large_100n=0.620019V; dvbe_100n=0.0604481V; veb_small_316n=0.711578V; veb_large_316n=0.650146V; dvbe_316n=0.0614328V; veb_small_1u=0.743224V; veb_large_1u=0.680302V; dvbe_1u=0.0629215V; veb_small_3p16u=0.776371V; veb_large_3p16u=0.7105V; dvbe_3p16u=0.0658708V; veb_small_10u=0.81382V; veb_large_10u=0.741049V; dvbe_10u=0.0727706V; veb_small_31p6u=0.860878V; veb_large_31p6u=0.772529V; dvbe_31p6u=0.0883489V; veb_small_100u=0.927416V; veb_large_100u=0.806626V; dvbe_100u=0.12079V)
  - fs_125c_3.30v: PASS (veb_small_100n=0.484152V; veb_large_100n=0.405139V; dvbe_100n=0.0790128V; veb_small_316n=0.525257V; veb_large_316n=0.44513V; dvbe_316n=0.0801264V; veb_small_1u=0.567341V; veb_large_1u=0.485194V; dvbe_1u=0.082146V; veb_small_3p16u=0.612103V; veb_large_3p16u=0.52536V; dvbe_3p16u=0.0867431V; veb_small_10u=0.663822V; veb_large_10u=0.566095V; dvbe_10u=0.0977275V; veb_small_31p6u=0.728545V; veb_large_31p6u=0.608313V; dvbe_31p6u=0.120232V; veb_small_100u=0.813854V; veb_large_100u=0.654427V; dvbe_100u=0.159426V)
  - corner-sensitivity check on `veb_small_1u`: PASS (observed spread 0.288773 over 15 points, required ≥ 0.01)
  - **Overall: PASS**
- **Links**:
  - Testbench: `sim/pnp-characterization/testbench/tb_pnp_vbe.sch`
  - Netlist snapshot: `sim/pnp-characterization/netlist-snapshots/20260801-041501-48ac24d.spice`
  - Raw per-corner logs: `sim/pnp-characterization/corners/20260801-041501-48ac24d/`
  - Machine-readable record: `sim/pnp-characterization/records/20260801-041501-48ac24d.json`
  - Experiment manifest: `sim/pnp-characterization/experiment.json`
- **Timestamp / author**: 2026-08-01T04:15:01Z, robb@2amlogic.com
- **Supersedes**: 20260731-043353-a8c4147

Written by `sim/bin/corner-run.py`. Append-only: never edit this file — a correction is a new record with a `Supersedes` field (see `sim/README.md`).
