2AMLogic/sky130-bandgap/sim/mos-matching-characterization/records/20260731-045825-a8c4147.md

# Record 20260731-045825-a8c4147

- **Record ID**: 20260731-045825-a8c4147
- **Experiment**: `mos-matching-characterization` — 5V thick-oxide mirror device operating point (nfet_g5v0d10v5 / pfet_g5v0d10v5)
- **Claim**: Issue #4 -- sweeps the BSIM operating point (Id, Vth, Vov=Vgs-Vth, gm/Id) of diode-connected sky130_fd_pr__nfet_g5v0d10v5 and sky130_fd_pr__pfet_g5v0d10v5 at two mirror-device sizes (A: W=4/L=1um, area 4um^2; B: W=8/L=2um, area 16um^2, 4x A) and three bias currents (2/5/20 uA, spanning the per-branch range implied by a <50uA total Iq bandgap core) across process/temperature. Combined with the PDK's own static Vth-mismatch (AVT) coefficients (sw_mm_vth0_sky130_fd_pr__nfet_g5v0d10v5 / __pfet_g5v0d10v5 in continuous/models_global.spice -- the PDK models expose no separate beta/mobility mismatch term for this device family, only Vth0), this gives an analytic dId/Id-vs-Vov mismatch projection (dId/Id ~= (gm/Id)*sigma_Vth) reported in design/device-characterization-summary.md, and picks the recommended mirror operating region. Supply axis intentionally fixed at nominal 3.30V: all devices are diode-connected and biased by ideal DC current sources with no supply-referenced terminal in the DUT.
- **Netlist provenance**: schematic (`sim/mos-matching-characterization/testbench/tb_mos_matching.sch`)
- **PDK**: sky130A @ open_pdks `c6d73a35f524070e85faff4a6a9eef49553ebc2b` (matches sim/pdk.json pin); models `/Users/rwalters/.volare/sky130A/libs.tech/combined/sky130.lib.spice`
- **Tools**: ngspice-46 : Circuit level simulation program; XSCHEM V3.4.7; Darwin 25.6.0 arm64
- **Repo state**: `a8c4147` on `feature/issue-4` (working tree dirty at run time)
- **Corner matrix run**:
  - Process: tt, ss, ff, sf, fs
  - Temperature: -40 °C, 27 °C, 125 °C
  - Supply: 3.30 V
  - 15 corner point(s) executed
  - Full PVT matrix declared in `experiment.json` (−40/27/125 °C × ±10 % supply × process corners)
- **Statistical convention**: N/A for the corner-matrix operating-point sweep above (deterministic, MC_MM_SWITCH=0). The dId/Id mismatch figure reported in the summary record is an analytic Pelgrom-style projection from the PDK's static AVT coefficient, not a simulated Monte Carlo distribution -- see the summary for the method and its limitations (only Vth mismatch is modeled by the PDK for this device family).
- **Result**:
  - tt_-40c_3.30v: PASS (mna2u_id=2e-06A; mna2u_vth=0.894266V; mna2u_vov=0.0433984V; mna2u_gmid=19.39961/V; mna5u_id=5e-06A; mna5u_vth=0.894305V; mna5u_vov=0.0972596V; mna5u_gmid=14.59231/V; mna20u_id=2e-05A; mna20u_vth=0.894498V; mna20u_vov=0.228396V; mna20u_gmid=7.594491/V; mnb2u_id=2e-06A; mnb2u_vth=0.879772V; mnb2u_vov=0.0557389V; mnb2u_gmid=18.67931/V; mnb5u_id=5e-06A; mnb5u_vth=0.879793V; mnb5u_vov=0.112478V; mnb5u_gmid=13.76291/V; mnb20u_id=2e-05A; mnb20u_vth=0.879896V; mnb20u_vov=0.251922V; mnb20u_gmid=7.228861/V; mpa2u_id=2e-06A; mpa2u_vth=1.10557V; mpa2u_vov=0.119028V; mpa2u_gmid=14.10961/V; mpa5u_id=5e-06A; mpa5u_vth=1.10569V; mpa5u_vov=0.197712V; mpa5u_gmid=9.404861/V; mpa20u_id=2e-05A; mpa20u_vth=1.10628V; mpa20u_vov=0.416843V; mpa20u_gmid=4.306281/V; mpb2u_id=1.99999e-06A; mpb2u_vth=1.14868V; mpb2u_vov=0.111906V; mpb2u_gmid=12.48811/V; mpb5u_id=4.99998e-06A; mpb5u_vth=1.14874V; mpb5u_vov=0.200023V; mpb5u_gmid=8.52921/V; mpb20u_id=1.99999e-05A; mpb20u_vth=1.14902V; mpb20u_vov=0.433495V; mpb20u_gmid=4.189411/V)
  - tt_27c_3.30v: PASS (mna2u_id=2e-06A; mna2u_vth=0.811889V; mna2u_vov=0.0506902V; mna2u_gmid=15.39491/V; mna5u_id=5e-06A; mna5u_vth=0.811928V; mna5u_vov=0.118048V; mna5u_gmid=11.73011/V; mna20u_id=2e-05A; mna20u_vth=0.812123V; mna20u_vov=0.279383V; mna20u_gmid=6.208011/V; mnb2u_id=2e-06A; mnb2u_vth=0.797394V; mnb2u_vov=0.0654333V; mnb2u_gmid=14.86821/V; mnb5u_id=5e-06A; mnb5u_vth=0.797415V; mnb5u_vov=0.136224V; mnb5u_gmid=11.09071/V; mnb20u_id=2e-05A; mnb20u_vth=0.79752V; mnb20u_vov=0.308017V; mnb20u_gmid=5.886861/V; mpa2u_id=2e-06A; mpa2u_vth=0.966336V; mpa2u_vov=0.153107V; mpa2u_gmid=12.17241/V; mpa5u_id=5e-06A; mpa5u_vth=0.966455V; mpa5u_vov=0.243363V; mpa5u_gmid=8.226721/V; mpa20u_id=2e-05A; mpa20u_vth=0.967051V; mpa20u_vov=0.496013V; mpa20u_gmid=3.674151/V; mpb2u_id=1.99999e-06A; mpb2u_vth=1.02381V; mpb2u_vov=0.133324V; mpb2u_gmid=10.8271/V; mpb5u_id=4.99998e-06A; mpb5u_vth=1.02387V; mpb5u_vov=0.23514V; mpb5u_gmid=7.359281/V; mpb20u_id=1.99999e-05A; mpb20u_vth=1.02415V; mpb20u_vov=0.507631V; mpb20u_gmid=3.566181/V)
  - tt_125c_3.30v: PASS (mna2u_id=2.00001e-06A; mna2u_vth=0.691397V; mna2u_vov=0.0597972V; mna2u_gmid=11.83461/V; mna5u_id=4.99998e-06A; mna5u_vth=0.691437V; mna5u_vov=0.146711V; mna5u_gmid=9.128021/V; mna20u_id=2e-05A; mna20u_vth=0.691635V; mna20u_vov=0.351916V; mna20u_gmid=4.893671/V; mnb2u_id=1.99997e-06A; mnb2u_vth=0.676901V; mnb2u_vov=0.0777071V; mnb2u_gmid=11.47711/V; mnb5u_id=4.99995e-06A; mnb5u_vth=0.676922V; mnb5u_vov=0.168751V; mnb5u_gmid=8.667031/V; mnb20u_id=2e-05A; mnb20u_vth=0.677028V; mnb20u_vov=0.387159V; mnb20u_gmid=4.637031/V; mpa2u_id=2e-06A; mpa2u_vth=0.762676V; mpa2u_vov=0.203776V; mpa2u_gmid=10.11981/V; mpa5u_id=5e-06A; mpa5u_vth=0.762798V; mpa5u_vov=0.310271V; mpa5u_gmid=7.042321/V; mpa20u_id=2e-05A; mpa20u_vth=0.763404V; mpa20u_vov=0.604506V; mpa20u_gmid=3.095611/V; mpb2u_id=1.99999e-06A; mpb2u_vth=0.841162V; mpb2u_vov=0.167007V; mpb2u_gmid=9.366651/V; mpb5u_id=4.99999e-06A; mpb5u_vth=0.84122V; mpb5u_vov=0.284378V; mpb5u_gmid=6.371261/V; mpb20u_id=2e-05A; mpb20u_vth=0.841508V; mpb20u_vov=0.603748V; mpb20u_gmid=2.995081/V)
  - ss_-40c_3.30v: PASS (mna2u_id=2e-06A; mna2u_vth=0.929078V; mna2u_vov=0.0446213V; mna2u_gmid=19.29451/V; mna5u_id=5e-06A; mna5u_vth=0.929116V; mna5u_vov=0.0988765V; mna5u_gmid=14.46511/V; mna20u_id=2e-05A; mna20u_vth=0.92931V; mna20u_vov=0.231443V; mna20u_gmid=7.505041/V; mnb2u_id=2e-06A; mnb2u_vth=0.905648V; mnb2u_vov=0.0562983V; mnb2u_gmid=18.62361/V; mnb5u_id=5e-06A; mnb5u_vth=0.905669V; mnb5u_vov=0.113251V; mnb5u_gmid=13.70261/V; mnb20u_id=2e-05A; mnb20u_vth=0.905773V; mnb20u_vov=0.253428V; mnb20u_gmid=7.187921/V; mpa2u_id=2e-06A; mpa2u_vth=1.15024V; mpa2u_vov=0.121026V; mpa2u_gmid=13.89161/V; mpa5u_id=5e-06A; mpa5u_vth=1.15036V; mpa5u_vov=0.201136V; mpa5u_gmid=9.226921/V; mpa20u_id=2e-05A; mpa20u_vth=1.15095V; mpa20u_vov=0.424374V; mpa20u_gmid=4.237521/V; mpb2u_id=1.9825e-06A; mpb2u_vth=1.19019V; mpb2u_vov=0.113125V; mpb2u_gmid=12.41841/V; mpb5u_id=4.95265e-06A; mpb5u_vth=1.19025V; mpb5u_vov=0.201737V; mpb5u_gmid=8.471091/V; mpb20u_id=1.97757e-05A; mpb20u_vth=1.19052V; mpb20u_vov=0.436541V; mpb20u_gmid=4.1621/V)
  - ss_27c_3.30v: PASS (mna2u_id=2e-06A; mna2u_vth=0.8467V; mna2u_vov=0.0523773V; mna2u_gmid=15.30881/V; mna5u_id=5e-06A; mna5u_vth=0.846739V; mna5u_vov=0.120252V; mna5u_gmid=11.62241/V; mna20u_id=2e-05A; mna20u_vth=0.846935V; mna20u_vov=0.28347V; mna20u_gmid=6.129511/V; mnb2u_id=2e-06A; mnb2u_vth=0.823225V; mnb2u_vov=0.0662303V; mnb2u_gmid=14.82121/V; mnb5u_id=5e-06A; mnb5u_vth=0.823246V; mnb5u_vov=0.137309V; mnb5u_gmid=11.03791/V; mnb20u_id=2e-05A; mnb20u_vth=0.823351V; mnb20u_vov=0.310096V; mnb20u_gmid=5.850081/V; mpa2u_id=2e-06A; mpa2u_vth=1.01131V; mpa2u_vov=0.155057V; mpa2u_gmid=12.01121/V; mpa5u_id=5e-06A; mpa5u_vth=1.01143V; mpa5u_vov=0.246816V; mpa5u_gmid=8.077141/V; mpa20u_id=2e-05A; mpa20u_vth=1.01202V; mpa20u_vov=0.504333V; mpa20u_gmid=3.613791/V; mpb2u_id=1.9889e-06A; mpb2u_vth=1.06532V; mpb2u_vov=0.135089V; mpb2u_gmid=10.75951/V; mpb5u_id=4.96909e-06A; mpb5u_vth=1.06537V; mpb5u_vov=0.237582V; mpb5u_gmid=7.300841/V; mpb20u_id=1.98439e-05A; mpb20u_vth=1.06565V; mpb20u_vov=0.512043V; mpb20u_gmid=3.537661/V)
  - ss_125c_3.30v: PASS (mna2u_id=2e-06A; mna2u_vth=0.726209V; mna2u_vov=0.0622494V; mna2u_gmid=11.76571/V; mna5u_id=4.99998e-06A; mna5u_vth=0.726248V; mna5u_vov=0.149876V; mna5u_gmid=9.038561/V; mna20u_id=2e-05A; mna20u_vth=0.726447V; mna20u_vov=0.357689V; mna20u_gmid=4.826371/V; mnb2u_id=1.99996e-06A; mnb2u_vth=0.702666V; mnb2u_vov=0.0789147V; mnb2u_gmid=11.43811/V; mnb5u_id=4.99995e-06A; mnb5u_vth=0.702687V; mnb5u_vov=0.170367V; mnb5u_gmid=8.621451/V; mnb20u_id=2e-05A; mnb20u_vth=0.702793V; mnb20u_vov=0.390193V; mnb20u_gmid=4.604631/V; mpa2u_id=2e-06A; mpa2u_vth=0.808084V; mpa2u_vov=0.205702V; mpa2u_gmid=10.01771/V; mpa5u_id=5e-06A; mpa5u_vth=0.808204V; mpa5u_vov=0.313671V; mpa5u_gmid=6.931491/V; mpa20u_id=2e-05A; mpa20u_vth=0.80881V; mpa20u_vov=0.613474V; mpa20u_gmid=3.043661/V; mpb2u_id=1.9952e-06A; mpb2u_vth=0.882666V; mpb2u_vov=0.169485V; mpb2u_gmid=9.302981/V; mpb5u_id=4.98589e-06A; mpb5u_vth=0.882723V; mpb5u_vov=0.287765V; mpb5u_gmid=6.313791/V; mpb20u_id=1.99187e-05A; mpb20u_vth=0.88301V; mpb20u_vov=0.610018V; mpb20u_gmid=2.966751/V)
  - ff_-40c_3.30v: PASS (mna2u_id=2e-06A; mna2u_vth=0.859456V; mna2u_vov=0.0421893V; mna2u_gmid=19.50271/V; mna5u_id=5e-06A; mna5u_vth=0.859494V; mna5u_vov=0.0956661V; mna5u_gmid=14.71841/V; mna20u_id=2e-05A; mna20u_vth=0.859687V; mna20u_vov=0.225403V; mna20u_gmid=7.68411/V; mnb2u_id=2e-06A; mnb2u_vth=0.853895V; mnb2u_vov=0.0551888V; mnb2u_gmid=18.73431/V; mnb5u_id=5e-06A; mnb5u_vth=0.853915V; mnb5u_vov=0.111717V; mnb5u_gmid=13.82251/V; mnb20u_id=2e-05A; mnb20u_vth=0.854019V; mnb20u_vov=0.250443V; mnb20u_gmid=7.269471/V; mpa2u_id=2e-06A; mpa2u_vth=1.06087V; mpa2u_vov=0.11709V; mpa2u_gmid=14.3261/V; mpa5u_id=5e-06A; mpa5u_vth=1.06099V; mpa5u_vov=0.194393V; mpa5u_gmid=9.583831/V; mpa20u_id=2e-05A; mpa20u_vth=1.06157V; mpa20u_vov=0.409544V; mpa20u_gmid=4.374041/V; mpb2u_id=2e-06A; mpb2u_vth=1.10717V; mpb2u_vov=0.109997V; mpb2u_gmid=12.59741/V; mpb5u_id=5e-06A; mpb5u_vth=1.10723V; mpb5u_vov=0.197216V; mpb5u_gmid=8.626011/V; mpb20u_id=2e-05A; mpb20u_vth=1.10751V; mpb20u_vov=0.427809V; mpb20u_gmid=4.242891/V)
  - ff_27c_3.30v: PASS (mna2u_id=2e-06A; mna2u_vth=0.777079V; mna2u_vov=0.0490185V; mna2u_gmid=15.47951/V; mna5u_id=5e-06A; mna5u_vth=0.777118V; mna5u_vov=0.115871V; mna5u_gmid=11.83711/V; mna20u_id=2e-05A; mna20u_vth=0.777312V; mna20u_vov=0.275362V; mna20u_gmid=6.28691/V; mnb2u_id=2e-06A; mnb2u_vth=0.771563V; mnb2u_vov=0.0646457V; mnb2u_gmid=14.91481/V; mnb5u_id=5e-06A; mnb5u_vth=0.771583V; mnb5u_vov=0.135153V; mnb5u_gmid=11.14311/V; mnb20u_id=2e-05A; mnb20u_vth=0.771688V; mnb20u_vov=0.305967V; mnb20u_gmid=5.923531/V; mpa2u_id=2e-06A; mpa2u_vth=0.921322V; mpa2u_vov=0.151229V; mpa2u_gmid=12.33041/V; mpa5u_id=5e-06A; mpa5u_vth=0.921441V; mpa5u_vov=0.240038V; mpa5u_gmid=8.376021/V; mpa20u_id=2e-05A; mpa20u_vth=0.922038V; mpa20u_vov=0.487961V; mpa20u_gmid=3.734341/V; mpb2u_id=2e-06A; mpb2u_vth=0.982304V; mpb2u_vov=0.131053V; mpb2u_gmid=10.91661/V; mpb5u_id=5e-06A; mpb5u_vth=0.982361V; mpb5u_vov=0.231874V; mpb5u_gmid=7.440121/V; mpb20u_id=2e-05A; mpb20u_vth=0.982644V; mpb20u_vov=0.501071V; mpb20u_gmid=3.610551/V)
  - ff_125c_3.30v: PASS (mna2u_id=2.00002e-06A; mna2u_vth=0.656587V; mna2u_vov=0.0573622V; mna2u_gmid=11.90211/V; mna5u_id=4.99998e-06A; mna5u_vth=0.656626V; mna5u_vov=0.143579V; mna5u_gmid=9.216991/V; mna20u_id=2e-05A; mna20u_vth=0.656824V; mna20u_vov=0.346225V; mna20u_gmid=4.961511/V; mnb2u_id=1.99997e-06A; mnb2u_vth=0.651136V; mnb2u_vov=0.0765081V; mnb2u_gmid=11.51581/V; mnb5u_id=4.99995e-06A; mnb5u_vth=0.651158V; mnb5u_vov=0.167149V; mnb5u_gmid=8.712451/V; mnb20u_id=2e-05A; mnb20u_vth=0.651264V; mnb20u_vov=0.384153V; mnb20u_gmid=4.669511/V; mpa2u_id=2e-06A; mpa2u_vth=0.717212V; mpa2u_vov=0.201938V; mpa2u_gmid=10.21821/V; mpa5u_id=5e-06A; mpa5u_vth=0.717333V; mpa5u_vov=0.30702V; mpa5u_gmid=7.15161/V; mpa20u_id=2e-05A; mpa20u_vth=0.717941V; mpa20u_vov=0.595842V; mpa20u_gmid=3.147861/V; mpb2u_id=2e-06A; mpb2u_vth=0.79966V; mpb2u_vov=0.164273V; mpb2u_gmid=9.43861/V; mpb5u_id=5e-06A; mpb5u_vth=0.799718V; mpb5u_vov=0.280556V; mpb5u_gmid=6.438181/V; mpb20u_id=2e-05A; mpb20u_vth=0.800006V; mpb20u_vov=0.596152V; mpb20u_gmid=3.030911/V)
  - sf_-40c_3.30v: PASS (mna2u_id=2e-06A; mna2u_vth=0.815905V; mna2u_vov=0.0436198V; mna2u_gmid=19.39441/V; mna5u_id=5e-06A; mna5u_vth=0.815943V; mna5u_vov=0.0974917V; mna5u_gmid=14.58381/V; mna20u_id=2e-05A; mna20u_vth=0.816137V; mna20u_vov=0.228642V; mna20u_gmid=7.592781/V; mnb2u_id=2e-06A; mnb2u_vth=0.821703V; mnb2u_vov=0.0558008V; mnb2u_gmid=18.67881/V; mnb5u_id=5e-06A; mnb5u_vth=0.821724V; mnb5u_vov=0.112536V; mnb5u_gmid=13.76341/V; mnb20u_id=2e-05A; mnb20u_vth=0.821827V; mnb20u_vov=0.251927V; mnb20u_gmid=7.232991/V; mpa2u_id=2e-06A; mpa2u_vth=1.19429V; mpa2u_vov=0.120221V; mpa2u_gmid=14.01681/V; mpa5u_id=5e-06A; mpa5u_vth=1.1944V; mpa5u_vov=0.199541V; mpa5u_gmid=9.324891/V; mpa20u_id=2e-05A; mpa20u_vth=1.19499V; mpa20u_vov=0.420754V; mpa20u_gmid=4.269891/V; mpb2u_id=1.99999e-06A; mpb2u_vth=1.23207V; mpb2u_vov=0.113733V; mpb2u_gmid=12.37021/V; mpb5u_id=4.99997e-06A; mpb5u_vth=1.23212V; mpb5u_vov=0.202815V; mpb5u_gmid=8.428951/V; mpb20u_id=1.99999e-05A; mpb20u_vth=1.2324V; mpb20u_vov=0.439287V; mpb20u_gmid=4.136121/V)
  - sf_27c_3.30v: PASS (mna2u_id=2e-06A; mna2u_vth=0.733528V; mna2u_vov=0.0506598V; mna2u_gmid=15.40331/V; mna5u_id=5e-06A; mna5u_vth=0.733566V; mna5u_vov=0.117948V; mna5u_gmid=11.73911/V; mna20u_id=2e-05A; mna20u_vth=0.733762V; mna20u_vov=0.279019V; mna20u_gmid=6.216671/V; mnb2u_id=2e-06A; mnb2u_vth=0.739325V; mnb2u_vov=0.0652736V; mnb2u_gmid=14.87961/V; mnb5u_id=5e-06A; mnb5u_vth=0.739346V; mnb5u_vov=0.135986V; mnb5u_gmid=11.10421/V; mnb20u_id=2e-05A; mnb20u_vth=0.739451V; mnb20u_vov=0.307475V; mnb20u_gmid=5.898271/V; mpa2u_id=2e-06A; mpa2u_vth=1.05505V; mpa2u_vov=0.154319V; mpa2u_gmid=12.10951/V; mpa5u_id=5e-06A; mpa5u_vth=1.05517V; mpa5u_vov=0.245183V; mpa5u_gmid=8.16871/V; mpa20u_id=2e-05A; mpa20u_vth=1.05577V; mpa20u_vov=0.499954V; mpa20u_gmid=3.648311/V; mpb2u_id=1.99999e-06A; mpb2u_vth=1.10719V; mpb2u_vov=0.135365V; mpb2u_gmid=10.73071/V; mpb5u_id=4.99998e-06A; mpb5u_vth=1.10725V; mpb5u_vov=0.238239V; mpb5u_gmid=7.277391/V; mpb20u_id=1.99999e-05A; mpb20u_vth=1.10753V; mpb20u_vov=0.514025V; mpb20u_gmid=3.524481/V)
  - sf_125c_3.30v: PASS (mna2u_id=2.00001e-06A; mna2u_vth=0.613036V; mna2u_vov=0.0592016V; mna2u_gmid=11.85151/V; mna5u_id=4.99998e-06A; mna5u_vth=0.613075V; mna5u_vov=0.145885V; mna5u_gmid=9.149821/V; mna20u_id=2e-05A; mna20u_vth=0.613273V; mna20u_vov=0.350289V; mna20u_gmid=4.910141/V; mnb2u_id=1.99997e-06A; mnb2u_vth=0.618832V; mnb2u_vov=0.0770635V; mnb2u_gmid=11.49651/V; mnb5u_id=4.99995e-06A; mnb5u_vth=0.618853V; mnb5u_vov=0.167886V; mnb5u_gmid=8.690351/V; mnb20u_id=2e-05A; mnb20u_vth=0.618959V; mnb20u_vov=0.385517V; mnb20u_gmid=4.653811/V; mpa2u_id=2e-06A; mpa2u_vth=0.851391V; mpa2u_vov=0.204994V; mpa2u_gmid=10.0861/V; mpa5u_id=5e-06A; mpa5u_vth=0.851512V; mpa5u_vov=0.312011V; mpa5u_gmid=7.009041/V; mpa20u_id=2e-05A; mpa20u_vth=0.852118V; mpa20u_vov=0.608143V; mpa20u_gmid=3.081731/V; mpb2u_id=1.99999e-06A; mpb2u_vth=0.924546V; mpb2u_vov=0.169287V; mpb2u_gmid=9.29281/V; mpb5u_id=4.99999e-06A; mpb5u_vth=0.924604V; mpb5u_vov=0.287772V; mpb5u_gmid=6.30621/V; mpb20u_id=1.99999e-05A; mpb20u_vth=0.924893V; mpb20u_vov=0.610691V; mpb20u_gmid=2.96461/V)
  - fs_-40c_3.30v: PASS (mna2u_id=2e-06A; mna2u_vth=0.972628V; mna2u_vov=0.0432426V; mna2u_gmid=19.3991/V; mna5u_id=5e-06A; mna5u_vth=0.972666V; mna5u_vov=0.0971113V; mna5u_gmid=14.5941/V; mna20u_id=2e-05A; mna20u_vth=0.97286V; mna20u_vov=0.228298V; mna20u_gmid=7.591741/V; mnb2u_id=2e-06A; mnb2u_vth=0.937841V; mnb2u_vov=0.0557108V; mnb2u_gmid=18.67681/V; mnb5u_id=5e-06A; mnb5u_vth=0.937862V; mnb5u_vov=0.112464V; mnb5u_gmid=13.7591/V; mnb20u_id=2e-05A; mnb20u_vth=0.937966V; mnb20u_vov=0.252V; mnb20u_gmid=7.22251/V; mpa2u_id=2e-06A; mpa2u_vth=1.01686V; mpa2u_vov=0.117871V; mpa2u_gmid=14.19991/V; mpa5u_id=5e-06A; mpa5u_vth=1.01698V; mpa5u_vov=0.195941V; mpa5u_gmid=9.482941/V; mpa20u_id=2e-05A; mpa20u_vth=1.01757V; mpa20u_vov=0.413045V; mpa20u_gmid=4.341861/V; mpb2u_id=1.99999e-06A; mpb2u_vth=1.0653V; mpb2u_vov=0.110078V; mpb2u_gmid=12.60751/V; mpb5u_id=4.99998e-06A; mpb5u_vth=1.06535V; mpb5u_vov=0.197234V; mpb5u_gmid=8.631271/V; mpb20u_id=1.99999e-05A; mpb20u_vth=1.06563V; mpb20u_vov=0.427713V; mpb20u_gmid=4.243911/V)
  - fs_27c_3.30v: PASS (mna2u_id=2e-06A; mna2u_vth=0.890251V; mna2u_vov=0.0507831V; mna2u_gmid=15.38311/V; mna5u_id=5e-06A; mna5u_vth=0.890289V; mna5u_vov=0.118226V; mna5u_gmid=11.71681/V; mna20u_id=2e-05A; mna20u_vth=0.890485V; mna20u_vov=0.279878V; mna20u_gmid=6.196481/V; mnb2u_id=2e-06A; mnb2u_vth=0.855463V; mnb2u_vov=0.0656223V; mnb2u_gmid=14.85521/V; mnb5u_id=5e-06A; mnb5u_vth=0.855484V; mnb5u_vov=0.1365V; mnb5u_gmid=11.07531/V; mnb20u_id=2e-05A; mnb20u_vth=0.855589V; mnb20u_vov=0.308628V; mnb20u_gmid=5.874221/V; mpa2u_id=2e-06A; mpa2u_vth=0.877622V; mpa2u_vov=0.151926V; mpa2u_gmid=12.23331/V; mpa5u_id=5e-06A; mpa5u_vth=0.877741V; mpa5u_vov=0.241592V; mpa5u_gmid=8.282981/V; mpa20u_id=2e-05A; mpa20u_vth=0.878337V; mpa20u_vov=0.492172V; mpa20u_gmid=3.699161/V; mpb2u_id=1.99999e-06A; mpb2u_vth=0.940425V; mpb2u_vov=0.131265V; mpb2u_gmid=10.92491/V; mpb5u_id=4.99999e-06A; mpb5u_vth=0.940482V; mpb5u_vov=0.232023V; mpb5u_gmid=7.442971/V; mpb20u_id=1.99999e-05A; mpb20u_vth=0.940766V; mpb20u_vov=0.501208V; mpb20u_gmid=3.608961/V)
  - fs_125c_3.30v: PASS (mna2u_id=2.00001e-06A; mna2u_vth=0.769759V; mna2u_vov=0.0604432V; mna2u_gmid=11.81531/V; mna5u_id=4.99998e-06A; mna5u_vth=0.769798V; mna5u_vov=0.147593V; mna5u_gmid=9.103741/V; mna20u_id=2e-05A; mna20u_vth=0.769996V; mna20u_vov=0.35363V; mna20u_gmid=4.875611/V; mnb2u_id=1.99997e-06A; mnb2u_vth=0.73497V; mnb2u_vov=0.0783669V; mnb2u_gmid=11.45691/V; mnb5u_id=4.99995e-06A; mnb5u_vth=0.734991V; mnb5u_vov=0.169637V; mnb5u_gmid=8.642961/V; mnb20u_id=2e-05A; mnb20u_vth=0.735097V; mnb20u_vov=0.388833V; mnb20u_gmid=4.619851/V; mpa2u_id=2e-06A; mpa2u_vth=0.673962V; mpa2u_vov=0.202579V; mpa2u_gmid=10.15171/V; mpa5u_id=5e-06A; mpa5u_vth=0.674083V; mpa5u_vov=0.30856V; mpa5u_gmid=7.073821/V; mpa20u_id=2e-05A; mpa20u_vth=0.67469V; mpa20u_vov=0.600923V; mpa20u_gmid=3.108471/V; mpb2u_id=2e-06A; mpb2u_vth=0.757778V; mpb2u_vov=0.16468V; mpb2u_gmid=9.442191/V; mpb5u_id=4.99999e-06A; mpb5u_vth=0.757835V; mpb5u_vov=0.280924V; mpb5u_gmid=6.438181/V; mpb20u_id=2e-05A; mpb20u_vth=0.758124V; mpb20u_vov=0.59669V; mpb20u_gmid=3.026551/V)
  - corner-sensitivity check on `mna5u_vth`: PASS (observed spread 0.359591 over 15 points, required ≥ 0.03)
  - **Overall: PASS**
- **Links**:
  - Testbench: `sim/mos-matching-characterization/testbench/tb_mos_matching.sch`
  - Netlist snapshot: `sim/mos-matching-characterization/netlist-snapshots/20260731-045825-a8c4147.spice`
  - Raw per-corner logs: `sim/mos-matching-characterization/corners/20260731-045825-a8c4147/`
  - Machine-readable record: `sim/mos-matching-characterization/records/20260731-045825-a8c4147.json`
  - Experiment manifest: `sim/mos-matching-characterization/experiment.json`
- **Timestamp / author**: 2026-07-31T04:58:25Z, robb@2amlogic.com
- **Supersedes**: (none)

Written by `sim/bin/corner-run.py`. Append-only: never edit this file — a correction is a new record with a `Supersedes` field (see `sim/README.md`).
