2AMLogic/sky130-bandgap/sim/pnp-characterization/records/20260731-043353-a8c4147.md

# Record 20260731-043353-a8c4147

- **Record ID**: 20260731-043353-a8c4147
- **Experiment**: `pnp-characterization` — Substrate PNP (pnp_05v5) VBE / dVBE vs Ic and temperature
- **Claim**: Issue #4 -- characterizes sky130_fd_pr__pnp_05v5_W0p68L0p68 (small unit) and sky130_fd_pr__pnp_05v5_W3p40L3p40 (large unit) VEB vs collector current (100nA..100uA, half-decade steps) and vs temperature/process corner, plus the PTAT dVBE between the two emitter sizes at matched current. Informs the usable current-density window / effective ideality factor for spec/topology-survey.md and the amplifier offset budget (#9). Supply axis intentionally fixed at nominal 3.30V: both devices are diode-connected (base=collector=0) and biased by ideal DC current sources with no supply-referenced terminal in the DUT, so sweeping supply would not change any result -- see design/device-characterization-summary.md.
- **Netlist provenance**: schematic (`sim/pnp-characterization/testbench/tb_pnp_vbe.sch`)
- **PDK**: sky130A @ open_pdks `c6d73a35f524070e85faff4a6a9eef49553ebc2b` (matches sim/pdk.json pin); models `/Users/rwalters/.volare/sky130A/libs.tech/combined/sky130.lib.spice`
- **Tools**: ngspice-46 : Circuit level simulation program; XSCHEM V3.4.7; Darwin 25.6.0 arm64
- **Repo state**: `a8c4147` on `feature/issue-4` (working tree dirty at run time)
- **Corner matrix run**:
  - Process: tt, ss, ff, sf, fs
  - Temperature: -40 °C, 27 °C, 125 °C
  - Supply: 3.30 V
  - 15 corner point(s) executed
  - Full PVT matrix declared in `experiment.json` (−40/27/125 °C × ±10 % supply × process corners)
- **Statistical convention**: N/A (corner-matrix / bias-ladder characterization, not a distribution claim)
- **Result**:
  - tt_-40c_3.30v: PASS (veb_small_100n=0.638694V; veb_large_100n=0.63324V; dvbe_100n=0.00545338V; veb_small_316n=0.662062V; veb_large_316n=0.656394V; dvbe_316n=0.00566797V; veb_small_1u=0.685856V; veb_large_1u=0.679658V; dvbe_1u=0.00619854V; veb_small_3p16u=0.710871V; veb_large_3p16u=0.703143V; dvbe_3p16u=0.00772765V; veb_small_10u=0.739878V; veb_large_10u=0.727433V; dvbe_10u=0.012445V; veb_small_31p6u=0.781353V; veb_large_31p6u=0.754013V; dvbe_31p6u=0.0273402V; veb_small_100u=0.862446V; veb_large_100u=0.787484V; dvbe_100u=0.0749613V)
  - tt_27c_3.30v: PASS (veb_small_100n=0.48467V; veb_large_100n=0.470275V; dvbe_100n=0.0143955V; veb_small_316n=0.514702V; veb_large_316n=0.500072V; dvbe_316n=0.01463V; veb_small_1u=0.545166V; veb_large_1u=0.529986V; dvbe_1u=0.0151802V; veb_small_3p16u=0.576844V; veb_large_3p16u=0.560115V; dvbe_3p16u=0.0167289V; veb_small_10u=0.612521V; veb_large_10u=0.591056V; dvbe_10u=0.0214654V; veb_small_31p6u=0.660655V; veb_large_31p6u=0.624277V; dvbe_31p6u=0.0363782V; veb_small_100u=0.748407V; veb_large_100u=0.664396V; dvbe_100u=0.0840112V)
  - tt_125c_3.30v: PASS (veb_small_100n=0.261922V; veb_large_100n=0.224407V; dvbe_100n=0.0375147V; veb_small_316n=0.301687V; veb_large_316n=0.263887V; dvbe_316n=0.0378001V; veb_small_1u=0.341905V; veb_large_1u=0.303519V; dvbe_1u=0.0383861V; veb_small_3p16u=0.383326V; veb_large_3p16u=0.343361V; dvbe_3p16u=0.0399654V; veb_small_10u=0.428759V; veb_large_10u=0.384028V; dvbe_10u=0.0447301V; veb_small_31p6u=0.486631V; veb_large_31p6u=0.426963V; dvbe_31p6u=0.0596671V; veb_small_100u=0.584117V; veb_large_100u=0.476805V; dvbe_100u=0.107312V)
  - ss_-40c_3.30v: PASS (veb_small_100n=0.638694V; veb_large_100n=0.63324V; dvbe_100n=0.00545332V; veb_small_316n=0.662062V; veb_large_316n=0.656394V; dvbe_316n=0.00566798V; veb_small_1u=0.685856V; veb_large_1u=0.679658V; dvbe_1u=0.00619847V; veb_small_3p16u=0.710871V; veb_large_3p16u=0.703143V; dvbe_3p16u=0.00772759V; veb_small_10u=0.739878V; veb_large_10u=0.727433V; dvbe_10u=0.012445V; veb_small_31p6u=0.781353V; veb_large_31p6u=0.754013V; dvbe_31p6u=0.0273402V; veb_small_100u=0.862446V; veb_large_100u=0.787485V; dvbe_100u=0.0749612V)
  - ss_27c_3.30v: PASS (veb_small_100n=0.484671V; veb_large_100n=0.470275V; dvbe_100n=0.0143956V; veb_small_316n=0.514702V; veb_large_316n=0.500072V; dvbe_316n=0.01463V; veb_small_1u=0.545167V; veb_large_1u=0.529987V; dvbe_1u=0.0151802V; veb_small_3p16u=0.576844V; veb_large_3p16u=0.560115V; dvbe_3p16u=0.0167289V; veb_small_10u=0.612521V; veb_large_10u=0.591056V; dvbe_10u=0.0214654V; veb_small_31p6u=0.660655V; veb_large_31p6u=0.624277V; dvbe_31p6u=0.0363782V; veb_small_100u=0.748407V; veb_large_100u=0.664396V; dvbe_100u=0.084011V)
  - ss_125c_3.30v: PASS (veb_small_100n=0.261922V; veb_large_100n=0.224407V; dvbe_100n=0.0375146V; veb_small_316n=0.301687V; veb_large_316n=0.263887V; dvbe_316n=0.0378V; veb_small_1u=0.341905V; veb_large_1u=0.30352V; dvbe_1u=0.038386V; veb_small_3p16u=0.383326V; veb_large_3p16u=0.343361V; dvbe_3p16u=0.0399653V; veb_small_10u=0.428759V; veb_large_10u=0.384029V; dvbe_10u=0.04473V; veb_small_31p6u=0.486631V; veb_large_31p6u=0.426964V; dvbe_31p6u=0.059667V; veb_small_100u=0.584117V; veb_large_100u=0.476805V; dvbe_100u=0.107312V)
  - ff_-40c_3.30v: PASS (veb_small_100n=0.638694V; veb_large_100n=0.63324V; dvbe_100n=0.00545342V; veb_small_316n=0.662062V; veb_large_316n=0.656394V; dvbe_316n=0.00566809V; veb_small_1u=0.685856V; veb_large_1u=0.679658V; dvbe_1u=0.00619848V; veb_small_3p16u=0.710871V; veb_large_3p16u=0.703143V; dvbe_3p16u=0.0077277V; veb_small_10u=0.739878V; veb_large_10u=0.727433V; dvbe_10u=0.0124451V; veb_small_31p6u=0.781353V; veb_large_31p6u=0.754013V; dvbe_31p6u=0.0273403V; veb_small_100u=0.862446V; veb_large_100u=0.787484V; dvbe_100u=0.0749613V)
  - ff_27c_3.30v: PASS (veb_small_100n=0.48467V; veb_large_100n=0.470275V; dvbe_100n=0.0143956V; veb_small_316n=0.514702V; veb_large_316n=0.500072V; dvbe_316n=0.01463V; veb_small_1u=0.545166V; veb_large_1u=0.529986V; dvbe_1u=0.0151802V; veb_small_3p16u=0.576844V; veb_large_3p16u=0.560115V; dvbe_3p16u=0.016729V; veb_small_10u=0.612521V; veb_large_10u=0.591056V; dvbe_10u=0.0214655V; veb_small_31p6u=0.660655V; veb_large_31p6u=0.624277V; dvbe_31p6u=0.0363783V; veb_small_100u=0.748407V; veb_large_100u=0.664396V; dvbe_100u=0.0840112V)
  - ff_125c_3.30v: PASS (veb_small_100n=0.261922V; veb_large_100n=0.224407V; dvbe_100n=0.0375147V; veb_small_316n=0.301687V; veb_large_316n=0.263887V; dvbe_316n=0.0378001V; veb_small_1u=0.341905V; veb_large_1u=0.303519V; dvbe_1u=0.0383861V; veb_small_3p16u=0.383326V; veb_large_3p16u=0.343361V; dvbe_3p16u=0.0399655V; veb_small_10u=0.428758V; veb_large_10u=0.384028V; dvbe_10u=0.0447302V; veb_small_31p6u=0.48663V; veb_large_31p6u=0.426963V; dvbe_31p6u=0.0596672V; veb_small_100u=0.584117V; veb_large_100u=0.476805V; dvbe_100u=0.107312V)
  - sf_-40c_3.30v: PASS (veb_small_100n=0.638694V; veb_large_100n=0.63324V; dvbe_100n=0.0054535V; veb_small_316n=0.662062V; veb_large_316n=0.656394V; dvbe_316n=0.00566817V; veb_small_1u=0.685856V; veb_large_1u=0.679657V; dvbe_1u=0.00619866V; veb_small_3p16u=0.710871V; veb_large_3p16u=0.703143V; dvbe_3p16u=0.00772778V; veb_small_10u=0.739878V; veb_large_10u=0.727433V; dvbe_10u=0.0124451V; veb_small_31p6u=0.781353V; veb_large_31p6u=0.754013V; dvbe_31p6u=0.0273404V; veb_small_100u=0.862446V; veb_large_100u=0.787484V; dvbe_100u=0.0749614V)
  - sf_27c_3.30v: PASS (veb_small_100n=0.48467V; veb_large_100n=0.470275V; dvbe_100n=0.0143957V; veb_small_316n=0.514702V; veb_large_316n=0.500071V; dvbe_316n=0.0146301V; veb_small_1u=0.545166V; veb_large_1u=0.529986V; dvbe_1u=0.0151804V; veb_small_3p16u=0.576844V; veb_large_3p16u=0.560115V; dvbe_3p16u=0.0167291V; veb_small_10u=0.612521V; veb_large_10u=0.591055V; dvbe_10u=0.0214656V; veb_small_31p6u=0.660655V; veb_large_31p6u=0.624277V; dvbe_31p6u=0.0363784V; veb_small_100u=0.748407V; veb_large_100u=0.664396V; dvbe_100u=0.0840114V)
  - sf_125c_3.30v: PASS (veb_small_100n=0.261922V; veb_large_100n=0.224407V; dvbe_100n=0.0375148V; veb_small_316n=0.301687V; veb_large_316n=0.263887V; dvbe_316n=0.0378002V; veb_small_1u=0.341905V; veb_large_1u=0.303519V; dvbe_1u=0.0383863V; veb_small_3p16u=0.383326V; veb_large_3p16u=0.343361V; dvbe_3p16u=0.0399656V; veb_small_10u=0.428758V; veb_large_10u=0.384028V; dvbe_10u=0.0447304V; veb_small_31p6u=0.48663V; veb_large_31p6u=0.426963V; dvbe_31p6u=0.0596674V; veb_small_100u=0.584117V; veb_large_100u=0.476805V; dvbe_100u=0.107312V)
  - fs_-40c_3.30v: PASS (veb_small_100n=0.638694V; veb_large_100n=0.63324V; dvbe_100n=0.0054532V; veb_small_316n=0.662062V; veb_large_316n=0.656394V; dvbe_316n=0.00566786V; veb_small_1u=0.685856V; veb_large_1u=0.679658V; dvbe_1u=0.00619834V; veb_small_3p16u=0.710871V; veb_large_3p16u=0.703144V; dvbe_3p16u=0.00772746V; veb_small_10u=0.739878V; veb_large_10u=0.727434V; dvbe_10u=0.0124448V; veb_small_31p6u=0.781353V; veb_large_31p6u=0.754013V; dvbe_31p6u=0.0273401V; veb_small_100u=0.862446V; veb_large_100u=0.787485V; dvbe_100u=0.074961V)
  - fs_27c_3.30v: PASS (veb_small_100n=0.484671V; veb_large_100n=0.470275V; dvbe_100n=0.0143954V; veb_small_316n=0.514702V; veb_large_316n=0.500072V; dvbe_316n=0.0146298V; veb_small_1u=0.545167V; veb_large_1u=0.529987V; dvbe_1u=0.01518V; veb_small_3p16u=0.576844V; veb_large_3p16u=0.560115V; dvbe_3p16u=0.0167287V; veb_small_10u=0.612521V; veb_large_10u=0.591056V; dvbe_10u=0.0214652V; veb_small_31p6u=0.660655V; veb_large_31p6u=0.624277V; dvbe_31p6u=0.036378V; veb_small_100u=0.748408V; veb_large_100u=0.664397V; dvbe_100u=0.0840109V)
  - fs_125c_3.30v: PASS (veb_small_100n=0.261922V; veb_large_100n=0.224408V; dvbe_100n=0.0375144V; veb_small_316n=0.301687V; veb_large_316n=0.263887V; dvbe_316n=0.0377998V; veb_small_1u=0.341906V; veb_large_1u=0.30352V; dvbe_1u=0.0383858V; veb_small_3p16u=0.383327V; veb_large_3p16u=0.343361V; dvbe_3p16u=0.0399651V; veb_small_10u=0.428759V; veb_large_10u=0.384029V; dvbe_10u=0.0447297V; veb_small_31p6u=0.486631V; veb_large_31p6u=0.426964V; dvbe_31p6u=0.0596667V; veb_small_100u=0.584117V; veb_large_100u=0.476806V; dvbe_100u=0.107312V)
  - corner-sensitivity check on `veb_small_1u`: PASS (observed spread 0.343951 over 15 points, required ≥ 0.01)
  - **Overall: PASS**
- **Links**:
  - Testbench: `sim/pnp-characterization/testbench/tb_pnp_vbe.sch`
  - Netlist snapshot: `sim/pnp-characterization/netlist-snapshots/20260731-043353-a8c4147.spice`
  - Raw per-corner logs: `sim/pnp-characterization/corners/20260731-043353-a8c4147/`
  - Machine-readable record: `sim/pnp-characterization/records/20260731-043353-a8c4147.json`
  - Experiment manifest: `sim/pnp-characterization/experiment.json`
- **Timestamp / author**: 2026-07-31T04:33:53Z, robb@2amlogic.com
- **Supersedes**: (none)

Written by `sim/bin/corner-run.py`. Append-only: never edit this file — a correction is a new record with a `Supersedes` field (see `sim/README.md`).
