2AMLogic/sky130-bandgap/sim/resistor-flavor-characterization/records/20260731-044337-a8c4147.md

# Record 20260731-044337-a8c4147

- **Record ID**: 20260731-044337-a8c4147
- **Experiment**: `resistor-flavor-characterization` — Poly resistor flavor sheet-Rs / TC (res_high_po, res_xhigh_po)
- **Claim**: Issue #4 -- characterizes sky130_fd_pr__res_high_po and sky130_fd_pr__res_xhigh_po (the two PDK poly-resistor flavors named in the issue; there is no separate 'precision p+ poly' cell -- res_high_po IS the precision, non-silicided p+ poly flavor, confirmed against the PDK's continuous/models_resistors.spice, no third flavor exists) via the two-length (L=1um, L=20um; W=1um) slope method, which extracts sheet resistance excluding head/contact resistance: Rs = (R(L20)-R(L1))*W/(L20-L1). Process axis covers BOTH the standard tt/ss/ff/sf/fs MOS/BJT corners (confirmed to leave resistor value unchanged -- all five corners include the same continuous/parameters_res_nom.spice) and the PDK's dedicated resistor-value skew corners ll (low) / hh (high), which is where sky130_fd_pr poly-resistor sheet-Rs actually varies (continuous/parameters_res_low.spice / parameters_res_high.spice); see sim/pdk.json's process_corners notes. Informs the resistor-flavor recommendation (PTAT resistor / output ladder / trim network) that spec/topology-survey.md's provisional res_high_po pick should be checked against. Supply axis intentionally fixed at nominal 3.30V: both flavors are biased by an ideal 1uA DC current source with no supply-referenced terminal in the DUT -- see design/device-characterization-summary.md.
- **Netlist provenance**: schematic (`sim/resistor-flavor-characterization/testbench/tb_res_flavors.sch`)
- **PDK**: sky130A @ open_pdks `c6d73a35f524070e85faff4a6a9eef49553ebc2b` (matches sim/pdk.json pin); models `/Users/rwalters/.volare/sky130A/libs.tech/combined/sky130.lib.spice`
- **Tools**: ngspice-46 : Circuit level simulation program; XSCHEM V3.4.7; Darwin 25.6.0 arm64
- **Repo state**: `a8c4147` on `feature/issue-4` (working tree dirty at run time)
- **Corner matrix run**:
  - Process: tt, ss, ff, sf, fs, ll, hh
  - Temperature: -40 °C, 27 °C, 125 °C
  - Supply: 3.30 V
  - 21 corner point(s) executed
  - Full PVT matrix declared in `experiment.json` (−40/27/125 °C × ±10 % supply × process corners)
- **Statistical convention**: N/A for the corner-matrix Rs/TC claim above. Device-mismatch sigma is reported separately in the summary record as a PDK-derived (not simulated) coefficient: sw_mm_sky130_fd_pr__res_high_po / __res_xhigh_po from continuous/models_global.spice, applied as sigma_R/R = coefficient / sqrt(W*L*mult).
- **Result**:
  - tt_-40c_3.30v: PASS (r_highl1=692.982ohm; r_highl20=6688.72ohm; r_xhighl1=2148.8ohm; r_xhighl20=42403ohm)
  - tt_27c_3.30v: PASS (r_highl1=704.532ohm; r_highl20=6876.25ohm; r_xhighl1=2152.97ohm; r_xhighl20=42407.2ohm)
  - tt_125c_3.30v: PASS (r_highl1=729.43ohm; r_highl20=7280.5ohm; r_xhighl1=2125.46ohm; r_xhighl20=42379.7ohm)
  - ss_-40c_3.30v: PASS (r_highl1=685.871ohm; r_highl20=6616.3ohm; r_xhighl1=2148.8ohm; r_xhighl20=42403ohm)
  - ss_27c_3.30v: PASS (r_highl1=697.295ohm; r_highl20=6801.8ohm; r_xhighl1=2152.97ohm; r_xhighl20=42407.2ohm)
  - ss_125c_3.30v: PASS (r_highl1=721.921ohm; r_highl20=7201.64ohm; r_xhighl1=2125.46ohm; r_xhighl20=42379.7ohm)
  - ff_-40c_3.30v: PASS (r_highl1=700.244ohm; r_highl20=6762.73ohm; r_xhighl1=2148.8ohm; r_xhighl20=42403ohm)
  - ff_27c_3.30v: PASS (r_highl1=711.922ohm; r_highl20=6952.35ohm; r_xhighl1=2152.97ohm; r_xhighl20=42407.2ohm)
  - ff_125c_3.30v: PASS (r_highl1=737.097ohm; r_highl20=7361.1ohm; r_xhighl1=2125.46ohm; r_xhighl20=42379.7ohm)
  - sf_-40c_3.30v: PASS (r_highl1=692.982ohm; r_highl20=6688.72ohm; r_xhighl1=2148.8ohm; r_xhighl20=42403ohm)
  - sf_27c_3.30v: PASS (r_highl1=704.532ohm; r_highl20=6876.25ohm; r_xhighl1=2152.97ohm; r_xhighl20=42407.2ohm)
  - sf_125c_3.30v: PASS (r_highl1=729.43ohm; r_highl20=7280.5ohm; r_xhighl1=2125.46ohm; r_xhighl20=42379.7ohm)
  - fs_-40c_3.30v: PASS (r_highl1=692.982ohm; r_highl20=6688.72ohm; r_xhighl1=2148.8ohm; r_xhighl20=42403ohm)
  - fs_27c_3.30v: PASS (r_highl1=704.532ohm; r_highl20=6876.25ohm; r_xhighl1=2152.97ohm; r_xhighl20=42407.2ohm)
  - fs_125c_3.30v: PASS (r_highl1=729.43ohm; r_highl20=7280.5ohm; r_xhighl1=2125.46ohm; r_xhighl20=42379.7ohm)
  - ll_-40c_3.30v: PASS (r_highl1=597.43ohm; r_highl20=5707.64ohm; r_xhighl1=1830.37ohm; r_xhighl20=36046.5ohm)
  - ll_27c_3.30v: PASS (r_highl1=607.274ohm; r_highl20=5867.48ohm; r_xhighl1=1834.02ohm; r_xhighl20=36050.1ohm)
  - ll_125c_3.30v: PASS (r_highl1=628.494ohm; r_highl20=6212.02ohm; r_xhighl1=1809.94ohm; r_xhighl20=36026ohm)
  - hh_-40c_3.30v: PASS (r_highl1=784.902ohm; r_highl20=7610.81ohm; r_xhighl1=2467.24ohm; r_xhighl20=48759.6ohm)
  - hh_27c_3.30v: PASS (r_highl1=798.052ohm; r_highl20=7824.31ohm; r_xhighl1=2471.92ohm; r_xhighl20=48764.3ohm)
  - hh_125c_3.30v: PASS (r_highl1=826.396ohm; r_highl20=8284.53ohm; r_xhighl1=2440.97ohm; r_xhighl20=48733.3ohm)
  - corner-sensitivity check on `r_highl20`: PASS (observed spread 2576.89 over 21 points, required ≥ 500)
  - **Overall: PASS**
- **Links**:
  - Testbench: `sim/resistor-flavor-characterization/testbench/tb_res_flavors.sch`
  - Netlist snapshot: `sim/resistor-flavor-characterization/netlist-snapshots/20260731-044337-a8c4147.spice`
  - Raw per-corner logs: `sim/resistor-flavor-characterization/corners/20260731-044337-a8c4147/`
  - Machine-readable record: `sim/resistor-flavor-characterization/records/20260731-044337-a8c4147.json`
  - Experiment manifest: `sim/resistor-flavor-characterization/experiment.json`
- **Timestamp / author**: 2026-07-31T04:43:37Z, robb@2amlogic.com
- **Supersedes**: (none)

Written by `sim/bin/corner-run.py`. Append-only: never edit this file — a correction is a new record with a `Supersedes` field (see `sim/README.md`).
