2AMLogic/sky130-bandgap/WORK_LOG.md

# Work Log

Merged PRs and closed issues recorded by Guide. Initial history covers the
30-day window beginning 2026-09-07; earlier history remains in GitHub.

## Archives

- [2026-09](work_log/WORK_LOG_2026-09.md)

### 2026-11-13

- **PR #521**: docs: regenerate the characterization report onto the f6eeac7 records, and re-qualify error-amp-offset-mc
- **PR #520**: refactor(sim): one definition of the psrr-injector run orchestration
- **Issue #511** (closed): Dedup verify/explore/build_deck/run_point between the two psrr-injector sim scripts
- **PR #516**: sim: re-qualify the four analysis_steps post-layout benches and psrr-injector-attribution under open_pdks f6eeac7 (DR-021 slice C'+D4)
- **PR #515**: sim: collect error-amp-offset-mc batch reports into a record
- **PR #513**: docs(spec): record slice D3 dispositions in DR-021 and the stale C' batch refusal
- **PR #512**: sim: run the four analysis_steps post-layout benches on the batch fleet
- **PR #508**: sim: re-qualify psrr-injector-candidates under open_pdks f6eeac7 (DR-021 slice D2)
- **PR #507**: test: run emit_klt record-selector guard under sim/tests discovery
- **Issue #514** (closed): error-amp-offset-mc: batch collector has no open tracking issue (DR-021 cites closed #398)
- **Issue #510** (closed): sim: enable --backend batch for the four analysis_steps post-layout benches (fleet runner now accepts them)
- **Issue #506** (closed): Wire orphaned selector test into CI: sim/signoff-envelopes/test_emit_klt_sim_envelopes.py is never run

### 2026-11-12

- **PR #504**: sim: re-qualify trim-lsb-chained under open_pdks f6eeac7 (DR-021 slice D1)
- **PR #501**: sim: re-qualify three post-layout benches under open_pdks f6eeac7 (DR-021 slice C)
- **PR #500**: sim: re-qualify six pre-layout benches under open_pdks f6eeac7 (DR-021 slice B)
- **PR #498**: sim: re-qualify psrr-dc-with-injector under open_pdks f6eeac7 (DR-021 slice)
- **PR #497**: Bump Repo Skills 0.25.10 -> 0.26.1
- **PR #495**: sim: re-qualify startup-stability under open_pdks f6eeac7 (DR-021 index)

### 2026-11-11

- **PR #493**: feat(sim): enable batch backend for the four analysis_steps pre-layout benches
- **Issue #395** (closed): Enable --backend batch for remaining pre-layout corner-run benches (prereq of #370)

### 2026-11-10

- **PR #491**: chore: remove unreferenced guard-review-332 hook replay
- **Issue #485** (closed): Remove docs/guard-review-332 replay: closed one-off Loom hook review, unreferenced

### 2026-11-07

- **PR #487**: docs: attribute pex-native pilot Vref delta to resistor-leg parasitics
- **Issue #486** (closed): Attribute the pex-native pilot's −27.8 mV Vref delta by leg resistance and node voltage
- **PR #483**: Bump Repo Skills 0.25.1 -> 0.25.10

### 2026-11-06

- **PR #480**: feat: native klt pex pilot for output-voltage TC with recorded 15-corner result
- **PR #478**: fix: skip already-tracked bytes when publishing sim evidence
- **PR #477**: docs: add inert guard replay report and script for write-confinement review
- **Issue #476** (closed): publish_corner_evidence: skip staged files whose bytes are already tracked in git
- **Issue #335** (closed): Produce native klt pex comparison evidence for T1 item 7
- **Issue #332** (closed): Guard decision review: Review historical variable resolution for scoped scratch writes
- **PR #473**: chore(layout): run ERC flow from shared layout venv, drop separate klt pin
- **Issue #466** (closed): Consolidate ERC klt pin into the main layout venv (both pins now ==0.8.0)

### 2026-11-05

- **PR #471**: sim: add --batch-resume pass-through to the untrimmed MC harness
- **PR #470**: sim: add batch max-concurrent-jobs throttle and record throttled N=20 smoke attempt
- **PR #469**: sim: record second N=20 batch smoke attempt as failure evidence

### 2026-11-04

- **PR #463**: fix(sim): netlist testbenches via klt netlist instead of raw xschem
- **Issue #442** (closed): Replace raw-xschem netlist_with_xschem in corner-run.py with klt netlist
- **PR #465**: sim: record failed N=20 batch smoke run (fleet capacity losses)

### 2026-10-31

- **PR #461**: Bump Repo Skills 0.24.7 -> 0.25.1

### 2026-10-28

- **PR #457**: fix: select item-5 corner records by netlist match; re-mint 8a from main's injector
- **Issue #456** (closed): T1 item 5 (Full corner verification): re-mint row 8a startup-stability from a record of main's injector, not the DR-018 three-high candidate
- **PR #455**: chore: move superseded bandgap-core report GDS to artifact store
- **Issue #440** (closed): Prune GDS blobs from superseded bandgap-core report runs
- **PR #452**: fix(layout): snap drawn bus rects to the 5 nm grid for DRC-clean routed flow under klt 0.8.0
- **Issue #448** (closed): Bump klayout-tools pin 0e2362bda730, acb0ae6c11e6 → 0.8.0

### 2026-10-27

- **PR #449**: build: pin klayout-tools==0.8.0 in layout requirements
- **PR #438**: feat(sim): collect batch Monte Carlo reports into the untrimmed-Vref record
- **Issue #437** (closed): monte-carlo-untrimmed: implement --backend batch record collection (blocks #435)
- **PR #439**: feat(signoff): cite minted klt sim envelopes for T1 item 5
- **Issue #434** (closed): T1 item 5 (Full corner verification): cite klt sim envelopes for every DR-005 ratified row

### 2026-10-23

- **PR #431**: feat(layout): publish routed-flow outputs to the artifact store
- **Issue #426** (closed): Adopt the artifact store for new layout/bandgap-core report runs
- **PR #429**: refactor(layout): drop unused mos_pad and fmt_findings helpers
- **Issue #428** (closed): Remove unused mos_pad() and fmt_findings() from layout/bin
- **PR #427**: feat(sim): store new corner evidence in the artifact store, commit manifests only
- **Issue #424** (closed): Adopt the common artifact store for sim evidence (manifests in git, bytes via klt artifact)

### 2026-10-22

- **PR #422**: feat: compute n-well ties in ERC supply spec on klt 0.7.0, item 11 met
- **Issue #389** (closed): T1 item 11: declare both nwell tie classes with the new well-side box selectors (klayout-tools#2552) and re-mint ERC
- **PR #419**: signoff: cite a klt 0.7.0 LVS report for T1 item 4 and pin item 11's LVS half
- **Issue #388** (closed): T1 item 4: mint a hash-pinned LVS report now that klayout-tools#2374 is fixed, with a determinism re-measure
- **PR #417**: fix(signoff): regenerate stale attestation artifacts after PDK re-pin
- **Issue #416** (closed): CI red on main at 87e95da: attest_inventories tests and signoff freshness (T1 item 11 citation drift)
- **PR #390**: feat(signoff): attest T1 items 1, 2, 9, 10 on klt 0.7.0
- **Issue #387** (closed): T1 items 1, 2, 9, 10: move the grader to klt 0.7.0 and cite artifact-anchored inventory envelopes

### 2026-10-21

- **PR #413**: Bump Repo Skills 0.24.3 -> 0.24.7
- **PR #412**: refactor(sim): share psrr-injector batch helpers in sim_common
- **Issue #410** (closed): Dedup batch-backend helpers between the two psrr-injector sim scripts
- **PR #409**: feat(sim): add --backend batch and --dry-run to psrr-injector-attribution
- **PR #408**: feat(sim): build klt Monte Carlo batch requests for monte-carlo-untrimmed
- **PR #407**: refactor(sim): reuse batch_sim.sha256_file in run_trim_lsb_chained
- **PR #406**: feat(sim): build klt Monte Carlo batch requests for error-amp-offset-mc
- **PR #405**: feat(sim): dry-run batch requests for meas post-layout benches, refuse real runs until the runner supports analysis_steps
- **PR #399**: feat(sim): batch backend for the translatable post-layout runners
- **PR #392**: chore(layout): prune 8 redundant trivial-cell report runs, fix README current-record pointer
- **Issue #404** (closed): Dedup sha256_file(): run_trim_lsb_chained.py reimplements batch_sim's canonical helper
- **Issue #398** (closed): Batch backend for the remaining post-layout and MC/offset/attribution runners
- **Issue #396** (closed): Add --backend batch to post-layout, MC and attribution runners (prereq of #370)
- **Issue #381** (closed): Prune 12 unreferenced trivial-cell report runs; fix stale README pointer

### 2026-10-20

- **PR #403**: chore: remove stale tracked manifest.json.tmp and gitignore it
- **PR #402**: ci: pin signoff job Python to 3.11
- **PR #397**: feat(sim): batch backend for psrr-dc and quiescent-current; hold meas benches on runner klt
- **Issue #401** (closed): CI: signoff job red on main — klayout sdist build on unpinned python 3.x
- **Issue #400** (closed): Remove stale tracked .loom/manifest.json.tmp (interrupted-install leftover)
- **PR #373**: build(sim): re-pin PDK to open_pdks f6eeac7 via ciel with SOURCES revision check
- **Issue #369** (closed): Re-pin open_pdks to f6eeac7 (ciel) — fleet retires volare c6d73a3

### 2026-10-17

- **PR #385**: refactor(layout): move shared constants to layout_common to break bus_routing import cycle
- **Issue #384** (closed): Break gen_bandgap_routed <-> bus_routing import cycle: drop sys.modules alias and deferred imports
- **PR #380**: refactor(sim): share corner_id/matrix/band-min loader/run_all across psrr-injector scripts
- **Issue #379** (closed): Dedup corner_id/matrix/band-min loader/run_all between the two psrr-injector sim scripts

### 2026-10-16

- **PR #375**: Bump Repo Skills 0.24.1 -> 0.24.3

### 2026-10-15

- **PR #371**: docs(spec): DR-020 MPC2-on-VSENSE injector screen and mpc2_vs bench variants
- **PR #365**: docs(sim): shard batch PSRR screen requests and record mngq failing the 60 dB floor
- **PR #366**: feat(sim): shard batch requests over remote.hosts to fit the fleet job ceiling
- **Issue #364** (closed): sim: shard PSRR injector screen batch requests across remote hosts (15-unit requests exceed the 3600 s fleet job ceiling)
- **PR #362**: feat(sim): run the PSRR injector screen on the batch fleet
- **Issue #361** (closed): Make the PSRR injector candidate screen submittable via the klt sim batch path
- **PR #360**: docs(sim): record three-high injector stack failing startup-stability at 125C (DR-018)
- **PR #358**: docs(sim): VBE-raised NG clamp restores window-edge eviction current (DR-017)
- **PR #357**: docs(sim): record MNG clamp eviction-loss mechanism and add per-node injector probe mode
- **PR #356**: docs(sim): MNG clamp and weak reference stack fail injector eviction floor at 27C corners (DR-015)
- **PR #354**: sim: route startup-stability 45-corner matrix through Spot batch; live run 45/45 PASS (#320)
- **Issue #320** (closed): Route startup-stability’s full 45-corner regression through the Spot batch backend
- **PR #353**: Bump Repo Skills 0.19.5 -> 0.24.1
- **PR #352**: loom: unpin verdict-staleness-guard.sh and forge-helpers test (2am#4345 Q7)
- **PR #351**: ci(pdk-smoke): build xschem 3.4.7 from source -- apt's 3.4.4 leaves sky130 expr() attrs unevaluated (nightly red 74/74)

### 2026-10-08

- **PR #348**: README: complete Layout tree (#344)
- **Issue #344** (closed): README Layout section omits signoff, CI scripts, docs, ratification and reuse lock
- **PR #347**: sim/README: move per-bench record history out of runner-bypass table (#339)
- **Issue #339** (closed): sim/README.md experiments table embeds per-bench current-record verdicts that go stale
- **PR #346**: ci: widen syntax and JSON lint coverage (#343)
- **Issue #343** (closed): Widen CI syntax and JSON lint coverage beyond hand-listed files
- **PR #345**: reuse: record error_amp as kept in-tree via DR-014
- **Issue #337** (closed): Resolve reuse.lock.json error_amp 'evaluate' entry now that sky130-opamp has answered
- **PR #342**: signoff: single source of truth for klt grader pin (#338)
- **Issue #338** (closed): Consolidate duplicated klt grader pin and identity assertion into one source of truth
- **Issue #334** (closed): Qualify untrimmed 3-sigma accuracy separately from the Monte Carlo sanity floor
- **PR #340**: sim: derived DR-005 3-sigma qualification of untrimmed MC, separate from sanity floor (#334)
- **Issue #333** (closed): Grade the literal DR-005 trim range separately from DR-002 engineering checks
- **PR #336**: Grade literal DR-005 trim range separately from DR-002 engineering checks (#333)
- **Issue #327** (closed): Refresh trim-network evidence (trim-lsb-chained bench) against the current n_r2=51 design
- **PR #331**: Refresh trim-lsb-chained evidence at n_r2=51 (all DR-002 criteria PASS)
- **PR #329**: docs: compact README status scoreboard (8 spec rows)
- **Issue #328** (closed): README status narrative is a hand-maintained changelog that contradicts itself (seven vs eight spec rows)
- **PR #326**: sim: route startup-stability matrix through klt sim batch backend (#320; live run blocked by fleet klt pin)

### 2026-10-03

- **PR #322**: sim(psrr-injector-candidates): m_ref/m_pnp knobs closed for the hot corner; DR-013 (#315 partial)

### 2026-10-02

- **PR #321**: sim(psrr-injector-candidates): screen non-resize injector PSRR fixes; the three-high stack dies on startup margin
- **Issue #318** (closed): Dedup load_base_body(): run_psrr_injector_attribution.py reimplements sim_common's canonical helper
- **PR #319**: refactor(psrr-injector-attribution): delegate base-body load to sim_common's canonical helper
- **PR #317**: docs(report): transcribe #306's measured MPC1/MPC2 attribution into characterization rows 4b/4d/4e
- **PR #316**: sim(psrr-injector-attribution): identify MPC1/MPC2 as dominant PSRR contributor (#306)

### 2026-10-01

- **Issue #313** (closed): Dedup csv_list/csv_floats: post_layout_common.py reimplements corner-run.py's CSV parsers
- **PR #314**: Dedup csv_list/csv_floats: route post_layout_common.py through sim_common.py

### 2026-09-24

- **Issue #303** (closed): startup-ramp + post-layout: re-run the post-#284 manifest over the full 45-point matrix (the #284 records are 10- and 4-point subsets, host-capacity-limited)
- **Issue #299** (closed): Rows 8b/8d: the post-layout startup benches double-count the injector now that it is drawn — they need their own testbench
- **PR #311**: Rows 8b/8d: give the post-layout startup benches their own DUT shape, re-run, and re-grade
- **Issue #308** (closed): sim/bin/corner-run.py: add a -j parallel-corner mode so slow hosts stop forcing subset records
- **PR #310**: sim: add -j/--jobs concurrent-corner mode to corner-run.py
- **Issue #312** (closed): sim/tests/ is not run by CI — npm run check:ci only discovers layout/tests

### 2026-09-23

- **PR #309**: sim(startup-ramp): re-run the full 45-point matrix on the post-#284 manifest
- **Issue #300** (closed): PSRR post-layout FAILs 25/45 (22.75 dB worst vs DR-006's 60 dB floor) once the startup injector is drawn into the composed cell
- **PR #307**: sim(psrr): add schematic-level injector PSRR bench; cause is design, not extraction
- **Issue #284** (closed): Startup convergence-spread FAILs 13/45 (schematic) and 16/45 (post-layout), both worsened by #193's resize — untracked
- **PR #305**: sim(startup-ramp): gate vref convergence directly and disposition the vref_spread FAILs under DR-010
- **Issue #302** (closed): Signoff hygiene after #285: re-pin T1 items 3/11 to the injector-inclusive layout record, plus two doc-rendering artifacts
- **PR #304**: fix(signoff): re-pin T1 items 3/11 to injector-inclusive layout
- **Issue #285** (closed): The startup injector has no layout, so the composed cell omits it — item 2 and item 7 cannot be claimed complete
- **PR #301**: layout: draw the startup injector into the composed cell; re-run the post-layout suite against it
- **Issue #288** (closed): klt lvs mismatch-count regression (0->12) + leaked absolute path in klt-yield evidence block items 4 and 6 from the T1 signoff manifest
- **PR #298**: fix(evidence): repo-relative klt yield paths; measure the klt lvs combine flake
- **Issue #283** (closed): Post-layout row 1b is an artifact FAIL from klayout-tools#800, fixed upstream 2026-08-12 — bump klt and re-grade
- **PR #297**: Row 1b post-layout FAIL: klayout-tools#800 was closed not-planned (not fixed) — real, still-open cause is klayout-tools#2359
- **Issue #292** (closed): signoff: CI does not detect a change to the artifact a manifest pin describes (input_verified is null on every citation)
- **PR #296**: signoff: re-hash the artifact behind every manifest pin in CI (#292)
- **Issue #286** (closed): 2am: reuse rule 9 — in-tree error amplifier duplicates sibling canary sky130-opamp — add reuse.lock.json in_tree entry (evaluate), then adopt or record
- **PR #294**: chore: add reuse.lock.json in_tree entry for error_amp (2am rule 9)
- **Issue #293** (closed): README: embed the fleet burndown chart (one line)
- **PR #295**: README: embed the fleet burndown chart
- **Issue #281** (closed): T1 item 11 (power delivery, structural): no klt erc supply spec or report in this repo
- **PR #290**: layout: klt erc supply spec + report for T1 item 11 (power delivery, structural)

### 2026-09-22

- **Issue #282** (closed): Commit a klt signoff block manifest so this block's T1 state is graded, not hand-read
- **PR #289**: signoff: commit a klt signoff block manifest for this block's T1 state

### 2026-09-14

- **Issue #179** (closed): OPERATOR QUESTION: if the core's TC floor stays above the ratified < 50 ppm/°C, scope curvature correction or stand non-qualifying on item 5?
- **PR #197**: spec: propose DR-009 — TC floor disposition (recommend disclosed-FAIL, not spec relaxation)
- **PR #240**: fix(ratification): remove unwrapped private-repo reference from market-key/SKILL.md
