2AMLogic/sky130-bandgap/layout/bandgap-core/reports/20260923-070209-dbd57a9/bandgap_core_routed.extract.spice

* extracted by klt extract --deck sky130

* cell bandgap_core_routed
* pin D1
* pin D2
* pin GDRV
* pin NE
* pin NG
* pin PN
* pin TAIL
* pin VA
* pin VB
* pin VBQ
* pin VDD
* pin VOUT
* pin VSS
.SUBCKT bandgap_core_routed D1 D2 GDRV NE NG PN TAIL VA VB VBQ VDD VOUT VSS
* device instance $1 r0 *1 180.13,52.67 nfet
M$1 VSS D1 D1 VSS nfet L=20U W=8U AS=3.36P AD=3.36P PS=16.84U PD=16.84U
* device instance $2 r0 *1 201.37,52.67 nfet
M$2 VSS D2 D2 VSS nfet L=20U W=8U AS=3.36P AD=3.36P PS=16.84U PD=16.84U
* device instance $3 r0 *1 222.61,52.67 nfet
M$3 VSS D1 D1 VSS nfet L=20U W=8U AS=3.36P AD=3.36P PS=16.84U PD=16.84U
* device instance $4 r0 *1 243.85,52.67 nfet
M$4 VSS D2 D2 VSS nfet L=20U W=8U AS=3.36P AD=3.36P PS=16.84U PD=16.84U
* device instance $5 r0 *1 180.13,61.49 nfet
M$5 VSS D2 D2 VSS nfet L=20U W=8U AS=3.36P AD=3.36P PS=16.84U PD=16.84U
* device instance $6 r0 *1 201.37,61.49 nfet
M$6 VSS D1 D1 VSS nfet L=20U W=8U AS=3.36P AD=3.36P PS=16.84U PD=16.84U
* device instance $7 r0 *1 222.61,61.49 nfet
M$7 VSS D2 D2 VSS nfet L=20U W=8U AS=3.36P AD=3.36P PS=16.84U PD=16.84U
* device instance $8 r0 *1 243.85,61.49 nfet
M$8 VSS D1 D1 VSS nfet L=20U W=8U AS=3.36P AD=3.36P PS=16.84U PD=16.84U
* device instance $9 r0 *1 208.02,105.9 nfet
M$9 VSS D2 PN VSS nfet L=20U W=8U AS=3.36P AD=3.36P PS=16.84U PD=16.84U
* device instance $10 r0 *1 229.26,105.9 nfet
M$10 VSS D1 GDRV VSS nfet L=20U W=8U AS=3.36P AD=3.36P PS=16.84U PD=16.84U
* device instance $11 r0 *1 250.5,105.9 nfet
M$11 VSS D2 PN VSS nfet L=20U W=8U AS=3.36P AD=3.36P PS=16.84U PD=16.84U
* device instance $12 r0 *1 271.74,105.9 nfet
M$12 VSS D1 GDRV VSS nfet L=20U W=8U AS=3.36P AD=3.36P PS=16.84U PD=16.84U
* device instance $13 r0 *1 208.02,114.72 nfet
M$13 VSS D1 GDRV VSS nfet L=20U W=8U AS=3.36P AD=3.36P PS=16.84U PD=16.84U
* device instance $14 r0 *1 229.26,114.72 nfet
M$14 VSS D2 PN VSS nfet L=20U W=8U AS=3.36P AD=3.36P PS=16.84U PD=16.84U
* device instance $15 r0 *1 250.5,114.72 nfet
M$15 VSS D1 GDRV VSS nfet L=20U W=8U AS=3.36P AD=3.36P PS=16.84U PD=16.84U
* device instance $16 r0 *1 271.74,114.72 nfet
M$16 VSS D2 PN VSS nfet L=20U W=8U AS=3.36P AD=3.36P PS=16.84U PD=16.84U
* device instance $17 r0 *1 0.92,144.06 nfet
M$17 VDD VOUT GDRV VSS nfet L=1U W=4U AS=1.68P AD=1.68P PS=8.84U PD=8.84U
* device instance $18 r0 *1 103.77,173.34 nfet
M$18 GDRV NG VSS VSS nfet L=0.5U W=10U AS=4.2P AD=4.2P PS=20.84U PD=20.84U
* device instance $19 r0 *1 18.51,173.34 nfet
M$19 NG VOUT NE VSS nfet L=0.5U W=48U AS=20.16P AD=20.16P PS=96.84U PD=96.84U
* device instance $20 r0 *1 67.62,46.67 pfet
M$20 D2 VA TAIL VDD pfet L=10U W=20U AS=8.4P AD=8.4P PS=40.84U PD=40.84U
* device instance $21 r0 *1 78.86,46.67 pfet
M$21 D1 VB TAIL VDD pfet L=10U W=20U AS=8.4P AD=8.4P PS=40.84U PD=40.84U
* device instance $22 r0 *1 90.1,46.67 pfet
M$22 D2 VA TAIL VDD pfet L=10U W=20U AS=8.4P AD=8.4P PS=40.84U PD=40.84U
* device instance $23 r0 *1 101.34,46.67 pfet
M$23 D1 VB TAIL VDD pfet L=10U W=20U AS=8.4P AD=8.4P PS=40.84U PD=40.84U
* device instance $24 r0 *1 112.58,46.67 pfet
M$24 D2 VA TAIL VDD pfet L=10U W=20U AS=8.4P AD=8.4P PS=40.84U PD=40.84U
* device instance $25 r0 *1 123.82,46.67 pfet
M$25 D1 VB TAIL VDD pfet L=10U W=20U AS=8.4P AD=8.4P PS=40.84U PD=40.84U
* device instance $26 r0 *1 135.06,46.67 pfet
M$26 D2 VA TAIL VDD pfet L=10U W=20U AS=8.4P AD=8.4P PS=40.84U PD=40.84U
* device instance $27 r0 *1 146.3,46.67 pfet
M$27 D1 VB TAIL VDD pfet L=10U W=20U AS=8.4P AD=8.4P PS=40.84U PD=40.84U
* device instance $28 r0 *1 39.4,61.49 pfet
M$28 TAIL GDRV VDD VDD pfet L=2U W=8U AS=3.36P AD=3.36P PS=16.84U PD=16.84U
* device instance $29 r0 *1 39.4,52.67 pfet
M$29 VOUT GDRV VDD VDD pfet L=2U W=8U AS=3.36P AD=3.36P PS=16.84U PD=16.84U
* device instance $30 r0 *1 42.64,61.49 pfet
M$30 VOUT GDRV VDD VDD pfet L=2U W=8U AS=3.36P AD=3.36P PS=16.84U PD=16.84U
* device instance $31 r0 *1 42.64,52.67 pfet
M$31 TAIL GDRV VDD VDD pfet L=2U W=8U AS=3.36P AD=3.36P PS=16.84U PD=16.84U
* device instance $32 r0 *1 67.62,67.49 pfet
M$32 D1 VB TAIL VDD pfet L=10U W=20U AS=8.4P AD=8.4P PS=40.84U PD=40.84U
* device instance $33 r0 *1 78.86,67.49 pfet
M$33 D2 VA TAIL VDD pfet L=10U W=20U AS=8.4P AD=8.4P PS=40.84U PD=40.84U
* device instance $34 r0 *1 90.1,67.49 pfet
M$34 D1 VB TAIL VDD pfet L=10U W=20U AS=8.4P AD=8.4P PS=40.84U PD=40.84U
* device instance $35 r0 *1 101.34,67.49 pfet
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
R$240 \$163 \$164 VSS 2003.841367 res_high_po
* device instance $241 r0 *1 215.15,13.1 res_high_po
R$241 \$164 \$165 VSS 2003.841367 res_high_po
* device instance $242 r0 *1 221.49,13.1 res_high_po
R$242 \$165 VBQ VSS 2003.841367 res_high_po
.ENDS bandgap_core_routed
