2AMLogic/sky130-bandgap/sim/pex-native/records/20261106-pilot/pex/measure/extracted/measure-extracted/v3.63/netlist.cir

* pex-native batch netlist -- generated, do not edit
.param vsup=3.63
.option wnflag=1
.option reltol=1e-6
.option vntol=1e-9
.option abstol=1e-15
V1 VDD 0 'vsup'
.save i(v1)
XBG VREF GDRV VDD 0 bandgap_core
.nodeset v(vref)=1.2 v(gdrv)=2.2

.subckt bandgap_core VOUT GDRV VDD VSS
XCORE D1_INT D2_INT GDRV NE_INT NG_INT PN_INT TAIL_INT VA_INT VB_INT VBQ_INT VDD VOUT VSS bandgap_core_routed
.ends bandgap_core

.SUBCKT bandgap_core_routed D1 D2 GDRV NE NG PN TAIL VA VB VBQ VDD VOUT VSS
* device instance $1 r0 *1 180.13,52.67 nfet
X$1 VSS__t190 D1__t5 D1__t10 VSS__t169 sky130_fd_pr__nfet_g5v0d10v5 L=20 W=8 AS=3.36 AD=3.36 PS=16.84 PD=16.84 nrd=0.036250 nrs=0.036250 nf=1 mult=1 sa=0 sb=0 sd=0
* device instance $2 r0 *1 201.37,52.67 nfet
X$2 VSS__t199 D2__t7 D2__t10 VSS__t170 sky130_fd_pr__nfet_g5v0d10v5 L=20 W=8 AS=3.36 AD=3.36 PS=16.84 PD=16.84 nrd=0.036250 nrs=0.036250 nf=1 mult=1 sa=0 sb=0 sd=0
* device instance $3 r0 *1 222.61,52.67 nfet
X$3 VSS__t200 D1__t3 D1__t8 VSS__t171 sky130_fd_pr__nfet_g5v0d10v5 L=20 W=8 AS=3.36 AD=3.36 PS=16.84 PD=16.84 nrd=0.036250 nrs=0.036250 nf=1 mult=1 sa=0 sb=0 sd=0
* device instance $4 r0 *1 243.85,52.67 nfet
X$4 VSS__t201 D2__t8 D2__t11 VSS__t172 sky130_fd_pr__nfet_g5v0d10v5 L=20 W=8 AS=3.36 AD=3.36 PS=16.84 PD=16.84 nrd=0.036250 nrs=0.036250 nf=1 mult=1 sa=0 sb=0 sd=0
* device instance $5 r0 *1 180.13,61.49 nfet
X$5 VSS__t202 D2__t2 D2__t1 VSS__t173 sky130_fd_pr__nfet_g5v0d10v5 L=20 W=8 AS=3.36 AD=3.36 PS=16.84 PD=16.84 nrd=0.036250 nrs=0.036250 nf=1 mult=1 sa=0 sb=0 sd=0
* device instance $6 r0 *1 201.37,61.49 nfet
X$6 VSS__t203 D1__t4 D1__t9 VSS__t174 sky130_fd_pr__nfet_g5v0d10v5 L=20 W=8 AS=3.36 AD=3.36 PS=16.84 PD=16.84 nrd=0.036250 nrs=0.036250 nf=1 mult=1 sa=0 sb=0 sd=0
* device instance $7 r0 *1 222.61,61.49 nfet
X$7 VSS__t204 D2__t9 D2__t12 VSS__t175 sky130_fd_pr__nfet_g5v0d10v5 L=20 W=8 AS=3.36 AD=3.36 PS=16.84 PD=16.84 nrd=0.036250 nrs=0.036250 nf=1 mult=1 sa=0 sb=0 sd=0
* device instance $8 r0 *1 243.85,61.49 nfet
X$8 VSS__t205 D1__t6 D1__t11 VSS__t176 sky130_fd_pr__nfet_g5v0d10v5 L=20 W=8 AS=3.36 AD=3.36 PS=16.84 PD=16.84 nrd=0.036250 nrs=0.036250 nf=1 mult=1 sa=0 sb=0 sd=0
* device instance $9 r0 *1 208.02,105.9 nfet
X$9 VSS__t193 D2__t3 PN__t1 VSS__t177 sky130_fd_pr__nfet_g5v0d10v5 L=20 W=8 AS=3.36 AD=3.36 PS=16.84 PD=16.84 nrd=0.036250 nrs=0.036250 nf=1 mult=1 sa=0 sb=0 sd=0
* device instance $10 r0 *1 229.26,105.9 nfet
X$10 VSS__t206 D1__t7 GDRV__t24 VSS__t178 sky130_fd_pr__nfet_g5v0d10v5 L=20 W=8 AS=3.36 AD=3.36 PS=16.84 PD=16.84 nrd=0.036250 nrs=0.036250 nf=1 mult=1 sa=0 sb=0 sd=0
* device instance $11 r0 *1 250.5,105.9 nfet
X$11 VSS__t194 D2__t4 PN__t2 VSS__t179 sky130_fd_pr__nfet_g5v0d10v5 L=20 W=8 AS=3.36 AD=3.36 PS=16.84 PD=16.84 nrd=0.036250 nrs=0.036250 nf=1 mult=1 sa=0 sb=0 sd=0
* device instance $12 r0 *1 271.74,105.9 nfet
X$12 VSS__t192 D1__t0 GDRV__t21 VSS__t180 sky130_fd_pr__nfet_g5v0d10v5 L=20 W=8 AS=3.36 AD=3.36 PS=16.84 PD=16.84 nrd=0.036250 nrs=0.036250 nf=1 mult=1 sa=0 sb=0 sd=0
* device instance $13 r0 *1 208.02,114.72 nfet
X$13 VSS__t195 D1__t1 GDRV__t22 VSS__t181 sky130_fd_pr__nfet_g5v0d10v5 L=20 W=8 AS=3.36 AD=3.36 PS=16.84 PD=16.84 nrd=0.036250 nrs=0.036250 nf=1 mult=1 sa=0 sb=0 sd=0
* device instance $14 r0 *1 229.26,114.72 nfet
X$14 VSS__t196 D2__t5 PN__t3 VSS__t182 sky130_fd_pr__nfet_g5v0d10v5 L=20 W=8 AS=3.36 AD=3.36 PS=16.84 PD=16.84 nrd=0.036250 nrs=0.036250 nf=1 mult=1 sa=0 sb=0 sd=0
* device instance $15 r0 *1 250.5,114.72 nfet
X$15 VSS__t197 D1__t2 GDRV__t23 VSS__t183 sky130_fd_pr__nfet_g5v0d10v5 L=20 W=8 AS=3.36 AD=3.36 PS=16.84 PD=16.84 nrd=0.036250 nrs=0.036250 nf=1 mult=1 sa=0 sb=0 sd=0
* device instance $16 r0 *1 271.74,114.72 nfet
X$16 VSS__t198 D2__t6 PN__t4 VSS__t184 sky130_fd_pr__nfet_g5v0d10v5 L=20 W=8 AS=3.36 AD=3.36 PS=16.84 PD=16.84 nrd=0.036250 nrs=0.036250 nf=1 mult=1 sa=0 sb=0 sd=0
* device instance $17 r0 *1 0.92,144.06 nfet
X$17 VDD__t5 VOUT__t2 GDRV__t2 VSS__t185 sky130_fd_pr__nfet_g5v0d10v5 L=1 W=4 AS=1.68 AD=1.68 PS=8.84 PD=8.84 nrd=0.072500 nrs=0.072500 nf=1 mult=1 sa=0 sb=0 sd=0
* device instance $18 r0 *1 103.77,173.34 nfet
X$18 GDRV__t5 NG__t3 VSS__t191 VSS__t186 sky130_fd_pr__nfet_g5v0d10v5 L=0.5 W=10 AS=4.2 AD=4.2 PS=20.84 PD=20.84 nrd=0.029000 nrs=0.029000 nf=1 mult=1 sa=0 sb=0 sd=0
* device instance $19 r0 *1 18.51,173.34 nfet
X$19 NG__t0 VOUT__t3 NE__t0 VSS__t187 sky130_fd_pr__nfet_g5v0d10v5 L=0.5 W=48 AS=20.16 AD=20.16 PS=96.84 PD=96.84 nrd=0.006042 nrs=0.006042 nf=1 mult=1 sa=0 sb=0 sd=0
* device instance $20 r0 *1 67.62,46.67 pfet
X$20 D2__t0 VA__t1 TAIL__t2 VDD__t57 sky130_fd_pr__pfet_g5v0d10v5 L=10 W=20 AS=8.4 AD=8.4 PS=40.84 PD=40.84 nrd=0.014500 nrs=0.014500 nf=1 mult=1 sa=0 sb=0 sd=0
* device instance $21 r0 *1 78.86,46.67 pfet
X$21 D1__t14 VB__t2 TAIL__t8 VDD__t63 sky130_fd_pr__pfet_g5v0d10v5 L=10 W=20 AS=8.4 AD=8.4 PS=40.84 PD=40.84 nrd=0.014500 nrs=0.014500 nf=1 mult=1 sa=0 sb=0 sd=0
* device instance $22 r0 *1 90.1,46.67 pfet
X$22 D2__t16 VA__t5 TAIL__t7 VDD__t62 sky130_fd_pr__pfet_g5v0d10v5 L=10 W=20 AS=8.4 AD=8.4 PS=40.84 PD=40.84 nrd=0.014500 nrs=0.014500 nf=1 mult=1 sa=0 sb=0 sd=0
* device instance $23 r0 *1 101.34,46.67 pfet
X$23 D1__t13 VB__t1 TAIL__t6 VDD__t61 sky130_fd_pr__pfet_g5v0d10v5 L=10 W=20 AS=8.4 AD=8.4 PS=40.84 PD=40.84 nrd=0.014500 nrs=0.014500 nf=1 mult=1 sa=0 sb=0 sd=0
* device instance $24 r0 *1 112.58,46.67 pfet
X$24 D2__t15 VA__t4 TAIL__t5 VDD__t60 sky130_fd_pr__pfet_g5v0d10v5 L=10 W=20 AS=8.4 AD=8.4 PS=40.84 PD=40.84 nrd=0.014500 nrs=0.014500 nf=1 mult=1 sa=0 sb=0 sd=0
* device instance $25 r0 *1 123.82,46.67 pfet
X$25 D1__t12 VB__t0 TAIL__t4 VDD__t59 sky130_fd_pr__pfet_g5v0d10v5 L=10 W=20 AS=8.4 AD=8.4 PS=40.84 PD=40.84 nrd=0.014500 nrs=0.014500 nf=1 mult=1 sa=0 sb=0 sd=0
* device instance $26 r0 *1 135.06,46.67 pfet
X$26 D2__t14 VA__t3 TAIL__t3 VDD__t58 sky130_fd_pr__pfet_g5v0d10v5 L=10 W=20 AS=8.4 AD=8.4 PS=40.84 PD=40.84 nrd=0.014500 nrs=0.014500 nf=1 mult=1 sa=0 sb=0 sd=0
* device instance $27 r0 *1 146.3,46.67 pfet
X$27 D1__t19 VB__t7 TAIL__t15 VDD__t70 sky130_fd_pr__pfet_g5v0d10v5 L=10 W=20 AS=8.4 AD=8.4 PS=40.84 PD=40.84 nrd=0.014500 nrs=0.014500 nf=1 mult=1 sa=0 sb=0 sd=0
* device instance $28 r0 *1 39.4,61.49 pfet
X$28 TAIL__t16 GDRV__t25 VDD__t74 VDD__t71 sky130_fd_pr__pfet_g5v0d10v5 L=2 W=8 AS=3.36 AD=3.36 PS=16.84 PD=16.84 nrd=0.036250 nrs=0.036250 nf=1 mult=1 sa=0 sb=0 sd=0
* device instance $29 r0 *1 39.4,52.67 pfet
X$29 VOUT__t1 GDRV__t1 VDD__t2 VDD__t3 sky130_fd_pr__pfet_g5v0d10v5 L=2 W=8 AS=3.36 AD=3.36 PS=16.84 PD=16.84 nrd=0.036250 nrs=0.036250 nf=1 mult=1 sa=0 sb=0 sd=0
* device instance $30 r0 *1 42.64,61.49 pfet
X$30 VOUT__t4 GDRV__t26 VDD__t75 VDD__t72 sky130_fd_pr__pfet_g5v0d10v5 L=2 W=8 AS=3.36 AD=3.36 PS=16.84 PD=16.84 nrd=0.036250 nrs=0.036250 nf=1 mult=1 sa=0 sb=0 sd=0
* device instance $31 r0 *1 42.64,52.67 pfet
X$31 TAIL__t17 GDRV__t27 VDD__t76 VDD__t73 sky130_fd_pr__pfet_g5v0d10v5 L=2 W=8 AS=3.36 AD=3.36 PS=16.84 PD=16.84 nrd=0.036250 nrs=0.036250 nf=1 mult=1 sa=0 sb=0 sd=0
* device instance $32 r0 *1 67.62,67.49 pfet
X$32 D1__t15 VB__t3 TAIL__t0 VDD__t4 sky130_fd_pr__pfet_g5v0d10v5 L=10 W=20 AS=8.4 AD=8.4 PS=40.84 PD=40.84 nrd=0.014500 nrs=0.014500 nf=1 mult=1 sa=0 sb=0 sd=0
* device instance $33 r0 *1 78.86,67.49 pfet
X$33 D2__t19 VA__t8 TAIL__t14 VDD__t69 sky130_fd_pr__pfet_g5v0d10v5 L=10 W=20 AS=8.4 AD=8.4 PS=40.84 PD=40.84 nrd=0.014500 nrs=0.014500 nf=1 mult=1 sa=0 sb=0 sd=0
* device instance $34 r0 *1 90.1,67.49 pfet
X$34 D1__t16 VB__t4 TAIL__t9 VDD__t64 sky130_fd_pr__pfet_g5v0d10v5 L=10 W=20 AS=8.4 AD=8.4 PS=40.84 PD=40.84 nrd=0.014500 nrs=0.014500 nf=1 mult=1 sa=0 sb=0 sd=0
* device instance $35 r0 *1 101.34,67.49 pfet
X$35 D2__t17 VA__t6 TAIL__t10 VDD__t65 sky130_fd_pr__pfet_g5v0d10v5 L=10 W=20 AS=8.4 AD=8.4 PS=40.84 PD=40.84 nrd=0.014500 nrs=0.014500 nf=1 mult=1 sa=0 sb=0 sd=0
* device instance $36 r0 *1 112.58,67.49 pfet
X$36 D1__t17 VB__t5 TAIL__t11 VDD__t66 sky130_fd_pr__pfet_g5v0d10v5 L=10 W=20 AS=8.4 AD=8.4 PS=40.84 PD=40.84 nrd=0.014500 nrs=0.014500 nf=1 mult=1 sa=0 sb=0 sd=0
* device instance $37 r0 *1 123.82,67.49 pfet
X$37 D2__t18 VA__t7 TAIL__t12 VDD__t67 sky130_fd_pr__pfet_g5v0d10v5 L=10 W=20 AS=8.4 AD=8.4 PS=40.84 PD=40.84 nrd=0.014500 nrs=0.014500 nf=1 mult=1 sa=0 sb=0 sd=0
* device instance $38 r0 *1 135.06,67.49 pfet
X$38 D1__t18 VB__t6 TAIL__t13 VDD__t68 sky130_fd_pr__pfet_g5v0d10v5 L=10 W=20 AS=8.4 AD=8.4 PS=40.84 PD=40.84 nrd=0.014500 nrs=0.014500 nf=1 mult=1 sa=0 sb=0 sd=0
* device instance $39 r0 *1 146.3,67.49 pfet
X$39 D2__t13 VA__t2 TAIL__t1 VDD__t56 sky130_fd_pr__pfet_g5v0d10v5 L=10 W=20 AS=8.4 AD=8.4 PS=40.84 PD=40.84 nrd=0.014500 nrs=0.014500 nf=1 mult=1 sa=0 sb=0 sd=0
* device instance $40 r0 *1 20.51,106.9 pfet
X$40 PN__t23 PN__t0 VDD__t0 VDD__t1 sky130_fd_pr__pfet_g5v0d10v5 L=20 W=6 AS=2.52 AD=2.52 PS=12.84 PD=12.84 nrd=0.048333 nrs=0.048333 nf=1 mult=1 sa=0 sb=0 sd=0
* device instance $41 r0 *1 20.51,113.72 pfet
X$41 GDRV__t0 PN__t13 VDD__t100 VDD__t85 sky130_fd_pr__pfet_g5v0d10v5 L=20 W=6 AS=2.52 AD=2.52 PS=12.84 PD=12.84 nrd=0.048333 nrs=0.048333 nf=1 mult=1 sa=0 sb=0 sd=0
* device instance $42 r0 *1 41.75,113.72 pfet
X$42 PN__t24 PN__t14 VDD__t101 VDD__t86 sky130_fd_pr__pfet_g5v0d10v5 L=20 W=6 AS=2.52 AD=2.52 PS=12.84 PD=12.84 nrd=0.048333 nrs=0.048333 nf=1 mult=1 sa=0 sb=0 sd=0
* device instance $43 r0 *1 41.75,106.9 pfet
X$43 GDRV__t32 PN__t12 VDD__t99 VDD__t84 sky130_fd_pr__pfet_g5v0d10v5 L=20 W=6 AS=2.52 AD=2.52 PS=12.84 PD=12.84 nrd=0.048333 nrs=0.048333 nf=1 mult=1 sa=0 sb=0 sd=0
* device instance $44 r0 *1 62.99,113.72 pfet
X$44 GDRV__t31 PN__t11 VDD__t98 VDD__t83 sky130_fd_pr__pfet_g5v0d10v5 L=20 W=6 AS=2.52 AD=2.52 PS=12.84 PD=12.84 nrd=0.048333 nrs=0.048333 nf=1 mult=1 sa=0 sb=0 sd=0
* device instance $45 r0 *1 62.99,106.9 pfet
X$45 PN__t22 PN__t10 VDD__t97 VDD__t82 sky130_fd_pr__pfet_g5v0d10v5 L=20 W=6 AS=2.52 AD=2.52 PS=12.84 PD=12.84 nrd=0.048333 nrs=0.048333 nf=1 mult=1 sa=0 sb=0 sd=0
* device instance $46 r0 *1 84.23,106.9 pfet
X$46 GDRV__t30 PN__t9 VDD__t96 VDD__t81 sky130_fd_pr__pfet_g5v0d10v5 L=20 W=6 AS=2.52 AD=2.52 PS=12.84 PD=12.84 nrd=0.048333 nrs=0.048333 nf=1 mult=1 sa=0 sb=0 sd=0
* device instance $47 r0 *1 84.23,113.72 pfet
X$47 PN__t20 PN__t5 VDD__t92 VDD__t77 sky130_fd_pr__pfet_g5v0d10v5 L=20 W=6 AS=2.52 AD=2.52 PS=12.84 PD=12.84 nrd=0.048333 nrs=0.048333 nf=1 mult=1 sa=0 sb=0 sd=0
* device instance $48 r0 *1 105.47,106.9 pfet
X$48 PN__t27 PN__t19 VDD__t106 VDD__t91 sky130_fd_pr__pfet_g5v0d10v5 L=20 W=6 AS=2.52 AD=2.52 PS=12.84 PD=12.84 nrd=0.048333 nrs=0.048333 nf=1 mult=1 sa=0 sb=0 sd=0
* device instance $49 r0 *1 105.47,113.72 pfet
X$49 GDRV__t29 PN__t8 VDD__t95 VDD__t80 sky130_fd_pr__pfet_g5v0d10v5 L=20 W=6 AS=2.52 AD=2.52 PS=12.84 PD=12.84 nrd=0.048333 nrs=0.048333 nf=1 mult=1 sa=0 sb=0 sd=0
* device instance $50 r0 *1 126.71,106.9 pfet
X$50 GDRV__t28 PN__t6 VDD__t93 VDD__t78 sky130_fd_pr__pfet_g5v0d10v5 L=20 W=6 AS=2.52 AD=2.52 PS=12.84 PD=12.84 nrd=0.048333 nrs=0.048333 nf=1 mult=1 sa=0 sb=0 sd=0
* device instance $51 r0 *1 126.71,113.72 pfet
X$51 PN__t21 PN__t7 VDD__t94 VDD__t79 sky130_fd_pr__pfet_g5v0d10v5 L=20 W=6 AS=2.52 AD=2.52 PS=12.84 PD=12.84 nrd=0.048333 nrs=0.048333 nf=1 mult=1 sa=0 sb=0 sd=0
* device instance $52 r0 *1 147.95,106.9 pfet
X$52 PN__t26 PN__t18 VDD__t105 VDD__t90 sky130_fd_pr__pfet_g5v0d10v5 L=20 W=6 AS=2.52 AD=2.52 PS=12.84 PD=12.84 nrd=0.048333 nrs=0.048333 nf=1 mult=1 sa=0 sb=0 sd=0
* device instance $53 r0 *1 147.95,113.72 pfet
X$53 GDRV__t34 PN__t17 VDD__t104 VDD__t89 sky130_fd_pr__pfet_g5v0d10v5 L=20 W=6 AS=2.52 AD=2.52 PS=12.84 PD=12.84 nrd=0.048333 nrs=0.048333 nf=1 mult=1 sa=0 sb=0 sd=0
* device instance $54 r0 *1 169.19,113.72 pfet
X$54 PN__t25 PN__t16 VDD__t103 VDD__t88 sky130_fd_pr__pfet_g5v0d10v5 L=20 W=6 AS=2.52 AD=2.52 PS=12.84 PD=12.84 nrd=0.048333 nrs=0.048333 nf=1 mult=1 sa=0 sb=0 sd=0
* device instance $55 r0 *1 169.19,106.9 pfet
X$55 GDRV__t33 PN__t15 VDD__t102 VDD__t87 sky130_fd_pr__pfet_g5v0d10v5 L=20 W=6 AS=2.52 AD=2.52 PS=12.84 PD=12.84 nrd=0.048333 nrs=0.048333 nf=1 mult=1 sa=0 sb=0 sd=0
* device instance $56 r0 *1 131.93,158.13 pfet
X$56 VDD__t7 GDRV__t3 VDD__t6 VDD__t8 sky130_fd_pr__pfet_g5v0d10v5 L=20 W=30 AS=12.6 AD=12.6 PS=60.84 PD=60.84 nrd=0.009667 nrs=0.009667 nf=1 mult=1 sa=0 sb=0 sd=0
* device instance $57 r0 *1 153.17,158.13 pfet
X$57 VDD__t35 GDRV__t15 VDD__t50 VDD__t20 sky130_fd_pr__pfet_g5v0d10v5 L=20 W=30 AS=12.6 AD=12.6 PS=60.84 PD=60.84 nrd=0.009667 nrs=0.009667 nf=1 mult=1 sa=0 sb=0 sd=0
* device instance $58 r0 *1 174.41,158.13 pfet
X$58 VDD__t27 GDRV__t7 VDD__t42 VDD__t12 sky130_fd_pr__pfet_g5v0d10v5 L=20 W=30 AS=12.6 AD=12.6 PS=60.84 PD=60.84 nrd=0.009667 nrs=0.009667 nf=1 mult=1 sa=0 sb=0 sd=0
* device instance $59 r0 *1 195.65,158.13 pfet
X$59 VDD__t28 GDRV__t8 VDD__t43 VDD__t13 sky130_fd_pr__pfet_g5v0d10v5 L=20 W=30 AS=12.6 AD=12.6 PS=60.84 PD=60.84 nrd=0.009667 nrs=0.009667 nf=1 mult=1 sa=0 sb=0 sd=0
* device instance $60 r0 *1 216.89,158.13 pfet
X$60 VDD__t30 GDRV__t10 VDD__t45 VDD__t15 sky130_fd_pr__pfet_g5v0d10v5 L=20 W=30 AS=12.6 AD=12.6 PS=60.84 PD=60.84 nrd=0.009667 nrs=0.009667 nf=1 mult=1 sa=0 sb=0 sd=0
* device instance $61 r0 *1 238.13,158.13 pfet
X$61 VDD__t38 GDRV__t18 VDD__t53 VDD__t23 sky130_fd_pr__pfet_g5v0d10v5 L=20 W=30 AS=12.6 AD=12.6 PS=60.84 PD=60.84 nrd=0.009667 nrs=0.009667 nf=1 mult=1 sa=0 sb=0 sd=0
* device instance $62 r0 *1 259.37,158.13 pfet
X$62 VDD__t26 GDRV__t6 VDD__t41 VDD__t11 sky130_fd_pr__pfet_g5v0d10v5 L=20 W=30 AS=12.6 AD=12.6 PS=60.84 PD=60.84 nrd=0.009667 nrs=0.009667 nf=1 mult=1 sa=0 sb=0 sd=0
* device instance $63 r0 *1 280.61,158.13 pfet
X$63 VDD__t39 GDRV__t19 VDD__t54 VDD__t24 sky130_fd_pr__pfet_g5v0d10v5 L=20 W=30 AS=12.6 AD=12.6 PS=60.84 PD=60.84 nrd=0.009667 nrs=0.009667 nf=1 mult=1 sa=0 sb=0 sd=0
* device instance $64 r0 *1 75.61,174.45 pfet
X$64 NG__t1 NG__t2 \$182__t2 VDD__t9 sky130_fd_pr__pfet_g5v0d10v5 L=20 W=1 AS=0.42 AD=0.42 PS=2.84 PD=2.84 nrd=0.290000 nrs=0.290000 nf=1 mult=1 sa=0 sb=0 sd=0
* device instance $65 r0 *1 75.61,172.63 pfet
X$65 \$182__t1 \$182__t0 GDRV__t4 VDD__t10 sky130_fd_pr__pfet_g5v0d10v5 L=20 W=1 AS=0.42 AD=0.42 PS=2.84 PD=2.84 nrd=0.290000 nrs=0.290000 nf=1 mult=1 sa=0 sb=0 sd=0
* device instance $66 r0 *1 131.93,188.95 pfet
X$66 VDD__t37 GDRV__t17 VDD__t52 VDD__t22 sky130_fd_pr__pfet_g5v0d10v5 L=20 W=30 AS=12.6 AD=12.6 PS=60.84 PD=60.84 nrd=0.009667 nrs=0.009667 nf=1 mult=1 sa=0 sb=0 sd=0
* device instance $67 r0 *1 153.17,188.95 pfet
X$67 VDD__t29 GDRV__t9 VDD__t44 VDD__t14 sky130_fd_pr__pfet_g5v0d10v5 L=20 W=30 AS=12.6 AD=12.6 PS=60.84 PD=60.84 nrd=0.009667 nrs=0.009667 nf=1 mult=1 sa=0 sb=0 sd=0
* device instance $68 r0 *1 174.41,188.95 pfet
X$68 VDD__t36 GDRV__t16 VDD__t51 VDD__t21 sky130_fd_pr__pfet_g5v0d10v5 L=20 W=30 AS=12.6 AD=12.6 PS=60.84 PD=60.84 nrd=0.009667 nrs=0.009667 nf=1 mult=1 sa=0 sb=0 sd=0
* device instance $69 r0 *1 195.65,188.95 pfet
X$69 VDD__t34 GDRV__t14 VDD__t49 VDD__t19 sky130_fd_pr__pfet_g5v0d10v5 L=20 W=30 AS=12.6 AD=12.6 PS=60.84 PD=60.84 nrd=0.009667 nrs=0.009667 nf=1 mult=1 sa=0 sb=0 sd=0
* device instance $70 r0 *1 216.89,188.95 pfet
X$70 VDD__t33 GDRV__t13 VDD__t48 VDD__t18 sky130_fd_pr__pfet_g5v0d10v5 L=20 W=30 AS=12.6 AD=12.6 PS=60.84 PD=60.84 nrd=0.009667 nrs=0.009667 nf=1 mult=1 sa=0 sb=0 sd=0
* device instance $71 r0 *1 238.13,188.95 pfet
X$71 VDD__t32 GDRV__t12 VDD__t47 VDD__t17 sky130_fd_pr__pfet_g5v0d10v5 L=20 W=30 AS=12.6 AD=12.6 PS=60.84 PD=60.84 nrd=0.009667 nrs=0.009667 nf=1 mult=1 sa=0 sb=0 sd=0
* device instance $72 r0 *1 259.37,188.95 pfet
X$72 VDD__t31 GDRV__t11 VDD__t46 VDD__t16 sky130_fd_pr__pfet_g5v0d10v5 L=20 W=30 AS=12.6 AD=12.6 PS=60.84 PD=60.84 nrd=0.009667 nrs=0.009667 nf=1 mult=1 sa=0 sb=0 sd=0
* device instance $73 r0 *1 280.61,188.95 pfet
X$73 VDD__t40 GDRV__t20 VDD__t55 VDD__t25 sky130_fd_pr__pfet_g5v0d10v5 L=20 W=30 AS=12.6 AD=12.6 PS=60.84 PD=60.84 nrd=0.009667 nrs=0.009667 nf=1 mult=1 sa=0 sb=0 sd=0
* device instance $74 r0 *1 12.96,1.31 pnp
X$74 VSS__t0 VSS__t188 VA__t0 sky130_fd_pr__pnp_05v5_W0p68L0p68 m=1
* device instance $75 r0 *1 14.86,1.31 pnp
X$75 VSS__t1 VSS__t227 VA__t15 sky130_fd_pr__pnp_05v5_W0p68L0p68 m=1
* device instance $76 r0 *1 16.76,1.31 pnp
X$76 VSS__t2 VSS__t226 VA__t14 sky130_fd_pr__pnp_05v5_W0p68L0p68 m=1
* device instance $77 r0 *1 18.66,1.31 pnp
X$77 VSS__t3 VSS__t225 VA__t13 sky130_fd_pr__pnp_05v5_W0p68L0p68 m=1
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
R$221 \$143__t1 \$145__t0 2003.841367
* device instance $222 r0 *1 92.33,13.1 res_high_po
R$222 \$144__t1 \$146__t0 2003.841367
* device instance $223 r0 *1 98.67,13.1 res_high_po
R$223 \$145__t1 \$147__t0 2003.841367
* device instance $224 r0 *1 105.01,13.1 res_high_po
R$224 \$146__t1 \$129__t1 2003.841367
* device instance $225 r0 *1 111.35,13.1 res_high_po
R$225 \$147__t1 \$128__t1 2003.841367
* device instance $226 r0 *1 134.62,13.1 res_high_po
R$226 VB__t8 \$150__t0 542.118769
* device instance $227 r0 *1 136.46,13.1 res_high_po
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
