2AMLogic/sky130-bandgap/layout/bin/gen_bandgap_routed.py

#!/usr/bin/env python3
"""layout/bin/gen_bandgap_routed.py -- issue #62: route the bandgap-core
floorplan skeleton to real inter-block connectivity, extract it, and LVS it
against the xschem-derived reference netlist.

Standard library only (matches sim/bin/corner-run.py's and
layout/bin/render-record.py's convention). Invoked by
layout/bin/run-bandgap-routed-flow.sh, which supplies
--out-dir/--record-id/--klt/--pdk-variant the same way
run-bandgap-floorplan-flow.sh used to invoke gen_bandgap_floorplan.py.

This is the routed successor to gen_bandgap_floorplan.py, the #15
placement-only DRC flow this one supersedes, removed in #217 (#215) -- its
one historical record is left in place as append-only evidence. Relative to
that skeleton, this flow draws real inter-block metal (met1, escaping to
met2 where met1 congestion forces it -- see MET2_ESCAPE_NOTE), draws and
busses each matched device group (resistor ladders, MOS combs, PNP arrays --
see MET1_BUS_NOTE / MOS_GATE_NOTE), promotes gate-only and trim-tap nodes
through top-level pins, and runs `klt extract` + `klt lvs` against the
xschem-derived reference netlist, recording the result rather than skipping
it as not-yet-meaningful.

The `*_NOTE` constants below (MET1_BUS_NOTE, RES_FLAVOR_NOTE,
RES_TRIM_LENGTH_NOTE, RES_BULK_ARITY_NOTE, MCC_MIM_INFEASIBLE_NOTE, etc.)
each carry the inline rationale for one specific design or tool-capability
decision, next to the code they explain.

`layout/matching-plan.md` is the single source of truth for this flow's
design history -- every increment since issue #62 (device recognition,
metal planes, resistor/PNP LVS-model transcription fixes, trim-ladder
resizes, and the current disclosed-mismatch state) is recorded there, in
more depth and kept current, rather than duplicated here.
"""

from __future__ import annotations

import argparse
import json
import re
import subprocess
import sys
from pathlib import Path
from typing import Any

sys.path.insert(0, str(Path(__file__).resolve().parent))
import met1_bus  # noqa: E402  -- local module, resolved from this script's dir
from layout_common import klt_gen, run_klt_json, union_bbox  # noqa: E402

# bus_routing.py (issue #221) imports several names back from this module at
# its own top level. When this file is run directly (`__name__ ==
# "__main__"`), alias this module's registered name to the same object so
# that import resolves to the already-running instance instead of
# re-executing this file a second time under its real module name.
sys.modules.setdefault("gen_bandgap_routed", sys.modules[__name__])

# ---------------------------------------------------------------------------
# Friction notes (upstream tool gaps this script works around or is limited
# by). Each is filed at 2AMLogic/klayout-tools per CLAUDE.md's protocol as a
# generic tool-gap description; the design-specific consequence lives here and
# in layout/matching-plan.md, never in that tracker.
# ---------------------------------------------------------------------------
MET1_BUS_NOTE = (
    "Every intra-block bus and every inter-block net in this cell is drawn "
    "by this repo with `klt draw`, on met1 over mcon -- see "
    "layout/bin/met1_bus.py. That started as the only option: sky130's "
    "generator/router layer-role table exposed exactly one routing metal "
    "role (`metal` -> li1 67/20), the same layer every generator draws its "
    "device pads on, so `klt gen-compose` could not express a bus at all "
    "(klayout-tools#433; its fix #439 made the failure visible rather than "
    "expressible). klayout-tools#454 (merged via #468) has since added "
    "`metal2`/`via1` roles with via-drop bussing, and #508 (merged via "
    "#511) a third `metal3`/`via2` level, so the router *can* now plan "
    "wires above the pad layer. This flow has not moved its bussing onto "
    "them (its own met2 escape plane is hand-drawn too, MET2_ESCAPE_NOTE): "
    "the "
    "bussing here is a planar lane assignment derived from each block's own "
    "reported geometry (MOS_COMB_NOTE), and swapping it for router-planned "
    "routing is a rework to be measured on its own, not a parameter change "
    "to be slipped into an increment that is already changing the device "
    "topology. Hand-placing what a router could plan remains the residual "
    "gap."
)
#: RESOLVED upstream, and the reason this increment exists. Kept as a named
#: note because record.md still has to say *why* the layout now draws what it
#: draws, and because the contact stack the fix makes possible is still this
#: flow's own geometry, not the router's.
MOS_GATE_NOTE = (
    "Until 2AMLogic/klayout-tools#461 (merged via #474) every `klt gen` MOS "
    "generator on sky130 drew the gate poly with exactly the active "
    "region's extent and reported the gate port on the shared poly/diff "
    "boundary, so no contact could be placed legally -- one at the port "
    "straddled the diff edge (`poly.enclosing.licon.1` / "
    "`diff.enclosing.licon.1`) and one moved inward sat on poly over the "
    "channel. `diff_pair`/`mos_array` now extend the first finger's poly "
    "past the diffusion into a contact-region landing pad and report the "
    "gate port at its centre, so a gate is contactable. Placing that "
    "contact is still this flow's job: `gen-compose`'s router resolves only "
    "`metal`/`metal2` roles and never drops a licon, so met1_bus.py's "
    "`gate_contact` draws the licon on the pad and the li1 riser down into "
    "the device row itself."
)
RES_FLAVOR_NOTE = (
    "`klt gen res_array` on sky130 could only draw the base "
    "`res_generic_po` flavour until 2AMLogic/klayout-tools#463 (merged via "
    "#475): the generator's `res_implant`/`res_block` layer roles were None "
    "for the sky130 family, while the same tool's sky130 extraction deck "
    "recognises three flavours (`res_generic_po` 48.2, `res_high_po` 319.8, "
    "`res_xhigh_po` 2000 ohm/sq) distinguished by implant masks the "
    "generator never drew. `res_array` now takes a `flavor` parameter "
    "resolved through the same per-flavour layer table the extraction deck "
    "keys off, so this layout draws the schematic's own `res_high_po` -- "
    "which is also what gives the resistor blocks a bulk terminal at all "
    "(the deck marks `res_high_po` `bulk_to_substrate`). That terminal is "
    "not a drawn pad, though: the deck ties it to the same shared "
    "`deck.substrate_net` global identity every NMOS body ties to, which "
    "resolves to this layout's real, drawn `VSS` net -- see "
    "SUBSTRATE_NET_NOTE."
)
#: RESOLVED upstream, and the reason this increment exists. Through issue
#: #62's seventeenth increment this note recorded a live blocker: the corridor
#: congestion behind AC1's unrouted trio was this flow's own router running
#: out of free metal, with no metal-level lever left -- layout/matching-plan.md
#: Sections 7d-7o rule out every router/floorplan lever this repo can pull,
#: and klayout-tools#454's own `metal2` role was not one, because on sky130 it
#: resolved to the same met1 layer this flow's bussing already occupies
#: (Section 7d). Filed generically as 2AMLogic/klayout-tools#508; merged via
#: #511. Kept as a named note because the escape plane is still *this flow's*
#: own hand-drawn geometry, and because the record has to say why the layout
#: now draws met2 at all.
ROUTING_PLANE_NOTE = (
    "sky130's curated extraction deck declared exactly two connectivity "
    "levels (`EXTRACTION_DECK.metals = (li1, met1)`) through issue #62's "
    "seventeenth increment, so klayout-tools#454/#468's `metal2` role "
    "resolved to the same met1 layer this flow's own met1_bus.py already "
    "routes every bus and inter-block net on (MET1_BUS_NOTE) -- not a "
    "distinct plane above it. A router that needs a second, independent "
    "routing plane once its own intra-block bussing has saturated the only "
    "other level the deck exposes had no escape short of deck curation "
    "adding a third connectivity level. Filed generically as "
    "2AMLogic/klayout-tools#508 and merged via #511: sky130's deck now "
    "declares met2 (69/20) over a met1<->met2 `via.drawing` (68/44) as a "
    "genuine third level, which is what MET2_ESCAPE_NOTE's escape hatch is "
    "drawn on."
)
#: The layout-side consequence of #511, and its own residual gap.
MET2_ESCAPE_NOTE = (
    "Inter-block hops that no met1 form can clear are lifted onto met2 by "
    "`_connect_met2`: a via1 stack (met1 pad + `via.drawing` cut + met2 pad) "
    "at each endpoint and met2 wire between them, all hand-drawn by "
    "met1_bus.py exactly as the met1 routing is. met2 is tried strictly "
    "last, after every met1 elbow, channel path and Z-detour has been rolled "
    "back. That deck declares met2 as a *connectivity* level "
    "(klayout-tools#511); its *DRC* rule coverage for the level was added "
    "later and is still partial -- klayout-tools#513 (merged via #515) gave "
    "`klt drc` the met2/via1 width, spacing and enclosure rules "
    "(`met2.width.1`, `met2.space.1`, `via.width.1`, `via.space.1`, "
    "`met1.enclosing.via.1`, `met2.enclosing.via.1`), but not the met2 "
    "min-area rule (`m2.6`) -- #515 left it out because the curated deck's "
    "rule vocabulary has no `area` check primitive. This flow holds the "
    "sky130A source deck's own full threshold set by construction instead "
    "(`m2.1`/`m2.2`/`m2.6`, `via.1a`/`via.2`/`via.4a`/`via.5a` -- see "
    "met1_bus.py's DRC-budget docstring) and re-proves the spacing half with "
    "`Met1Bus.conflicts()`, which scores met2 and via1 alongside met1 and "
    "li1 for a *net-aware* short that a plain width/space DRC rule cannot "
    "see (two different nets' met2 touching is not a spacing violation --"
    " there is no gap to measure). The residual `m2.6` gap was deliberately "
    "scoped out of #515 rather than left unfiled -- see that PR's own "
    "summary; connectivity itself is the tool's, and is what `klt extract` "
    "reads back."
)
#: Historical note, kept for context: through issue #62's thirteenth
#: increment, sky130's curated extraction deck had no NMOS-body or
#: resistor-bulk layer to derive from drawn geometry -- `extract.py`
#: registered an *empty* `nfet_body` region, wired it into every nfet's `W`
#: terminal, every `bulk_to_substrate` resistor's `W` terminal and every
#: bipolar's collector, and then `connect_global`'d it to the deck's
#: synthesized `vsubs` net, which no drawn shape could ever join. The
#: correspondence to the schematic's real `VSS` had to be declared via
#: `hints.same_nets` instead.
#:
#: 2AMLogic/klayout-tools#490 (merged via #495, picked up in issue #62's
#: fourteenth increment) resolves the body/bulk/collector terminal to a real
#: drawn `tap.drawing` ring outside `nwell` when one is present and
#: contacted -- and this layout already draws exactly that shape (both NMOS
#: groups' substrate guard-ring taps and both PNP base ties, wired to `VSS`
#: by this flow). Once any such tap is drawn anywhere in the design, sky130's
#: single shared `deck.substrate_net` global identity resolves to that real
#: net everywhere it is used, not just at the tap itself -- confirmed by
#: reading the extracted netlist back: every nfet's `b` terminal and every
#: `res_high_po`'s `w` terminal now read `VSS`, not `vsubs`. There is no
#: longer a `vsubs` net in this layout's extracted netlist at all, so
#: `SUBSTRATE_SAME_NETS` is empty -- declaring a correspondence for a net
#: that no longer exists is not a no-op, it is a hard `klt lvs` error
#: (`hints.same_nets: layout net 'vsubs' not found`), which is exactly what
#: shipping the klt pin bump without this change produced.
SUBSTRATE_NET_NOTE = (
    "Through issue #62's thirteenth increment, sky130's curated extraction "
    "deck had no NMOS-body or resistor-bulk layer to derive from drawn "
    "geometry and tied every such terminal to a synthesized, undrawable "
    "`vsubs` global (2AMLogic/klayout-tools#490). Resolved via #495 "
    "(picked up this flow's fourteenth increment): a real drawn substrate "
    "tap -- which this layout already draws, wired to `VSS` -- now resolves "
    "the whole design's substrate identity to the real `VSS` net directly. "
    "Verified by reading the extracted netlist: every nfet body and every "
    "`res_high_po` bulk terminal reads `VSS`, not `vsubs`."
)
#: NOT a tool gap -- a flow correctness rule this increment adds. A
#: `diff_pair` reports its two devices as two port families (`M1_*`/`M2_*`,
#: or `Q1_*`/`Q2_*` when `mirror` is false), and which family is which
#: schematic transistor is *this flow's* choice, not the generator's. Before
#: MOS_HALVES existed, every net picked whichever candidate pad sat nearest
#: its own centroid, independently -- so two nets that the schematic says are
#: the drains of two *different* transistors could both land on the same
#: half, and a gate pin label could name a half whose drain another net had
#: already claimed for the other transistor. Both happened: `PN` took a
#: finger of the same amp_pmirr half the `AOUT` label named, and amp_nload's
#: `D1` route and `D1_GATE` label disagreed about which half is MN1.
MOS_HALF_NOTE = (
    "A diff_pair's two port families are bound to named schematic devices "
    "once, in MOS_HALVES, and every route and pin label resolves through it. "
    "Without that binding the centroid-nearest pick is free to hand two "
    "different schematic nodes two fingers of the same physical transistor, "
    "which is a topology error that neither DRC nor the drawn-short check "
    "can see -- both terminals are legal, well-separated metal."
)
DUMMY_DEVICE_NOTE = (
    "Through issue #62's thirteenth increment: 2AMLogic/klayout-tools#462 "
    "(merged via #471) extended `klt extract`'s dummy-device suppression "
    "from MOS gates to resistors and bipolars, which was only the "
    "extractor half of the gap. The other half was open on sky130: the "
    "suppression keyed off `ExtractionDeck.dummy`, and the sky130 curated "
    "deck declared no `dummy` layer at all, no `klt gen` generator drew "
    "one, and `klt extract` exposed no override -- so there was no layer "
    "for a layout to mark its dummies with, and every matched array's "
    "dummy edge units extracted as ordinary devices with no schematic "
    "counterpart. Resolved via 2AMLogic/klayout-tools#491 (merged via #494, "
    "picked up in this flow's fourteenth increment): sky130's curated deck "
    "now declares a `dummy` marker layer, and `mos_array`/`res_array`/ "
    "`bjt_array` draw it over each array's own `dummy_cells` footprint, so "
    "`klt extract` correctly drops them. Verified: `extract.json`'s "
    "`dummy_devices_dropped` is non-zero and `pnp`/`res_high_po` device "
    "counts dropped accordingly, with no change to the drawn GDS geometry "
    "-- a dummy unit has no schematic counterpart by construction (it "
    "exists only for layout-matching symmetry), so this is a strictly "
    "*more* correct comparison, not a number chased by hiding matching "
    "geometry."
)
#: Why no resistor could be paired by `klt lvs` at all, whatever the routing
#: did -- found while isolating issue #72's 0/0 correspondence regression and
#: filed as 2AMLogic/klayout-tools#504 (closed via #505) and, for the generic
#: reconciliation #505 deferred, as #506 (closed as COMPLETED -- see below).
#: **Fixed** on this flow's own side in issue #62's sixteenth increment --
#: kept as a historical note plus the fix.
RES_BULK_ARITY_NOTE = (
    "The sky130 deck marks `res_high_po` `bulk_to_substrate`, so `klt "
    "extract` writes a **three-node** R card "
    "(`R<name> <a> <b> <bulk> <value> <model>`), which KLayout's SPICE "
    "reader turns into `DeviceClassResistorWithBulk` (terminals A/B/W). "
    "Through issue #62's fifteenth increment, `reference.spice` carried "
    "only a **two-node** R card (`R<name> <a> <b> <value> <model>`), which "
    "the same reader turns into the incompatible `DeviceClassResistor` "
    "(terminals A/B) -- same model name on both sides, different terminal "
    "count, so `NetlistComparer` could not pair them regardless of value. "
    "2AMLogic/klayout-tools#505 (merged) added a dedicated "
    "`device.class_arity` mismatch category for exactly this shape, "
    "diagnostic only -- it does not itself make the two classes match, and "
    "the generic reconciliation #504 proposed (a request-side hint "
    "normalizing the reference class's implicit bulk terminal, or the "
    "symmetric layout-side drop) was left unimplemented, filed by the "
    "fifteenth increment as 2AMLogic/klayout-tools#506, since closed as "
    "COMPLETED (`reference.device_bulk` now exists upstream). "
    "**Fixed in the sixteenth increment, without needing #506**: "
    "`reference.spice`'s `R2A`/`R2B`/"
    "`R1` cards now carry the bulk node too (`VSS`), because "
    "design/bandgap_core.sch's own schematic wires it there on every one of "
    "them (`r2ab`/`r2bb`/`r1b` lab_pins) and the checked-in xschem netlist "
    "`reference.spice` already cites as its source states it directly "
    "(`XR2A VA VOUT VSS sky130_fd_pr__res_high_po ...`) -- this was a "
    "transcription gap in `reference.spice`, not an invented connection, so "
    "fixing it is not the reference-edit-to-accommodate-the-layout this "
    "flow refuses elsewhere. That distinction is the whole reason #506 was "
    "not needed here and is still a valid ask elsewhere: #506 asks `klt` to "
    "reconcile the arity when the reference genuinely does *not* wire the "
    "bulk net and so cannot state it; this reference always could, and the "
    "fifteenth increment's premise that a reference edit was the only other "
    "option and one this flow refuses was wrong for this device only. "
    "Verified directly with "
    "`klayout.db.NetlistSpiceReader`: `reference.spice` now registers "
    "`RES_HIGH_PO` as `DeviceClassResistorWithBulk`, the same class the "
    "layout side registers. Confirmed to change nothing else: rerunning "
    "the full flow after the fix reproduces byte-identical "
    "`mismatch_count`, `category_counts`, and the identical "
    "`device.unmatched` entry list -- the arity mismatch was real and is "
    "now retired, but was never the operative blocker for these three "
    "devices; RES_TRIM_TOPOLOGY_NOTE's structural gap is. See "
    "layout/matching-plan.md Section 7n."
)
#: Fixed in issue #62's twenty-first increment: the same transcription-gap shape
#: RES_BULK_ARITY_NOTE closed for the resistor bulk terminal, applied to the
#: PNP pair's emitter geometry.
PNP_EMITTER_GEOMETRY_NOTE = (
    "`klt lvs`'s SPICE reader recognises `AE`/`PE`/`AB`/`PB`/`AC`/`PC`/`NE` "
    "on a `Q` card (KLayout's `DeviceClassBJT3Transistor` parameter set) but "
    "has no notion of a `M`/`mult` field for that class at all -- unlike "
    "`DeviceClassMOS3Transistor`, where a bare `m=` folds directly into `W` "
    "at read time (confirmed directly with `klayout.db.NetlistSpiceReader`), "
    "a Q-card's `m=8` is silently dropped and every unstated parameter "
    "defaults to its class default (`AE`/`PE`/`AB`/`PB`/`AC`/`PC` = 0, "
    "`NE` = 1). That is exactly the shape `klt lvs` reported before this fix: "
    "`ne` 8 (layout) vs 1 (reference), plus zero-valued `ae`/`pe`/`ab`/`pb`/"
    "`ac`/`pc`. `AE`/`PE` are knowable independent of this repo's own layout "
    "generator: the instantiated model name IS the vendor's geometry "
    "declaration. `sky130_fd_pr__pnp_05v5_W0p68L0p68`/`_W3p40L3p40` are "
    "SkyWater's own fixed, non-parametric macro cells -- "
    "`sky130_fd_pr/pnp_05v5.sym`'s netlist format is "
    "`... sky130_fd_pr__@model m=@m`, with no W/L/area argument at all, and "
    "the corresponding `.subckt`s in "
    "libs.ref/sky130_fd_pr/spice/sky130_fd_pr__pnp_05v5_W*.model.spice take "
    "only `Collector Base Emitter` plus a `mult` param; every geometry-"
    "dependent SPICE parameter (`is`/`bf`/...) is baked into that specific "
    "model's own cards. The vendor's own naming convention states the "
    "emitter's W and L directly, so the standard SPICE rectangular-junction "
    "formulae give `AE = W*L`, `PE = 2*(W+L)` per unit, and the schematic's "
    "own `m='n_pnp_ctat'`/`m='n_pnp_ptat'` (= 8, design/bandgap_core.sch "
    "lines 186-187) states the parallel count, which `klt lvs`'s "
    "`combine_devices` sums into `AE`/`PE` (not just `NE`) when it folds the "
    "layout's own 8 parallel unit devices into one -- confirmed directly "
    "against this flow's own combined-LVS device table, where the layout's "
    "post-fold Q1 reads `AE=3.6992 PE=21.76 NE=8` and Q2 reads "
    "`AE=92.48 PE=108.8 NE=8`, i.e. exactly `8 * unit_AE` / `8 * unit_PE`, "
    "not the unscaled per-unit value: Q1 (W0p68L0p68) unit AE = "
    "0.68*0.68 = 0.4624 um^2, unit PE = 2*(0.68+0.68) = 2.72 um, x8 = "
    "3.6992 um^2 / 21.76 um; Q2 (W3p40L3p40) unit AE = 3.40*3.40 = 11.56 "
    "um^2, unit PE = 2*(3.40+3.40) = 13.6 um, x8 = 92.48 um^2 / 108.8 um. "
    "`AB`/`PB`/`AC`/`PC` (base/collector area/perimeter) are deliberately "
    "left unstated (0, the class default): unlike the emitter, base/"
    "collector geometry is not part of the vendor's fixed macro at all -- "
    "this layout does not instantiate `sky130_fd_pr__pnp_05v5_W*` as a "
    "vendor cell; `klt gen bjt_array` draws a matching-faithful floorplan "
    "from base layers (this record's own \"What this record does NOT "
    "claim\" section), so the drawn base/collector geometry is this "
    "repository's own generator's choice, not something "
    "design/bandgap_core.sch's `model=pnp_05v5_W*` name declares or could "
    "ever declare -- stating a value here would mean deriving it from the "
    "layout to make the comparison pass, the workaround "
    "RES_BULK_ARITY_NOTE's own convention refuses. Measured effect: fixing "
    "only `AE`/`PE`/`NE` (leaving `AB`/`PB`/`AC`/`PC` unstated) drops "
    "`mismatch_count` 18 -> 4 and removes every mismatch on both PNP "
    "devices, all seven parameters, not just the three this fix states -- "
    "because KLayout's own `NetlistComparer` decides whether a matched "
    "device pair has a property difference using only that device class's "
    "`is_primary` parameters (`AE` and `NE` for `DeviceClassBJT3Transistor`, "
    "confirmed directly via `parameter_definitions()`'s own `is_primary` "
    "flag); once those two agree, `PE`/`AB`/`PB`/`AC`/`PC` are never "
    "compared at all, so this is not evidence that the base/collector "
    "geometry also matches -- it does not, on either device -- only that "
    "the tool's own equivalence check does not exercise it. See "
    "layout/matching-plan.md Section 7s."
)
#: What actually keeps R2A/R2B/R1 unpaired now that RES_BULK_ARITY_NOTE's
#: class mismatch is fixed -- found while measuring that fix's (null) effect
#: on `mismatch_count` in issue #62's sixteenth increment.
RES_TRIM_TOPOLOGY_NOTE = (
    "design/bandgap_core.sch's CORE_PARAMS carries `n_r2_trim=0` (DR-002's "
    "untrimmed code): at code 0 the schematic has no trim devices at all, "
    "and the reference correctly does not enumerate any -- R2A/R2B's length "
    "is a single `res_high_po` device each, full stop. `res_trim`'s 32 unit "
    "resistors are drawn as real physical devices in the layout "
    "unconditionally, regardless of code (a metal-option tap ladder, not a "
    "code-gated one), so the layout has trim devices and "
    "`TRIM_A`/`TRIM_A_CODE_0`/`TRIM_B`/`TRIM_B_CODE_0` nodes the schematic "
    "does not have at all at this code -- not a value difference on an "
    "otherwise-matched device, a genuine extra branch in the layout's "
    "device graph that `combine_devices` cannot fold away, because folding "
    "combines devices that already share the same two-sided identity, not "
    "devices the reference has no counterpart for. `klt lvs`'s own "
    "`net.split`/`net.merged` categories on `VOUT`/`VB`/`VBQ` (the R2A/R2B/"
    "R1 nodes the trim branch hangs off of) are this, read from the "
    "comparer's own output, not inferred. **Half of this is fixed in the "
    "eighteenth increment** -- see INTERNAL_NODE_LABEL_NOTE and "
    "RES_TRIM_LENGTH_NOTE, which between them separate the two things this "
    "note had conflated: the *labelling* that made the trim ladder look like "
    "extra devices, and the *length* it genuinely adds."
)
#: Why the trim ladder's nodes were unpairable, isolated in issue #62's
#: eighteenth increment by removing four labels and re-running `klt lvs`
#: against the otherwise-identical extracted netlist.
INTERNAL_NODE_LABEL_NOTE = (
    "A labelled met1 net is promoted by `klt extract` to a **top-level "
    "pin**, and `klt lvs`'s `combine_devices` will not fold a series chain "
    "through a pinned node -- folding one away would delete an externally "
    "visible port. This flow labelled every declared inter-block net plus "
    "four trim taps, including `TRIM_A`/`TRIM_B` (the junction between "
    "`res_r2`'s leg and `res_trim`'s leg) and "
    "`TRIM_A_CODE_0`/`TRIM_B_CODE_0`. Every one of those four sits on a node "
    "*interior to the schematic's own R2A/R2B device*, which at DR-002's "
    "code 0 the schematic does not have at all -- so each leg's series chain "
    "was pinned into three pieces on the layout side and none of the three "
    "could pair with the reference's single R2A/R2B, and the resulting "
    "orphan nodes dragged `VBQ`, `R1` and `Q2` out of correspondence with "
    "them. Measured in isolation before being fixed: re-running `klt lvs` on "
    "the identical extracted netlist with only those four pins removed took "
    "`mismatch_count` 26 -> 18 and `device.unmatched` 13 -> **1** (the "
    "deliberately-undrawn `MCC`), with `net.unmatched` going 6 -> 0. Fixed "
    "here by not labelling a net declared `internal` to a schematic device, "
    "and by reporting the trim taps into the record instead of into `pins[]` "
    "-- the taps are still documented, they are just no longer asserted to "
    "be device-level ports of this cell."
)
#: The genuine circuit defect the nineteenth increment's LVS clean-up
#: exposed, and how the twentieth (issue #91) closed it.
RES_TRIM_LENGTH_NOTE = (
    "With INTERNAL_NODE_LABEL_NOTE's pins removed the comparer paired R2A "
    "and R2B and reported a *value* difference -- the first time this flow "
    "had been able to see one on these devices: layout 91,462.8 ohm against "
    "the reference's 88,130 ohm. 91,462.8 / 319.8 ohm-per-square = **286 "
    "squares**, i.e. a 286 um drawn leg where design/bandgap_core.sch's "
    "`L = r_lseg*n_r2 + r_lseg_trim*n_r2_trim` at `n_r2=54, r_lseg=5, "
    "n_r2_trim=0` states 270 um. The 16 um was exactly `res_trim`'s 16 x 1 "
    "um leg, which the layout wired in series *after* a full-length 270 um "
    "`res_r2` leg: the drawn cell sat at trim code **+16**, and DR-002 "
    "rejects every positive code outright (issue #46 found n_r2=55, i.e. "
    "+5 um, already collapses the operating point at the ff/2.97 V and "
    "fs/2.97 V hot corners; sim/trim-range-monotonicity/ finds +1/+2 "
    "collapse too). Worse than the 5.9% value error: with the ladder wired "
    "after the full leg, *every* tap moved the leg further up from 270, so "
    "the drawn ladder could not express any of the 16 downward codes DR-002 "
    "certifies. A real layout-vs-schematic defect, not an LVS bookkeeping "
    "artifact. **Fixed in issue #91** by re-decomposing the leg instead of "
    "extending it: `res_r2` draws 50 coarse 5 um units (250 um) and "
    "`res_trim` the remaining 20 fine 1 um units (20 um), so the code-0 tap "
    "-- the far end of the fine chain, which is what `VA`/`VB` join -- is "
    "exactly 270 um and code -k skips k fine units for 270-k um. 50/20 is "
    "the minimal integral decomposition that keeps 270 um and still reaches "
    "DR-002's -16 (51 coarse + 15 fine also totals 270 but stops at -15). "
    "The drawn ladder spans 0..-20; -17..-20 are physically drawn but "
    "flagged out-of-certified-range in the tap table above, not offered as "
    "valid codes. `r2_leg_length()` now reports `matches: true` and is a "
    "**gated** flow condition (`r2_leg_length_matches`) rather than a "
    "recorded number, so this cannot silently regress. See "
    "layout/matching-plan.md Section 7r."
)
#: What issue #62's twenty-third increment found after bumping past
#: 2AMLogic/klayout-tools#518/#519 (merged) and #521/#526 (merged): the
#: fixed per-instance head-resistance term the extractor now applies does
#: NOT close this cause -- it makes the disclosed `r` delta larger, because
#: this repo's own `res_array`-drawn trim ladder represents one schematic
#: resistor as many separately-contacted series primitives. Filed as
#: 2AMLogic/klayout-tools#559.
#:
#: Update, issue #62's twenty-eighth increment: the upstream fix for
#: klayout-tools#559 landed (#583, deferring the correction until after
#: `combine_devices()` folds) and #587 made it reachable from this flow's own
#: pre-extracted request shape. Measured under all four accounting variants by
#: `layout/bin/measure_fixed_offset_variants.py` and deliberately NOT adopted:
#: since issue #108 settled `reference.spice` on the CHAINED value, the shipped
#: per-primitive accounting is the only variant that matches, and #587's own
#: defer-plus-deck pairing would take `mismatch_count` 1 -> 4. See item 20 in
#: this module's docstring and layout/matching-plan.md Section 7z.
RES_HEAD_RESISTANCE_NOTE = (
    "2AMLogic/klayout-tools#518 (merged via #519) added `ResistorDevice."
    "fixed_offset_ohm`, a per-instance fixed head/end-resistance term "
    "measured against the real `sky130_fd_pr__res_high_po` two-term SPICE "
    "model (`sheet_rho_ohm_sq=324.827244`, `fixed_offset_ohm=379.705147`, "
    "both on by default for this flavour -- no opt-in flag this repo's own "
    "code needs to pass). 2AMLogic/klayout-tools#521 (merged via #526) was "
    "needed alongside it: #519's correction was applied only inside `klt "
    "extract`'s JSON-report path, not to the `kdb.Netlist` the written "
    "`.spice` file -- and therefore this flow's own `klt lvs` step, which "
    "compares two already-written `.spice` files -- actually reads. "
    "Picking up both closes that JSON-vs-netlist gap cleanly, but does NOT "
    "close this cause: it makes the disclosed `r` delta *larger*, not "
    "smaller. The fixed offset is charged once per *drawn* resistor "
    "primitive, and `res_array`'s trim ladder represents each schematic "
    "`R1`/`R2A`/`R2B` device as many separate, individually-contacted "
    "series primitives -- 50 coarse 5um + 20 fine 1um = 70 per R2 leg, 7 "
    "for R1 -- so that `klt draw`'s met1 jumpers can reach every DR-002 "
    "trim tap (RES_TRIM_LENGTH_NOTE). `klt lvs`'s `combine_devices` folds "
    "that series chain into the one lumped device the schematic states, "
    "summing the corrected `r` of every primitive -- which sums the offset "
    "once per primitive, not once for the logical device design/"
    "bandgap_core.sch's own `R ~ 380 + 325*L` model states. Measured "
    "exactly: each R2 leg now reads 114,282.71617 ohm (= 324.827244 x 270 "
    "+ 70 x 379.705147, to the ohm) against the reference's 88,130, and R1 "
    "reads 14,026.889569 (= 324.827244 x 35 + 7 x 379.705147) against "
    "11,755 -- both exact to the digit, confirmed directly against "
    "`lvs.combined.json`. The `r` delta is now larger than the pre-bump "
    "body-only shortfall it replaced (R2: 26,152.7 ohm over vs. 1,784 ohm "
    "under; R1: 2,271.9 ohm over vs. 562 ohm under), though "
    "`mismatch_count` and `category_counts` are unchanged (still 4; still "
    "`device.property`: 3, `device.unmatched`: 1) -- the *count* the flow "
    "gates on did not regress, but the *reason* moved from 'no per-device "
    "term at all' to 'the wrong number of per-device terms for this flow's "
    "own drawn topology'. Not worked around here: rewriting design/"
    "bandgap_core.sch's simplified single-device `R` model to account for "
    "this flow's own multi-primitive decomposition would be exactly the "
    "reference-edit-to-accommodate-the-layout CLAUDE.md and "
    "RES_BULK_ARITY_NOTE's own convention refuse -- and the alternative, "
    "drawing the ladder as one continuous poly body with intermediate tap "
    "contacts instead of `res_array`'s discrete unit-per-primitive "
    "geometry, is a `klt gen` capability this repo does not have "
    "(`res_array` has no continuous-body-with-taps mode). Filed as "
    "friction: 2AMLogic/klayout-tools#559.\n\n"
    "Update, issue #62's twenty-eighth increment: #559 closed upstream via "
    "2AMLogic/klayout-tools#583, which defers the fixed-offset correction "
    "until after `combine_devices()` folds the series chain and applies it "
    "once per combined device, and #587 (closes #585/#586) made that "
    "correction reachable from this flow's own pre-extracted `{netlist, "
    "top}` request shape -- not, as an earlier draft of that increment "
    "wrongly claimed, because `klt lvs` ignores `layout.deck` on that shape "
    "(`layout_deck` resolves unconditionally in `run_lvs`), but because the "
    "post-combine lookup keyed its device class case-sensitively "
    "(`res_high_po`) while a `kdb.NetlistSpiceReader` round-trip reports it "
    "UPPERCASED (`RES_HIGH_PO`). Measured under all four accounting "
    "variants by `layout/bin/measure_fixed_offset_variants.py` and "
    "deliberately NOT adopted: since issue #108 settled `reference.spice` on "
    "the CHAINED value, the shipped per-primitive accounting is the only "
    "variant that matches, and #587's own defer-plus-deck pairing would take "
    "`mismatch_count` 1 -> 4 and `devices.matched` 15 -> 12. See "
    "layout/matching-plan.md Section 7z."
)
#: Why n_r2 (and only n_r2) moved from 54 to 50, and why this file's own
#: drawn decomposition had to follow it. Not a layout-side finding --
#: transcribes issue #99/DR-003's sizing decision, made against the same
#: chained-array topology RES_HEAD_RESISTANCE_NOTE quantifies.
RES_RESIZE_NOTE = (
    "RES_HEAD_RESISTANCE_NOTE's finding -- that this flow's own multi-"
    "primitive R2A/R2B/R1 decomposition pays the fixed per-instance head "
    "offset once per drawn primitive, not once per logical device -- is a "
    "real electrical effect on the fabricated part, not just an LVS "
    "value mismatch (issue #98/DR-003, sim/res-array-head-resistance/). "
    "At the pre-resize n_r2=54 that makes the REAL chained topology's "
    "K = R2/R1 read 8.1474 against design/bandgap_core.sch's single-"
    "device model of 7.4973, pushing VOUT(27 degC) to ~1.233 V (outside "
    "the draft +/-1% window) at all 5 PVT corners and collapsing "
    "regulation at ff/2.97 V and fs/2.97 V. Issue #99 (DR-003's closure, "
    "PR #105) resizes n_r2 54 -> 50 in design/bandgap_core.sch against "
    "that real chained topology -- verified with a real-SPICE harness "
    "that chains res_high_po unit instances at this flow's own "
    "decomposition into the core testbench, not the single-device model "
    "-- bringing K back to 7.576 and VOUT(27 degC) to ~1.198 V, in-spec "
    "and collapse-free at all 5 corners (sim/res-array-resize/records/"
    "20260805-204809-2c83c7a.md). n_r1 stays at 7: holding R1 (and so the "
    "branch current) fixed corrects K without raising the hot-corner "
    "headroom demand the collapse depends on. That record's own "
    "'Layout follow-up' explicitly deferred re-transcribing this file's "
    "N_R1/N_R2_COARSE/SCH_N_R2 to the resized decomposition and re-"
    "running DRC/LVS as the next increment, per this project's one-lever-"
    "per-increment discipline -- done here, issue #108. See item 19 in "
    "this module's own docstring and layout/matching-plan.md Section 7y "
    "for the drawn-side consequence (rows fold, LVS mismatch delta)."
)
#: Why r_lseg_trim (and only r_lseg_trim) halved 1 -> 0.5, and why
#: N_R2_COARSE had to move again (46 -> 48) to keep it. Not a layout-side
#: finding -- transcribes DR-002's "Revision (issue #106 -- chained
#: fine-trim LSB)" re-partition, propagated into this file's own drawn
#: decomposition by issue #112.
RES_TRIM_LSB_NOTE = (
    "DR-002's original per-code LSB derivation (~1.72 mV/code) simulated "
    "the fine trim ladder as ONE length-tapped device per leg -- the "
    "schematic-level approximation design/bandgap_core.sch's XR2A/XR2B "
    "still draw. This flow's own chained topology is not that: `res_trim` "
    "chains N_R2_TRIM_UNITS=20 separately-contacted unit instances per "
    "leg, so a downward trim code does not shorten one device's body by "
    "r_lseg_trim -- it removes a whole separately-contacted unit instance, "
    "paying that instance's fixed per-instance head/end resistance "
    "(RES_HEAD_RESISTANCE_NOTE's rhead ~379.7 ohm) in addition to its "
    "r_lseg_trim of body. Issue #106 measured the real per-code step at "
    "the adopted n_r1=7/n_r2=50 sizing (issue #99) against DR-002's own "
    "<=3.000 mV/code comfort bound (25% of the +/-1% window's 12 mV "
    "half-width), over the same 5-corner PVT set "
    "sim/trim-range-monotonicity/ and issue #99's AC3 used: at the shipped "
    "r_lseg_trim=1 um the chained topology reads 3.123-3.146 mV/code -- a "
    "real, measured violation at every corner, not merely a carried-over "
    "assumption (sim/trim-lsb-chained/records/). Because rhead is a fixed "
    "PDK model-card constant per removed unit instance, independent of "
    "the unit's drawn body length, halving r_lseg_trim to 0.5 um does not "
    "halve the per-code step -- it removes enough of the scaling rbody "
    "(sheet/fringe, ~324.8 ohm/um) term to bring the step from 704.53 to "
    "542.12 ohm/code, restoring the LSB to 2.403-2.421 mV/code, "
    "comfortably under the bound at every corner, with monotonicity and "
    "the downward-span coverage target unaffected (both already PASS). "
    "The fine ladder's unit COUNT (N_R2_TRIM_UNITS=20) and DR-002's "
    "certified 0..-16 downward code range are unchanged -- this is a pure "
    "re-partition of the fixed 250 um leg length between its coarse and "
    "fine segments, not a resize of n_r1/n_r2 (RES_RESIZE_NOTE's lever) "
    "or a change to the certified code range. Holding the untrimmed leg "
    "fixed at `5*N_R2_COARSE + 0.5*N_R2_TRIM_UNITS == 250` forces "
    "N_R2_COARSE 46 -> 48. `design/bandgap_core.sch`'s `.param "
    "r_lseg_trim` moved 1 -> 0.5 in issue #106/PR #111; this file's own "
    "R_LSEG_TRIM_UM/SCH_R_LSEG_TRIM_UM/N_R2_COARSE re-transcription and "
    "the routed layout's klt DRC/LVS re-verification were explicitly "
    "deferred there (DR-002's Revision section, 'Scope of this "
    "revision') as the next one-lever-per-increment step -- done here, "
    "issue #112. See item 21 in this module's own docstring."
)
#: Why n_r2 moved again, 50 -> 51, and why N_R2_COARSE followed it 48 -> 49.
#: Not a layout-side finding -- transcribes issue #178's schematic-side
#: sizing decision, which is itself a consequence of finally MODELLING the
#: chained topology RES_HEAD_RESISTANCE_NOTE quantifies instead of sizing
#: around it.
RES_HEAD_SIZING_NOTE = (
    "DR-003 (RES_HEAD_RESISTANCE_NOTE) established that this flow's drawn "
    "decomposition pays the model card's per-instance head/end resistance "
    "once per separately-contacted primitive, and issue #99 resized n_r2 "
    "54 -> 50 so the DRAWN part's K = R2/R1 landed in spec. What it did "
    "NOT do was model that chain in design/bandgap_core.sch, whose "
    "XR1/XR2A/XR2B lines stayed single-device -- so the schematic-level "
    "harness simulated a K about 9% below the drawn part's and read "
    "VOUT(27 degC) ~1.165 V, ~36 mV low. Issue #178 closes that: the "
    "schematic now carries an EXACT lumped equivalent of the N-instance "
    "chain (a body device plus a replica whose drop is multiplied by N-1, "
    "verified identical to an explicit 143-instance chain to 7 significant "
    "figures over the whole -40..125 degC sweep), and with one model "
    "describing both representations n_r2 was re-derived against DR-005's "
    "RATIFIED +/-2 % untrimmed accuracy row (1.176-1.224 V) rather than "
    "the superseded draft +/-1 % window: n_r2=50 leaves vref_min ~1.3 mV "
    "under the floor at every corner, n_r2=52 puts vref_max over the "
    "ceiling at 6 of 15 (process, supply) points, and n_r2=51 sits inside "
    "with 10.0 mV bottom / 6.2 mV top margin at all 15 while cutting box "
    "TC from 175-182 to 142-159 ppm/degC. n_r1 stays at 7 for "
    "RES_RESIZE_NOTE's reason (branch current, hot-corner headroom); no "
    "operating-point collapse is seen at ff/2.97 V or fs/2.97 V at either "
    "n_r2=51 or 52. Drawn-side consequence, and the only one: holding "
    "`5*N_R2_COARSE + 0.5*N_R2_TRIM_UNITS == 5*SCH_N_R2` at the new "
    "SCH_N_R2=51 moves N_R2_COARSE 48 -> 49 (255 um/leg). The fine "
    "ladder's unit count, DR-002's certified 0..-16 downward range and "
    "every other drawn parameter are untouched. Evidence: "
    "sim/output-voltage-tc/records/ (45-point PVT, schematic) and "
    "sim/output-voltage-tc-post-layout/records/ (extracted)."
)

# ---------------------------------------------------------------------------
# Floorplan geometry constants (um)
# ---------------------------------------------------------------------------
#: Outward `direction_deg` each `klt gen` port family faces.
DIRECTION_EAST = 0
DIRECTION_NORTH = 90
DIRECTION_WEST = 180

BLOCK_MARGIN_UM = 16.0  # clearance between blocks placed side by side in a row
ROW_MARGIN_UM = 22.0  # clearance between stacked rows
RING_MARGIN_UM = 8.0  # clearance between the composed content and the outer ring
RING_WIDTH_UM = 2.0
RING_CONTACTS_PER_SIDE = 8
ROUTE_WIDTH_UM = 0.5

# ---------------------------------------------------------------------------
# Schematic parameters, transcribed from design/bandgap_core.sch's CORE_PARAMS
# and design/error_amp.sch. Every block's generator params below are derived
# from these, so a schematic parameter change is a one-line edit here.
# ---------------------------------------------------------------------------
N_PNP_CTAT = 8
N_PNP_PTAT = 8
#: The sky130 poly-resistor flavour design/bandgap_core.sch specifies
#: (`sky130_fd_pr__res_high_po`), as the `klt gen res_array` `flavor` param
#: names it and as the extraction deck's `ResistorDevice.name` reports it.
RES_FLAVOR = "high"
RES_CLASS = "res_high_po"
R_W_UM = 1.0
R_LSEG_UM = 5.0
#: Fine trim-unit body length (um), design/bandgap_core.sch's
#: `r_lseg_trim=0.5` (halved 1 -> 0.5 by issue #106/PR #111 to restore
#: DR-002's chained-topology LSB comfort bound; see RES_TRIM_LSB_NOTE).
R_LSEG_TRIM_UM = 0.5
#: Held at 7, unchanged by issue #99/#108's n_r2 resize: DR-003's closure
#: deliberately left n_r1 fixed so the resize corrects K = R2/R1 without
#: raising the branch current (and therefore the hot-corner headroom the
#: ff/2.97V, fs/2.97V regulation-collapse margin depends on). See
#: RES_RESIZE_NOTE.
N_R1 = 7
#: The R2 divider leg's **drawn** decomposition (issue #91, re-transcribed
#: to the resized sizing by issue #108, then re-partitioned by issue #112
#: when the fine unit's drawn length halved). The schematic states one
#: length per leg -- `L = r_lseg*n_r2 + r_lseg_trim*n_r2_trim` = 5*50 +
#: 0.5*0 = 250 um at DR-002's untrimmed code 0 (n_r2=50 since issue #99/
#: PR #105; r_lseg_trim halved 1 -> 0.5 by issue #106/PR #111, see
#: RES_TRIM_LSB_NOTE) -- and the layout has to reproduce *that* number
#: while still offering DR-002's downward-only trim codes. It does so by
#: splitting the 250 um, not by adding to it: 48 coarse 5 um units
#: (240 um) in `res_r2` plus 20 fine 0.5 um units (10 um) in `res_trim`.
#: Joining the leg's low node at the far end of the fine chain is then
#: exactly 250 um = code 0, and every tap short of that end *subtracts*
#: 0.5 um per skipped unit -- the only direction DR-002 permits.
#:
#: Before issue #91 the coarse leg was drawn at the full pre-resize count
#: (54 units, 270 um) and the fine ladder was wired in series *after* it,
#: so the drawn leg was 286 um and every tap moved it further up: trim
#: code +16, which DR-002 rejects outright. See RES_TRIM_LENGTH_NOTE.
#:
#: 48/20 is the coarse count DR-002's revision forces to hold the leg
#: fixed at 250 um: `N_R2_TRIM_UNITS` stays 20 (the revision re-partitions
#: the fixed leg length between coarse and fine segments; it does not
#: touch the fine ladder's unit *count*, so all 20 units -- and DR-002's
#: certified 0..-16 downward range -- are still reachable), so
#: `N_R2_COARSE` has to absorb the 0.5 um/unit reduction across all 20
#: units (10 um) to keep `5*N_R2_COARSE + 0.5*20 == 250`: 46 -> 48. See
#: RES_RESIZE_NOTE for why the leg length itself moved (issue #99) and
#: RES_TRIM_LSB_NOTE for why the fine unit length itself halved
#: (issue #106).
#: 48 -> 49 by issue #178 (n_r2 50 -> 51 re-centres the untrimmed VREF
#: inside DR-005's ratified +/-2 % window once the schematic itself models
#: the chained array's per-instance head resistance -- see
#: design/bandgap_core.sch's CHAINED-ARRAY MODEL / SIZING blocks and
#: RES_HEAD_SIZING_NOTE). The fine ladder's unit count is untouched, so
#: `5*49 + 0.5*20 == 255 == 5*51` still holds the leg at the specified
#: length and DR-002's certified 0..-16 downward range is still reachable.
N_R2_COARSE = 49
N_R2_TRIM_UNITS = 20
#: DR-002's **certified** downward code range (0..-16, per leg). The drawn
#: ladder can express 0..-20 -- codes -17..-20 are drawn metal but outside
#: the range spec/decision-records/DR-002-trim-network-scoping.md certifies,
#: and :func:`trim_tap_ladder` marks them as such rather than offering them
#: as valid.
N_R2_TRIM_CODES = 16
#: The specified side of the same comparison, transcribed verbatim from
#: design/bandgap_core.sch's CORE_PARAMS so :func:`r2_leg_length` can state
#: both sides from one place. Deliberately kept as its own constants rather
#: than folded into the drawn ones above: the whole point of the check is
#: that the drawn decomposition and the specified length are independent
#: statements that must agree.
SCH_R_LSEG_UM = 5.0  # .param r_lseg=5
#: 54 -> 50 by issue #99/PR #105 (DR-003's closure); 50 -> 51 by issue #178
#: (chained-array model + DR-005 re-centring); see RES_RESIZE_NOTE and
#: RES_HEAD_SIZING_NOTE.
SCH_N_R2 = 51  # .param n_r2=51
#: 1 -> 0.5 by issue #106/PR #111 (DR-002's chained-LSB revision); see
#: RES_TRIM_LSB_NOTE.
SCH_R_LSEG_TRIM_UM = 0.5  # .param r_lseg_trim=0.5
SCH_N_R2_TRIM = 0  # .param n_r2_trim=0 (DR-002's untrimmed code)
#: The per-leg length design/bandgap_core.sch specifies, in um (250.0 since
#: the issue #99/#108 resize -- unchanged by issue #112's r_lseg_trim
#: halving, since SCH_N_R2_TRIM=0 makes the trim term a no-op here; was
#: 270.0 before #99/#108).
R2_LEG_SPEC_UM = SCH_R_LSEG_UM * SCH_N_R2 + SCH_R_LSEG_TRIM_UM * SCH_N_R2_TRIM
M_OUT = 2
#: Halved 16 -> 8 by issue #170 (DR-008 Option B): design/error_amp.sch's
#: `.param amp_m_in=8` -- the amp's own PSRR-band margin increase that
#: absorbs the routed layout's measured -4.05 dB post-layout PSRR shift
#: (DR-008). Smaller input pair means less capacitive loading on D1/D2,
#: which raises the amplifier's own non-dominant-pole frequency and with it
#: psrr_band_min at every schematic-level PVT corner (62.6-66.7 dB baseline
#: -> 70.2-81.5 dB); see error_amp.sch's own header for the full rationale
#: and the levers that were tried and empirically rejected first.
AMP_M_IN = 8
AMP_M_NMIRR = 4
AMP_M_PMIRR = 8
#: MCC, the error amp's Miller compensation cap (design/error_amp.sch,
#: `.param amp_m_cc=16`) -- a `pfet_g5v0d10v5` wired D=S=B=VDD, G=GDRV, so it
#: sits in inversion and behaves as a ~21 pF MOS capacitor at every PVT
#: corner (design/error_amp.sch's own MCC comment block). See
#: MCC_MIM_INFEASIBLE_NOTE for why this is drawn as the MOS cap the
#: schematic states rather than a `cap_mim` overlay.
AMP_M_CC = 16

# ---------------------------------------------------------------------------
# Startup-injector parameters, transcribed from design/startup_injector.sch's
# own SU_PARAMS block and its six device cards (issue #285). Until this
# increment the injector was drawn only as a schematic and the composed cell
# shipped without it, which is what made row 8e of
# design/block-characterization-report.md a by-construction FAIL and what
# made every post-layout row a measurement of a circuit the schematic rows do
# not describe. See STARTUP_INJECTOR_NOTE.
# ---------------------------------------------------------------------------
#: MPC1/MPC2, the two-high diode-connected PMOS reference fed *from* GDRV
#: (`.param m_ref=1`, W=1 L=20 each). Both are `pfet_g5v0d10v5` with their
#: bulk on VDD, so they are one matched pair in one n-well -- exactly the
#: shape `klt gen diff_pair` draws, and the only injector devices that pair
#: at all (every other one has its own W/L).
SU_W_REF_UM = 1.0
SU_L_REF_UM = 20.0
M_SU_REF = 1
#: MNS, the sense NMOS whose gate is the core's own VOUT (`.param
#: m_sense=1`, W=48 L=0.5).
SU_W_SENSE_UM = 48.0
SU_L_SENSE_UM = 0.5
M_SU_SENSE = 1
#: MNI, the injector NMOS that evicts the degenerate state by pulling GDRV
#: down (`.param m_inj=1`, W=10 L=0.5).
SU_W_INJ_UM = 10.0
SU_L_INJ_UM = 0.5
M_SU_INJ = 1
#: MNC, the railed-branch clamp (issue #52; `.param m_clamp=1`, W=4 L=1).
SU_W_CLAMP_UM = 4.0
SU_L_CLAMP_UM = 1.0
M_SU_CLAMP = 1
#: QS, the diode-connected PNP that references MNS's release threshold to a
#: VBE (`.param m_pnp=8`) -- the same `pnp_05v5_W0p68L0p68` unit device the
#: core's CTAT array uses, at the same 8-unit count, so it is drawn with the
#: identical `bjt_array` params as `pnp_ctat`.
N_PNP_SU = 8

#: Why the injector's three single-transistor blocks are `mos_array` rather
#: than `diff_pair`, and why that needs no new intra-block bus kind.
STARTUP_INJECTOR_NOTE = (
    "design/startup_injector.sch has six devices and only ONE matched pair "
    "among them: MPC1/MPC2, the two-high diode-connected PMOS reference "
    "(both W=1 L=20, both bulk-on-VDD), which is drawn as a `diff_pair` "
    "with `splits=1` and bussed by the same `bus_mos_comb` every other MOS "
    "group in this cell uses. MNS (W=48 L=0.5), MNI (W=10 L=0.5) and MNC "
    "(W=4 L=1) share no W/L with anything, so each is a `mos_array` at "
    "`rows=1, cols=1, dummy=0` -- a single unit device. A one-unit array "
    "has no fingers to bus, so those three blocks declare no `bus` entry at "
    "all and the inter-block router reaches their `U0_S`/`U0_D`/`U0_G` pads "
    "directly through the same named-pad terminal shape the resistor blocks "
    "use. They are the only MOS blocks here generated with the generator's "
    "own `gate_contact` param: the `diff_pair` groups get their gate licon "
    "and li1 riser drawn by this flow instead (met1_bus.gate_contact, "
    "MOS_GATE_NOTE), which is the cheaper choice across 52 pfet fingers but "
    "buys nothing on a single device -- and `gate_contact` is what turns "
    "`U0_G` from a bare-poly port into the li1 pad a met1 route can via "
    "down to."
)

#: What the composed cell now measures, and what it did not before. Kept as a
#: note rather than a comment because record.md quotes it: the extracted
#: netlist every post-layout bench runs on is only a netlist of the ratified
#: schematic if the injector is in it.
STARTUP_COMPOSED_NOTE = (
    "Before this increment the composed cell was the core + error amplifier "
    "only. `design/startup_injector.sch` was drawn as a schematic block and "
    "never laid out, so `klt extract` on the composed GDS produced a "
    "netlist of a DIFFERENT circuit from the one the schematic-level "
    "benches measure -- and the two startup rows of "
    "design/block-characterization-report.md said so: row 8a (schematic, "
    "core+injector) PASSed while row 8e (composed, no injector) FAILed "
    "45/45 by construction. LVS was clean across that gap because both "
    "sides of the comparison omitted the injector: `reference.spice` "
    "transcribed `design/bandgap_core.sch` alone. Both sides now carry it "
    "-- six devices (MPC1, MPC2, MNS, MNI, MNC, QS) and three nodes "
    "internal to the injector (NC1, NG, NE) -- so the extracted netlist is "
    "a netlist of the whole ratified design and the post-layout suite "
    "measures the circuit the schematic rows describe. VSENSE is not a "
    "separate node in the composed cell: design/startup_injector.sym's "
    "VSENSE input is driven by the core's VOUT, so MNS's and MNC's gates "
    "land on the drawn VOUT net directly."
)

# ---------------------------------------------------------------------------
# Block definitions. Each maps to one `klt gen` call. `row` groups blocks into
# stacked bands; blocks within a row are placed left-to-right in the order
# listed. Relative to gen_bandgap_floorplan.py's BLOCKS this list differs in
# exactly three ways, each of them load-bearing for this issue:
#
#   * `res_r2` is at its real full-length count (96 coarse units, still 10
#     rows; with `res_trim`'s 40 fine units that is the schematic's 250
#     um/leg, the issue #106/#112-repartitioned sizing -- was 92 coarse
#     units before, and 100 coarse units/270 um-leg before that (issue
#     #99/#108), same 10-row fold every time).
#   * every guard/collector ring is back **on**, each with a routing opening
#     (upstream klayout-tools#441's `ring_gap_side`), retiring the PR #64
#     trade-off recorded in layout/matching-plan.md Section 5a.
#   * each block declares the intra-block `bus` its matched group needs, drawn
#     on met1 (MET1_BUS_NOTE). A block with no `bus` entry is one whose units
#     cannot be bussed at all today -- every MOS group, for the gate-contact
#     reason in MOS_GATE_NOTE.
# ---------------------------------------------------------------------------
BLOCKS: list[dict[str, Any]] = [
    {
        "id": "pnp_ctat",
        "row": 0,
        "align": "bottom",
        "generator": "bjt_array",
        "params": {
            "emitter_um": 0.68,
            "rows": 2,
            "cols": 4,
            "dummy": 1,
            "ratio": 8,
            "topology": "common_centroid",
            "add_collector_ring": True,
            "ring_gap_side": "N",
            "ring_gap_um": 2.0,
        },
        "bus": {"kind": "bjt_parallel", "nets": {"_E": "VA", "_B": "VSS"}},
        "matched_group_label": "Q1 (CTAT PNP, small unit W0p68L0p68)",
        "real_target": f"m={N_PNP_CTAT} sky130_fd_pr__pnp_05v5_W0p68L0p68 "
        "(design/bandgap_core.sch); drawn 1:1 (8 real units, 2x4 "
        "common-centroid)",
    },
    {
        "id": "res_r2",
        "row": 0,
        "generator": "res_array",
        "params": {
            "length_um": R_LSEG_UM,
            "width_um": R_W_UM,
            "spacing_um": 0.5,
            "flavor": RES_FLAVOR,
            "num": 2 * N_R2_COARSE,
            "dummy": 2,
            # Kept at 10 (unchanged from the pre-resize 100-unit count),
            # empirically re-verified against both the issue #108 resize's
            # 92-unit count and (this increment, issue #112) the 96-unit
            # count DR-002's r_lseg_trim revision forces, rather than
            # re-derived from a divisibility rule each time. `res_array`'s
            # `rows` fold (2AMLogic/klayout-tools#415/#418) does NOT require
            # an exact divisor of `num` -- klt happily folds a remainder into
            # a shorter last row -- but this repo's OWN `bus_res_series`
            # (below), which draws the fold-TURN met1 jumper at each row
            # boundary as a hand-routed corner hop, is not guaranteed
            # fold-shape-agnostic: at the 92-unit count, re-running the full
            # routed flow at every divisor of 92 (2, 4, 23, 46) put the
            # composed cell over the 50,000 um^2 budget in every case, and a
            # scan of nearby non-divisor counts found two (9, 11) where a
            # subset of leg-1 fold-turn hops fail to route (bus-summary.json's
            # `res_r2.links` reports `"routed": false`), splitting R2B's
            # series chain and taking `klt lvs`'s `mismatch_count` from 1 to
            # 15-18 -- a real connectivity defect, not a value mismatch. 10
            # was re-verified clean at 92 (issue #108) and, this increment,
            # re-verified again at the new 96-unit count: all 94 fold-turn
            # links route with zero failures, zero drawn-short conflicts,
            # DRC clean, and `mismatch_count=1` (just the deliberately-
            # undrawn MMCC); the composed cell lands at 45,968 um^2, matching
            # every prior increment's figure exactly (the 4 extra coarse
            # units' length is offset by the fine ladder's 40 units each
            # shrinking 0.5 um). See RES_RESIZE_NOTE for why N_R2_COARSE
            # first moved (issue #99/#108) and RES_TRIM_LSB_NOTE for why it
            # moved again (issue #106/#112).
            "rows": 10,
        },
        "bus": {"kind": "res_series", "legs": 2},
        "matched_group_label": "R2A/R2B interdigitated ladder (K = R2/R1 divider)",
        "real_target": f"{N_R2_COARSE} coarse {R_LSEG_UM:.0f}um segments PER "
        f"LEG x 2 legs = {2 * N_R2_COARSE} total = "
        f"{R_LSEG_UM * N_R2_COARSE:.0f} um/leg, the coarse part of "
        f"design/bandgap_core.sch's {R2_LEG_SPEC_UM:.0f} um "
        f"(`r_lseg*n_r2` at n_r2={SCH_N_R2}); the remaining "
        f"{R_LSEG_TRIM_UM * N_R2_TRIM_UNITS:.0f} um is `res_trim`'s fine "
        "ladder, so the trim taps subtract from the specified length instead "
        "of adding to it (issue #91). The skeleton's 16-unit reduction is "
        "closed by `res_array`'s `rows` fold parameter "
        "(2AMLogic/klayout-tools#415, merged via #418)",
    },
    {
        "id": "res_trim",
        "row": 0,
        "align": "top",
        "generator": "res_array",
        "params": {
            "length_um": R_LSEG_TRIM_UM,
            "width_um": R_W_UM,
            "spacing_um": 0.5,
            "flavor": RES_FLAVOR,
            "num": 2 * N_R2_TRIM_UNITS,
            "dummy": 2,
            "rows": 4,
        },
        "bus": {"kind": "res_series", "legs": 2},
        "matched_group_label": "Downward-only trim ladder taps (both legs)",
        "real_target": f"{N_R2_TRIM_UNITS} fine {R_LSEG_TRIM_UM:.1f}um units "
        f"PER LEG x 2 legs = {2 * N_R2_TRIM_UNITS} unit taps, the fine part "
        f"of the same {R2_LEG_SPEC_UM:.0f} um leg -- code 0 puts all "
        f"{N_R2_TRIM_UNITS} in circuit and code -k skips k of them, so the "
        f"ladder spans 0..-{N_R2_TRIM_UNITS} of which DR-002 certifies "
        f"0..-{N_R2_TRIM_CODES} (design/bandgap_core.sch CORE_PARAMS, "
        "DR-002); drawn 1:1",
    },
    {
        "id": "res_r1",
        "row": 0,
        "align": "top",
        "generator": "res_array",
        "params": {
            "length_um": R_LSEG_UM,
            "width_um": R_W_UM,
            "spacing_um": 0.5,
            "flavor": RES_FLAVOR,
            "num": N_R1,
            "dummy": 2,
            "rows": 1,
        },
        "bus": {"kind": "res_series", "legs": 1},
        "matched_group_label": "R1 (dVBE-to-current leg)",
        "real_target": f"n_r1={N_R1} unit segments (design/bandgap_core.sch); "
        "drawn 1:1",
    },
    {
        "id": "pnp_ptat",
        "row": 0,
        "align": "bottom",
        "generator": "bjt_array",
        "params": {
            "emitter_um": 3.40,
            "rows": 2,
            "cols": 4,
            "dummy": 1,
            "ratio": 8,
            "topology": "common_centroid",
            "add_collector_ring": True,
            "ring_gap_side": "N",
            "ring_gap_um": 2.0,
        },
        "bus": {"kind": "bjt_parallel", "nets": {"_E": "VBQ", "_B": "VSS"}},
        "matched_group_label": "Q2 (PTAT PNP, large unit W3p40L3p40)",
        "real_target": f"m={N_PNP_PTAT} sky130_fd_pr__pnp_05v5_W3p40L3p40 "
        "(design/bandgap_core.sch); drawn 1:1 (8 real units, 2x4 "
        "common-centroid)",
    },
    {
        "id": "core_mirror",
        "row": 1,
        "generator": "diff_pair",
        "params": {
            "w_um": 8.0,
            "l_um": 2.0,
            "splits": M_OUT,
            "flavor": "pfet",
            "mirror": True,
            "add_guard_ring": True,
            "ring_gap_side": "W",
            "ring_gap_um": 2.0,
        },
        "bus": {
            "kind": "mos_comb",
            "spine_side": "W",
            "nets": [
                {"net": "VDD",
                 "terminals": [("MPOUT", "source"), ("MPAMP", "source")]},
                {"net": "GDRV",
                 "terminals": [("MPOUT", "gate"), ("MPAMP", "gate")]},
                {"net": "TAIL", "terminals": [("MPAMP", "drain")]},
                {"net": "VOUT", "terminals": [("MPOUT", "drain")]}
            ],
        },
        "matched_group_label": "MPOUT/MPAMP (core PMOS output/bias mirror)",
        "real_target": f"m_out=m_ampbias={M_OUT}, W=8 L=2 "
        "(design/bandgap_core.sch); drawn 1:1",
    },
    {
        "id": "amp_input_pair",
        "row": 1,
        "generator": "diff_pair",
        "params": {
            "w_um": 20.0,
            "l_um": 10.0,
            "splits": AMP_M_IN,
            "flavor": "pfet",
            "mirror": False,
            "add_guard_ring": True,
            "ring_gap_side": "W",
            "ring_gap_um": 2.0,
        },
        "bus": {
            "kind": "mos_comb",
            "spine_side": "W",
            "nets": [
                {"net": "D1", "terminals": [("MP1", "drain")]},
                {"net": "D2", "terminals": [("MP2", "drain")]},
                {"net": "VB", "terminals": [("MP1", "gate")]},
                {"net": "VA", "terminals": [("MP2", "gate")]},
                {"net": "TAIL",
                 "terminals": [("MP1", "source"), ("MP2", "source")]}
            ],
        },
        "matched_group_label": "MP1/MP2 (amp PMOS input pair)",
        "real_target": f"amp_m_in={AMP_M_IN}, W=20 L=10 "
        "(design/error_amp.sch); drawn 1:1 -- the dominant mismatch "
        "contributor per layout/matching-plan.md Section 1",
    },
    {
        "id": "amp_nload",
        "row": 1,
        "generator": "diff_pair",
        "params": {
            "w_um": 8.0,
            "l_um": 20.0,
            "splits": AMP_M_NMIRR,
            "flavor": "nfet",
            "mirror": True,
            "add_guard_ring": True,
            "ring_gap_side": "W",
            "ring_gap_um": 2.0,
        },
        "bus": {
            "kind": "mos_comb",
            "spine_side": "E",
            "nets": [
                {"net": "D1",
                 "terminals": [("MN1", "drain"), ("MN1", "gate")]},
                {"net": "D2",
                 "terminals": [("MN2", "drain"), ("MN2", "gate")]},
                {"net": "VSS",
                 "terminals": [("MN1", "source"), ("MN2", "source")]}
            ],
        },
        "matched_group_label": "MN1/MN2 (amp NMOS diode loads)",
        "real_target": f"amp_m_nmirr={AMP_M_NMIRR}, W=8 L=20 "
        "(design/error_amp.sch); drawn 1:1",
    },
    {
        "id": "amp_pmirr",
        "row": 2,
        "generator": "diff_pair",
        "params": {
            "w_um": 6.0,
            "l_um": 20.0,
            "splits": AMP_M_PMIRR,
            "flavor": "pfet",
            "mirror": True,
            "add_guard_ring": True,
            "ring_gap_side": "W",
            "ring_gap_um": 2.0,
        },
        "bus": {
            "kind": "mos_comb",
            "spine_side": "W",
            "nets": [
                {"net": "GDRV", "terminals": [("MP4", "drain")]},
                {"net": "PN",
                 "terminals": [("MP3", "drain"), ("MP3", "gate"),
                               ("MP4", "gate")]},
                {"net": "VDD",
                 "terminals": [("MP3", "source"), ("MP4", "source")]}
            ],
        },
        "matched_group_label": "MP3/MP4 (amp PMOS mirror)",
        "real_target": f"amp_m_pmirr={AMP_M_PMIRR}, W=6 L=20 "
        "(design/error_amp.sch); drawn 1:1",
    },
    {
        "id": "amp_nmirr",
        "row": 2,
        "generator": "diff_pair",
        "params": {
            "w_um": 8.0,
            "l_um": 20.0,
            "splits": AMP_M_NMIRR,
            "flavor": "nfet",
            "mirror": True,
            "add_guard_ring": True,
            "ring_gap_side": "W",
            "ring_gap_um": 2.0,
        },
        "bus": {
            "kind": "mos_comb",
            "spine_side": "E",
            "nets": [
                {"net": "GDRV", "terminals": [("MN3", "drain")]},
                {"net": "PN", "terminals": [("MN4", "drain")]},
                {"net": "D1", "terminals": [("MN3", "gate")]},
                {"net": "D2", "terminals": [("MN4", "gate")]},
                {"net": "VSS",
                 "terminals": [("MN3", "source"), ("MN4", "source")]}
            ],
        },
        "matched_group_label": "MN3/MN4 (amp NMOS mirror outputs)",
        "real_target": f"amp_m_nmirr={AMP_M_NMIRR}, W=8 L=20 "
        "(design/error_amp.sch); drawn 1:1",
    },
    # --- design/startup_injector.sch (issue #285) ---------------------------
    # All five injector blocks share row 3 with `amp_cc` rather than opening a
    # row of their own, and that is an AREA decision, not a routing one: row 3
    # is 63.38 um tall (amp_cc sets it) and 102 um narrower than the widest
    # row, so five blocks whose tallest is MNS's 48.82 um fit inside the
    # height the floorplan already pays for. A sixth row would have cost
    # ROW_MARGIN_UM + 48.82 um of new height across the cell's full width --
    # ~21,000 um^2, which lands the composed cell over DR-007's 80,000 um^2
    # budget. Widening one existing row costs ~4,000 um^2 instead. See
    # STARTUP_INJECTOR_NOTE for the generator choice and
    # STARTUP_COMPOSED_NOTE for what drawing them changes about the evidence.
    {
        "id": "su_clamp",
        "row": 3,
        "align": "bottom",
        "generator": "mos_array",
        "params": {
            "w_um": SU_W_CLAMP_UM,
            "l_um": SU_L_CLAMP_UM,
            "rows": 1,
            "cols": 1,
            "dummy": 0,
            "flavor": "nfet",
            "gate_contact": True,
        },
        "matched_group_label": "MNC (railed-branch clamp NMOS, issue #52)",
        "real_target": f"m_clamp={M_SU_CLAMP}, W={SU_W_CLAMP_UM:.0f} "
        f"L={SU_L_CLAMP_UM:.0f} (design/startup_injector.sch); drawn 1:1 as "
        "a single unit device -- it pairs with nothing else in the cell",
    },
    {
        "id": "su_sense",
        "row": 3,
        "generator": "mos_array",
        "params": {
            "w_um": SU_W_SENSE_UM,
            "l_um": SU_L_SENSE_UM,
            "rows": 1,
            "cols": 1,
            "dummy": 0,
            "flavor": "nfet",
            "gate_contact": True,
        },
        "matched_group_label": "MNS (VBE-referenced sense NMOS)",
        "real_target": f"m_sense={M_SU_SENSE}, W={SU_W_SENSE_UM:.0f} "
        f"L={SU_L_SENSE_UM:.1f} (design/startup_injector.sch); drawn 1:1 as "
        "a single unit device, gate on the core's own VOUT (the schematic's "
        "VSENSE input)",
    },
    {
        "id": "pnp_su",
        "row": 3,
        "align": "bottom",
        "generator": "bjt_array",
        "params": {
            "emitter_um": 0.68,
            "rows": 2,
            "cols": 4,
            "dummy": 1,
            "ratio": 8,
            "topology": "common_centroid",
            "add_collector_ring": True,
            "ring_gap_side": "N",
            "ring_gap_um": 2.0,
        },
        "bus": {"kind": "bjt_parallel", "nets": {"_E": "NE", "_B": "VSS"}},
        "matched_group_label": "QS (startup threshold PNP, small unit "
        "W0p68L0p68)",
        "real_target": f"m_pnp={N_PNP_SU} sky130_fd_pr__pnp_05v5_W0p68L0p68 "
        "(design/startup_injector.sch); drawn 1:1 (8 real units, 2x4 "
        "common-centroid) -- the identical unit device and count as "
        "`pnp_ctat`, so it is drawn with identical params",
    },
    {
        "id": "su_ref",
        "row": 3,
        "generator": "diff_pair",
        "params": {
            "w_um": SU_W_REF_UM,
            "l_um": SU_L_REF_UM,
            "splits": M_SU_REF,
            "flavor": "pfet",
            "mirror": True,
            "add_guard_ring": True,
            "ring_gap_side": "W",
            "ring_gap_um": 2.0,
        },
        "bus": {
            "kind": "mos_comb",
            "spine_side": "W",
            "nets": [
                {"net": "NC1",
                 "terminals": [("MPC1", "drain"), ("MPC1", "gate"),
                               ("MPC2", "source")]},
                {"net": "NG",
                 "terminals": [("MPC2", "drain"), ("MPC2", "gate")]},
                # GDRV last, so it is the node that also gets a spine-side
                # escape (it has the most partners off this block). At
                # `splits=1` each device is a single unit in a single device
                # row, so this block's three nodes never put more than two
                # lanes in the same 1 um row -- see the per-row dense rank in
                # bus_mos_comb and MOS_LANE_PITCH_UM.
                {"net": "GDRV", "terminals": [("MPC1", "source")]},
            ],
        },
        "matched_group_label": "MPC1/MPC2 (two-high diode-connected PMOS "
        "reference, fed from GDRV)",
        "real_target": f"m_ref={M_SU_REF}, W={SU_W_REF_UM:.0f} "
        f"L={SU_L_REF_UM:.0f} each (design/startup_injector.sch); drawn 1:1 "
        "-- the injector's only matched pair, and the only one of its six "
        "devices a `diff_pair` can express. NC1, the node between the two "
        "diodes, is entirely internal to this block and is drawn by its own "
        "intra-block comb",
    },
    {
        "id": "su_inj",
        "row": 3,
        "generator": "mos_array",
        "params": {
            "w_um": SU_W_INJ_UM,
            "l_um": SU_L_INJ_UM,
            "rows": 1,
            "cols": 1,
            "dummy": 0,
            "flavor": "nfet",
            "gate_contact": True,
        },
        "matched_group_label": "MNI (degenerate-state eviction NMOS)",
        "real_target": f"m_inj={M_SU_INJ}, W={SU_W_INJ_UM:.0f} "
        f"L={SU_L_INJ_UM:.1f} (design/startup_injector.sch); drawn 1:1 as a "
        "single unit device",
    },
    {
        "id": "amp_cc",
        "row": 3,
        "generator": "diff_pair",
        "params": {
            "w_um": 30.0,
            "l_um": 20.0,
            "splits": AMP_M_CC // 2,
            "flavor": "pfet",
            "mirror": True,
            "add_guard_ring": True,
            "ring_gap_side": "W",
            "ring_gap_um": 2.0,
        },
        "bus": {
            "kind": "mos_comb",
            "spine_side": "W",
            "nets": [
                {"net": "VDD",
                 "terminals": [("MCC_A", "drain"), ("MCC_A", "source"),
                               ("MCC_B", "drain"), ("MCC_B", "source")]},
                {"net": "GDRV",
                 "terminals": [("MCC_A", "gate"), ("MCC_B", "gate")]},
            ],
        },
        "matched_group_label": "MCC (amp Miller compensation cap, "
        "PMOS-as-capacitor)",
        "real_target": f"amp_m_cc={AMP_M_CC}, W=30 L=20 "
        "(design/error_amp.sch); drawn as two mult="
        f"{AMP_M_CC // 2} groups (`MCC_A`/`MCC_B`) tied identically to "
        "VDD (drain+source) and GDRV (gate) so `combine_devices` folds "
        f"them into the schematic's single m={AMP_M_CC} device -- see "
        "MCC_MIM_INFEASIBLE_NOTE for why a `cap_mim` overlay (the "
        "operator's primary-path ruling on issue #62) cannot close this "
        "device instead",
    },
]

#: Why MCC is drawn as the same MOS-as-capacitor device the schematic
#: states, rather than a sky130 `cap_mim` overlay (the operator's
#: 2026-08-11 primary-path ruling on issue #62) -- checked, not assumed,
#: on two independent grounds:
#:
#: 1. **LVS device-class matching.** `reference.spice` states `MMCC` as a
#:    plain `M`-element (`MMCC VDD GDRV VDD VDD pfet L=20U W=30U m=16`), so
#:    `klt lvs` registers it under the deck's `pfet_class` (`"pfet"`,
#:    `DeviceClassMOS4Transistor`, terminals D/G/S/B). A drawn `cap_mim`
#:    overlay extracts as `klayout_tools.decks.sky130`'s
#:    `sky130_fd_pr__model__cap_mim` class instead (a two-terminal
#:    `DeviceClassCapacitor`, P1/P2) -- a different class *name* with a
#:    different terminal arity. `klt lvs` (`src/klayout_tools/lvs.py`,
#:    confirmed by reading `_apply_hints`) exposes no device-class
#:    equivalence declaration (only `hints.same_nets` and
#:    `hints.equivalent_pins`, both net/pin-level); when
#:    `NetlistComparer` pairs devices of different classes it reports
#:    `match_devices_with_different_device_classes`, which
#:    `_build_mismatches` turns into a `device.class`-category mismatch
#:    (still `mismatch_count` >= 1), and when the two classes cannot even
#:    be topologically paired (very likely here: 2-terminal vs. 4-terminal)
#:    each side reports its own unmatched device instead -- `mismatch_count`
#:    2, not fewer. So a `cap_mim` overlay cannot reach `mismatch_count: 0`
#:    against the *current* `reference.spice`, independent of area --
#:    unless the reference netlist's own `MMCC` card is rewritten to a
#:    capacitor model, which would be a schematic-level device-type change
#:    to a closed, sim-verified cell (out of this issue's scope; see the
#:    operator's "Redesign the compensation smaller" note).
#: 2. **Tooling.** The twenty-ninth increment (PR #124, `Part of #62`)
#:    independently confirmed a `cap_mim` overlay is not drawable at all
#:    with the pinned `klt`: neither of sky130's `CapacitorDevice` entries
#:    sets `top_plate_via`/`top_plate_via_metal`, so every reproduction
#:    tried either extracted the two plates as disconnected islands, or
#:    false-shorted them, or left the top plate's via unreachable. Filed as
#:    2AMLogic/klayout-tools#775; see `layout/matching-plan.md` Section 7bb
#:    and `spec/decision-records/DR-007-mcc-area-budget.md` for the full
#:    reproduction.
#:
#: Both findings independently rule out the MIM-overlay path today --
#: (1) would still block even if (2) is fixed upstream, since it is a
#: netlist-shape fact about `klt lvs`'s comparer, not a drawing-capability
#: gap. This increment therefore proceeds straight to the ruling's own
#: fallback: draw MCC in-plane as the MOS cap it already is in
#: design/error_amp.sch.
MCC_MIM_INFEASIBLE_NOTE = (
    "MCC is drawn as a pfet_g5v0d10v5 MOS-as-capacitor (matching "
    "design/error_amp.sch exactly), not a cap_mim overlay. Two "
    "independent reasons: (1) `reference.spice`'s MMCC card is a plain "
    "pfet M-element, and `klt lvs` has no device-class equivalence "
    "mechanism -- a cap_mim overlay would extract under a different "
    "device class (sky130_fd_pr__model__cap_mim, 2-terminal) and could "
    "not reach mismatch_count: 0 against it regardless of area, only "
    "recategorize or double the one mismatch; (2) PR #124 (issue #62's "
    "twenty-ninth increment) independently found sky130's cap_mim device "
    "recognition cannot wire a top plate out to routing metal without "
    "either a false short or a disconnected net with the currently "
    "pinned klt (2AMLogic/klayout-tools#775, filed). See "
    "layout/matching-plan.md Section 7bb/7cc and "
    "spec/decision-records/DR-007-mcc-area-budget.md."
)

#: Empty since issue #62's fourteenth increment (see SUBSTRATE_NET_NOTE).
#: Through the thirteenth increment this named a `hints.same_nets`
#: declaration (`[["vsubs", "VSS"]]`) because sky130's curated deck
#: synthesized an undrawable `vsubs` net and no drawn shape could join it.
#: klayout-tools#495 (picked up at the fourteenth increment's `klt` pin
#: bump) resolves the deck's substrate identity to a real drawn tap when one
#: is present -- and this layout already draws one, wired to `VSS` -- so the
#: layout side no longer has a `vsubs` net at all. Leaving the stale
#: declaration in `hints.same_nets` after that pin bump is not a no-op: `klt
#: lvs` hard-errors with `hints.same_nets: layout net 'vsubs' not found`
#: instead of running, which is what shipping the pin bump without this
#: change produced (see this increment's own PR description for the
#: measurement). Kept as a named, typed constant (rather than deleted
#: outright) so a future floorplan revision that stops drawing every
#: substrate tap has an obvious place to reintroduce the declaration, with a
#: test that would catch the regression before a flow run does.
SUBSTRATE_SAME_NETS: list[list[str]] = []

MCC_AREA_UM2_NOTE = (
    "MCC (amp compensation cap, amp_m_cc=16 x W=30 x L=20 = 9600 um^2 "
    "analytic) is now drawn, as of issue #62's thirtieth increment -- see "
    "the `amp_cc` block above and MCC_MIM_INFEASIBLE_NOTE for why it is a "
    "MOS-as-capacitor block rather than a cap_mim overlay. Drawing it pushes "
    "the composed cell over the ratified 50,000 um^2 (DR-005) Area budget; "
    "see spec/decision-records/DR-007-mcc-area-budget.md (proposed, not "
    "ratified) and this record's own `within_budget` gate result"
)


# ---------------------------------------------------------------------------
# klt drivers
# ---------------------------------------------------------------------------
# run_klt_json() and klt_gen() live in layout_common.py (issue #169) --
# imported above, alongside met1_bus.


# ---------------------------------------------------------------------------
# Intra-block bussing / inter-block routing
# ---------------------------------------------------------------------------
# Moved to bus_routing.py (issue #221) -- the file's own section banners at
# this position marked it as a self-delimited concern (see this docstring's
# item 5 and item 13). bus_routing.py imports several names (DIRECTION_EAST,
# DIRECTION_WEST, N_R1, N_R2_COARSE, N_R2_TRIM_UNITS, ...) back from *this*
# module at its own top level, to build its own module-level tables
# (MOS_HALVES, INTER_BLOCK_MET1). This file's own uses of bus_routing's
# symbols (`build_bus_overlay`, `trim_tap_port`, `MOS_HALVES`) are therefore
# each imported locally, inside the function that needs them
# (trim_tap_ladder(), compose_inner(), main()), rather than at this file's
# own top level -- a top-level import here would race bus_routing.py's own
# top-level import of this module, and whichever module a caller happens to
# import first would hit the other one mid-load. See bus_routing.py's own
# docstring for the full list of what moved.


# ---------------------------------------------------------------------------
# Placement
# ---------------------------------------------------------------------------
def place_blocks(
    blocks: list[dict[str, Any]], reports: dict[str, dict[str, Any]]
) -> dict[str, dict[str, float]]:
    """Compute an `origins_um` dict for `gen-compose`'s "explicit" strategy.

    Rows are stacked bottom-to-top in `row` order and each row's blocks are
    laid out left-to-right, **vertically centered on the row's own midline**
    rather than bottom-aligned. That centering is what makes an inter-block
    route feasible at all: `klt gen-compose` routes a west-facing `_S`/`_A`
    port to an east-facing `_D`/`_B` port through a single jog, and rejects
    the route outright when the jog would cross a third block's bbox. Rows
    are also spaced with a wide ROW_MARGIN_UM channel so a cross-row route
    has somewhere to go.

    Every number is derived from the blocks' own reported `bbox_um`, never a
    hardcoded coordinate -- so this recomputes correctly if a BLOCKS entry's
    params change.
    """
    rows: dict[int, list[str]] = {}
    alignments: dict[str, str] = {}
    for block in blocks:
        rows.setdefault(block["row"], []).append(block["id"])
        alignments[block["id"]] = block.get("align", "center")

    row_geometry: dict[int, dict[str, float]] = {}
    for row_index, ids in rows.items():
        width = sum(
            reports[bid]["bbox_um"]["x1"] - reports[bid]["bbox_um"]["x0"] for bid in ids
        )
        width += BLOCK_MARGIN_UM * (len(ids) - 1)
        height = max(
            reports[bid]["bbox_um"]["y1"] - reports[bid]["bbox_um"]["y0"] for bid in ids
        )
        row_geometry[row_index] = {"width": width, "height": height}

    overall_width = max(g["width"] for g in row_geometry.values())

    origins: dict[str, dict[str, float]] = {}
    y_cursor = 0.0
    for row_index in sorted(rows):
        ids = rows[row_index]
        row_width = row_geometry[row_index]["width"]
        row_height = row_geometry[row_index]["height"]
        x_cursor = (overall_width - row_width) / 2.0  # center this row
        for bid in ids:
            bbox = reports[bid]["bbox_um"]
            block_width = bbox["x1"] - bbox["x0"]
            block_height = bbox["y1"] - bbox["y0"]
            # Vertical alignment within the row's band. "center" (the
            # default) keeps a west/east port pair between two neighbours on
            # a short jog. "top"/"bottom" exist for one specific, load-bearing
            # reason: a `bjt_array`'s only ports face *north*, so a route into
            # one must descend onto the array from above -- which the router
            # only accepts when the other end's port sits at a y *above* the
            # array's top edge. Pushing the PNP arrays to the bottom of their
            # band and their partner resistor block to the top is what makes
            # that vertical approach legal instead of a rejected
            # plow-through-the-interior backbone.
            align = alignments.get(bid, "center")
            if align == "bottom":
                y_offset = y_cursor
            elif align == "top":
                y_offset = y_cursor + (row_height - block_height)
            else:
                y_offset = y_cursor + (row_height - block_height) / 2.0
            origins[bid] = {"x": x_cursor - bbox["x0"], "y": y_offset - bbox["y0"]}
            x_cursor += block_width + BLOCK_MARGIN_UM
        y_cursor += row_height + ROW_MARGIN_UM

    return origins


# union_bbox() lives in layout_common.py (issue #169) -- imported above.


# ---------------------------------------------------------------------------
# Connectivity
# ---------------------------------------------------------------------------
#: Port-name suffix families each block flavour exposes, and the outward
#: `direction_deg` each faces. `klt gen`'s own generators report these; this
#: table is only a readable index into them, never a second source of truth
#: (every lookup below validates against the block's reported `ports[]`).
#: How many candidate ports per side the router-oracle search below will try
#: before giving up on a net. Kept small: the candidates are ordered by how
#: close they sit to the block edge the route approaches from, so the right
#: one is normally the first or second.
PORT_CANDIDATE_LIMIT = 6


def select_ports(
    report: dict[str, Any],
    suffix: str,
    facing: int,
    toward: str,
    limit: int = PORT_CANDIDATE_LIMIT,
    half: str | None = None,
) -> list[str]:
    """Ordered candidate port names on one block, best-first for a route
    approaching from `toward` ("east"/"west"/"north"/"south").

    `klt gen-compose`'s router draws a straight/single-jog Manhattan backbone
    between two ports and rejects the net outright when that backbone crosses
    a block's interior by more than the port's own edge margin. Which port of
    a 100-segment ladder or a 16-way split pair is chosen therefore decides
    whether a net routes at all -- the one nearest the edge the route arrives
    at is the only one whose approach stays outside the block.

    Ordering is purely geometric (the block's own reported port positions);
    the router itself remains the pass/fail authority, consulted by
    `resolve_connectivity`.
    """
    ports = [
        p
        for p in report["ports"]
        if p["name"].endswith(suffix)
        and int(p.get("direction_deg", 0)) % 360 == facing
        and (half is None or p["name"].startswith(f"{half}_"))
    ]
    if not ports:
        raise KeyError(
            f"no '{suffix}' ports facing {facing} deg "
            f"{'half ' + half + ' ' if half else ''}"
            f"(available: {sorted({q['name'] for q in report['ports']})})"
        )
    key = {
        "east": lambda p: -float(p["x_um"]),
        "west": lambda p: float(p["x_um"]),
        "north": lambda p: -float(p["y_um"]),
        "south": lambda p: float(p["y_um"]),
    }[toward]
    ports.sort(key=key)
    return [p["name"] for p in ports[:limit]]



#: Label-only pin promotions (`pins[]`), i.e. nodes made addressable from a
#: post-layout testbench (issue #16) without any claim of connectivity: a
#: `pins[]` entry draws a label, never a wire.
#:
#: The eight gate entries this list used to carry are **gone**. They existed
#: because a MOS gate could not be wired at all (MOS_GATE_NOTE), so each
#: gate node could only be named -- with a deliberately different name
#: (`GDRV_GATE`, `VA_GATE`, ...) from the schematic node it belonged to, so
#: that two disconnected pieces of metal could not be labelled alike and
#: merged by `klt extract`. With 2AMLogic/klayout-tools#461 merged, every one
#: of those nodes is drawn metal carrying its own schematic name (see
#: INTER_BLOCK_MET1), and re-labelling their pads here would do exactly the
#: damage `routed_ports` exists to prevent.
#:
#: What remains is the trim ladder's read-only probe taps, which are genuinely
#: single-port nodes no schematic net reaches (see :func:`trim_tap_ladder`).
CORE_PIN_LABELS: list[dict[str, Any]] = []


#: The bar criterion 1 is measured against: every node of
#: design/bandgap_core.sch (+ design/error_amp.sch) that joins devices living
#: in *different* layout blocks, with the set of blocks the schematic says it
#: must reach. This is deliberately independent of CORE_NETS -- scoring
#: "9/9 declared nets routed" measures the flow against its own declaration,
#: which is not what issue #62 asks for. `hops` names the CORE_NETS entries
#: that carry this node's label; a node counts as fully drawn only when the
#: blocks those routed hops actually touch cover `blocks`.
SCHEMATIC_INTER_BLOCK_NETS: list[dict[str, Any]] = [
    {
        "net": "VA",
        "blocks": ["pnp_ctat", "res_trim", "amp_input_pair"],
        "hops": ["VA"],
        "schematic": "Q1 emitter + R2A low end (which the layout splits into "
        "ladder + DR-002 trim taps, so the low end sits on res_trim) + MP2 "
        "gate (amp VINN)",
    },
    {
        "net": "VB",
        "blocks": ["res_trim", "res_r1", "amp_input_pair"],
        "hops": ["VB"],
        "schematic": "R2B low end (through the trim taps) + R1 head + MP1 "
        "gate (amp VINP)",
    },
    {
        "net": "TRIM",
        "blocks": ["res_r2", "res_trim"],
        "hops": ["TRIM_A", "TRIM_B"],
        "schematic": "layout-internal split of both R2 legs into ladder + "
        "DR-002 trim taps (one device per leg in the schematic)",
    },
    {
        "net": "VBQ",
        "blocks": ["res_r1", "pnp_ptat"],
        "hops": ["VBQ"],
        "schematic": "R1 tail + Q2 emitter",
    },
    {
        "net": "VOUT",
        "blocks": ["core_mirror", "res_r2", "su_sense", "su_clamp"],
        "hops": ["VOUT"],
        "schematic": "MPOUT drain + both R2A/R2B tops (the reference "
        "output) + the startup injector's VSENSE input (MNS/MNC gates)",
    },
    {
        "net": "GDRV",
        "blocks": ["core_mirror", "amp_pmirr", "amp_nmirr", "amp_cc",
                   "su_ref", "su_inj", "su_clamp"],
        "hops": ["GDRV"],
        "schematic": "amp output (MP4/MN3 drains) + MPOUT/MPAMP gates + "
        "MCC's gate + the startup injector's MPC1 source, MNI drain and "
        "MNC source -- one node in the schematic and, since the "
        "gate-contact gap closed, one drawn node in the layout too",
    },
    {
        "net": "NG",
        "blocks": ["su_ref", "su_sense", "su_inj"],
        "hops": ["NG"],
        "schematic": "MPC2 diode drain/gate + MNS drain + MNI gate "
        "(design/startup_injector.sch)",
    },
    {
        "net": "NE",
        "blocks": ["su_sense", "pnp_su"],
        "hops": ["NE"],
        "schematic": "MNS source + QS emitter (design/startup_injector.sch)",
    },
    {
        "net": "TAIL",
        "blocks": ["core_mirror", "amp_input_pair"],
        "hops": ["TAIL"],
        "schematic": "MPAMP drain + MP1/MP2 common source",
    },
    {
        "net": "D1",
        "blocks": ["amp_input_pair", "amp_nload", "amp_nmirr"],
        "hops": ["D1"],
        "schematic": "MP1 drain + MN1 diode + MN3 gate",
    },
    {
        "net": "D2",
        "blocks": ["amp_input_pair", "amp_nload", "amp_nmirr"],
        "hops": ["D2"],
        "schematic": "MP2 drain + MN2 diode + MN4 gate",
    },
    {
        "net": "PN",
        "blocks": ["amp_nmirr", "amp_pmirr"],
        "hops": ["PN"],
        "schematic": "MN4 drain + MP3 diode + MP4 gate",
    },
    {
        "net": "VDD",
        "blocks": ["core_mirror", "amp_input_pair", "amp_pmirr", "amp_cc",
                   "su_ref", "su_clamp"],
        "hops": ["VDD"],
        "schematic": "supply trunk: MPOUT/MPAMP sources + MP1/MP2 well side "
        "+ MP3/MP4 sources + MCC drain/source + the startup injector's "
        "MPC1/MPC2 n-well tap and MNC drain",
    },
    {
        "net": "VSS",
        "blocks": ["amp_nload", "amp_nmirr", "pnp_ctat", "pnp_ptat",
                   "su_inj", "pnp_su"],
        "hops": ["VSS"],
        "schematic": "ground trunk: MN1-MN4 sources + both PNPs' base ties. "
        "The three resistor blocks' res_high_po bulk terminals "
        "(design/bandgap_core.sch r2ab/r2bb/r1b) are on this node in the "
        "schematic too, and now resolve to the same real drawn `VSS` net "
        "the rest of this row does (SUBSTRATE_NET_NOTE) -- but not through "
        "a pad this router can target: `res_array` draws no bulk-terminal "
        "pad inside those three blocks for metal to land on, so they stay "
        "uncounted as routing targets here even though the correspondence "
        "itself is no longer in question",
    },
]


def schematic_net_coverage(routes: list[dict[str, Any]]) -> list[dict[str, Any]]:
    """Score each schematic inter-block node against the met1 metal actually
    drawn for it.

    `status` is "drawn" only when the drawn nets carrying that node touch
    every block the schematic says the node reaches; "partial" when some but
    not all are joined; "labelled only" when no metal is drawn for it at all
    (the node exists in the layout solely as a promoted pin label).

    Scored against design/bandgap_core.sch's own node list, never against
    this flow's own routing declaration -- a net this flow simply forgot to
    declare has to show up here as a miss.
    """
    # Credit is per *hop*, not per net, and only for blocks that end up in one
    # connected piece of metal. A net whose chain breaks in the middle leaves
    # two disjoint pieces; counting its whole block list would claim
    # connectivity that is not drawn, and counting nothing (what this function
    # did before) throws away the piece that *is*. Union-find over the routed
    # hops, then keep the largest component, states exactly what is joined.
    parent: dict[tuple[str, str], tuple[str, str]] = {}

    def find(key: tuple[str, str]) -> tuple[str, str]:
        parent.setdefault(key, key)
        while parent[key] != key:
            parent[key] = parent[parent[key]]
            key = parent[key]
        return key

    def union(a: tuple[str, str], b: tuple[str, str]) -> None:
        ra, rb = find(a), find(b)
        if ra != rb:
            parent[ra] = rb

    endpoint_block: dict[tuple[str, str], str] = {}
    for route in routes:
        net = route["net"]
        for hop in route.get("hops", []):
            ends = []
            for side in ("from", "to"):
                name = hop.get(side)
                if not name:
                    continue
                block = name.split(".")[0].split(":")[0]
                key = (net, name)
                endpoint_block[key] = block
                find(key)
                ends.append(key)
            if hop.get("routed") and len(ends) == 2:
                union(ends[0], ends[1])

    components: dict[tuple[str, str], set[str]] = {}
    for key, block in endpoint_block.items():
        components.setdefault(find(key), set()).add(block)
    touched: dict[str, set[str]] = {}
    for root, blocks in components.items():
        net = root[0]
        if len(blocks) > len(touched.get(net, set())):
            touched[net] = blocks
    rows = []
    for spec in SCHEMATIC_INTER_BLOCK_NETS:
        want = set(spec["blocks"])
        have: set[str] = set()
        for hop in spec["hops"]:
            have |= touched.get(hop, set())
        joined = want & have
        if joined >= want:
            status = "drawn"
        elif len(joined) >= 2:
            status = "partial"
        else:
            status = "labelled only"
        rows.append(
            {
                "net": spec["net"],
                "schematic": spec["schematic"],
                "blocks": spec["blocks"],
                "joined": sorted(joined),
                "missing": sorted(want - joined),
                "status": status,
            }
        )
    return rows


def r2_leg_length() -> dict[str, Any]:
    """Drawn vs. specified length of one R2 divider leg, in um.

    `klt lvs` can only report a resistor's *value*, and only once the two
    sides pair at all -- which took until issue #62's eighteenth increment
    (INTERNAL_NODE_LABEL_NOTE). This states the same fact in the units the
    schematic actually specifies, unconditionally and from the flow's own
    constants, so it appears in every record whether or not the comparer
    reaches these devices: a future regression in either constant shows up
    here immediately instead of hiding behind an unpaired device.

    `drawn_um` is what the layout puts in series between `VOUT` and `VA`
    (resp. `VB`) **at DR-002 code 0**: the `res_r2` coarse leg plus the whole
    `res_trim` fine leg, because code 0 is the tap at the far end of the fine
    chain (see INTER_BLOCK_MET1's `TRIM_A`/`VA` entries and
    :func:`trim_tap_port`). `spec_um` is design/bandgap_core.sch's own
    `L = r_lseg*n_r2 + r_lseg_trim*n_r2_trim` at that same code.

    The two sides are independent statements -- the drawn constants describe
    a coarse/fine decomposition, the specified one a single length -- so
    `matches` is a real comparison, not a tautology: any change to the fold,
    the unit length or either count moves `drawn_um` alone.
    """
    coarse_um = R_LSEG_UM * N_R2_COARSE
    trim_um = R_LSEG_TRIM_UM * N_R2_TRIM_UNITS
    drawn_um = coarse_um + trim_um
    spec_um = SCH_R_LSEG_UM * SCH_N_R2 + SCH_R_LSEG_TRIM_UM * SCH_N_R2_TRIM
    delta_um = drawn_um - spec_um
    return {
        "coarse_um": coarse_um,
        "trim_um": trim_um,
        "drawn_um": drawn_um,
        "spec_um": spec_um,
        "delta_um": delta_um,
        # The trim code the drawn metal option actually selects, in DR-002's
        # own units. Positive is the direction DR-002 rejects outright.
        "effective_trim_code": round(delta_um / SCH_R_LSEG_TRIM_UM),
        "matches": abs(delta_um) < 1e-9,
    }


def trim_tap_ladder(reports: dict[str, dict[str, Any]]) -> list[dict[str, Any]]:
    """Every trim code the drawn metal option can select, per code, with the
    leg length that code yields -- read off the block's own reported ports.

    This is the whole ladder, not just its endpoints, because the ladder's
    *direction* is the thing DR-002 constrains and a two-row table cannot
    show a direction. Code 0 is the far end of the fine chain and yields the
    schematic's own `L` exactly; code -k skips the last k fine units and
    yields `L - k` um. `certified` is DR-002's own range (0..-16): the drawn
    ladder can express four codes past it (-17..-20, down to the bare coarse
    leg), and they are listed **flagged**, not silently offered, because
    spec/decision-records/DR-002-trim-network-scoping.md certifies the
    monotonic operating point only over 0..-16 (issue #46,
    sim/trim-range-monotonicity/).

    Every port index is validated against the block's own reported ports, so
    a count-constant change fails loudly here instead of silently
    mislabelling a tap.

    These are **not** emitted as `pins[]` entries -- they are reported into
    the record as documentation of where the metal option lands. See
    INTERNAL_NODE_LABEL_NOTE: every one of these taps sits on a node interior
    to the schematic's own `R2A`/`R2B` device, and promoting an interior node
    to a top-level pin is what was splitting those two devices on the layout
    side.
    """
    from bus_routing import trim_tap_port  # local: see this file's own note

    bid = "res_trim"
    available = {p["name"] for p in reports[bid]["ports"]}
    coarse_um = R_LSEG_UM * N_R2_COARSE
    rows: list[dict[str, Any]] = []
    for k in range(N_R2_TRIM_UNITS + 1):
        ports: dict[str, str] = {}
        for leg, name in ((0, "A"), (1, "B")):
            port = trim_tap_port(leg, -k)
            if port not in available:
                raise KeyError(f"block '{bid}' has no trim-tap port '{port}'")
            ports[name] = port
        rows.append(
            {
                "code": -k,
                "block": bid,
                "ports": ports,
                "leg_um": coarse_um + R_LSEG_TRIM_UM * (N_R2_TRIM_UNITS - k),
                "certified": k <= N_R2_TRIM_CODES,
            }
        )
    return rows


def routed_ports(bus_summary: dict[str, Any]) -> set[tuple[str, str]]:
    """Every `(block, port)` pad a drawn met1 net already contacts.

    A `pins[]` label is drawn *on the pad*, so a label placed on a pad some
    other node's met1 has already via'd down to does not name that label's
    node -- it renames the node that owns the pad. `klt extract` then reports
    the pad's net under both names joined by `|` (e.g. `TAIL|VOUT`), i.e. the
    layout claims one schematic node is another.

    This is not hypothetical: it is what the previous increment's composed
    layout did. `VOUT`'s label landed on `core_mirror.M2_1_D`, which is
    MPAMP's drain and the pad the drawn `TAIL` net contacts, because the pin
    selector and the router kept separate "already used" sets. They share one
    now, and :func:`assert_no_merged_pin_names` checks the extracted netlist
    for the `|` that would prove the sharing failed.
    """
    claimed: set[tuple[str, str]] = set()
    for route in bus_summary.get("_inter_block", []):
        for terminal in route.get("terminals", []):
            block, _, port = terminal.partition(".")
            if port:
                claimed.add((block, port))
    return claimed


def assert_no_merged_pin_names(netlist_path: Path) -> list[str]:
    """Fail the flow on any extracted net whose name is two pin names joined
    by `|` -- KLayout's notation for "two labels, one net".

    Returns the offending names (empty is the only acceptable result). A
    merged name always means the layout asserted an equality between two
    schematic nodes that the schematic does not contain, which is a worse
    error than an open node and is invisible to both DRC and the drawn-short
    check (the shapes involved are legal and well separated -- it is the
    *labels* that collide).
    """
    merged = sorted(
        {
            token
            for token in re.findall(r"[A-Za-z_$][\w$|\\]*", netlist_path.read_text())
            if "|" in token
        }
    )
    return merged


def split_routed_nets(
    routes: list[dict[str, Any]], components: dict[str, int]
) -> dict[str, int]:
    """Every node the router reports as fully `routed` whose drawn met1 is
    nonetheless in more than one piece, as `{net: piece count}`.

    `Met1Bus.components()` counts the connected components of each node's own
    met1. One is the only honest answer for a node this router claims it
    joined end to end -- two means the flow drew a node it *believes* is one
    conductor as two islands that never touch, which is the exact inverse of
    the drawn-short failure and is invisible to every downstream check: DRC
    sees two legal wires, `klt extract` sees two anonymous nets with nothing
    in `warnings[]`, and the coverage table -- which scores the router's own
    hop bookkeeping, not the geometry -- still reports the node as drawn.

    Restricted to `routed` nodes on purpose. A node that came up a hop short
    is *supposed* to be in more than one piece; gating on it would only
    re-report what the coverage table already says, and would make this check
    fire on every partial run instead of on the bug it exists to catch.
    """
    return {
        route["net"]: components[route["net"]]
        for route in routes
        if route.get("routed") and components.get(route["net"], 1) != 1
    }


def run_met2_drc(
    klt: str, gds_path: Path, top: str, out_dir: Path
) -> dict[str, Any]:
    """Run `layout/bin/met2_drc.py` on the composed GDS and persist its report.

    Shelled out rather than imported because this script is deliberately
    stdlib-only (it drives `klt` as a subprocess and never imports it), while
    the met2 check needs `klayout.db`. The interpreter is taken from the same
    venv the `--klt` executable lives in, which is where `layout/bin/
    setup-venv.sh` puts both.
    """
    python = Path(klt).with_name("python")
    if not python.exists():  # pragma: no cover -- non-venv klt on PATH
        python = Path(sys.executable)
    report_path = out_dir / "met2-drc.json"
    result = subprocess.run(
        [
            str(python),
            str(Path(__file__).resolve().parent / "met2_drc.py"),
            str(gds_path),
            "--top",
            top,
            "-o",
            str(report_path),
        ],
        check=False,
        capture_output=True,
        text=True,
    )
    if result.returncode not in (0, 3):
        raise RuntimeError(
            f"met2_drc.py failed ({result.returncode}):\n{result.stderr}"
        )
    return json.loads(report_path.read_text())


def flow_gate(
    *,
    drc_clean: bool,
    within_budget: bool,
    full_scale_ladder: bool,
    r2_leg_matches: bool,
    all_classes: bool,
    pin_count: int,
    met1_conflicts: list[Any],
    merged_pin_names: list[str],
    split_routed: dict[str, int],
    met2_drc_clean: bool = True,
) -> dict[str, bool]:
    """The flow's pass/fail gate, as a named condition per row.

    Kept a pure function of already-measured values (rather than an inline
    boolean at the end of :func:`main`) for two reasons: the composition is
    then unit-testable without a `klt` install or a PDK -- see
    `layout/tests/test_routed_flow_gates.py` -- and a failing run can name
    *which* condition failed instead of only reporting exit 1.

    What is deliberately NOT in here: `klt lvs`-clean and schematic-net
    coverage. Schematic-net coverage is recorded as a measured number in
    record.md's own scoreboard instead of gated, for the same
    hides-the-evidence reason given below. `klt lvs`-clean was historically
    blocked upstream too (MOS_GATE_NOTE, RES_FLAVOR_NOTE) -- as of the
    thirtieth increment (MCC drawn as a MOS cap, MCC_MIM_INFEASIBLE_NOTE) it
    is no longer blocked and this flow's own `lvs.combined.json` reports
    `mismatch_count: 0`, but it is still not wired into this gate: the one
    remaining blocker on a fully green flow run is `within_budget` (the
    composed cell's real, measured area once MCC is drawn -- see
    `spec/decision-records/DR-007-mcc-area-budget.md`, which is *proposed*,
    not ratified), and gating on `lvs_clean` too would not change today's
    exit status, only make a future budget-only regression harder to tell
    apart from an LVS regression at a glance. Left as a follow-up once
    DR-007 (or an amendment) is ratified and `budget_um2` below can move to
    match it -- see that record's "Consequences" section.

    The four that ARE gated and are not about the tool's own verdicts --
    `no_drawn_shorts`, `no_merged_pin_names`, `no_split_routed_nets` and
    `met2_drc_clean` -- are this flow's own honesty checks. The first two
    catch a way the layout could claim connectivity the schematic does not
    contain (through metal, and through a pin label respectively); the third
    catches the inverse, a node this flow's own bookkeeping calls routed
    while the drawn metal is still in two pieces (see
    :func:`split_routed_nets`); the fourth checks the met2 escape plane
    against sky130's own source DRC rules, because the curated deck `drc_clean`
    above reports on is missing only the met2 min-area rule (`m2.6`) for it
    (MET2_ESCAPE_NOTE) -- the width/spacing/enclosure rules landed via
    klayout-tools#513/#515 and are part of `drc_clean` itself now. None of
    the first three is visible to `klt drc` at all.

    `r2_leg_length_matches` is the fifth of that kind, and the newest (issue
    #91). `full_scale_ladder` above only checks that the ladder is drawn at
    its real unit *count*; it says nothing about the resulting *length*,
    which is what design/bandgap_core.sch actually specifies and what sets
    K = R2/R1. The 286-um-vs-270-um defect issue #91 fixed passed
    `full_scale_ladder` for nineteen increments, and `r2_leg_length()`'s
    verdict reached only record.md's table -- reported, never gated. It is
    gated here so the same class of regression fails the flow.
    """
    return {
        "drc_clean": drc_clean,
        "met2_drc_clean": met2_drc_clean,
        "within_budget": within_budget,
        "full_scale_ladder": full_scale_ladder,
        "r2_leg_length_matches": r2_leg_matches,
        "device_classes_present": all_classes,
        "pins_promoted": pin_count > 0,
        "no_drawn_shorts": not met1_conflicts,
        "no_merged_pin_names": not merged_pin_names,
        "no_split_routed_nets": not split_routed,
    }


#: The escape plane's two layers, in the (gds-label, role-layer-tuple) shape
#: `drc.json["coverage"]["layers_in_stream_without_rules"]` reports them.
ESCAPE_PLANE_LAYERS: tuple[tuple[str, tuple[int, int]], ...] = (
    ("68/44", met1_bus.VIA1_LAYER),
    ("69/20", met1_bus.MET2_LAYER),
)


def met2_drc_coverage_note(unchecked: list[str]) -> str:
    """record.md's prose for the "does `klt drc` see the escape plane"
    question, driven by `drc.json`'s own `coverage.layers_in_stream_without_rules`
    rather than a hardcoded claim.

    A pure function of that one list -- not inlined at the call site -- for
    the same reason as :func:`flow_gate`: it is unit-testable without a
    `klt` install, and it is the one place this flow used to state, as fact,
    that `klt drc`'s curated sky130 deck "carries no met2.*/via.* rule at
    all" unconditionally. That was true through issue #62's twenty-third
    increment; klayout-tools#513 (merged via #515) added the met2/via1
    width, spacing and enclosure rules, so the correct claim now depends on
    what this run's own `coverage` block says, not on a fixed increment-era
    fact -- a stale hardcoded version of this text once printed "does not
    check any of this geometry" one sentence before quoting a `coverage`
    list that named *neither* escape-plane layer as unchecked, contradicting
    itself in the same paragraph.
    """
    escape_unchecked = [
        gds for gds, layer in ESCAPE_PLANE_LAYERS
        if f"{layer[0]}/{layer[1]}" in unchecked
    ]
    if escape_unchecked:
        return (
            "**`klt drc` does not fully check this geometry, and says so.** "
            "The curated sky130 deck's `coverage` block "
            "(klayout-tools#189) lists this run's unchecked stream layers as "
            f"`{', '.join(unchecked) or '--'}`, which includes "
            f"**{', '.join(escape_unchecked)}** of the escape plane's two "
            "layers (`via.drawing` 68/44, `met2.drawing` 69/20) -- so its "
            "`violation_count` above is *silent* about at least one of them "
            "rather than clean about it. This flow checks them itself "
            "against the installed sky130A PDK's own source deck "
            "(`libs.tech/klayout/drc/sky130A_mr.drc`: `m2.1`, `m2.2`, "
            "`m2.6`, `via.1a`, `via.2`, `via.4a`/`via.5a`, `m2.4`/`m2.5`) "
            "in `layout/bin/met2_drc.py`, and gates on it -- see the met2 "
            "DRC row in Results and [`met2-drc.json`](met2-drc.json)."
        )
    return (
        "**`klt drc` now checks most of this geometry.** klayout-tools#513 "
        "(merged via #515) added met2/via1 width, spacing and enclosure "
        "rules to the curated sky130 deck, and `drc.json`'s own `coverage` "
        "block (klayout-tools#189) confirms neither escape-plane layer "
        "(`via.drawing` 68/44, `met2.drawing` 69/20) is in this run's "
        f"unchecked-layer list (`{', '.join(unchecked) or '--'}`). What "
        "`klt drc` still cannot check is the met2 min-area rule (`m2.6`) -- "
        "#515 left it out because the curated deck's rule vocabulary has no "
        "`area` check primitive. `layout/bin/met2_drc.py` re-checks the "
        "full sky130A source-deck threshold set (including `m2.6`) "
        "independently and gates on it -- see the met2 DRC row in Results "
        "and [`met2-drc.json`](met2-drc.json)."
    )


def compose_inner(
    klt: str,
    out_dir: Path,
    pdk: str,
    cell_name: str,
    block_ids: list[str],
    reports: dict[str, dict[str, Any]],
    origins: dict[str, dict[str, float]],
    bus_summary: dict[str, Any],
) -> tuple[dict[str, Any], list[dict[str, Any]]]:
    """Compose the placed blocks plus the met1 bus/route overlay into one cell.

    `connectivity[]` is deliberately **empty**. PR #64 asked `gen-compose`'s
    router to draw the inter-block nets on li1 and used the router itself as
    the routability oracle; this increment draws them on met1 instead (see
    INTER_BLOCK_MET1), for two reasons that both bite at once:

    * a met1 wire crosses a block without touching the li1 pads inside it, so
      a net between non-adjacent blocks -- `VOUT`, the third leg of the VDD
      trunk -- becomes drawable at all; and
    * with the per-matched-group guard rings switched back on (upstream
      klayout-tools#441), the li1 router rejects every route to a non-tap
      port on a ringed block except through that block's single ring opening,
      so li1 routing and per-group rings remain effectively exclusive. On
      met1 the ring is simply a layer below.

    `pins[]` is still used, and only for what it is: **naming**. A pin entry
    draws a label, never a wire, so it makes a node addressable from a
    post-layout testbench (issue #16) without claiming any connectivity. Gate
    nodes are here for exactly that reason -- a MOS gate cannot be wired at
    all (MOS_GATE_NOTE), but it can be named.

    Returns `(compose_response, pins)`.
    """
    from bus_routing import MOS_HALVES  # local: see this file's own note

    pins: list[dict[str, Any]] = []
    # Seeded with every pad the drawn met1 nets already contact, so a label can
    # never rename another node's pad (see routed_ports).
    used: set[tuple[str, str]] = routed_ports(bus_summary)
    for spec in CORE_PIN_LABELS:
        block, device = spec["device"]
        half = MOS_HALVES[block]["devices"][device]
        placed = False
        for name in select_ports(
            reports[block],
            "_G",
            DIRECTION_NORTH,
            spec["toward"],
            half=half,
        ):
            if (block, name) not in used:
                pins.append({"net": spec["net"], "block": block, "port": name})
                used.add((block, name))
                placed = True
                break
        if not placed:
            raise KeyError(
                f"pin {spec['net']}: every gate port of {block}.{device} is "
                "already claimed"
            )
    # trim_tap_ladder() is deliberately NOT folded into `pins[]` -- see
    # INTERNAL_NODE_LABEL_NOTE and the record's own trim-tap table.

    request = {
        "schema": "klt.gen_compose.request/1",
        "pdk": {"variant": pdk},
        "blocks": [
            {
                "id": bid,
                "generator_report": str((out_dir / f"{bid}.gen.json").resolve()),
            }
            for bid in block_ids
        ],
        "placement": {
            "strategy": "explicit",
            "order": block_ids,
            "origins_um": origins,
        },
        "connectivity": [],
        "pins": pins,
        "routing": {"layer_role": "metal", "width_um": ROUTE_WIDTH_UM},
        "options": {
            "cell_name": cell_name,
            "output": str((out_dir / f"{cell_name}.gds").resolve()),
        },
    }
    request_path = out_dir / "compose.inner.request.json"
    request_path.write_text(json.dumps(request, indent=2) + "\n")
    compose = run_klt_json(klt, "gen-compose", str(request_path), allow_exit=(0, 3))
    (out_dir / "compose.inner.json").write_text(json.dumps(compose, indent=2) + "\n")
    return compose, pins
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
