2AMLogic/sky130-bandgap/layout/bin/erc_supply_record.py

#!/usr/bin/env python3
"""Gate + render one `layout/bandgap-core/erc/<record-id>/` evidence record.

Invoked by ``layout/bin/run-erc-supply-flow.sh`` after the ``klt erc`` runs
have written their JSON into the record directory. Keeps the pass/fail logic
in one place so the committed ``record.md`` cannot disagree with the committed
JSON it summarises.

The gate is T1 item 11's own pass condition, which is deliberately **not** the
report's overall ``status``:

* every declared supply resolves to exactly one electrical island -- no
  ``erc.unconnected_net`` and no ``erc.supply_short`` naming it;
* both supplies appear in ``erc_coverage.checked`` (the check actually ran);
* the report's ``provenance.input.content_hash`` equals the sha256 of the GDS
  it names, so the report cannot drift from the layout it claims to describe.

``erc.missing_tie`` is not computed by the supply run and is not gated here --
see ``layout/bandgap-core/erc/README.md``.
"""

from __future__ import annotations

import argparse
import hashlib
import json
import pathlib
import sys

SUPPLIES = ("VDD", "VSS")


def sha256_file(path: pathlib.Path) -> str:
    h = hashlib.sha256()
    with path.open("rb") as fh:
        for chunk in iter(lambda: fh.read(1 << 20), b""):
            h.update(chunk)
    return h.hexdigest()


def gate_supply_report(report: dict, gds: pathlib.Path) -> tuple[bool, list[str]]:
    """Return (ok, reasons). ``reasons`` lists every gate failure, not just the first."""
    reasons: list[str] = []

    declared = sha256_file(gds)
    got = ((report.get("provenance") or {}).get("input") or {}).get("content_hash")
    if got != f"sha256:{declared}":
        reasons.append(
            f"provenance.input.content_hash {got!r} does not match sha256 of {gds.name} "
            f"(sha256:{declared})"
        )

    checked = set((report.get("erc_coverage") or {}).get("checked") or [])
    for net in SUPPLIES:
        if f'erc.net_connectivity:["{net}"]' not in checked:
            reasons.append(f"erc.net_connectivity for {net} is not in erc_coverage.checked")

    for finding in report.get("erc_findings") or []:
        rule = finding.get("rule")
        if rule not in ("erc.unconnected_net", "erc.supply_short"):
            continue
        named = {finding.get("net"), finding.get("other_net")} & set(SUPPLIES)
        if named:
            reasons.append(f"{rule} names {sorted(named)}: {finding.get('description')}")

    return (not reasons), reasons


def fmt_findings(report: dict) -> str:
    findings = report.get("erc_findings") or []
    if not findings:
        return "none"
    out = []
    for f in findings:
        bbox = f.get("bbox")
        where = ""
        if bbox:
            where = (
                f" bbox ({bbox['left'] / 1000:g}, {bbox['bottom'] / 1000:g})"
                f"-({bbox['right'] / 1000:g}, {bbox['top'] / 1000:g}) um"
            )
        out.append(f"`{f['rule']}` net={f.get('net')} layer={f.get('layer')}{where}")
    return "; ".join(out)


def main() -> int:
    ap = argparse.ArgumentParser()
    ap.add_argument("--out-dir", required=True)
    ap.add_argument("--record-id", required=True)
    ap.add_argument("--repo-root", required=True)
    ap.add_argument("--klt", required=True)
    ap.add_argument("--gds-records", nargs="+", required=True)
    ap.add_argument("--newest", required=True)
    args = ap.parse_args()

    out_dir = pathlib.Path(args.out_dir)
    repo_root = pathlib.Path(args.repo_root)
    cell_dir = repo_root / "layout" / "bandgap-core"

    lines: list[str] = []
    overall_ok = True

    lines.append(f"# `klt erc` supply record — `{args.record_id}`")
    lines.append("")
    lines.append(
        "T1 item 11 (power delivery, **structural**) evidence for `bandgap-core`. "
        "Generated by `layout/bin/run-erc-supply-flow.sh`; do not hand-edit — "
        "re-run the flow to append a new record. Read "
        "[`../README.md`](../README.md) first for what this does and does not "
        "establish."
    )
    lines.append("")

    # --- supply runs -------------------------------------------------------
    lines.append("## Supply-spec runs (`erc-supply-spec.json`)")
    lines.append("")
    lines.append(
        "| routed GDS | GDS sha256 | report `provenance.input.content_hash` | "
        "supplies checked | `erc.unconnected_net` / `erc.supply_short` on a supply | gate |"
    )
    lines.append("|---|---|---|---|---|---|")

    supply_reports: dict[str, dict] = {}
    for rec in args.gds_records:
        report_path = out_dir / f"erc.{rec}.json"
        report = json.loads(report_path.read_text())
        supply_reports[rec] = report
        gds = cell_dir / "reports" / rec / "bandgap_core_routed.gds"
        ok, reasons = gate_supply_report(report, gds)
        overall_ok = overall_ok and ok
        checked = set((report.get("erc_coverage") or {}).get("checked") or [])
        n_checked = sum(
            1 for net in SUPPLIES if f'erc.net_connectivity:["{net}"]' in checked
        )
        offending = [
            f
            for f in (report.get("erc_findings") or [])
            if f.get("rule") in ("erc.unconnected_net", "erc.supply_short")
            and ({f.get("net"), f.get("other_net")} & set(SUPPLIES))
        ]
        lines.append(
            f"| `{rec}` | `{sha256_file(gds)[:16]}…` | "
            f"`{((report.get('provenance') or {}).get('input') or {}).get('content_hash', '')[7:23]}…` | "
            f"{n_checked}/2 (VDD, VSS) | **{len(offending)}** | "
            f"{'**PASS**' if ok else '**FAIL**'} |"
        )
        if not ok:
            for r in reasons:
                lines.append(f"| | | | | | {r} |")

    lines.append("")
    newest_report = supply_reports[args.newest]
    cov = newest_report.get("erc_coverage") or {}
    inapplicable = {e["id"]: e["reason"] for e in cov.get("inapplicable") or []}
    lines.append(
        f"Newest GDS (`{args.newest}`): `erc_status` "
        f"`{newest_report.get('erc_status')}`, `erc_finding_count` "
        f"{newest_report.get('erc_finding_count')}, overall `status` "
        f"`{newest_report.get('status')}`, produced by "
        f"`klt {(newest_report.get('provenance') or {}).get('klt_version')}` / "
        f"KLayout `{(newest_report.get('provenance') or {}).get('klayout_version')}`."
    )
    lines.append("")
    lines.append(
        "**`erc.missing_tie` is NOT COMPUTED by these runs.** "
        f"`erc_coverage.inapplicable` records it as "
        f"`{inapplicable.get('erc.missing_tie:[]', '(absent)')}` — the spec declares "
        "an empty `ties[]` with a `ties_disclosure` of kind `tool_limitation`. "
        "Its zero count is an absence of evidence, not evidence of absence; the "
        "standing-in well-tie evidence is named in [`../README.md`](../README.md)."
    )
    lines.append("")

    # --- antenna (reported, not gated) -------------------------------------
    lines.append("## Antenna / gate accumulation (reported, not this item's subject)")
    lines.append("")
    lines.append(
        "Reported here because the same run produces it. An antenna verdict is "
        "not item 11's subject and does not gate this record "
        "([klayout-tools#1994](https://github.com/2AMLogic/klayout-tools/issues/1994))."
    )
    lines.append("")
    lines.append("| gate net | `gate_area_um2` (poly ∩ diff) | `antenna_verdict` |")
    lines.append("|---|---|---|")
    for g in newest_report.get("gates") or []:
        lines.append(
            f"| `{g.get('net')}` | {g.get('gate_area_um2')} | `{g.get('antenna_verdict')}` |"
        )
    devices = (newest_report.get("provenance") or {}).get("devices") or []
    lines.append("")
    if devices:
        lines.append("Device bodies carved out of the conductor roles by `--deck sky130`:")
        lines.append("")
        for d in devices:
            lines.append(
                f"- `{d.get('name')}` on role `{d.get('on')}` "
                f"(`body_layer` {d.get('body_layer')}), "
                f"{d.get('body_area_um2')} µm², source `{d.get('source')}`"
            )
        lines.append("")

    # --- known-gap runs ----------------------------------------------------
    lines.append("## Known-gap n-well tie reproductions (friction evidence)")
    lines.append("")
    lines.append(
        "Not a verdict on this layout. These two runs reproduce "
        "[klayout-tools#2339](https://github.com/2AMLogic/klayout-tools/issues/2339) "
        f"against `{args.newest}`: `ties[].well_layer` checks **every** merged shape "
        "on `nwell` 64/20 against one declared net, and this block's n-wells are not "
        "uniformly biased. Their finding sets are disjoint complements, so between "
        "them every n-well shape is shown tapped to its correct supply."
    )
    lines.append("")
    lines.append("| tie spec | declared net | `erc.missing_tie` | `erc.supply_short` | findings |")
    lines.append("|---|---|---|---|---|")
    kg_total = 0
    for half, net in (("vdd", "VDD"), ("vss", "VSS")):
        path = out_dir / f"erc.known-gap-nwell-{half}.{args.newest}.json"
        rep = json.loads(path.read_text())
        miss = [f for f in rep.get("erc_findings") or [] if f["rule"] == "erc.missing_tie"]
        shorts = [f for f in rep.get("erc_findings") or [] if f["rule"] == "erc.supply_short"]
        kg_total += len(miss)
        if shorts:
            overall_ok = False
        lines.append(
            f"| `erc-nwell-tie-spec.known-gap.{half}.json` | `{net}` | {len(miss)} | "
            f"{len(shorts)} | {fmt_findings(rep)} |"
        )
    lines.append("")
    lines.append(
        f"Combined `erc.missing_tie` count across both halves: **{kg_total}**, which is "
        "the total n-well shape count on this layout — every well is reported by "
        "exactly one of the two halves, i.e. every well is tied, to one supply or the "
        "other. **Zero `erc.supply_short` in either half** re-confirms that "
        "[klayout-tools#2169](https://github.com/2AMLogic/klayout-tools/issues/2169)'s "
        "well-conductor collapse does not reproduce on the pinned `klt` build."
    )
    lines.append("")

    lines.append("## Verdict")
    lines.append("")
    lines.append(f"**{'PASS' if overall_ok else 'FAIL'}** — item 11's supply half.")
    lines.append("")
    lines.append(
        "This gate covers the supply-island half of item 11 only. The item as a "
        "whole stays **unmet** while `erc.missing_tie` is uncomputed — the "
        "machine-graded verdict of record is `signoff/signoff-report.json` "
        "(see `signoff/README.md`), which renders item 11 "
        "`supply_spec_disclosed_tool_limitation`. See "
        "[`../README.md`](../README.md) for why."
    )
    lines.append("")

    (out_dir / "record.md").write_text("\n".join(lines) + "\n")
    print(f"erc_supply_record.py: wrote {out_dir / 'record.md'}")
    if not overall_ok:
        print("erc_supply_record.py: GATE FAILED", file=sys.stderr)
        return 1
    return 0


if __name__ == "__main__":
    raise SystemExit(main())
