2AMLogic/sky130-bandgap/(commit log)

2026-07-29 Scaffold canary block: Bandgap voltage reference on sky130
    Selected by the scored block matrix (marketing repo strategy/).
    Draft spec pending engineering ratification.
2026-07-30 Provision xschem + sky130 PDK, document bootstrap, add smoke test (#21)
    xschem (V3.4.7) and ngspice (ngspice-46) were already installed on the
    shared dev machine as a byproduct of gf180-bandgap#18; this fetches and
    enables the sky130 PDK via volare (open_pdks commit
    c6d73a35f524070e85faff4a6a9eef49553ebc2b, fetched 2026-07-29, pinned
    rather than "latest"), documents the PDK_ROOT/PDK=sky130A env
    convention, and proves the flow end-to-end with a throwaway resistor-
    divider schematic netlisted via xschem and simulated in ngspice against
    sky130 models (netlist + run output saved under sim/ as append-only
    evidence).
    Closes #17
    [smoke_test.sch]
2026-07-30 docs: survey bandgap topologies for sky130 3.3V/1.8V flavors (#20)
    Add spec/topology-survey.md comparing Brokaw, Kuijk-style CMOS-amp,
    self-biased current-mode, Banba, and Malcovati bandgap cores against
    the draft spec targets, using sky130 PDK model-card data (pnp_05v5,
    res_high_po/res_xhigh_po, thick-oxide MOS) confirmed against the local
    PDK checkout. Recommends Kuijk-style primary / Brokaw fallback for the
    3.3V flavor and Banba primary / Malcovati fallback for the 1.8V
    stretch flavor, as input to #1 and #7.
2026-07-30 Ratify wave-1 flavor scope: 3.3 V primary only, 1.8 V deferred (#22)
    Resolves the dual-flavor ambiguity in the DRAFT spec table by recording a
    decision: this canary block targets the 1.20 V ±1% untrimmed reference on
    3.3 V I/O devices only for wave 1. The topology survey (#3) shows the
    recommended 3.3 V core (Kuijk-style) and 1.8 V core (Banba) are structurally
    distinct topologies, not a shared core with a swappable output stage, so
    dual-flavor would roughly double wave-1 scope across schematic, offset
    budget, startup, testbench, trim, and floorplan work. gf180-bandgap already
    resolved the analogous question the same way (3.3V-only, stretch deferred),
    which this record cites as port-parity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
2026-07-30 Stand up the sky130 xschem+ngspice PVT corner-runner harness (#23)
    * Stand up the sim harness: sky130 PDK + xschem + ngspice PVT corner runner
    Reproducible testbench harness any agent can run cold, plus the evidence
    record convention CLAUDE.md's "verification is the product" rule needs to
    be enforceable.
    - sim/pdk.json pins the PDK (open_pdks commit / variant / model library /
    the process-corner names that actually exist in the PDK ngspice library:
    tt, ss, ff, sf, fs). The runner resolves the installed PDK back through
    its volare symlink and refuses to run against a different version unless
    --allow-pdk-mismatch is passed.
    - sim/xschemrc: project-local xschem config sourcing the PDK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
    [tb_pdk_smoke.sch]
2026-07-31 feat: characterize sky130 PNP, poly-resistor, and 5V MOS devices for bandgap sizing (#24)
    Full PVT-matrix ngspice sweeps (-40/27/125C x tt/ss/ff/sf/fs, +ll/hh for
    resistors) for the three device families the bandgap core will be built
    from: substrate PNP VEB/dVBE/ideality vs current, res_high_po/res_xhigh_po
    sheet-Rs/TC/mismatch, and 5V thick-oxide NFET/PFET mirror operating point
    plus an AVT-based mismatch projection. Confirms the topology survey's
    provisional res_high_po pick and corrects its static-Is-ratio PTAT
    assumption for the two PNP unit devices with measured dVBE data.
    Fixes two defects surfaced while running the harness against the
    mos-matching and pnp-characterization manifests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
    [tb_mos_matching.sch, tb_pnp_vbe.sch, tb_res_flavors.sch]
2026-07-31 docs: identify ngspice cause of flat res_xhigh_po TC, keep model card authoritative (#27)
    * sim: add single-length res_xhigh_po TC testbench with bias/length/simulator controls
    The two-length subtraction experiment in sim/resistor-flavor-characterization/
    returned an essentially flat TC for sky130_fd_pr__res_xhigh_po, disagreeing
    with the PDK model card. This new experiment measures TC at one fixed length
    (W=1um L=50um at 5uA, ~0.53V drop -- a representative bias-setting-resistor
    operating point) so no subtraction is involved, plus three companion legs that
    make the diagnosis falsifiable: the same geometry at 10x lower bias (voltage
    coefficient), the same current density at 10x shorter leng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
    [tb_res_tc_single_length.sch]
2026-07-31 docs: add Apache-2.0 LICENSE, rewrite README/CLAUDE.md for public audience (#29)
    Pre-publication prep for the repo going public: adds LICENSE (Apache-2.0),
    replaces the private/proprietary-IP framing in README.md with a public
    description of the block, an honest early-stage status note, and the
    agent-native build story; trims the Tier-2/confidentiality framing out of
    CLAUDE.md while keeping the operational guidance (PDK/tooling, friction
    protocol, verification, spec-change process) still relevant post-flip.
2026-07-31 ci: add headless CI workflow, wire package.json checks, ignore ngspice scratch dumps (#33)
    Adds .github/workflows/ci.yml running a fast headless `checks` job (JSON
    validity of sim/**/experiment.json and records, plus syntax checks of the
    harness scripts) on every push/PR, and a PDK-gated `pdk-smoke` job (installs
    ngspice/xschem/volare, fetches the pinned sky130 PDK, runs
    sim/pdk-smoke --quick) on a nightly schedule, workflow_dispatch, or an opt-in
    'run-pdk-smoke' PR label -- kept off the default PR path per the repo's
    headless-CI guideline.
    Wires package.json's placeholder check:ci/check:all/test/lint scripts to
    those real commands, deletes the untracked ngspice scratch dump
    bsim4v5.out fro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
2026-07-31 feat: measure sky130 PNP-pair local mismatch (sigma dVBE) by Monte Carlo (#34)
    Adds sim/pnp-mismatch/, the first Monte Carlo experiment in this harness:
    sigma of dVBE across a matched substrate-PNP pair, which is the term the
    untrimmed-accuracy offset budget hangs on.
    It does not go through sim/bin/corner-run.py -- that runner drives one
    deterministic .op per PVT point and has no notion of resampling a deck N
    times -- so this ships a bespoke run script plus a standalone .spice
    testbench, mirroring gf180-bandgap's sim/device-pnp-mismatch/. The script
    still imports corner-run.py's PDK resolution and pin enforcement, mints the
    same record ids, and writes both the .md record and its .json twin.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
2026-08-01 fix: drive the PNP emitter in tb_pnp_vbe and re-record the VEB ladder (#36)
    * fix(sim): drive the PNP emitter, not the collector, in tb_pnp_vbe
    The pnp_05v5 symbol draws the emitter at the top of the device body and the
    collector at the bottom, and xschem emits @pinlist in the symbol file's
    B-line order (collector, base, emitter) -- which is what
    .subckt sky130_fd_pr__pnp_05v5_* c b e expects. The symbol's pinnumber
    attributes (base=1, emitter=2, collector=3) disagree with that order and are
    a red herring.
    The bias ladder's lab_pin labels were swapped on every device, so each
    current source landed on the bottom (collector) pin with the emitter
    grounded: the ladder measured the base-collect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
    [tb_pnp_vbe.sch]
2026-08-03 feat: enter Kuijk-style bandgap core in xschem with smoke evidence (#40)
    * feat: add Kuijk-style bandgap core and error-amp cells in xschem
    Enters the 3.3 V bandgap core as two xschem cells plus a smoke experiment:
    - design/bandgap_core.{sch,sym}: Kuijk-style core -- two diode-connected
    grounded-collector substrate PNPs (small W0p68L0p68 array vs. large
    W3p40L3p40 array, both built by paralleling fixed-geometry unit devices),
    a matched res_high_po divider pair, and a self-biased pfet_g5v0d10v5
    mirror. GDRV (the mirror gate / amplifier output) is exposed on the symbol
    as the startup attachment node for issue #10; no startup circuit here.
    - design/error_amp.{sch,sym}: single-stage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
    [bandgap_core.sch, error_amp.sch, tb_bandgap_smoke.sch]
2026-08-03 feat: size the error amp to a measured offset budget with PVT and MC evidence (#41)
    Replaces the placeholder OTA in design/error_amp.sch behind its unchanged
    pin list (error_amp VINP VINN AOUT ITAIL VDD VSS) with an offset-budget-
    driven sizing, and adds the evidence that quantifies what that sizing does
    and does not buy.
    - design/error-amp-offset-budget.md: allocates the +/-1% untrimmed target
    across amplifier VOS, PNP mismatch and resistor mismatch using the Kuijk
    offset gain, with every term measured rather than projected.
    - sim/error-amp-loop/: 45/45 PVT corner record for loop gain, phase and
    gain margin, the measured dVOUT/dVOS offset gain, DC PSRR, and the Iq
    split between amp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
    [error_amp.sch, tb_amp_offset_mc.sch, tb_error_amp_loop.sch]
2026-08-03 feat: extend MOS mirror sizing sweep past size B at the core's actual current (#44)
    Adds sim/mos-mirror-sizing-extended/ -- a new testbench and full 15-point
    PVT record (tt/ss/ff/sf/fs x -40/27/125 C @ 3.30V, all PASS) that re-measures
    the schematic's actual PFET mirror size (B: W=8/L=2, 16um^2) at the core's
    real ~5.3uA branch current (design/bandgap_core.sch, issue #8/PR #40) and
    extends the size axis with three larger W/L=4 sizes (C: 36um^2, D: 64um^2,
    E: 100um^2).
    design/device-characterization-summary.md Sec 3 is updated with the new
    operating-point/mismatch table (nominal and worst-case-PVT columns) and a
    sharpened recommendation: the core's PFET mirror legs cross below 1%
    projected m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
    [tb_mos_mirror_sizing.sch]
2026-08-03 test: add the five per-spec-line corner-swept testbenches and their evidence records (#45)
    * test: add Vout/TC, DC PSRR, line-regulation and Iq testbenches for the bandgap core
    Four corner-runner experiments against design/bandgap_core.sch, one per
    3.3 V primary spec line (DR-001 scopes wave 1 to that flavor):
    - output-voltage-tc: box-method TC with temperature swept inside the deck
    (dc temp -40 125 1), plus VREF(27 degC) against 1.20 V +/-1%
    - psrr-dc: small-signal supply rejection from a 1 V AC magnitude on the
    supply, read at 0.1 Hz
    - line-regulation: VREF peak-to-peak across a 2.97..3.63 V in-deck supply
    sweep, with a large-signal PSRR figure that cross-checks psrr-dc
    - quiescent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
    [tb_vref_iq.sch, tb_vref_linereg.sch, tb_vref_psrr.sch, tb_vref_startup.sch, tb_vref_tc.sch]
2026-08-03 feat: add klt-driven DRC/LVS flow, proven on a trivial sky130 cell (#49)
    * feat: add klt-driven DRC/LVS flow, proven on a trivial sky130 cell
    Stands up a headless, repeatable klayout-tools (klt) DRC/LVS flow under
    layout/: generate a trivial known-good cell (klt gen mos_array defaults),
    run it through klt drc/extract/lvs against a hand-written reference
    netlist plus two independent negative controls, and check the resulting
    reports into layout/trivial-cell/reports/. Pins klt to an exact git
    commit (extract/lvs/gen are unreleased on PyPI) for the same
    reproducibility discipline sim/pdk.json applies to the PDK.
    Two klt gaps hit while proving the flow (res_array's extract-recognition
    miss, Py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
2026-08-03 Startup injector for the Kuijk core, with ramp and stable-state evidence (#47)
    * feat: startup injector for the Kuijk core, with ramp and stable-state evidence
    Adds design/startup_injector.sch (+ symbol) and the two experiments that
    substantiate the spec's "self-starting, < 1 ms" line: sim/startup-ramp/
    (startup time) and sim/startup-stability/ (no other stable state). The
    injector attaches to the GDRV node bandgap_core.sym already exposes; the
    core cell is not touched.
    Topology
    --------
    A two-high diode-connected PMOS reference fed FROM GDRV holds the injector
    NMOS gate high while the core is dead, and collapses on its own once the
    core pulls GDRV down -- the node the cell drives is also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
    [startup_injector.sch, tb_startup_ramp.sch, tb_startup_stability.sch]
2026-08-03 test: add Monte Carlo mismatch testbench for the untrimmed ±1% claim (#51)
    * test: add Monte Carlo mismatch testbench and evidence for the untrimmed ±1% claim
    Wraps issue #11's output-voltage bench (tb_vref_tc.sch, unmodified) with the
    PDK's MC_MM_SWITCH local-mismatch models, run at nominal and both temperature
    extremes with a PNP/resistor/amp-mirror contributor breakdown by isolating
    each family's sw_mm_* coefficients. Records N=300 samples with a convergence
    check justifying the sample count, an MC-off control, and a second-seed
    stability check.
    * Fix self-referential dominant-contributor sentence in MC record rendering (during evaluation)
    sigmas[dominant] and max(sigmas.values()) ar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
2026-08-03 test: measure the ff/125C/3.63V startup-stability corner and retire its stale dvref (#53)
    * feat(sim): record signal kills and per-corner wall clock distinguishably
    corner-run.py reported a signal-killed ngspice child (negative return code
    from subprocess) the same way as a clean nonzero exit: the log header said
    only 'ngspice exit: -9' and the record's failure reason said 'ngspice exit
    -9'. Telling that apart from the harness's own timeout path (which is the
    only place that sets rc = -1 with timed_out = true) required manually
    cross-referencing the ngspice_exit/timed_out pair across records.
    - run_corner() now derives killed_by_signal from a negative rc that did not
    come from the timeou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
2026-08-03 test: reject an accuracy-safe n_r2 resize that collapses regulation at hot/fast/low-VDD corners (#54)
    Investigate re-deriving the core's PTAT weight (n_r2/n_r1) against the
    measured sub-PTAT dVBE slope (issue #46). A full slope-cancelling K (~9.0,
    n_r2~65) breaches the +/-1% VOUT accuracy window by 7.9% and still only
    reaches 85 ppm/degC. The largest accuracy-safe step (n_r2=54->55) narrowly
    holds VOUT(27 degC) inside the window, but a full 15-corner run
    (20260803-142220-b24b404) shows it loses the bandgap operating point above
    ~124 degC at the ff/2.97V and fs/2.97V corners -- confirmed a genuine
    bifurcation (not a solver artifact) by a fine-resolution diagnostic sweep,
    and confirmed introdu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
    [bandgap_core.sch]
2026-08-03 docs: flag the rejected n_r2=55 record and mark scratch-run claims in bandgap_core.sch (#57)
    sim/output-voltage-tc/records/20260803-142220-b24b404.md is the newest record
    under the output-voltage-tc slug but describes a rejected n_r2=55 sizing
    candidate from issue #46's investigation, not the shipped n_r2=54 core --
    nothing in the record said so. Add sim/output-voltage-tc/README.md as a
    record index (append-only: existing records are untouched) pointing out
    which records describe the shipped design and flagging b24b404 as a
    rejected-candidate record kept only as evidence for #46's floor finding.
    Also mark the epistemic status of three decisive-sounding figures in
    design/bandgap_core.sch's s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
    [bandgap_core.sch]
2026-08-03 feat: add downward-only ladder-tap trim to bandgap core, reject unsafe upward range (#58)
    * feat: add downward-only ladder-tap trim to bandgap core, reject unsafe upward range
    Issue #12's Monte Carlo evidence shows the untrimmed +/-1% target is not met
    (yield collapses to 0.67% at 125C), so this adds a resistor-ladder trim
    network (n_r2_trim/r_lseg_trim) to R2A/R2B in design/bandgap_core.sch.
    Direct simulation of the design-phase draft's bidirectional range found the
    positive (VOUT-increasing) direction unsafe: it shares the same R2/R1 ratio
    issue #46 already found causes ff/2.97V and fs/2.97V hot-corner regulation
    collapse, and codes +1/+2 collapse the operating point non-monotonically
    ev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
    [bandgap_core.sch]
2026-08-03 test: add xschem embedded-quote hygiene check to check:ci (#60)
    xschem's netlister terminates a quoted text-attribute value (`value="..."`,
    `author="..."`, etc.) at the FIRST literal `"` it encounters, silently
    dropping everything after it -- this previously truncated
    design/bandgap_core.sch's CORE_PARAMS .param block (#54/#58) and, as this
    change also found, sim/error-amp-offset-mc's TB_SEED comment. Add
    .loom/scripts/check-xschem-embedded-quotes.sh, wire it into package.json's
    check:ci, fix the one remaining live instance (a "sigma" comment), and add
    design/README.md documenting the authoring hazard.
    design/bandgap_core.sch's own known violation was already fixed by PR #58
    before this iss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
    [tb_amp_offset_mc.sch]
2026-08-03 feat: add bandgap-core floorplan and matching plan, DRC-clean skeleton (#61)
    Writes the matching-effort allocation issue #12's Monte Carlo contributor
    breakdown calls for (amp/mirror MOS mismatch dominates at every
    temperature, ahead of the resistor network and the PNP array), and
    generates+places+DRC-checks an initial floorplan skeleton for every
    matched device group in design/bandgap_core.sch/design/error_amp.sch via
    klt gen + gen-compose's new explicit 2D placement strategy.
    Bumps layout/requirements.txt's klt pin to pick up gen-compose's
    placement.strategy: "explicit" (2AMLogic/klayout-tools#330), verified
    non-regressing against issue #14's own trivial-cell DRC/LVS proof. Fixes a
    pre-ex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
2026-08-03 fix: break the core+amp railed branch with a VOUT-vs-GDRV clamp in the injector (#63)
    * fix: add railed-branch clamp MNC to the startup injector
    The core+amp loop has a second stable DC equilibrium below its intended
    operating point: with GDRV driven low, the core's MPAMP over-drives the
    error amp's tail, the amp's folding node PN collapses toward VSS, MN4
    drops into deep triode while MN3 does not, and the amp's output current
    changes sign. The loop then rests at GDRV ~ 0.78 V with VOUT railed at
    ~3.5 V and ~540 uA of supply current. It is a property of the core+amp
    loop (the bare-core control instance shows the same three crossings) and
    appears only with the amplifier sizing shipped by iss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
    [startup_injector.sch]
2026-08-04 feat(layout): route bandgap core, extract PNP/MOS/resistor devices, run LVS (#64)
    * feat(layout): route bandgap core, extract PNP/MOS/resistor devices, run LVS
    Adds a routed-layout flow beside the issue #15 placement-only floorplan
    skeleton (which stays unmodified, its records append-only):
    - layout/bin/gen_bandgap_routed.py + run-bandgap-routed-flow.sh: gen ->
    draw -> compose+route -> drc -> extract -> lvs, gated on DRC-clean, the
    area budget, all four device classes extracting, and pin_count > 0.
    - Draws the R2A/R2B ladder at its real 108-unit count (54/leg) folded into
    9 rows, closing the skeleton's 16-unit reduction; the whole routed cell
    measures 38,171 um^2 against the 50,000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
    [gen_bandgap_routed.py]
2026-08-04 feat(layout): draw intra-block busses on met1, restore per-group guard rings, close 3 upstream klt blockers (#65)
    Second increment on issue #62's routed bandgap-core layout. Builds on the
    inter-block met1 routing this branch already had staged (a prior killed
    Builder run) by adding layout/bin/met1_bus.py: since klayout-tools#433's
    merged fix only made a same-block bus attempt fail visibly (not draw-able),
    this draws every array's intra-block bus itself on met1 over mcon -- the
    sky130 extraction deck's second conductor/via, which klt extract already
    wires up generically. That turns the 108-unit R2A/R2B ladder into two real
    series resistors and each 8-unit PNP array into one real m=8 device, a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
    [gen_bandgap_routed.py, met1_bus.py]
2026-08-04 feat(layout): bind diff_pair halves to schematic devices, route VSS/GDRV/bulk taps, gate on label collisions (#67)
    * feat(layout): bind diff_pair halves to schematic devices, route VSS/GDRV/bulk taps, gate on label collisions
    Third increment on the bandgap-core routed layout. Investigates how much of
    the previous increment's "blocked on the MOS gate-contact gap" was really
    that gap, and finds four things that were not.
    - Fix a topology error the previous increment shipped: `VOUT`'s pin label
    landed on `core_mirror.M2_1_D`, which is MPAMP's drain and the pad the
    drawn `TAIL` net contacts, so the extracted netlist contained a net named
    `TAIL|VOUT` -- the layout asserting the reference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
    [gen_bandgap_routed.py, met1_bus.py]
2026-08-04 test(layout): unit-cover the routed-flow gates, extract flow_gate() (#68)
    The routed-layout flow decides pass/fail on three checks nothing else
    performs -- the drawn-short check (met1_bus.Met1Bus.conflicts), the
    label-collision check (assert_no_merged_pin_names) and the coverage
    scorer (schematic_net_coverage) -- but all three were exercised only
    end-to-end, by a run that needs a klt install and a ~1 GB PDK. That
    means their failure paths were never exercised at all: a passing run by
    construction never reaches them.
    Adds layout/tests/test_routed_flow_gates.py (35 stdlib unittest cases,
    PDK-free, milliseconds) covering both paths of each gate, including two
    regression cases read from this di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
    [gen_bandgap_routed.py]
2026-08-04 feat(layout): bump klt past #461/#462/#463/#454/#470, bus every MOS finger, LVS 355 -> 106 (#71)
    * feat(layout): contact MOS gates and bus every split device's fingers
    Bumps the pinned `klt` past the five upstream fixes the last three routed
    records were waiting on, and rebuilds the bandgap-core routing around the
    two that change what is drawable:
    * klayout-tools#461 (via #474) makes a MOS gate contactable -- the
    generators now extend the first finger's poly past the diffusion into a
    landing pad. `met1_bus.gate_contact` places the licon and the li1 riser
    (the router still cannot reach a poly port; filed as #492), and the new
    `bus_mos_comb` runs one met1 trunk per node *inside* each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
    [gen_bandgap_routed.py, met1_bus.py]
2026-08-04 feat(layout): add rip-up-and-reroute repair pass to inter-block router (#73)
    * feat(layout): add rip-up-and-reroute repair pass to inter-block router
    Extracts per-net solving into _route_one_net() (with a skip_first
    parameter to force it past its own greedy first solution) and adds
    _repair_unrouted_hops()/_replay_tail(), a bounded post-search repair
    pass that rolls back and redraws the specific earlier net that
    blocked a still-unrouted hop, forced onto its next-best solution.
    Run once, deterministically, after build_bus_overlay's existing
    whole-cell order-search picks its winner -- this is issue #62's
    "per-hop rip-up-and-reroute" lever, the highest-priority next
    increment per the prior bui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
    [gen_bandgap_routed.py]
2026-08-04 test(layout): add real-geometry coverage of the rip-up-and-reroute repair pass (#74)
    PR #73 shipped layout/tests/test_route_repair.py alongside the mechanism,
    which already unit-covers _route_one_net's skip_first parameter and
    _repair_unrouted_hops/_replay_tail -- its control flow (targeting, bounded
    retries, revert-on-no-improvement, "a later net named as blocker is never
    rolled back") via a scripted mock of _route_one_net, plus skip_first
    candidate ranking through hand-built li1 block ports.
    This adds complementary coverage in the file issue #62's own Test Plan
    names: TestRouteOneNetSkipFirst and TestRepairUnroutedHops in
    layout/tests/test_routed_flow_gates.py drive the *real*, non-mocked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
2026-08-04 docs(layout): rule out klt#468 and router-search-depth as AC1 levers, narrow the floorplan-split candidate (#75)
    Investigated both candidates PR #73 left open for closing issue #62's
    remaining 3 unrouted inter-block hops (D1/VDD/VSS):
    - klayout-tools#468 (metal2/via1 routing roles) is merged and already in
    this repo's pinned klt commit, but its "metal2" role resolves to the
    same met1 layer met1_bus.py already hand-routes on (sky130's curated
    deck has only two metal levels total), and gen-compose's own router is
    a less capable two-pin planner than this repo's own multi-strategy
    channel router. No new capacity -- ruled out as a lever.
    - Widened this repo's own router search 2-3x (ca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
2026-08-04 docs(layout): rule out the per-hop channel-search-window as an AC1 lever (#76)
    Ran the one lever the prior same-day pass named as untested (widening
    CHANNEL_NEAR_TRACKS/CHANNEL_DOGLEG_TRACKS) to completion instead of
    leaving it unverified. It is not a net win for AC1: it frees VDD but
    breaks a previously-drawn net (TAIL) in trade, schematic inter-block
    coverage stays at 9/12, mismatch_count only moves 106 -> 105, and
    runtime nearly doubles. Documents the finding in matching-plan.md
    Section 7e; the code change itself is not shipped (reverted after
    measurement, matching this issue's established pattern for a
    ruled-out lever).
2026-08-04 docs(layout): rule out widening row 0's own block margin as an AC1 lever (#77)
    Tried a bounded, row-0-only widening of place_blocks()'s block-to-block
    margin (16 -> 24 um) as a smaller alternative to the amp_input_pair
    floorplan redesign for VSS's still-unrouted hop. Ran the full flow to
    completion: VSS's blocked hop stayed blocked at the identical block
    (pnp_ctat) before and after, D1/VDD were likewise untouched, and GDRV
    (previously fully drawn) regressed to partial as a side effect of the
    whole-cell order search picking a different winner -- schematic coverage
    9/12 -> 8/12, mismatch_count 106 -> 107, composed area within ~3% of the
    50,000 um^2 budget. Reverted (not shipped); the measured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
2026-08-04 fix(layout): route VDD to every PMOS n-well tap, LVS correspondence 0/0 -> 3 devices/1 net (#78)
    The inter-block router pinned each MOS group's guard-ring bulk terminal to
    its `TAP_S` pad. Two of the `VDD` trunk's hops could not route out of that
    pad -- `core_mirror.TAP_S` is boxed in by its own block's comb escape stubs,
    and `amp_input_pair.TAP_S` is on the far side of a 180 um input pair -- so
    `core_mirror`'s and `amp_input_pair`'s n-wells were never joined to `VDD`
    and both groups' PMOS body terminals extracted onto anonymous floating nets.
    `NetlistComparer` has no name-based seeding, so a netlist whose PMOS bulks
    sit on nets the reference does not contain gave it nothing to seed from at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
    [gen_bandgap_routed.py, met1_bus.py]
2026-08-04 diag(layout): tally every hop's distinct blockers, and separate corridor contention from block-internal walls (#79)
    Every increment since 7c characterized each unrouted hop by a single
    `blocked_by` net. That value is `_LAST_BLOCKER` -- whichever candidate path
    `_connect()` happened to try last before giving up, not the net actually
    holding the corridor. This adds `_BLOCKER_COUNTS`, a per-`_connect()`-call
    tally of every distinct veto, surfaced on a failed hop as
    `blocked_by_counts` alongside the unchanged `blocked_by`. Purely additive:
    `device_counts`, `pin_count`, `mismatch_count` (92) and `violation_count`
    (0) in the new record are identical to the `20260804-105025-25d02e6`
    baseline on mai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
    [gen_bandgap_routed.py]
2026-08-04 docs(layout): re-verify router search-depth is still not a lever after PR #78 changed the unrouted set to D1/GDRV/VSS (#80)
    PR #78 fixed VDD's two blocked hops (offering every PMOS guard-ring tap as
    a routing candidate instead of pinning to one), taking klt lvs from 0/0 to
    3/1 device/net correspondence and mismatch_count from 106 to 92. Its own
    record disclosed the cost: the corridor VDD now uses through core_mirror is
    one GDRV previously had, so GDRV's hop is now blocked where it was fully
    drawn before. Schematic coverage stayed at 9/12 -- a different net in the
    short column, not a net gain.
    Re-ran the router-search-depth widening Section 7d already ruled out for
    the old D1/VDD/VSS set (CA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
2026-08-04 docs(layout): attempt VSS's row-0 re-placement directly -- fixes VSS, trades it for a different net each time, ruled out (#81)
    Issue #62's AC1 has been narrowed since Section 7d to "VSS needs a row-0
    re-placement, not just re-spacing" without anyone attempting one. This
    increment tries the cheapest possible re-placement -- reordering row 0's
    five BLOCKS entries so the two PNP arrays sit adjacent -- with two
    concrete orderings, each run through the full routed-layout flow.
    Both confirm VSS is genuinely fixable by placement (all 5 hops route with
    zero conflicts once the PNP trunks are adjacent), but neither is a net
    win: experiment 1 trades VSS for VB (schematic coverage flat at 9/12,
    mismatc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
2026-08-04 docs(layout): attempt row 0's genuine 2D split (PNP row + resistor row), fixes VSS's own hop, net regression, ruled out (#82)
    Split BLOCKS' row 0 into a PNP-only row and a resistor-only row (PNPs
    adjacent, per Section 7i's own successful arrangement), with
    ROW_MARGIN_UM lowered 22 -> 15 um uniformly to close the resulting 11%
    budget overrun. Ran the full flow to completion: VSS's own named hop
    (pnp_ctat<->pnp_ptat) genuinely routes end to end, confirming Section
    7i's finding generalizes from a 1D reorder to a real 2D floorplan
    split. But two new casualties (TRIM_A/TRIM_B, both newly blocked by
    VA's longer, now-narrower-channel route) plus VSS's remaining
    congestion shifting to a different ho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
2026-08-04 docs(layout): try Section 7j's non-uniform row-margin candidate, in two shapes -- both still net-regress, closing off channel width as the mechanism (#83)
    Thirteenth increment on issue #62. PR #82 (Section 7j) left one candidate
    open for the row-0 PNP/resistor 2D split: source the area saving from a
    channel VA's route doesn't cross instead of cutting ROW_MARGIN_UM uniformly.
    This attempts that directly in two shapes (RING_MARGIN_UM-only cut, and a
    per-boundary cut targeting only the one channel none of VA/VB/VBQ/TRIM
    crosses) plus a control run with no margin touched at all.
    All three still net-regress (9/12 -> 8/12, mismatch_count 92 -> 94/95). The
    new finding: TRIM, a same-row net that cr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
2026-08-04 fix(layout): bump klt pin past #490/#491/#492/#496/#504, drop stale substrate hint, LVS mismatch 92 -> 32 (#84)
    The current klt pin (8c277eb9) predates five upstream fixes that closed
    since: klayout-tools#490 (NMOS body/resistor bulk resolves to a real drawn
    substrate tap when one is present, instead of an undrawable synthesized
    vsubs global), #491 (dummy-device marker layer now declared on sky130, so
    klt extract correctly suppresses array dummies), #492 (gate_contact param,
    not adopted here), #496 (gen-compose backbone stub widening), and #504
    (a diagnostic-only device.class_arity mismatch category).
    Bumping the pin alone broke klt lvs: gen_bandgap_routed.py's SUBSTRATE_
    SAME_NETS uncondit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
    [gen_bandgap_routed.py]
2026-08-04 docs(layout): file klayout-tools#506 for the deferred resistor-arity LVS reconciliation, no lever left untried for AC1 (#85)
    Fifteenth increment on issue #62. Sections 7d-7k exhausted every routing/
    floorplan lever for AC1's remaining D1/GDRV/VSS trio. This increment turns
    to AC4 instead: cause 4 (res_high_po's 3-terminal DeviceClassResistorWithBulk
    vs. the reference's 2-terminal DeviceClassResistor) blocks every resistor
    from pairing, and klayout-tools#504's own "what would close it" list had two
    undone options (a request-side reconciliation hint, or a layout-side
    bulk-drop flag) that #505 deliberately deferred, shipping only the
    diagnostic-only device.class_arity category. No follow-up exi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
    [gen_bandgap_routed.py]
2026-08-04 fix(layout): transcribe res_high_po's bulk terminal into reference.spice, closing the resistor device-class arity mismatch (#86)
    Sixteenth increment on issue #62. reference.spice's R2A/R2B/R1 cards
    carried only two terminals (A, B), reading as klayout.db's
    DeviceClassResistor -- incompatible with the layout side's three-terminal
    DeviceClassResistorWithBulk (sky130 marks res_high_po bulk_to_substrate),
    so klt lvs could never pair these devices regardless of value
    (klayout-tools#504/#505).
    This was an incomplete transcription, not the layout accommodation a
    prior record assumed it would be: design/bandgap_core.sch explicitly
    wires each resistor's bulk pin to VSS (r2ab/r2bb/r1b lab_pins), the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
    [gen_bandgap_routed.py]
2026-08-04 docs(layout): rule out klt#454/#468's metal2 role as an AC1 lever, file the sky130 third-routing-layer gap as klayout-tools#508 (#88)
    Seventeenth increment on issue #62. Section 7k's own closing line named
    two qualitatively different remaining candidates for AC1's D1/GDRV/VSS
    corridor congestion: an order-search change to this repo's own router, or
    "accepting the corridor deadlock as a hard limit of this router and
    pursuing ... a genuine second metal role instead ... a third routing
    layer, not merely a second role name, would be the actual capability gap
    to file." Section 7d had already found klayout-tools#454/#468's "metal2"
    role resolves to the same met1 layer this flow's own met1_bus.py a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
    [gen_bandgap_routed.py]
2026-08-04 docs: correct root README status/maturity-ladder claims against actual layout progress (#89)
    The Status line said layout had not started; layout/ actually holds
    8.2MB of DRC-clean, partially-routed bandgap-core layout with extracted
    PNP/MOS/resistor devices and an LVS run blocked on upstream
    klayout-tools gaps (#433/#434), not unattempted. The maturity-ladder
    line didn't mark current position either. Both are corrected, pulling
    phrasing from layout/README.md's existing status writeup rather than
    re-deriving it.
2026-08-04 feat(layout): route the last 3 inter-block nets on a met2 escape plane, close AC1, drop LVS mismatches 32 to 18 (#92)
    * fix(layout): bump klt pin past klayout-tools#508's merge, pick up sky130's third connectivity level (metal3/via2)
    klayout-tools#508 (the routing-plane capability gap the seventeenth
    increment filed) is now closed via klayout-tools#511: sky130's curated
    extraction deck gains a third connectivity level (met2.drawing, role
    name "metal3"/"via2"), a genuinely independent second routing plane
    above the met1 bus this flow's own met1_bus.py already hand-routes
    every net on.
    This increment bumps layout/requirements.txt's klt pin to pick it up
    and refreshes every NOTE constant / ge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
    [gen_bandgap_routed.py, met1_bus.py, met2_drc.py]
2026-08-04 fix(layout): split met2_wire_count from met1_wire_count, guard the full met2 via1 stack, restore CI coverage for test_met2_drc.py (#94)
    Judge's non-blocking follow-ups from PR #92 (issue #93):
    - hseg2()/vseg2() bumped the shared wire_count, so the emitted
    "met1_wire_count" silently tallied met2 segments too. Give met2 its own
    met2_wire_count, threaded through mark()/restore() and the emitted
    gen.json report; _draw_guarded_met2's rollback now restores the right
    counter.
    - _met2_drop() checked only the met1 landing pad against a foreign node
    before committing a via1 stack. It now also checks the met2 landing pad
    (m2.4/m2.5) and the via1 cut itself (via.2), so a foreign neighbour o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
    [gen_bandgap_routed.py, met1_bus.py]
2026-08-04 fix(layout): split each R2 leg into 250um coarse + 20um trim so the DR-002 ladder trims downward, and gate the leg-length check (#96)
    The bandgap-core layout drew each R2 divider leg 286 um where
    design/bandgap_core.sch states 270 um (`L = r_lseg*n_r2 + r_lseg_trim*n_r2_trim`
    = 5*54 + 1*0). `res_r2` was drawn at the full 54 coarse units per leg and
    `res_trim`'s 16 x 1 um ladder was wired in series *after* it, so the drawn
    cell sat at DR-002 trim code +16 -- a direction DR-002 rejects outright --
    and every tap short of the far end moved the leg further up, meaning the
    drawn ladder could express none of the 16 downward codes DR-002 certifies.
    K = R2/R1 sets VOUT and its TC, so this was a first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
    [gen_bandgap_routed.py]
2026-08-05 fix(layout): transcribe PNP emitter geometry into reference.spice, rebased onto issue #91 -- LVS mismatch 18 -> 4 (#95)
    * fix(layout): transcribe PNP emitter geometry into reference.spice, closing the ae/pe/ne mismatch (issue #62, twentieth increment)
    reference.spice's QQ1/QQ2 cards carried a bare `m=8` -- a field
    DeviceClassBJT3Transistor's SPICE reader does not recognise at all (unlike
    MOS, where `m=` folds into `W` at read time), so every unstated BJT3
    parameter defaulted to its class default (AE/PE/AB/PB/AC/PC=0, NE=1).
    AE/PE are knowable independent of this layout's own generator: the
    instantiated model name (pnp_05v5_W0p68L0p68 / _W3p40L3p40) is SkyWater's
    own fixed, non-parametric m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
    [gen_bandgap_routed.py]
2026-08-05 fix(layout): bump klt pin past #518/#519, #521/#526 -- res_high_po head-resistance fix doesn't close AC4 (#97)
    Bumps layout/requirements.txt's klt pin to 39bdbc4, past the merged
    upstream fix for res_high_po's fixed head/end-resistance term
    (klayout-tools#518 -> #519) and the companion fix that makes the
    correction reach the written netlist klt lvs actually compares
    (#521 -> #526, without which #519 would have been invisible to this
    flow's own LVS result).
    Re-running the routed flow shows the bump does NOT close AC4's
    resistor cause: mismatch_count and category_counts are unchanged
    (still 4; still device.property: 3, device.unmatched: 1), but the r
    delta on R1/R2A/R2B gets larger, not small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
    [gen_bandgap_routed.py]
2026-08-05 docs(sim): confirm the routed array's per-instance head resistance is real and material, not an LVS artifact (issue #98) (#100)
    sim/res-array-head-resistance/ chains real sky130_fd_pr__res_high_po SPICE
    model instances at the routed layout's own N/L shapes and reproduces klt's
    LVS-extracted R1/R2A/R2B to 5-6 significant figures via an independent
    mechanism, ruling out an extraction-only artifact. Substituting the same
    chained topology into the core testbench pushes VOUT outside the +/-1%
    window at all 5 corners checked, and collapses regulation at the two
    hot corners issue #46/#91 already flagged as margin-thin. Ratified in
    DR-003; the corrective n_r1/n_r2 resize is scoped to follow-up issue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
    [bandgap_core.sch]
2026-08-05 docs(layout): sync README status claims to the current 12/12-routed, mismatch=4 state (#102)
    * docs(layout): sync README status claims to the current 12/12-routed, mismatch=4 state (issue #62)
    Root README.md and layout/README.md both still described the pre-#78 state
    ("4 of 12" schematic inter-block nets routed, full LVS "blocked upstream" on
    klayout-tools#433/#434, a PNP recognition overlay retired many increments
    ago) even though main has been at 12/12 routing (criterion 1 MET) and
    klt lvs mismatch_count=4 for several merged PRs (through PR #97). The
    layout/README.md prose was internally contradictory: its own summary table
    already said "12/12 schematic inter-block nets fully joined (crit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
2026-08-05 fix(layout): correct stale/self-contradictory met2-DRC-coverage claims, cross-reference issue #98 into AC4 status (#103)
    * docs: cross-reference issue #98's material finding into #62's AC4 status
    Issue #98 (closed today via PR #100) independently confirmed with real-SPICE
    evidence that the routed R2A/R2B/R1 array's per-instance res_high_po head
    resistance -- AC4's second disclosed LVS-mismatch cause -- is a real,
    material electrical effect of the layout's own folded topology, not an
    LVS-extraction bookkeeping artifact. That finding (ratified in DR-003, with
    the corrective n_r1/n_r2 resize scoped to follow-up issue #99) postdates the
    last README sync (PR #97/#102) and was not yet cross-refer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
    [gen_bandgap_routed.py, met1_bus.py, met2_drc.py]
2026-08-05 fix(design): resize n_r2 54->50 for the routed layout's chained-array topology (DR-003 close-out, issue #99) (#105)
    The routed layout draws each R1/R2A/R2B divider leg as a chain of
    separately-contacted res_high_po unit instances, which pays real
    per-instance head resistance (issue #98 / DR-003). At the shipped
    n_r2=54 that makes the fabricated part's K=R2/R1 read 8.1474 (vs the
    single-device model's 7.4973), pushing VOUT(27C) to ~1.233 V -- out of
    the draft +/-1% window at all 5 PVT corners, and collapsing regulation
    at ff/2.97V and fs/2.97V.
    Resize n_r2 54->50 (n_r1 held at 7 so branch current, and thus
    hot-corner headroom, is not raised while K is corrected). Verified with
    a new real-SPI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
    [bandgap_core.sch]
2026-08-06 fix(layout): propagate n_r2 54->50 resize into the drawn array, reference.spice chained-value convention -- mismatch_count 4 -> 1 (#110)
    layout/bin/gen_bandgap_routed.py still transcribed the pre-resize sizing
    (N_R1=7, N_R2_COARSE=50, SCH_N_R2=54) after issue #99/PR #105 resized
    design/bandgap_core.sch's n_r2 54->50 against the routed array's real
    chained-array topology (DR-003's closure). This re-transcribes it:
    - N_R2_COARSE 50->46, SCH_N_R2 54->50 (N_R1 stays 7, per DR-003), splitting
    the resized 250 um/leg into 46 coarse 5um units + the unchanged 20 fine
    1um trim units, still reaching all of DR-002's certified 0..-16 codes.
    - res_r2's `rows` fold stays at 10 (unchanged), re-verified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
    [gen_bandgap_routed.py]
2026-08-06 fix(layout): bump klt pin past klayout-tools#583/#587 -- once-per-combined-device correction measured under all four accounting variants and declined (it regresses mismatch_count 1 -> 4) (#104)
    * fix(layout): bump klt pin past klayout-tools#559's own fix (#583) -- confirmed real, confirmed unreachable from this flow's request shape (issue #62)
    klayout-tools#559 (ResistorDevice.fixed_offset_ohm charged once per
    drawn primitive instead of once per logical device, the twenty-third
    increment's disclosed AC4 floor) closed upstream via klayout-tools#583
    (merged 2026-08-05T20:15:46Z): `combine_devices()` now defers the
    correction until after folding series primitives, applying it once per
    combined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
    [gen_bandgap_routed.py, measure_fixed_offset_variants.py]
2026-08-06 fix(spec): halve the fine-trim unit length to restore DR-002's LSB comfort bound on the chained topology (issue #106) (#111)
    Re-derives DR-002's monotonic/span/LSB trim criteria against the routed
    layout's real chained fine-trim topology at the adopted n_r1=7/n_r2=50
    sizing (not the abandoned n_r1=6/n_r2=42 alternative the original issue
    text cited). The shipped r_lseg_trim=1 um chain fails the <=3.000 mV/code
    LSB comfort bound at all 5 corners (3.12-3.15 mV/code); halving the fine
    unit's drawn length to 0.5 um -- which only shrinks the per-code step's
    smaller rbody term, since the dominant per-instance rhead term is a fixed
    PDK-model constant -- restores it to 2.40-2.42 mV/code, PASS everyw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
    [bandgap_core.sch]
2026-08-06 fix(layout): propagate r_lseg_trim 1um->0.5um into the routed array -- N_R2_COARSE 46->48, reference.spice re-derived, mismatch_count holds at 1 (#112) (#113)
    layout/bin/gen_bandgap_routed.py still hardcoded the pre-revision
    r_lseg_trim=1 value after issue #106/PR #111 halved
    design/bandgap_core.sch's .param r_lseg_trim to 0.5 (restoring DR-002's
    chained-topology per-code LSB to 2.40-2.42 mV/code, under its own
    <=3.000 mV/code comfort bound). Re-transcribes that revision into the
    drawn array, per DR-002's own deferred "Scope of this revision" follow-up:
    - R_LSEG_TRIM_UM/SCH_R_LSEG_TRIM_UM 1.0->0.5, and N_R2_COARSE 46->48 to
    hold the untrimmed leg fixed at 250 um (5*48 + 0.5*20 == 250, mat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
    [gen_bandgap_routed.py]
2026-08-07 fix(config): wire settings.json PreToolUse/Bash hook to the Loom dispatcher (#116)
    .claude/settings.json wired the canonical Repo Skills guard directly,
    bypassing .loom/hooks/guard-destructive.sh's dispatcher architecture. The
    dispatcher probes the canonical guard for the worktree-write-confinement
    capability marker, which currently fails, so it falls back to the vendored
    guard carrying the gh --body @path hard-deny and write-confinement
    protections that were otherwise absent from the executed guard path.
    Closes #115
2026-08-09 spec: stage spec-review verdict (ratify-with-amendments) for #1's ratification (#120)
    Runs the klayout-tools spec-review skill's procedure by hand against this
    repo's own decision records (DR-001..DR-003) and sim/devchar evidence, per
    the operator's 2026-08-09 interim contract on #1 (spec-review cannot yet
    mark ratification binding -- klayout-tools#654). Re-review: the 2026-07-31
    pass deferred on missing PNP-pair mismatch evidence (#31); that evidence
    landed 2026-08-01 and substantial additional evidence (#9's offset budget,
    #11's testbench suite, #12's whole-core Monte Carlo, #46's TC investigation)
    has landed since.
    Verdict: ratify-with-amendments. PSRR, Supply, Iq, Area, and the Stretch/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
2026-08-09 refactor(sim): dedupe corner-run loader and chain_lines helper into sim/bin/sim_common.py (#121)
    _load_corner_run() (the importlib shim for the dash-named corner-run.py) was
    copy-pasted across 7 sim/*/run_*.py scripts, and chain_lines() (the chained
    res_high_po deck-line builder) across 3 of them, with pnp-mismatch's copy of
    the loader already drifted to register under spec.name instead of the
    hardcoded "corner_run" string (functionally equivalent since spec.name ==
    "corner_run" here, but a real drift risk going forward). Both now live once
    in sim/bin/sim_common.py, imported normally by each call site via a
    sys.path.insert(0, sim/bin) bootstrap. mean() is also consolidated since it
    was trivi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
2026-08-10 chore(repo-skills): update installed Repo Skills to 0.10.0
    Rolled straight to main rather than via a per-repo branch. The 0.8.1 rollout
    used branch-per-repo and seven of those branches were abandoned mid-flight,
    leaving their repos parked off trunk for days — and invisible, because
    compute-drift.sh's axis 3 compares a checkout against its OWN branch, so a
    repo current with a stale branch reports clean (2AMLogic/2am#209). An
    installed-tool refresh is mechanical, already-reviewed content, so a direct
    commit removes that abandonment failure mode entirely.
    This host's fleet spanned 0.6.1 to 0.8.1 before this pass, against a 0.10.0
    source — see 2AMLogic/2am#216.
2026-08-11 DR-005: ratify target spec — output accuracy to gf180 parity (±2%/±0.5%), issue #1 (#122)
    Ratifies the DRAFT target-spec table as the block's single source of truth,
    unblocking the layout gate (#14 DRC/LVS, #15 floorplan) and the #8 chain.
    The one deferred row (output accuracy, #32 held pending PNP-pair σ(ΔVBE)) is
    resolved on measured evidence now that #31 and #9 have landed:
    - Untrimmed local-mismatch spread alone is 1.39% (3σ @27°C) / 1.54% (@125°C) of
    1.2 V — already outside the draft ±1% line before process/temp. ±1% untrimmed
    is physically off the table.
    - 83% of that variance is the amplifier's own random offset (×9.65 offset gain),
    NOT the σ(ΔVBE) the deferral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
2026-08-11 layout(issue #62): check MCC MIM-cap overlay feasibility -- area is ample, tooling is not; propose DR-006 to fall back to the MOS-cap path (#124)
    Operator ruling (2026-08-11): MCC is stability-critical, not a waivable
    LVS exception; realize it as a cap_mim MIM overlay if feasible, fall back
    to drawing it as the MOS cap it is today (+ an Area-budget relaxation) if
    not.
    Area side: ample. This cell never leaves li1/met1/met2; met3/met4/met5
    are entirely empty across the full 45,968 um^2 footprint, far more than
    the ~14,500 um^2 a 29 pF cap_mim needs.
    Tooling side: empirically infeasible today. A minimal klt draw fixture
    (two-terminal wiring matching what MCC's replacement would need) run
    agai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
2026-08-11 spec(PSRR): adopt gf180-bandgap's frequency-qualified PSRR row (DR-006) (#125)
    DR-005 ratified the PSRR row as drafted (DC-only) but flagged the
    gf180-bandgap port-parity gap as an open follow-up rather than silently
    amending it. DR-006 closes that gap: README's PSRR row becomes
    "> 60 dB DC-1 kHz" (target, a band claim) / "> 30 dB @ 1 MHz" (stretch,
    out of scope for wave 1 per DR-001, same as every other row's stretch
    column).
    sim/psrr-dc/experiment.json widens the AC sweep from 0.1 Hz-100 kHz to
    0.1 Hz-1 MHz to reach the new stretch spot, and promotes the 1 kHz
    readout from informational to an enforced >= 60 dB limit (the band's
    floor, given PSRR rolls off monotonically with frequency in e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
2026-08-11 feat(layout): draw MCC as a pfet MOS-cap block -- klt lvs reports mismatch_count: 0 (#128)
    * feat(layout): draw MCC as a pfet MOS-cap block -- klt lvs reports mismatch_count: 0 for the first time on issue #62
    Realizes the error amp's Miller compensation cap (MCC) in the composed
    bandgap-core layout as a pfet_g5v0d10v5 MOS-as-capacitor block (amp_cc),
    matching design/error_amp.sch's own device exactly, per the operator's
    2026-08-11 ruling on issue #62 (MCC must be realized; MIM overlay
    preferred, MOS-cap + Area relaxation as fallback).
    The MIM-cap overlay primary path is ruled out on two independent grounds:
    PR #124 already found it tooling-infeasible today (klayout-tools#775,
    filed); this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
    [gen_bandgap_routed.py]
2026-08-11 lint: add duplicate DR-NNN prefix guard (#126) (#131)
    Adds .loom/scripts/check-dr-duplicate-numbers.sh, wired into the `lint`
    npm script, to fail if two files in spec/decision-records/ share the
    same DR-NNN prefix -- the recurrence-prevention half of #126 (two
    decision records both numbered DR-006, merged concurrently by #124 and
    #125). The rename (DR-006-mcc-area-budget.md -> DR-007) and its inbound
    citation updates were already completed incidentally by #128; this
    change adds only the missing lint guard and re-verifies the fixed tree.
    Verified the guard fails against a synthetic duplicate DR-007 file
    before wiring it in, then confirmed it and `npm run check:ci` both
    pass on the real tree.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
2026-08-11 refactor(sim): dedupe stdev() into sim_common.py (#132)
    Move the byte-identical stdev() helper out of the three run_*.py
    experiment scripts (error-amp-offset-mc, monte-carlo-untrimmed,
    pnp-mismatch) and into sim/bin/sim_common.py next to the existing
    mean() helper, following the same pattern issue #119 / PR #121 used
    for load_corner_run() / chain_lines().
2026-08-11 layout: make the MCC MiM-overlay feasibility check a re-runnable measurement (#129)
    `layout/matching-plan.md` Section 7bb answered the operator's 2026-08-11
    ruling on #62 -- can MCC be realized as a `cap_mim` overlay instead of drawn
    in-plane? -- from a hand-built three-geometry `klt draw` reproduction. That
    tooling evidence is the stronger of the two and is not duplicated here. What
    this adds is the same question as a committed script plus an append-only
    evidence directory, following `measure_fixed_offset_variants.py`'s precedent:
    the number is produced by running, not by asserting, and the next `klt` pin
    bump can re-measure in one command.
    `layout/bin/measure_mim_overlay_feasibility.py` m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
2026-08-11 feat(sim): post-layout extracted re-run of output-voltage-tc, full corner matrix (issue #16) (#134)
    Extract parasitics from the routed, LVS-clean bandgap-core layout (issue #62,
    mismatch_count: 0) via `klt extract --parasitics`, translate its generic
    LVS device-class placeholders into simulatable sky130 vendor models
    (sim/bin/post_layout_common.py), and wrap the result as a drop-in
    replacement for design/bandgap_core.sym -- then re-run output-voltage-tc's
    existing testbench against it across the full 15-point PVT subset. First of
    issue #16's owed re-runs; documents a real, measured ~7.9 mV operating-point
    shift from schematic-level evidence as a finding to investigate, per
    CLAUDE.md's append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
2026-08-12 refactor(sim): dedupe run_ngspice()/parse_measurements() into sim_common.py (issue #135) (#136)
    Both helpers were copy-pasted byte-identically across three sim/*/run_*.py
    experiment scripts (res-array-resize, trim-lsb-chained,
    res-array-head-resistance). Move them into sim/bin/sim_common.py alongside
    the existing load_corner_run()/chain_lines() dedup (#119) and stdev() (#130),
    deriving SIM_DIR/SPICEINIT_FILE from sim_common's own BIN_DIR rather than a
    passed-in constant. parse_measurements() lazily loads+caches corner-run.py
    itself (for MEAS_RE) instead of relying on each caller's own module-level
    `cr`.
    Each of the three call sites now imports run_ngspice/parse_measurements from
    sim_common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
2026-08-12 feat(sim): post-layout extracted re-run of quiescent-current, full 45-point matrix (#137)
    Second increment of issue #16's post-layout suite. Re-runs
    sim/quiescent-current's Iq claim against the routed, LVS-clean
    layout/bandgap-core/ GDS (klt extract --parasitics, device classes
    translated to sky130 vendor models) instead of design/bandgap_core.sch,
    over the full 45-point PVT matrix with no collapsed axis. 45/45 PASS,
    Iq 14.90-26.61 uA against the ratified < 50 uA target; both
    degenerate-state guards (vref band, vgdrv ceiling) pass everywhere.
    Distills the per-bench runner into
    post_layout_common.run_post_layout_experiment() so a new post-layout
    bench is a ~40-line declaration instead of a c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
2026-08-12 feat(sim): post-layout extracted re-run of psrr-dc, full 45-point matrix (issue #16) (#139)
    Third increment of issue #16's post-layout suite, after
    output-voltage-tc-post-layout (#134) and quiescent-current-post-layout (#137).
    Re-runs sim/psrr-dc's PSRR claim against the routed, LVS-clean
    over the full 45-point PVT matrix with no collapsed axis (the AC sweep
    lives entirely inside the deck).
    Result: overall FAIL. psrr_dc (0.1 Hz edge) passes at all 45 corners
    (78.7-136.5 dB vs >=60 dB), but psrr_1k/psrr_band_min (the DC-1 kHz band
    floor, issue #127) drops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
2026-08-12 refactor(sim): dedupe write_log() and trim-range-monotonicity's parse_measurements() straggler into sim_common.py (#141)
    * refactor(sim): dedupe write_log() and the trim-range-monotonicity parse_measurements() straggler into sim_common.py
    Consolidates the byte-identical-except-return-value write_log() copies in
    res-array-resize, trim-lsb-chained, and res-array-head-resistance into a
    single sim_common.write_log() (returning Path, a strict superset of the
    None-returning callers). Also migrates trim-range-monotonicity's local
    parse_measurements()/MEAS_RE (missed by #136's scope) to import
    sim_common.parse_measurements(), dropping the now-unused `import re`.
    Verified no behavior change: re-ran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
2026-08-12 feat(sim): post-layout extracted re-run of line-regulation, 15-point subset (#142)
    * feat(sim): post-layout extracted re-run of line-regulation, 15-point subset (issue #16)
    Fourth increment of issue #16: re-runs line-regulation against the routed,
    LVS-clean bandgap-core layout via the shared post-layout harness, reusing
    the schematic-level bench's own 15-point subset (process x temperature in
    full, supply axis collapsed since the deck sweeps 2.97..3.63 V internally).
    Overall PASS, 15/15, ~755x margin to the 24 mV limit.
    Adds supply_override to sim/bin/post_layout_common.py's
    run_post_layout_experiment(), symmetric to output-voltage-tc-post-layout's
    existing temp_override, since this bench'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
2026-08-12 docs(spec,sim): root-cause the PSRR post-layout band-floor shift, propose DR-008 (issue #140) (#144)
    Investigates issue #140 (psrr_band_min fails DR-006's >=60 dB DC-1kHz floor
    at 34/45 post-layout corners, per sim/psrr-dc-post-layout's FAIL record
    20260812-011520-5df01bf). Runs a direct sensitivity sweep against a real
    corner deck from that record (ngspice-only, no layout regen needed) rather
    than iterating blindly on the layout:
    - Localizes the dominant parasitic resistance to the amplifier's own
    internal nodes (GDRV/PN/TAIL/VA/VB/VBQ/D1/D2's routing), not the VDD/VSS
    supply rails the originating README hypothesized -- a 10x resistance cut
    on the 11 named top-level pins moves psrr_b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
2026-08-12 refactor(sim): dedupe r1_segments_um()/load_base_body()/build_deck() into sim_common.py (issue #143) (#145)
    Extends the existing sim_common.py consolidation (issues #119/#130/#135/#136/
    #138) to the three remaining near/byte-identical helper functions duplicated
    between sim/res-array-resize/run_res_array_resize.py and
    sim/trim-lsb-chained/run_trim_lsb_chained.py: r1_segments_um(n_r1, r_lseg_um),
    load_base_body(base_snapshot, expected_params), and build_deck(slug,
    script_name, pdk, process, supply_v, body). Both call sites now import these
    from sim_common and pass their own per-file constants. Verified deck
    generation is byte-identical to pre-change (dry-run diffs only differ in the
    timestamp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
2026-08-12 feat(sim): post-layout extracted re-run of startup-time, full 45-point matrix (#16) (#147)
    Fifth and last increment of issue #16's "full #11 testbench suite"
    Acceptance Criteria bullet, after output-voltage-tc-post-layout (#134),
    quiescent-current-post-layout (#137), psrr-dc-post-layout (#139) and
    line-regulation-post-layout (#142). Re-runs sim/startup-time's
    supply-ramp startup-time claim against the routed, LVS-clean
    layout/bandgap-core/ GDS (klt extract --parasitics, translated to
    sky130 vendor models via sim/bin/post_layout_common.py) instead of
    design/bandgap_core.sch, over the full 45-point PVT matrix (nothing
    swept inside the deck, so no axis is collapsed).
    Result: overall FAIL, but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
2026-08-12 feat(sim): post-layout re-run of #10's startup/degenerate-state checks, close out #16 (#150)
    Completes the last concrete Acceptance Criteria item issue #16 still owed:
    sim/startup-ramp-post-layout/ and sim/startup-stability-post-layout/, a
    mixed-provenance DUT (extracted, LVS-clean bandgap-core + schematic-netlisted
    startup_injector.sch, since the injector has no layout yet). Fixes a
    strip_schematic_subckts() bug in sim/bin/post_layout_common.py where a lazy
    regex could let stripping error_amp collaterally delete the sandwiched
    startup_injector block.
    Both benches diverge modestly from new same-sizing schematic baselines
    (sim/startup-ramp/records/20260812-073050-7eb5be4,
    sim/startup-stabili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
2026-08-12 refactor(sim): dedupe mv() millivolt formatter into sim_common.py (issue #151) (#156)
    The private mv() helper was byte-identical across three sim run scripts
    (run_mc_untrimmed.py, run_amp_offset_mc.py, run_pnp_mismatch.py). Lift it
    into sim_common.py alongside mean()/stdev() and import it at each call
    site, continuing the incremental sim_common.py consolidation (#121, #132,
    #135, #136, #141, #143, #145).
    Closes #151
2026-08-12 refactor(sim): dedupe parse_samples()/_PRINT_LINE into sim_common.py (issue #153) (#157)
    The _PRINT_LINE regex and parse_samples() Monte Carlo sample-boundary
    parser were byte-identical across pnp-mismatch, error-amp-offset-mc, and
    monte-carlo-untrimmed's run scripts. Lift the already-parameterized
    (log, vectors) signature from pnp-mismatch into sim_common.py, update the
    other two call sites to pass VECTORS explicitly, and drop the now-unused
    `import re` from all three run scripts.
2026-08-12 refactor(sim): dedupe seed_stability() per-vector check into sim_common.py (issue #154) (#159)
    Extract the duplicated seed_sigma_stable[...]/seed_sample_differs[...]
    check pair into sim_common.seed_stability_checks(), called from
    run_amp_offset_mc.py, run_pnp_mismatch.py, and run_mc_untrimmed.py.
    Each caller passes its own SEED_A/SEED_B/SEED_SIGMA_TOL (values differ
    per script); run_mc_untrimmed.py also passes sample_field="max" plus
    its VOUT/V/.6f detail-string formatting to preserve its pre-existing
    (differently-formatted) output byte-for-byte.
    Verified via python3 -m py_compile on all four files, --dry-run smoke
    runs of all three scripts, and a synthetic before/after comparison
    (includin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
2026-08-14 fix(sim): close DR-008's post-layout harness pin-promotion gap, confirm routing-fix path closed on real-pipeline evidence too (issue #140) (#166)
    Re-dispatched per the operator's 2026-08-14 ruling on #140 (root-cause +
    attempt a routing fix + re-run, guardrail: do not touch the ratified spec
    if routing cannot recover the margin).
    - sim/bin/post_layout_common.py: post-layout benches no longer hardcode an
    11-pin `.SUBCKT bandgap_core_routed` port order when wrapping the
    extracted netlist. A wider ROUTE_WIDTH_UM layout's `klt extract
    --parasitics` pass promotes a 12th port (the synthesized `vsubs`
    substrate net), and the old fixed-arity XCORE call silently mis-bound
    against it (ngspi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
2026-08-14 refactor(sim): dedupe run_point()'s ngspice-subprocess body into sim_common.run_ngspice() (issue #167) (#168)
    Three bespoke-script-local run_point() definitions in run_mc_untrimmed.py,
    run_amp_offset_mc.py, and run_trim_sweep.py were byte-for-byte identical to
    sim_common.run_ngspice()'s body (issue #135/#136), differing only in that
    `name` was hardcoded to point.corner_id instead of taken as a parameter.
    Replace each with a call to the shared helper and drop the now-unused
    `import subprocess` in each file, matching the pattern already followed by
    res-array-head-resistance, res-array-resize, and trim-lsb-chained.
2026-08-15 refactor(layout): dedupe klt_gen()/run_klt_json()/union_bbox() into layout_common.py (#171)
    gen_bandgap_floorplan.py and gen_bandgap_routed.py each defined their own
    copy of these three helpers (klt_gen byte-identical, run_klt_json a strict
    generalization in the routed script, union_bbox differing only in whether
    callers pass full block dicts or bare block-id strings). Extracts a shared
    layout/bin/layout_common.py, mirroring sim/bin/sim_common.py's role for the
    sim/ scripts, and updates both callers (place_blocks() stays two intentionally
    divergent implementations, per issue #169's scope note).
    Closes #169
    [gen_bandgap_routed.py, layout_common.py]
2026-08-15 Amplifier PSRR margin increase: absorb the -4.05 dB post-layout cost at schematic level (DR-008 Option B) (#173)
    * feat(design,sim,layout): halve error-amp input pair for PSRR margin, close DR-008 Option B (issue #170)
    Ratifies DR-008 Option B (operator ruling on #140): halves design/error_amp.sch's
    amp_m_in 16 -> 8, which raises the D1/D2 diode-load nodes' non-dominant-pole
    frequency and moves schematic-level psrr_band_min +7.1..+15.6 dB per corner
    (62.65-66.73 dB -> 70.24-81.47 dB, 45/45 PASS). Re-routed/re-extracted layout is
    DRC- and LVS-clean; the post-layout re-run now passes 45/45 at psrr_band_min
    72.31-93.74 dB (was 34/45 FAIL at 58.27-62.55 dB pre-#170), comfortably absorbing
    DR-00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
    [error_amp.sch]
2026-08-15 sim/line-regulation-post-layout: document fs_125c_3.30v DC-sweep solver artifact (issue #172) (#174)
    Reproduces the isolated 2-of-31-point v(vref) spike (indices 27-28,
    vsup=3.564/3.586V) at the fs/125C corner byte-for-byte against the
    post-#170 layout, instruments the root cause (DC-sweep continuation's
    gmin-stepping fallback lands on a spurious near-rail root at exactly
    those two points, while a nodeset-seeded standalone .op at each point
    converges cleanly to the correct, neighbor-consistent value with no
    gmin stepping needed), and shows that sweep-step, itl1/itl2, gmin,
    gminsteps, tolerance and direct-solver tuning all leave the spurious
    value bit-identical. Documents this as acceptance c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
2026-08-16 refactor(layout): remove dead Met1Bus.elbow() in met1_bus.py (issue #183) (#184)
    elbow() had zero production call sites -- gen_bandgap_routed.py draws
    its own N-segment polyline walker directly via vseg()/hseg(). The only
    call sites were 3 same-net two-segment test fixtures in
    test_routed_flow_gates.py exercising conflicts()/components(), now
    inlined as the equivalent hseg()+vseg() pair.
    Closes #183
    [met1_bus.py]
2026-08-16 sim: re-point spec-claim benches from the draft to DR-005's ratified spec (#187)
    * sim: re-point spec-claim benches from the draft to DR-005's ratified spec
    output-voltage-tc, line-regulation, quiescent-current, and startup-time
    experiment.json claim strings and monte-carlo-untrimmed's SPEC_WINDOW_V/CLAIM
    constant cited "Target specification (DRAFT)" and "PROVISIONAL against the
    draft spec until issue #1 ratifies it" -- stale since DR-005 ratified the
    spec on 2026-08-11. Re-point each claim string to cite DR-005, widen
    output-voltage-tc's vref_27/vref_min/vref_max bounds to the ratified
    untrimmed window (1.176-1.224 V), and widen line-regulation's accuracy-window
    bound to the ratified +/-2%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
2026-08-16 refactor(sim): dedupe load_base_body() in run_res_array_head_resistance.py (#188)
    Replaces the local zero-arg load_base_body() (closing over module-level
    BASE_SNAPSHOT/EXPECTED_PARAMS) with the shared sim_common.load_base_body()
    helper that #143/PR #145 already extracted from this exact pattern in
    res-array-resize and trim-lsb-chained. res-array-head-resistance was not
    part of that migration and still carried the pre-dedup copy.
2026-08-16 refactor(sim): dedupe render_record() Record ID/PDK/Tools/Repo-state block into sim_common.py (#192)
    Extracts the byte-identical Record ID + Experiment lines
    (render_record_id_experiment()) and PDK pin-state + Tools + Repo state
    lines (render_pdk_tools_repo_state()) that were copy-pasted across
    corner-run.py and all 7 bespoke run_*.py experiment scripts into
    sim_common.py, split into two helpers rather than one contiguous block
    since each caller's own Claim / Netlist provenance lines render between
    them.
    Closes #191
2026-08-17 design: model the routed chained resistor array in bandgap_core.sch and re-centre n_r2 50 -> 51 (#193)
    * design: model the routed chained resistor array in bandgap_core.sch and re-centre n_r2 50 -> 51
    `design/bandgap_core.sch` modelled each divider leg as ONE `res_high_po`
    device while the routed layout chains 143 separately-contacted unit
    instances, each paying the model card's per-instance head/end term
    (DR-003). The schematic therefore simulated a `K = R2/R1` about 9 % below
    the drawn part's and read `VOUT(27 degC) ~ 1.165 V` -- outside DR-005's
    ratified +/-2 % untrimmed window at every corner, with box TC
    250-268 ppm/degC.
    Close the modelling gap instead of sizing around it. Each leg i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
    [bandgap_core.sch]
2026-08-17 sim: re-run untrimmed-accuracy and offset-budget Monte Carlo against the ratified spec and current design (#196)
    * wip: pre-merge checkpoint before pulling in #195's Point dedupe
    * sim: re-run the untrimmed-accuracy and offset-budget Monte Carlo against the ratified spec and current (post-#170/#178) design
    Both MC benches' only prior evidence predated DR-005's ratified spec
    (2026-08-11), issue #170's error-amp resize (amp_m_in 16->8), and issue
    #178's resistor chain-model resize (n_r2 50->51) -- so neither graded the
    design or the spec this repo now runs against (issue #180).
    sim/monte-carlo-untrimmed/records/20260817-121131-d7d85b6 (supersedes
    20260816-091855-69a8867): N=300 per point, t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
2026-08-19 refactor(sim): dedupe substitute_arrays()/TARGET_LINES/r2_segments_um (#199)
    * refactor(sim): dedupe substitute_arrays()/TARGET_LINES/r2_segments_um into sim_common.py
    Moves the byte-for-byte-identical (module constants aside) TARGET_LINES
    dict, r2_segments_um(), and substitute_arrays() out of
    run_res_array_resize.py and run_trim_lsb_chained.py into sim_common.py,
    which #143 left behind when it consolidated the rest of this same
    array-substitution machinery. r2_segments_um() is generalized to accept
    an optional trim_unit_um (defaulting to res-array-resize's fixed 1 um),
    matching trim-lsb-chained's more general closed form -- verified
    mathematically and numerically equivalent to res-array-re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
2026-08-19 fix(tests): correct PROMPT_DIR/.claude path in 4 test scripts (one '..' short) (#206)
    HELPERS_DIR resolves to .loom/scripts, two levels below the repo root where
    .claude/ actually lives, but four test files only backed up one level. This
    aborted test-app-permission-fallback.sh and test-forge-helpers-rate-limit-fallback.sh
    under set -e before their final tally printed, and silently produced two
    false FAILs in test-merge-pr-head-mismatch.sh.
    Closes #204
2026-08-19 refactor(sim): dedupe common CLI-arg boilerplate into sim_common.add_common_args() (#209)
    Seven sim/*/run_*.py harness scripts hand-rolled an identical parse_args()
    block for --author/--supersedes/--timeout/--allow-pdk-mismatch/--dry-run
    (three also duplicated --samples). Add sim_common.add_common_args() and
    have each script call it after any script-specific flags, preserving each
    script's --timeout/--samples defaults exactly. As a side effect, the two
    scripts (res-array-resize, trim-lsb-chained) whose flags previously had no
    --help text now share the same help strings as the other five.
    Closes #207
2026-08-20 chore(layout): remove 9 orphaned intermediate bandgap-core/reports checkpoints (#211)
    Prunes 9 of the 12 zero-reference intermediate routing checkpoints under
    layout/bandgap-core/reports/ identified in issue #210 (~17MB). Each was a
    superseded intermediate record in issue #62's routing/LVS convergence
    sequence, added no unique evidence beyond what later checkpoints (and the
    current LATEST=20260817-020222-13476b7) already carry, and has zero
    references anywhere in the tracked repo outside reports/ itself
    (re-verified with git grep immediately before removal).
    3 of the original 12 candidates are intentionally excluded from this pass:
    - 20260803-232955-05e1b99 and 20260803-235842-b4bcce9 each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
2026-08-21 Remove superseded floorplan flow (gen_bandgap_floorplan.py) (#217)
    gen_bandgap_floorplan.py (#15) and run-bandgap-floorplan-flow.sh have no
    test coverage, no functional CI coverage, and have been stale since their
    initial commit. gen_bandgap_routed.py (#62) is their actively-maintained
    routed successor and every current layout/sim record is generated from it.
    - Delete layout/bin/gen_bandgap_floorplan.py and
    layout/bin/run-bandgap-floorplan-flow.sh (~700 LOC)
    - Drop the run-bandgap-floorplan-flow.sh bash -n clause from package.json's
    lint script
    - Update layout_common.py's module docstring to credit only
    gen_bandgap_routed.py as a consumer
    layout/bandgap-core/reports/20260803-192947-e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
2026-08-21 docs(layout): fix dead run-bandgap-floorplan-flow.sh reference in README (#218)
    The issue #15 floorplan flow was deleted in #217 (per #215), but
    layout/README.md still had a runnable command block invoking it. Replace
    that block with prose noting the flow's retirement and pointing to the
    routed flow (run-bandgap-routed-flow.sh) that superseded it, while keeping
    the #15 skeleton's historical record reference intact.
    Closes #216
2026-08-22 refactor(layout): split bus/routing helpers out of gen_bandgap_routed.py (#223)
    Extract the intra-block bussing / inter-block routing section
    (~2,130 lines) into a new layout/bin/bus_routing.py module, verbatim
    including provenance comments. gen_bandgap_routed.py drops from 5,580
    to 3,479 lines.
    The split introduces a genuine two-way dependency between the two
    modules (bus_routing.py's own module-level tables need several early
    constants from gen_bandgap_routed.py; gen_bandgap_routed.py calls back
    into build_bus_overlay/trim_tap_port/MOS_HALVES). Resolved with
    one-directional-at-load-time imports: gen_bandgap_routed.py's uses of
    bus_routing symbols are all deferred (function-local) imports,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
    [bus_routing.py, gen_bandgap_routed.py]
2026-08-22 docs(layout): shrink gen_bandgap_routed.py's 320-line changelog docstring (#225)
    Replace the 21-item, issue/PR-referencing changelog docstring (lines 2-321)
    with a ~30-line current-state summary of what the flow does and how it's
    invoked, pointing to layout/matching-plan.md as the single source of truth
    for design history instead of duplicating it. Leaves the *_NOTE constants
    and matching-plan.md untouched.
    [gen_bandgap_routed.py]
2026-08-22 refactor(sim): dedupe MC control_block() dowhile-loop skeleton into sim_common.py (#226)
    Extract the byte-identical Monte Carlo `.control` dowhile-loop skeleton
    (setseed/set width/set height/let nruns/dowhile .. print/let run = run +
    1/end/quit/.endc/.end) shared between error-amp-offset-mc/run_amp_offset_mc.py
    and monte-carlo-untrimmed/run_mc_untrimmed.py's local control_block()
    functions into a new sim_common.mc_control_block(point, loop_body, prints)
    helper, parameterized by each caller's own reset-to-measurement loop-body
    lines. Continues the incremental sim_common.py consolidation pattern from
    #152/#219.
2026-08-22 refactor(layout): extract record.md renderer out of gen_bandgap_routed.py (#228)
    Splits gen_bandgap_routed.py's ~840-line Step 10 ("Record") -- the
    scoreboard-value computation and ~150 lines.append() calls that build
    record.md -- into a new render_record() function in a sibling module,
    layout/bin/routed_record.py, following the bus_routing.py precedent
    (#223). main() shrinks from ~1165 to ~340 lines and now just calls
    render_record() with the already-computed flow values and reads the
    returned RecordResult's booleans for its own flow_gate() call.
    Verified as a pure extraction: running the actual routed layout flow
    (klt gen/compose/drc/extract/lvs against sky130A) on main and on this
    branch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
2026-08-22 chore(layout): remove four unused dead constants (#230)
    PNP_MARKER_LAYER/NWELL_TAP_LAYER/PNP_MARKER_MARGIN_UM/NWELL_TAP_MARGIN_UM
    in gen_bandgap_routed.py were orphaned by #65's removal of the PNP overlay
    function that used them; M_AMPBIAS was never referenced (M_OUT is used
    instead where it would logically apply); MET2_LABEL_LAYER in met1_bus.py
    is dead since Met1Bus.label() only ever emits MET1_LABEL_LAYER labels --
    met2-routed nets rely on the met1 label plus met1-met2 via, and LVS
    passes today without a met2 pin label.
    Verified each name has zero references anywhere in the repo beyond its
    own definition line, both before and after removal.
    Closes #229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
2026-08-22 docs(layout): shrink requirements.txt's klt pin changelog comment (#232)
    Replace the 9-bump, 371-line accumulated changelog above the klt pin
    with a short current-state comment plus the current bump's own
    justification, pointing to layout/matching-plan.md Section 7 (7a-7dd)
    as the single source of truth for the full history -- same pattern
    PR #225 applied to gen_bandgap_routed.py's docstring.
2026-08-22 refactor(layout): consolidate met1/met2 proximity-index logic into _PlaneIndex (#235)
    met1_bus.py's Met1Bus class carried two hand-synced copies of the same
    grid-bucketed proximity-index pattern (_index_met1/met1_near/truncate_met1
    and _index_met2/met2_near/truncate_met2), one per routing plane, differing
    only in which grid dict and which rects list they closed over. Extracts the
    shared behavior into a private _PlaneIndex (grid + a reference to the
    plane's own rects list), constructed once per plane in Met1Bus.__init__.
    met1_near/met2_near/truncate_met1/truncate_met2 are now thin call-throughs,
    so the public API (return shapes, docstrings, callers in bus_routing.py,
    met2_drc.py, gen_bandgap_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
2026-08-22 chore: resync .github/CONFIGURATION.md from upstream Loom defaults
    Applied to the working tree by `resync-installed.sh` and then left
    uncommitted. `.github/` is on the Loom-shipped allowlist and is walked by the
    resync, so it updates with the rest — but the resync's own commit step stages
    `.loom/` only, so this file stays dirty in every repo the resync touches.
    That is not cosmetic. `fleet-resync.sh` refuses to run against a repo with
    uncommitted work under `.loom/`, `.claude/`, or `.gitignore`, and a repo left
    dirty this way can trip that guard on a later run and stop receiving upstream
    fixes entirely while still reporting as a healthy fleet member. The identical
    diff was found pending i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
2026-08-23 fix: verdict-staleness-guard.sh no longer requests unsupported gh JSON field "merged" (#237)
    The installed gh CLI (2.97.0/2.98.0) rejects `gh pr view --json ...,merged`
    as an unknown field, which errored out the entire stale-verdict sweep before
    any staleness logic ran. Re-derive PR_MERGED from `state` (which already
    reports "MERGED" for a merged PR), keeping a defensive `.merged` OR-term for
    a hypothetical forge shim that reports merged before state flips. Pin the
    fix in .loom/resync-ignore (precedent: #205) so the next Loom resync does
    not revert it, as has already happened repeatedly on this file.
    Closes #236
2026-08-24 ratification: install the two-key reviewer variant (EE key + market key) (#212)
    Phase C2 of 2AMLogic/2am#372. Both keys are generated public variants —
    ee-key/ and market-key/ each produced by its owning repo's
    generate-canary-variant.py (lint clean; MANIFEST.md records the source
    commit) — scoped to this repo's block class (bandgap). Identifier-scanned
    against the operator-populated pattern file before push (2am#386 / #391).
2026-08-27 ratification: fix inaccurate market-key MANIFEST.md comp-data list (#241)
    The section listed all 4 original COMP_CLASSES entries
    (ldo, pll, sar-adc, bandgap) instead of the single comp file this repo
    actually carries in ratification/market-key/comps/ — the installer
    committed generate-canary-variant.py's raw output instead of hand-scoping
    it per canary-variant.md's install procedure.
    Not a disclosure leak (every listed filename names another public
    canary's own block class); a documentation-accuracy fix only.
    Part of 2AMLogic/2am#589
2026-09-01 Shrink sim_common.py's module docstring to a current-state summary (#244)
    The 107-line changelog-style docstring enumerated one entry per helper
    citing 12 issue numbers, all of which is already recorded (accurately,
    and kept up to date) in each function's/class's own docstring. Replace
    it with a ~20-line summary covering what the module is for, the two
    import-mechanics quirks (corner-run.py's dash-name importlib shim vs.
    this file's normal import), and a pointer to `git log -p` for history.
    No behavior change; function/class docstrings are untouched.
    Closes #243
2026-09-05 feat(champion): standing authorization for design-evidence auto-merge (#6850)
    Operator ruling 2026-09-05: Judge-approved, green-CI PRs whose entire
    changed-file set lives in design/, sim/, layout/, measurements/,
    verification/, or docs/ auto-merge without the four-axis human hold.
    Rationale: canary design evidence is fully revertible with no fleet-infra
    blast radius, and the held-PR pattern (sky130-sar-adc#123 sat mergeable for
    days as the sole blocker of a layout chain) costs more than it protects
    here. spec/ and every tool surface fall outside the patterns, so the
    exact-subset rule keeps them on the four-axis judgment automatically.
    C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
2026-09-06 Fix stale gen_bandgap_floorplan.py references left by #217's deletion (#250)
    Two comment/docstring blocks in gen_bandgap_routed.py and
    run-bandgap-routed-flow.sh still described the floorplan flow as a
    present, unmodified sibling script; it was deleted in #217 (#215).
    Rewrite both in past tense, mirroring layout_common.py's phrasing.
    [gen_bandgap_routed.py]
2026-09-07 Remove unused git import in gen_bandgap_routed.py (#256)
    layout_common.git was imported but never called in this file — the
    one caller of git(...), routed_record.py, already imports it directly
    from layout_common. Fixes the sole F401 finding from
    `ruff check layout sim --select F401,F811,F841`.
    Closes #255
    [gen_bandgap_routed.py]
2026-09-07 Dedupe klt --version subprocess call into layout_common.klt_version() (#258)
    render-record.py and routed_record.py each ran an identical klt --version
    subprocess call; extract it into layout_common.klt_version(), following
    the same pattern issue #253 used for git(). Pure code motion, no
    behavior change.
    [layout_common.py, render-record.py, routed_record.py]
2026-09-07 Dedupe git rev-parse HEAD subprocess call in measure_fixed_offset_variants.py (#260)
    Replaces the inline `git -C <repo_root> rev-parse HEAD` subprocess.run
    call with the shared layout_common.git() helper (added in #253/PR #254,
    most recently reused by #257/PR #258), following the same sys.path
    import pattern used by render-record.py and routed_record.py. This was
    the last un-migrated caller of the inline git subprocess pattern in
    layout/bin/*.py.
    Closes #259
    [measure_fixed_offset_variants.py]
2026-09-07 fix: make load_corner_run() idempotent to fix HarnessError class-identity bug (#268)
    load_corner_run() re-executed sim/bin/corner-run.py via importlib on every
    call, producing a fresh HarnessError class each time. Since Python `except`
    matches by class identity, every bespoke sim/*/run_*.py script's own
    `except cr.HarnessError` (from its module-scope `cr = load_corner_run()`)
    did not catch a HarnessError raised from inside a sim_common helper reached
    via `_cr()`'s independently-cached module instance (e.g. from
    setup_record_paths, load_base_body, r2_segments_um, substitute_arrays,
    check_pdk_and_ngspice, parse_measurements). Guard-raised errors crashed with
    an unhandled traceback instead of t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
2026-09-08 refactor: dedupe klt --format json calls in measure_mim_overlay_feasibility.py (#271)
    Route probe_connectivity()'s klt extract call and probe_drc_coverage()'s
    klt drc call through the existing layout_common.run_klt_json() helper
    instead of hand-rolled subprocess.run()+json.loads() blocks. The DRC probe
    now passes allow_exit=(0, 3), fixing a latent bug where a real DRC
    violation (exit 3) would crash with CalledProcessError instead of
    returning the violation-count payload the function's return type promises.
    Closes #269
    [measure_mim_overlay_feasibility.py]
2026-09-08 refactor: dedupe klt draw subprocess call in met1_bus.py into layout_common.run_klt_json() (#276)
    Met1Bus.emit() hand-rolled the same subprocess.run + json.loads + nonzero-exit
    RuntimeError pattern that layout_common.run_klt_json() already exists to hold
    (issue #169). Drops the now-single-use import subprocess.
    Closes #275
    [met1_bus.py]
2026-09-08 refactor(sim): dedupe record-assembly/write block into sim_common.py (#278)
    corner-run.py::main() and post_layout_common.py::run_post_layout_experiment()
    each inlined an identical ~80-line block: run every corner, compute spread
    checks, write the netlist snapshot, assemble the record dict, write
    json/md, and print the closing summary. Extract it into a new
    sim_common.run_matrix_and_write_record(), taking the caller-specific
    experiment/links/record_extra fields as parameters and returning
    (record, overall) so each caller keeps its own exit-code mapping.
    Verified byte-identical record.json/record.md output (modulo
    record_id/timestamp/git/elapsed_s, which are inherently run-specific) for
    a rea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
2026-09-10 sim: re-run PSRR/Iq/startup benches against post-#193 design and regenerate characterization report (#280)
    Re-runs the five ratified-spec rows (PSRR, Iq, startup self-starting,
    startup time, startup stability) across all ten schematic and post-layout
    benches PR #193 left graded against a superseded design/layout, appends
    full-matrix records per sim/README.md's convention, and regenerates
    design/block-characterization-report.md so every row cites the newest
    evidence on disk.
    Notable findings from the re-run:
    - Output accuracy (schematic) flips PASS 45/45 -- the pre-#193 evidence
    showed vref failing the +/-2% window at every corner; post-#193 it
    passes, leaving only the box-method TC term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
2026-09-14 spec: propose DR-009 — TC floor disposition (recommend disclosed-FAIL, not spec relaxation) (#197)
    * spec: propose DR-009 — TC floor disposition, recommend disclosed-FAIL over spec relaxation
    Issue #179 asked how the block should respond to the box-method temp-coefficient
    floor (142.4-159.0 ppm/degC schematic, 167.9-186.9 ppm/degC extracted, post-#178's
    n_r2=51 resize) staying ~2.8-3.7x above DR-005's ratified `< 50 ppm/degC` row with
    the R2/R1 ratio lever now exhausted. Per 2AMLogic/2am#357, canary spec/DR
    ratification now happens via PR review, so this drafts DR-009 (status: proposed,
    not ratified by this Builder) recommending Option 3 — keep the ratified row as-is,
    disclose item 5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
2026-09-22 signoff: commit a klt signoff block manifest for this block's T1 state (#289)
    Replaces the stale, pre-item-11 hand-read (issue #175) with a mechanically
    graded verdict of record: signoff/block-manifest.json (kind: analog) cites
    real, content_hash-pinned evidence for items 3 (DRC clean) and 8
    (characterization report, generic envelope) and honestly leaves the
    remaining nine items `unmet` with a reason -- including item 11, whose
    own evidence is tracked separately in #281. CI (signoff job) re-grades the
    manifest against the pinned klayout-tools==0.6.0 registry wheel on every
    push/PR and requires byte-identical output to the committed
    signoff-report.json, so a cited artifact that drifts fails l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
2026-09-23 layout: klt erc supply spec + report for T1 item 11 (power delivery, structural) (#290)
    * layout: add the klt erc supply spec + report for T1 item 11 (#281)
    T1 item 11 (power delivery, structural) was added to the checklist upstream
    on 2026-09-17. This repo had no `klt erc` spec and no ERC report, so the item
    was unmet and every prior "gap to T1" figure here was taken against a
    ten-item checklist that no longer exists.
    Adds:
    - `layout/bandgap-core/erc-supply-spec.json` — the item-11 spec, with an
    inline comment block justifying every `stackup` entry, the `active_layer`,
    the single `label_layer`, every `vias[]` bridge, and the absent `ties[]`.
    Each layer/datatype pair was resolved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
    [erc_signoff_citation.py, erc_supply_record.py]
2026-09-23 chore: add reuse.lock.json in_tree entry for error_amp (2am rule 9) (#294)
    Record the in-tree error amplifier (design/error_amp.sch) against the
    same-PDK sibling canary 2AMLogic/sky130-opamp as an undecided reuse
    ledger entry (status: evaluate), per 2am cross-cutting rule 9
    (2am/REUSE.md, "Adopt or record").
    Bookkeeping only — no design files are touched. The adopt-or-keep
    decision (steps 2-4 of the rule-9 evaluation) is deferred until
    2AMLogic/sky130-opamp reaches simulation-validated status; its
    signoff record currently shows 0/11 T1 items met, so there is nothing
    to compare requirement rows against yet.
    Validated with 2am/scripts/reuse-check.py: exit 0, single advisory
    line "note: in_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
2026-09-23 signoff: re-hash the artifact behind every manifest pin in CI (#292) (#296)
    `klt signoff --manifest` never opens the artifact a citation's
    `content_hash` describes -- it compares the manifest pin against the hash
    the cited envelope itself recorded and stops there. The committed report
    says so: `citation.input_verified` is null on every row, including both
    `met` ones. So `scripts/ci/check_signoff_freshness.py`'s byte-compare of a
    fresh re-grade cannot detect a change to the graded artifact: rewrite
    `bandgap_core_routed.gds` or edit `design/block-characterization-report.md`
    and the render is identical. That leaves #282's acceptance criterion
    ("CI fails when a manifest cites an artifact that ha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
2026-09-23 Row 1b post-layout FAIL: klayout-tools#800 was closed not-planned (not fixed) — real, still-open cause is klayout-tools#2359 (#297)
    * fix(post-layout): correct row 1b's "fixed-upstream artifact" claim — klayout-tools#800 was closed not-planned, real cause is open klayout-tools#2359
    Issue #283 asked to bump klt past klayout-tools#800's claimed fix and
    re-grade row 1b (post-layout output accuracy). Investigation found the
    premise was wrong: #800 was closed **not planned** (2026-08-12), not
    fixed — the tool maintainer's own closing comment shows the described
    body-double-count mechanism does not exist in the installed source
    (`_resolve_resistors` already excludes recognised resistor bodi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
2026-09-23 fix(evidence): repo-relative klt yield paths; measure the klt lvs combine flake (#298)
    * fix(evidence): record klt yield sample paths repo-relative; measure the klt lvs combine flake
    The T1 signoff manifest could not honestly cite items 4 or 6 (#288). Both
    blockers are now resolved or dispositioned with re-runnable measurements.
    Item 6 -- leaked absolute path. `klt yield` echoes the sample-set path it
    was invoked with straight into its report's own `samples` field, and
    `emit_klt_yield.py` invoked it with an absolute one, so committed evidence
    carried a machine-local path `klt signoff` cannot resolve anywhere else.
    The harness now runs `klt yield` from the repo root with a repo-relative
    pat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
    [measure_combine_devices_determinism.py]
2026-09-23 layout: draw the startup injector into the composed cell; re-run the post-layout suite against it (#301)
    * layout: draw design/startup_injector.sch into the composed bandgap-core cell
    The injector was schematic-only, so the routed cell shipped without it and
    every post-layout bench measured a circuit the schematic-level rows do not
    describe (row 8a PASS vs row 8e FAIL by construction, #285).
    - gen_bandgap_routed.py: five new blocks on row 3 (su_ref diff_pair for the
    MPC1/MPC2 diode reference, su_sense/su_inj/su_clamp single-unit mos_array,
    pnp_su bjt_array for QS) plus the NG/NE inter-block nets; row 3 is reused
    rather than opened so the cell stays inside DR-007's area budget.
    - bus_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
    [bus_routing.py, gen_bandgap_routed.py]
2026-09-23 fix(signoff): re-pin T1 items 3/11 to injector-inclusive layout; fix report doc artifacts (#304)
    Re-run layout/bin/run-erc-supply-flow.sh against the injector-inclusive
    routed GDS (20260923-070209-dbd57a9), and re-pin T1 items 3 (DRC) and 11
    (power delivery) in signoff/block-manifest.json + signoff/pinned-inputs.json
    to that record together, so the manifest no longer cites DRC on one cell and
    ERC/LVS on another. Also drops the now-stale §4 disclosure bullet in
    design/block-characterization-report.md, removes a ~700-word duplicated
    paragraph in that report's row-7 table cell (a copy-paste artifact from
    PR #301), and fixes sim/README.md's unbalanced bold markup and unattributed
    FAIL count in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
2026-09-23 sim(startup-ramp): gate vref convergence directly and disposition the vref_spread FAILs under DR-010 (#305)
    * sim(startup-ramp): gate vref convergence directly; correct the vref_spread diagnosis
    `startup-ramp`'s standing `vref_spread` FAILs (13/45 schematic, 16/45
    post-layout) were attributed by the bench's own note to "an underdamped
    settling tail" on the slow-ramp copy. Cross-reading `sim/startup-stability/`'s
    free-running DC solve (`vref_dut`) against the ramp record corner by corner
    shows otherwise: at all 13 failing corners the DC equilibrium lies strictly
    inside the interval the three startup-condition copies span -- the slow-ramp
    copy above it at 13/13, the fast-ramp copy below it at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
2026-09-23 sim(psrr): prove the injector's PSRR collapse is a design property, not extraction (#307)
    Adds sim/psrr-dc-with-injector/, a schematic-level PSRR bench that attaches
    design/startup_injector.sym to design/bandgap_core.sym on the same
    GDRV/VREF/VDD/VSS nets, and records its first full 45-corner run.
    Since #285 drew the injector into the composed cell, row 4b
    (sim/psrr-dc-post-layout) has failed DR-006's 60 dB DC-1 kHz band-min floor at
    25 of 45 corners (worst 22.75 dB at ff/125 C/3.63 V). That record changed two
    things at once -- the injector was added AND extracted -- so it could not say
    whether the cause is the design or klt extract --parasitics' short/wide-stub
    resistance overstatement (kl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
    [tb_vref_psrr_injector.sch]
2026-09-24 sim: add -j/--jobs concurrent-corner mode to corner-run.py (#310)
    Adds a -j/--jobs N flag (default 1, serial) to corner-run.py and
    post_layout_common.py's parse_post_layout_args(), and parallelizes
    run_matrix_and_write_record()'s per-corner loop via ThreadPoolExecutor
    when jobs > 1. Corner results are written into a pre-sized, index-
    keyed results list rather than list.append() inside the worker, so
    the record's corner order is always matrix order regardless of
    completion order or jobs count. Each corner is an independent
    ngspice subprocess with its own scratch deck and its own
    --timeout, unaffected by concurrency. The written record now
    records the concurrency used in a jobs field alongside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
2026-09-24 Rows 8b/8d: give the post-layout startup benches their own DUT shape, re-run, and re-grade (#311)
    * sim(startup): give the two post-layout startup benches their own DUT shape (#299)
    Issue #285 drew design/startup_injector.sch into the composed bandgap-core
    layout cell, which falsified the mixed-provenance construction
    sim/startup-stability-post-layout/ and sim/startup-ramp-post-layout/ were
    built on: they wrapped their schematic-level sibling's testbench (extracted
    core swapped in for every design/bandgap_core.sym instance, the testbench's
    own design/startup_injector.sym instances left netlisted at schematic level)
    and reused its experiment.json unchanged. Against an injector-inclusive
    extr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
    [tb_startup_ramp_pl.sch, tb_startup_stability_pl.sch]
2026-10-01 chore: resync installed Loom surfaces
    resynced_by: fleet-resync
    invocation: fleet-resync.sh --fleet-only --push
    <!-- loom:provenance v1 build=unknown 19f4e67fd0a0afbd3d8b6606ca91ceac911377a3 clean prompts=none sweep=none story=none trace=78a5dfbdfd8c530aecd1bb436fd096df host=loom-worker-2 base=39d9abd668d60e85526c56d84893e5abda529196 run=loom-run/v1:timer:loom-worker-2/fleet-resync:67c759f7ef3c43e38d3fa8d5f19a2dd1 installs=0.19.593 658650a4f0eff932ac66a8f690eaedf8123fc83b -->
    Loom-Story: none
    Loom-Trace-Id: 78a5dfbdfd8c530aecd1bb436fd096df
    Loom-Build: unknown 19f4e67fd0a0afbd3d8b6606ca91ceac911377a3 clean
2026-10-01 chore: resync installed Loom surfaces
    <!-- loom:provenance v1 build=unknown 56435bf476452911283e43940ecfd9a30f804af9 clean prompts=none sweep=none story=none trace=342405c5ebc99bdbf17afbd983c0c41c host=loom-worker-2 base=a477f93a0b4a148894685495ed90066275c34db1 run=loom-run/v1:timer:loom-worker-2/fleet-resync:20c09f231d424cd5b57ca7991848dd8a installs=0.19.603 8c39bf7cde8a8c03d1aaee441f397c017b6a3a9e -->
    Loom-Trace-Id: 342405c5ebc99bdbf17afbd983c0c41c
    Loom-Build: unknown 56435bf476452911283e43940ecfd9a30f804af9 clean
    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
2026-10-01 chore: resync installed Loom surfaces
    <!-- loom:provenance v1 build=unknown f2868e6b4d60d11a8ab47d25cad9e248229d2f66 clean prompts=none sweep=none story=none trace=4e2766ed5160781df891476246a9be2e host=robb-studio base=45743afa136bbd6e6f772c64cb46fbb9e7d243f7 run=loom-run/v1:timer:robb-studio/fleet-resync:2d3851d5-1673-43ae-bcc6-e5c971b37f33 installs=0.19.603 74778a6aeea5d9e06b489400942b35f33c8bb766 -->
    Loom-Trace-Id: 4e2766ed5160781df891476246a9be2e
    Loom-Build: unknown f2868e6b4d60d11a8ab47d25cad9e248229d2f66 clean
    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
2026-10-01 chore: resync installed Loom surfaces
    <!-- loom:provenance v1 build=unknown d6714830391f7596338b8de40ee2d0f45dcd12f5 clean prompts=none sweep=none story=none trace=af273f717e759e690d07f372734e9278 host=robb-pro base=9edcccbd80fbb267cc5135e065e84085bc5e8b06 run=loom-run/v1:timer:robb-pro/fleet-resync:92e2f9ba-d083-411b-833b-ae52d169ef04 installs=0.19.605 6eb2b65a4496b7becb84ef1f944493a541fd01cd -->
    Loom-Trace-Id: af273f717e759e690d07f372734e9278
    Loom-Build: unknown d6714830391f7596338b8de40ee2d0f45dcd12f5 clean
    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
2026-10-01 chore: resync installed Loom surfaces
    <!-- loom:provenance v1 build=unknown e956e9fee69e53f08b887ca20e14d9058d6f9aee clean prompts=none sweep=none story=none trace=1077dafeb758858c149dd37f4ece3c77 host=loom-worker-2 base=44cb795fd58c9db837022e749883299e75732487 run=loom-run/v1:timer:loom-worker-2/fleet-resync:e3773167b12d4b3aafa1f76848245174 installs=0.19.609 ff30576dacc8c2734b1c7434bedd29c47122caeb -->
    Loom-Trace-Id: 1077dafeb758858c149dd37f4ece3c77
    Loom-Build: unknown e956e9fee69e53f08b887ca20e14d9058d6f9aee clean
    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
2026-10-01 chore: resync installed Loom surfaces
    <!-- loom:provenance v1 build=unknown 617257919edc1b9b9ee27532c5ec1b8a64523388 clean prompts=none sweep=none story=none trace=dbafe4f8526617aa07c890721298a080 host=robb-studio base=46b3827249438359e1364d3c08e953259457fb34 run=loom-run/v1:timer:robb-studio/fleet-resync:1817df66-02cc-4b27-927d-a38485da550a installs=0.19.610 c94891dd526cf6db5ee02045424c6913be522048 -->
    Loom-Trace-Id: dbafe4f8526617aa07c890721298a080
    Loom-Build: unknown 617257919edc1b9b9ee27532c5ec1b8a64523388 clean
    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
2026-10-01 chore: resync installed Loom surfaces
    <!-- loom:provenance v1 build=unknown a2a39ac2736eb2686e2c65412d939e67c0438a7d clean prompts=none sweep=none story=none trace=fc1a121767151aae5bd7427c683b7db6 host=robb-pro base=a2b38580a2ae45c246582035a0c09cf20c821069 run=loom-run/v1:timer:robb-pro/fleet-resync:708eb7c8-469d-4783-80b7-bafe142df3c4 installs=0.19.612 d25614656adcf70162da95c5e1035e99a0639a1a -->
    Loom-Trace-Id: fc1a121767151aae5bd7427c683b7db6
    Loom-Build: unknown a2a39ac2736eb2686e2c65412d939e67c0438a7d clean
    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
2026-10-01 chore(tooling): update repo-skills to v0.19.5
    Fleet-wide Repo Skills rollout (2026-10-01). compute-drift's axis 6
    reported repo-skills at 11 different versions across the fleet's
    checkouts; this brings sky130-bandgap from v0.10.0 to v0.19.5 (rjwalters/repo
    @ ff282cd), staging only the installer's own surface.
    Loom-Trace-Id: 038dce5d677bceeeca3c111787ac5b68
    Loom-Build: unknown unknown unknown
    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
2026-10-01 chore: resync installed Loom surfaces
    <!-- loom:provenance v1 build=unknown 126c80914e42f913c4fc778d3ddce96daa2c7a77 clean prompts=none sweep=none story=none trace=15a20fbea7a00d0922b943088c80e19d host=loom-worker-1 base=69758d5afbe773d70bb9833cd8cc9024994cff60 run=loom-run/v1:script:loom-worker-1/fleet-resync:ecc423da-4625-49de-b25a-692fd669a029 installs=0.19.612 d47e0c57a6bea6f7b61ef9ce62632d70c39ef5d5 -->
    Loom-Trace-Id: 15a20fbea7a00d0922b943088c80e19d
    Loom-Build: unknown 126c80914e42f913c4fc778d3ddce96daa2c7a77 clean
    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
2026-10-01 chore: resync installed Loom surfaces
    <!-- loom:provenance v1 build=unknown 126c80914e42f913c4fc778d3ddce96daa2c7a77 clean prompts=none sweep=none story=none trace=a0a42bd10fcfa6d7cbcc9c021c406848 host=loom-worker-2 base=318c409e49bc10f448e344fa66042b2686de08cd run=loom-run/v1:timer:loom-worker-2/fleet-resync:9e174e6bb0fa41d786e4a86e45632b6f installs=0.19.612 6f0871dc66e62b36d8382ced980d2805bfd97e50 -->
    Loom-Trace-Id: a0a42bd10fcfa6d7cbcc9c021c406848
    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
2026-10-01 chore: resync installed Loom surfaces
    <!-- loom:provenance v1 build=unknown 6f3411c8a63e68097dde01bce8a8422230f54218 clean prompts=none sweep=none story=none trace=9aa0a46bb352b9665fdaa5f5b3b85dd7 host=robb-pro base=a6d982ec5a6c7a5b5d6dcdc7475cd6c5b26eab36 run=loom-run/v1:timer:robb-pro/fleet-resync:ca419e1d-6646-4678-ac7a-b263e4b5119e installs=0.19.612 7731400b3e3e1df39074564166edf656feb0999c -->
    Loom-Trace-Id: 9aa0a46bb352b9665fdaa5f5b3b85dd7
    Loom-Build: unknown 6f3411c8a63e68097dde01bce8a8422230f54218 clean
    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
2026-10-01 Dedup csv_list/csv_floats into sim_common.py
    post_layout_common.py carried byte-for-byte private copies
    (_csv_list/_csv_floats) of corner-run.py's csv_list/csv_floats argparse
    type= helpers. Move both into sim_common.py (already imported by both
    callers) and point corner-run.py's and post_layout_common.py's parse_args
    functions at sim_common.csv_list/sim_common.csv_floats instead.
    Pure refactor, no behavior change -- verified via corner-run.py --process
    a,b --dry-run and a post-layout bench's --temp=-40,125 --dry-run, plus a
    new sim/tests/test_csv_args.py unit test covering trim/filter/float-cast
    behavior (no existing test covered either function before this change).
    Closes #313
    Co-Author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
2026-10-02 chore: resync installed Loom surfaces
    <!-- loom:provenance v1 build=unknown 13c0a3ef467a888520a6529ab34486ab8be826be clean prompts=none sweep=none story=none trace=41356080f367e491d5ff03f17bb98c27 host=loom-worker-2 base=29da08e70eb72973525e2868853b98bd1d612791 run=loom-run/v1:timer:loom-worker-2/fleet-resync:44455fbcbab745abb92cea192fafbb1d installs=0.19.614 3c79f7b1d0cc14723e049cff4250ff7330804326 -->
    Loom-Trace-Id: 41356080f367e491d5ff03f17bb98c27
    Loom-Build: unknown 13c0a3ef467a888520a6529ab34486ab8be826be clean
    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
2026-10-02 chore: resync installed Loom surfaces
    <!-- loom:provenance v1 build=unknown 6f3411c8a63e68097dde01bce8a8422230f54218 clean prompts=none sweep=none story=none trace=acb28d0049e0cc75536f96d503f6e814 host=robb-studio base=cb075d98757c559372e349cf2d2f8f0d2e9154d6 run=loom-run/v1:timer:robb-studio/fleet-resync:85d2b1b5-e81d-40c3-ab6a-9a00efbc4ee2 installs=0.19.616 d86523eeadb32b95777f3cd3a76dd2f72f0bf792 -->
    Loom-Trace-Id: acb28d0049e0cc75536f96d503f6e814
    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
2026-10-02 chore: resync installed Loom surfaces
    <!-- loom:provenance v1 build=unknown 2b50bd69eddd038dd738465aa58a9ebca11410ac clean prompts=none sweep=none story=none trace=324e4f607054d0396cfdf8fdc01e93ae host=robb-pro base=48cee5951e2d3ba8667988a1107c9de265d38916 run=loom-run/v1:timer:robb-pro/fleet-resync:a63799f1-2ad7-4946-b81d-2ec231bc2d2f installs=0.19.617 81cb2ad7e091b19d6a2b95d1add6938c2100d46b -->
    Loom-Trace-Id: 324e4f607054d0396cfdf8fdc01e93ae
    Loom-Build: unknown 2b50bd69eddd038dd738465aa58a9ebca11410ac clean
    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
2026-10-02 chore: resync installed Loom surfaces
    <!-- loom:provenance v1 build=unknown 00d92b326aed50280cd90dc116b7caec27668251 clean prompts=none sweep=none story=none trace=9a5d23cc82b6d3a1c83bfee47bd04970 host=loom-worker-2 base=06b56434c340fe2653dd37152ee0d4f5608f9a1c run=loom-run/v1:timer:loom-worker-2/fleet-resync:12136a7a025d49f3a60b5edb04a3ff81 installs=0.19.619 4c0f505e4f0b76f8ccec07bda6d8b839030c077b -->
    Loom-Trace-Id: 9a5d23cc82b6d3a1c83bfee47bd04970
    Loom-Build: unknown 00d92b326aed50280cd90dc116b7caec27668251 clean
    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
2026-10-02 chore: resync installed Loom surfaces
    <!-- loom:provenance v1 build=unknown 456dad6d90259846313dc3bb80bf4e5471ef2d76 clean prompts=none sweep=none story=none trace=bb9688c03fb5211d06f48c8838a5505c host=robb-studio base=a58e07fd581031245f6c32b19c7405243304e7f4 run=loom-run/v1:timer:robb-studio/fleet-resync:e965c017-8ec7-485d-b46e-aeb399b81fb4 installs=0.19.620 0d28ba49f5a88fdb37271de9cb0144eb3442c6e3 -->
    Loom-Trace-Id: bb9688c03fb5211d06f48c8838a5505c
    Loom-Build: unknown 456dad6d90259846313dc3bb80bf4e5471ef2d76 clean
    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
2026-10-02 chore: resync installed Loom surfaces
    <!-- loom:provenance v1 build=unknown 6c6d2b6565dc13eff4c6811b9c670f452106516b clean prompts=none sweep=none story=none trace=539be979ae694d66ede516a7b5d17e41 host=robb-pro base=a1ae50c9c46418dd9f51f530bfb633bf9052992c run=loom-run/v1:timer:robb-pro/fleet-resync:9444d216-de08-442f-8352-ba59f6e81bb3 installs=0.19.621 a90dc1d794eb9ff70aaf939ebf495abe716f3bdd -->
    Loom-Trace-Id: 539be979ae694d66ede516a7b5d17e41
    Loom-Build: unknown 6c6d2b6565dc13eff4c6811b9c670f452106516b clean
    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
2026-10-02 chore: resync installed Loom surfaces
    <!-- loom:provenance v1 build=unknown f6d28134bfe476967e005d97424073085f55e8a3 clean prompts=none sweep=none story=none trace=27eb90670d441065f593e941066ee005 host=loom-worker-2 base=6201f2970dfb1c38fce789b57425eba44f010e16 run=loom-run/v1:timer:loom-worker-2/fleet-resync:04001bba930241cf9e325bf304a9270a installs=0.19.623 ccc19c2bbe2aa65328427730fa53f70eb56128c6 -->
    Loom-Trace-Id: 27eb90670d441065f593e941066ee005
    Loom-Build: unknown f6d28134bfe476967e005d97424073085f55e8a3 clean
    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
2026-10-02 sim(psrr-injector-attribution): identify MPC1/MPC2 as dominant PSRR contributor (#306)
    Adds sim/psrr-injector-attribution/, a bench that measures which device
    inside design/startup_injector.sch dominates the DC-1 kHz PSRR collapse
    sim/psrr-dc-with-injector records (#300), by cutting one GDRV-touching
    device branch at a time from the exact failing netlist. Confirms
    MPC1/MPC2 (the diode-connected PMOS reference stack) as the dominant,
    measured contributor, settling #306's first acceptance criterion.
    Fixes a latent dict-key bug in the script's own record renderer
    (pdk['installed_commit'] vs the schema sim_common.py's shared helper
    expects) that crashed record generation after a full 225-point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
2026-10-02 docs(report): transcribe #306's measured device attribution into rows 4b/4d/4e
    PR #316 landed sim/psrr-injector-attribution/ and settled #306's first
    acceptance criterion by measurement -- MPC1/MPC2 is the dominant contributor
    to the DC-1 kHz PSRR collapse -- but did not carry that result into
    design/block-characterization-report.md. The report therefore still said the
    opposite of what is now on disk: row 4b called the MPC1/MPC2 attribution
    "corroborated but not proven", and §4's open-questions bullet was titled "The
    PSRR violation ... is not localized to a device".
    Transcribes the landed record into the report, append-only:
    - New row 4e for sim/psrr-injector-attribution/, with the five-v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
2026-10-02 chore: resync installed Loom surfaces
    <!-- loom:provenance v1 build=unknown bc461736314499b6c2c4c0ad51fb2294f60336f5 clean prompts=none sweep=none story=none trace=c3ea68717dd3a908dbbd60a35bc8b5d6 host=robb-studio base=be31dfc8158f26a1fbf70d8065bb8965817b54f1 run=loom-run/v1:timer:robb-studio/fleet-resync:8d4c49e2-3258-4080-b0c8-082499053654 installs=0.19.623 a50aaf70069f8897c41a64b7d90783c5ab8294e0 -->
    Loom-Trace-Id: c3ea68717dd3a908dbbd60a35bc8b5d6
    Loom-Build: unknown bc461736314499b6c2c4c0ad51fb2294f60336f5 clean
    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
2026-10-02 chore: resync installed Loom surfaces
    <!-- loom:provenance v1 build=unknown bc461736314499b6c2c4c0ad51fb2294f60336f5 clean prompts=none sweep=none story=none trace=8bee8a664bfc89e0bbfbb3c2de7342ba host=loom-worker-2 base=fe334b1a32b2aa498ff68cae752b8476d1b3271e run=loom-run/v1:timer:loom-worker-2/fleet-resync:de2ceceb48ea4927a1334d08dc0082fe installs=0.19.624 5f49564fa78ae06f8c48d5224dae9ded04200bb7 -->
    Loom-Trace-Id: 8bee8a664bfc89e0bbfbb3c2de7342ba
    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
2026-10-02 sim(psrr-injector-candidates): screen non-resize injector fixes; three-high stack dies on startup margin (#315)
    Adds the ADD-side counterpart of sim/psrr-injector-attribution/: a bench that
    adds candidate devices to the same committed netlist snapshot row 4d's PSRR
    FAIL was measured on, and runs the same 45-corner matrix, so a circuit change
    can be screened before the layout/DRC/LVS/post-layout cycle is paid for.
    First record (20261002-200944-fe334b1, 135 ngspice points):
    base worst 24.78 dB, 21/45 (reproduces row 4d within 0.5 dB)
    ref3 worst 30.35 dB, 27/45 (DR-011's three-high stack, hand-run
    FAIL 18/45 now a committed record)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
2026-10-03 chore: resync installed Loom surfaces
    <!-- loom:provenance v1 build=unknown 752d316233ed1a3da9e4f69ad760eb99bb477747 clean prompts=none sweep=none story=none trace=7851839b67c00a023e97cbdea1f580e1 host=robb-pro base=006d54272f3282236671c922c266fd4b8ca76c27 run=loom-run/v1:timer:robb-pro/fleet-resync:ae492b66-dca0-4da4-acab-8d26778f2d5c installs=0.19.624 121fac45f5006879bf58a18c951b9243d9099a18 -->
    Loom-Trace-Id: 7851839b67c00a023e97cbdea1f580e1
    Loom-Build: unknown 752d316233ed1a3da9e4f69ad760eb99bb477747 clean
    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
2026-10-03 chore: resync installed Loom surfaces
    <!-- loom:provenance v1 build=unknown b34a08286a42f47f917ec46647d4d167c1f5207c clean prompts=none sweep=none story=none trace=a8e453124b899b440f42c9d83837c7b6 host=loom-worker-2 base=faef7bb7648d117aa5ee523347588e71c54d26ff run=loom-run/v1:timer:loom-worker-2/fleet-resync:f02dd5df715347fe90fe14b9353a1b66 installs=0.19.624 121fac45f5006879bf58a18c951b9243d9099a18 -->
    Loom-Trace-Id: a8e453124b899b440f42c9d83837c7b6
    Loom-Build: unknown b34a08286a42f47f917ec46647d4d167c1f5207c clean
    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
2026-10-03 chore: resync installed Loom surfaces
    <!-- loom:provenance v1 build=unknown 3437cece5ab759f772122f8d18a6d2f05d246cde clean prompts=none sweep=none story=none trace=1bd6b75d1c0daff2b433adf5999546a3 host=loom-worker-1 base=f029fa980a325690e156e3cd0c32f1bdcdfca56f run=loom-run/v1:timer:loom-worker-1/fleet-resync:4c0abac1c29646eaa8502afa223bdd2b installs=0.19.624 0162badc662fb30c070e70611aa8ff74a8486d54 -->
    Loom-Trace-Id: 1bd6b75d1c0daff2b433adf5999546a3
    Loom-Build: unknown 3437cece5ab759f772122f8d18a6d2f05d246cde clean
    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
2026-10-03 sim(psrr-injector-candidates): screen m_ref/m_pnp knobs with MNG; DR-013 closes multiplicity levers (#315)
    Loom-Story: 2AMLogic/sky130-bandgap#315
    Loom-Trace-Id: 3358deff2fd323e97088ab0e613ff457
    Loom-Build: 0.19.624 5f49564fa78ae06f8c48d5224dae9ded04200bb7 clean
2026-10-03 chore: resync installed Loom surfaces
    <!-- loom:provenance v1 build=unknown 4a837731e7c550b7c0a339f295dc627ada67dbc0 clean prompts=none sweep=none story=none trace=fe84c9b169d979d00d78d11178a426a1 host=robb-pro base=eb44a6c7b5cc933883351e0a193ed29d8c6d4189 run=loom-run/v1:timer:robb-pro/fleet-resync:a057372b-b02f-45ac-b297-ca847c70b0fc installs=0.19.634 e54b8a76ee0a907fb3c7fec91e10b0d6fccfbcc7 -->
    Loom-Trace-Id: fe84c9b169d979d00d78d11178a426a1
    Loom-Build: unknown 4a837731e7c550b7c0a339f295dc627ada67dbc0 clean
    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
2026-10-03 chore: resync installed Loom surfaces
    <!-- loom:provenance v1 build=unknown 8c947aea0026cdb7cda97ea20eea706c4daaf058 clean prompts=none sweep=none story=none trace=92f6c0e06b16dbd125642521ab3357c8 host=loom-worker-2 base=5b8eb39890f3af174b395329fd12dcf523b4b401 run=loom-run/v1:timer:loom-worker-2/fleet-resync:8b9c88fa9d4c443197e74a90600bb0c7 installs=0.19.636 e41edfbb52c13982f7d8b0577f42957427a6514c -->
    Loom-Trace-Id: 92f6c0e06b16dbd125642521ab3357c8
    Loom-Build: unknown 8c947aea0026cdb7cda97ea20eea706c4daaf058 clean
    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
2026-10-03 chore: resync installed Loom surfaces
    <!-- loom:provenance v1 build=unknown 28040ed11a4369e20f3b7b0154a3fb2a2c35d38c clean prompts=none sweep=none story=none trace=0cd87d01c45d97a2ee57a99363fc0db2 host=robb-studio base=7592ad460ae7ccee83fb8fae8389b7e5c1438d37 run=loom-run/v1:timer:robb-studio/fleet-resync:74b93657-6b04-4ac5-bc77-e0a1682b0595 installs=0.19.636 e41edfbb52c13982f7d8b0577f42957427a6514c -->
    Loom-Trace-Id: 0cd87d01c45d97a2ee57a99363fc0db2
    Loom-Build: unknown 28040ed11a4369e20f3b7b0154a3fb2a2c35d38c clean
    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
2026-10-03 chore: resync installed Loom surfaces
    <!-- loom:provenance v1 build=unknown 388c7fe0cad997f7a887f70c9f2cfe8781a2d512 clean prompts=none sweep=none story=none trace=2046ffd42f138a06b914f34851de3440 host=loom-worker-2 base=8a83966a108430f0eea685de978aad896a8aefeb run=loom-run/v1:timer:loom-worker-2/fleet-resync:17c9456bb1934c70a545b12081496cce installs=0.19.647 d1fe5dead4202be12a964ab891fd5980e7836170 -->
    Loom-Trace-Id: 2046ffd42f138a06b914f34851de3440
    Loom-Build: unknown 388c7fe0cad997f7a887f70c9f2cfe8781a2d512 clean
    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
2026-10-03 chore: resync installed Loom surfaces
    <!-- loom:provenance v1 build=unknown 8078c29e691123d91cd761a786f99cfd25f1809d clean prompts=none sweep=none story=none trace=45869a6374635c036a11a6f379fe31a4 host=robb-pro base=c317cdb845ebfdd75782540d6521e2c34f22fccb run=loom-run/v1:timer:robb-pro/fleet-resync:b0a94991-052d-4e7d-ba2b-78b971096849 installs=0.19.647 709ca4396e074e5a4d1c5e19721f6ddac7154ca2 -->
    Loom-Trace-Id: 45869a6374635c036a11a6f379fe31a4
    Loom-Build: unknown 8078c29e691123d91cd761a786f99cfd25f1809d clean
    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
2026-10-03 chore: resync installed Loom surfaces
    <!-- loom:provenance v1 build=unknown f9cba29b0602624a23daa17ae04d31d82e10fa91 clean prompts=none sweep=none story=none trace=754b3688f97b6c34894d8cfbf272b81a host=loom-worker-1 base=2d102c7507faddd8d2192f3230489131ef61f1a8 run=loom-run/v1:script:loom-worker-1/fleet-resync:11eb117a-9ff3-4411-88d4-fdd7d6748639 installs=0.19.649 6f2f13b1c31ce420e2250ae040d8e1050c0e761b -->
    Loom-Trace-Id: 754b3688f97b6c34894d8cfbf272b81a
    Loom-Build: unknown f9cba29b0602624a23daa17ae04d31d82e10fa91 clean
    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
2026-10-03 chore: resync installed Loom surfaces
    <!-- loom:provenance v1 build=unknown f9cba29b0602624a23daa17ae04d31d82e10fa91 clean prompts=none sweep=none story=none trace=544a028e3829d4020b8aaa144e5fa628 host=robb-studio base=edddfa3769c02a7727be59f830252f6a35e64208 run=loom-run/v1:script:robb-studio/fleet-resync:5b5b8b83-7139-447d-88bd-417dcf375aa6 installs=0.19.649 6f2f13b1c31ce420e2250ae040d8e1050c0e761b -->
    Loom-Trace-Id: 544a028e3829d4020b8aaa144e5fa628
    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
2026-10-03 chore: resync installed Loom surfaces
    <!-- loom:provenance v1 build=unknown f9cba29b0602624a23daa17ae04d31d82e10fa91 clean prompts=none sweep=none story=none trace=1057aaaf811f6dd2d64a3bb6d4b3ac49 host=robb-pro base=d0895b2a87cad4fe13a6bb190d8382188c0a37d6 run=loom-run/v1:timer:robb-pro/fleet-resync:785c1ea0-d7f2-4810-99e9-cd9368aebe0c installs=0.19.649 2118aabb5a925f1ec4669b4d3d31176a46d8f2a6 -->
    Loom-Trace-Id: 1057aaaf811f6dd2d64a3bb6d4b3ac49
    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
2026-10-03 chore: resync installed Loom surfaces
    <!-- loom:provenance v1 build=unknown 72f61d9aa0fe08f1ef59f1a97a314e474455801e clean prompts=none sweep=none story=none trace=577d2185973ec59f059fa15bf5b5e514 host=loom-worker-1 base=34bdb602e3c45240f8c9b2251d35b6239eb4d4d9 run=loom-run/v1:script:loom-worker-1/fleet-resync:5728a930-137f-4d2f-a962-1cdd7a6a1d46 installs=0.19.652 235a64727b907d65529151af0a962b14f16462a0 -->
    Loom-Trace-Id: 577d2185973ec59f059fa15bf5b5e514
    Loom-Build: unknown 72f61d9aa0fe08f1ef59f1a97a314e474455801e clean
    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
2026-10-03 chore: resync installed Loom surfaces
    <!-- loom:provenance v1 build=unknown 72f61d9aa0fe08f1ef59f1a97a314e474455801e clean prompts=none sweep=none story=none trace=845aaa0eb340f80f12095e2e8b421ed1 host=robb-pro base=0f881167ea5b03f9c58e835ba0801257de058f1c run=loom-run/v1:script:robb-pro/fleet-resync:344add4b-df8a-49e8-8563-2765673acc76 installs=0.19.652 235a64727b907d65529151af0a962b14f16462a0 -->
    Loom-Trace-Id: 845aaa0eb340f80f12095e2e8b421ed1
    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
2026-10-03 chore: resync installed Loom surfaces
    <!-- loom:provenance v1 build=unknown 61870b40779d205c1555e801c6e1d95df083cdea clean prompts=none sweep=none story=none trace=cfd2c16d2cd3651ad0d068a28bbf62b8 host=loom-worker-1 base=869c8efab5b088be453f3186f6ae5bc4b9c3695f run=loom-run/v1:timer:loom-worker-1/fleet-resync:fd27683751ca428cb28a8d58a04fc51a installs=0.19.652 235a64727b907d65529151af0a962b14f16462a0 -->
    Loom-Trace-Id: cfd2c16d2cd3651ad0d068a28bbf62b8
    Loom-Build: unknown 61870b40779d205c1555e801c6e1d95df083cdea clean
    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
2026-10-03 chore: resync installed Loom surfaces
    <!-- loom:provenance v1 build=unknown 61870b40779d205c1555e801c6e1d95df083cdea clean prompts=none sweep=none story=none trace=f8c6a615535e3729d749bc44ac28436c host=robb-studio base=ef77768e8a84922db372d75d7a59bb651a123549 run=loom-run/v1:script:robb-studio/fleet-resync:66678e69-bbef-41df-8a24-1d1ac846c831 installs=0.19.652 235a64727b907d65529151af0a962b14f16462a0 -->
    Loom-Trace-Id: f8c6a615535e3729d749bc44ac28436c
    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
2026-10-03 chore: resync installed Loom surfaces
    <!-- loom:provenance v1 build=unknown 21130104346fe9c464ce8a3fdf82c1d3e9667639 clean prompts=none sweep=none story=none trace=36308fff5a3c323c3d1bf6fffb6cd122 host=robb-studio base=9e49c06890e3f4dc40e3b493445644c15d0f6e5e run=loom-run/v1:timer:robb-studio/fleet-resync:89972fbd-0774-4402-bbb7-26c33a851735 installs=0.19.652 fb69233bd8f1dfc2bdee37d8b934f99274dc0193 -->
    Loom-Trace-Id: 36308fff5a3c323c3d1bf6fffb6cd122
    Loom-Build: unknown 21130104346fe9c464ce8a3fdf82c1d3e9667639 clean
    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
2026-10-04 chore: resync installed Loom surfaces
    <!-- loom:provenance v1 build=unknown 61870b40779d205c1555e801c6e1d95df083cdea clean prompts=none sweep=none story=none trace=fb9213e215442932d2af05f3b14977de host=robb-pro base=2fb4970e6f7aefc891ed951e2a606b107174036b run=loom-run/v1:timer:robb-pro/fleet-resync:4c70cd1d-08cd-4add-8e2a-9a75160d163f installs=0.19.655 36c39e3c6f56e1979647ec235b4bd19c77db22f3 -->
    Loom-Trace-Id: fb9213e215442932d2af05f3b14977de
    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
2026-10-04 chore: resync installed Loom surfaces
    <!-- loom:provenance v1 build=unknown 61870b40779d205c1555e801c6e1d95df083cdea clean prompts=none sweep=none story=none trace=baa6c2cfcae1a320917c00ff2eb8b630 host=loom-worker-2 base=7573133e1cf397bf123f6296a717245982e8fc67 run=loom-run/v1:timer:loom-worker-2/fleet-resync:741a7f0f16df4fb1be4e657aeacd1244 installs=0.19.655 fc667a4faae1227f8a6837431f8a0c2d0aeaa7dd -->
    Loom-Trace-Id: baa6c2cfcae1a320917c00ff2eb8b630
    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
2026-10-04 chore: resync installed Loom surfaces
    <!-- loom:provenance v1 build=unknown b922acb2ac655cbccd71daa9e3f05a325a094ca5 clean prompts=none sweep=none story=none trace=833eeb34d4ca65c3f8c6f7824ddca3a3 host=robb-studio base=69b768943b13ea9760c0a762307236e56bcdf41c run=loom-run/v1:timer:robb-studio/fleet-resync:0d44f6dc-6a62-4d43-b49d-7cfdd7dbd823 installs=0.19.663 0a51e373e7fe1be156c5774b2c827d4b745368a3 -->
    Loom-Trace-Id: 833eeb34d4ca65c3f8c6f7824ddca3a3
    Loom-Build: unknown b922acb2ac655cbccd71daa9e3f05a325a094ca5 clean
    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
2026-10-04 chore: resync installed Loom surfaces
    <!-- loom:provenance v1 build=unknown 746ecb5f9d7e64ba1d2526f1e997530ad4f3dd43 clean prompts=none sweep=none story=none trace=f09501431241df2ec5688e334ba43dfe host=loom-worker-2 base=0b0587945ccd9532a1218322ef7b30ffefe90a69 run=loom-run/v1:timer:loom-worker-2/fleet-resync:70797dad61fb4e21806716d54f1ce910 installs=0.19.669 59a1f84e3742827a8033bb153ebbedc1759bee72 -->
    Loom-Trace-Id: f09501431241df2ec5688e334ba43dfe
    Loom-Build: unknown 746ecb5f9d7e64ba1d2526f1e997530ad4f3dd43 clean
    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
2026-10-04 chore: resync installed Loom surfaces
    <!-- loom:provenance v1 build=unknown 8080d0485cc1312129ee642b084944c56d1be074 clean prompts=none sweep=none story=none trace=ed180bcab6828041123ad54d8ddb4037 host=robb-pro base=0230f8583fc944c7acee0a0dc1c6de4eed8e7f24 run=loom-run/v1:timer:robb-pro/fleet-resync:e97b2f08-4ad9-4b66-a166-5b19820e2d1f installs=0.19.669 59a1f84e3742827a8033bb153ebbedc1759bee72 -->
    Loom-Trace-Id: ed180bcab6828041123ad54d8ddb4037
    Loom-Build: unknown 8080d0485cc1312129ee642b084944c56d1be074 clean
    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
2026-10-04 chore: resync installed Loom surfaces
    <!-- loom:provenance v1 build=unknown 83cb6647167ffc000d2c2f479b4e816b68f863f4 clean prompts=none sweep=none story=none trace=ccabffa1e1ba495895b262086030816c host=robb-studio base=873159b40b92cbab8e8c6c63c50bf8d0f8c109cd run=loom-run/v1:timer:robb-studio/fleet-resync:88a78f1f-d978-47b5-99c3-2aabde811d17 installs=0.19.676 cd4f30bd892ea2595d8218b08150633504b0dd14 -->
    Loom-Trace-Id: ccabffa1e1ba495895b262086030816c
    Loom-Build: unknown 83cb6647167ffc000d2c2f479b4e816b68f863f4 clean
    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
2026-10-04 chore: resync installed Loom surfaces
    <!-- loom:provenance v1 build=unknown 32174d0f7e80508fa66c1a11a2c0fb28c515607e clean prompts=none sweep=none story=none trace=436d7c19b10cd5807625a7ce7190a82f host=loom-worker-2 base=31b1ca79b1f05c34172a603f58bb9431903bc3fc run=loom-run/v1:timer:loom-worker-2/fleet-resync:19ae50771cc04d8db7b1403c1e66bbea installs=0.19.682 9eccfa110fa294fa32a62ffe8eff669cfcf1a3a6 -->
    Loom-Trace-Id: 436d7c19b10cd5807625a7ce7190a82f
    Loom-Build: unknown 32174d0f7e80508fa66c1a11a2c0fb28c515607e clean
    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
2026-10-04 chore: resync installed Loom surfaces
    <!-- loom:provenance v1 build=unknown 72290fa960e0773b2c50d74042e24914c7327637 clean prompts=none sweep=none story=none trace=f7b6952a649a174398a48b90b6ab4793 host=robb-pro base=5aaf7e42caacb9d084457a9a638e79c9dddda37a run=loom-run/v1:timer:robb-pro/fleet-resync:72f32482-5cc4-4b38-ab9e-4d2ef0b64e94 installs=0.19.684 bdb8fb331eb51c7def4cdd2c38b611af06f25f6d -->
    Loom-Trace-Id: f7b6952a649a174398a48b90b6ab4793
    Loom-Build: unknown 72290fa960e0773b2c50d74042e24914c7327637 clean
    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
2026-10-04 chore: resync installed Loom surfaces
    <!-- loom:provenance v1 build=unknown 76cda58637be0e74c4cb5b4c8dbc2000e2a9c3d4 clean prompts=none sweep=none story=none trace=614cbada5ce873c2b34a511816309cfc host=robb-studio base=9922bd9dda4be99dcd217cf86d59e43578c16121 run=loom-run/v1:timer:robb-studio/fleet-resync:7e559a3b-ffdd-409b-8dd2-ae906a273b0a installs=0.19.692 d4974b9f5ff7843a3cfc06378ea2a69bc120e0f4 -->
    Loom-Trace-Id: 614cbada5ce873c2b34a511816309cfc
    Loom-Build: unknown 76cda58637be0e74c4cb5b4c8dbc2000e2a9c3d4 clean
    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
2026-10-04 chore: resync installed Loom surfaces
    <!-- loom:provenance v1 build=unknown f84bac5c232c093f83c1adc2533d8c75b021cda2 clean prompts=none sweep=none story=none trace=e687830614e4bd1c551ab6cf6186f8f3 host=loom-worker-2 base=b98e4a47f22a77cb2075e488d6e8c87c52c8af0b run=loom-run/v1:timer:loom-worker-2/fleet-resync:2db2c4373ac24de1b7a364e69eaea1ca installs=0.19.695 b0d5b09f207fda439390ea1dd249ad10e7009dfc -->
    Loom-Trace-Id: e687830614e4bd1c551ab6cf6186f8f3
    Loom-Build: unknown f84bac5c232c093f83c1adc2533d8c75b021cda2 clean
    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
2026-10-04 chore: resync installed Loom surfaces
    <!-- loom:provenance v1 build=unknown ac5c275d1c616a9723e747f5a66de93dc80d3512 clean prompts=none sweep=none story=none trace=c777c3912bd31972e9aa3ccab712ae01 host=loom-worker-1 base=e3c4930ccdadf6cee08683056148ad34a3264493 run=loom-run/v1:script:loom-worker-1/fleet-resync:b51a1b33-4958-4408-be36-166e12e8360b installs=0.19.697 ada83a5c7ff66b56b0060ef0be368c9fe56eb3c6 -->
    Loom-Trace-Id: c777c3912bd31972e9aa3ccab712ae01
    Loom-Build: unknown ac5c275d1c616a9723e747f5a66de93dc80d3512 clean
    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
2026-10-04 chore: resync installed Loom surfaces
    <!-- loom:provenance v1 build=unknown a19f642f5c09599c4c64827d81d228eb031be73e clean prompts=none sweep=none story=none trace=34a80e22764eb5055e37faec0eaf65fb host=robb-pro base=bd7cb9eca68faae3125bd164836e85a59941c3bd run=loom-run/v1:script:robb-pro/fleet-resync:689be620-3ff2-4ff5-a2ce-f6825f6379e2 installs=0.19.697 ada83a5c7ff66b56b0060ef0be368c9fe56eb3c6 -->
    Loom-Trace-Id: 34a80e22764eb5055e37faec0eaf65fb
    Loom-Build: unknown a19f642f5c09599c4c64827d81d228eb031be73e clean
    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
2026-10-04 chore: resync installed Loom surfaces
    <!-- loom:provenance v1 build=unknown 693bdd794cb34afdefd7f0c4596824cd53078a61 clean prompts=none sweep=none story=none trace=7e7be58c80b40f1ac882b00139fb0ca0 host=robb-pro base=e9679ba472d7df76e66d03f9a8a9eddcfd94446e run=loom-run/v1:timer:robb-pro/fleet-resync:d64fbd6b-5d9b-491d-9e17-742b375bfba7 installs=0.19.698 aa619a1d07e36e8d90ac01fea63dc39285c93567 -->
    Loom-Trace-Id: 7e7be58c80b40f1ac882b00139fb0ca0
    Loom-Build: unknown 693bdd794cb34afdefd7f0c4596824cd53078a61 clean
    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
2026-10-04 chore: resync installed Loom surfaces
    <!-- loom:provenance v1 build=unknown 693bdd794cb34afdefd7f0c4596824cd53078a61 clean prompts=none sweep=none story=none trace=aa18f1ec102a98d77ffc51c9be6ffbb3 host=robb-studio base=534c53618fd675653b1717bac0fd596b8f0882f1 run=loom-run/v1:script:robb-studio/fleet-resync:3cb89ca8-62c2-4a69-8434-c4aaa3b64eaf installs=0.19.698 a58f00e0681c50d6bfc5089d0af4b3715198319f -->
    Loom-Trace-Id: aa18f1ec102a98d77ffc51c9be6ffbb3
    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
2026-10-04 chore: resync installed Loom surfaces
    <!-- loom:provenance v1 build=unknown 7a41c2e69ef89d60ed3bd190b94838021bf18d0f clean prompts=none sweep=none story=none trace=d0f04f38b507d85402723643fcf47197 host=loom-worker-1 base=88de35b3cf2a07f186a5b44ef6092bc481cbb7d6 run=loom-run/v1:script:loom-worker-1/fleet-resync:8fdc8c1c-f844-4c33-bc80-b424e5b4cf3d installs=0.19.703 89d5a428c652f957d7fad8a546589042d39911bc -->
    Loom-Trace-Id: d0f04f38b507d85402723643fcf47197
    Loom-Build: unknown 7a41c2e69ef89d60ed3bd190b94838021bf18d0f clean
    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
2026-10-05 chore: resync installed Loom surfaces
    <!-- loom:provenance v1 build=unknown ebb37db560de172930e261675a35bd52e429f650 clean prompts=none sweep=none story=none trace=a40e86a64366c7a1e36aea026901334f host=loom-worker-2 base=7b590b4725f1449f91aa11ff8dfd6d0e1ca9518b run=loom-run/v1:script:loom-worker-2/fleet-resync:90b6cd74-6cc0-4f58-98ee-6ede0ac6f50c installs=0.19.703 f63c3c82e6bf202f2ca7b205b532f681c5ebb2c8 -->
    Loom-Trace-Id: a40e86a64366c7a1e36aea026901334f
    Loom-Build: unknown ebb37db560de172930e261675a35bd52e429f650 clean
    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
2026-10-05 chore: resync installed Loom surfaces
    <!-- loom:provenance v1 build=unknown 7a41c2e69ef89d60ed3bd190b94838021bf18d0f clean prompts=none sweep=none story=none trace=fc04851db12f586b5d58155325131b6e host=robb-studio base=c79d1e7abd326124d791cffbd88f18690ff3449c run=loom-run/v1:timer:robb-studio/fleet-resync:a7d5da6f-a896-4d6f-8d00-aebf47f9b266 installs=0.19.703 2ad9a08fb93de4d7dfac9d2b501d12c684c9c2cc -->
    Loom-Trace-Id: fc04851db12f586b5d58155325131b6e
    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
2026-10-05 chore: resync installed Loom surfaces
    <!-- loom:provenance v1 build=unknown afe7e99e397c242cc319fa80702fb3b23e23f5a7 clean prompts=none sweep=none story=none trace=e46782e1dd9c94461b4cf934ce05296b host=loom-worker-2 base=f8902da7539d8e5cab7eca2d2a18c4903d59d9e4 run=loom-run/v1:timer:loom-worker-2/fleet-resync:caa89259b1fd414ebd2f07500621166d installs=0.19.703 972fe7321be6a9efe2653579379ea3bc40b899b2 -->
    Loom-Trace-Id: e46782e1dd9c94461b4cf934ce05296b
    Loom-Build: unknown afe7e99e397c242cc319fa80702fb3b23e23f5a7 clean
    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
2026-10-05 chore: resync installed Loom surfaces
    <!-- loom:provenance v1 build=unknown b44cb904ebb599db793066ccc631c846862abfbd clean prompts=none sweep=none story=none trace=9590fed7c1b1c9f549ccf3cba24292d7 host=robb-pro base=ef2b01e7f499dbd0b43b08b9e00f052c6c7c7b20 run=loom-run/v1:timer:robb-pro/fleet-resync:dbc6174e-403d-422d-98b6-73a4b6dbf44f installs=0.19.708 dc8faf1eae3143feda6301887c303b1ee45db7f4 -->
    Loom-Trace-Id: 9590fed7c1b1c9f549ccf3cba24292d7
    Loom-Build: unknown b44cb904ebb599db793066ccc631c846862abfbd clean
    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
2026-10-05 chore: resync installed Loom surfaces
    <!-- loom:provenance v1 build=unknown 4548905848fcb7cb875c1c0518f2fd88eb65818e clean prompts=none sweep=none story=none trace=aff5e139797705f6fa0811f102ecd103 host=loom-worker-1 base=5b3f5ce6d70f6897fded2e069a253aaf9da3063f run=loom-run/v1:timer:loom-worker-1/fleet-resync:ba6a9e5686a64abaa842d71acaeae2ca installs=0.19.718 00d99344506bcf00e1aec7e910abe3d13df2d240 -->
    Loom-Trace-Id: aff5e139797705f6fa0811f102ecd103
    Loom-Build: unknown 4548905848fcb7cb875c1c0518f2fd88eb65818e clean
    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
2026-10-05 chore: resync installed Loom surfaces
    <!-- loom:provenance v1 build=unknown e7efbaa6e7b97a7d72da6032044c67525291f4d1 clean prompts=none sweep=none story=none trace=d74a33a6f35e329b3e795991e790ebfd host=robb-studio base=12d32d9e0d6aedd86b4c1f0e3285e0947532ce8a run=loom-run/v1:timer:robb-studio/fleet-resync:304f49c8-5b3e-46a9-a557-945b9ae177f0 installs=0.19.718 00d99344506bcf00e1aec7e910abe3d13df2d240 -->
    Loom-Trace-Id: d74a33a6f35e329b3e795991e790ebfd
    Loom-Build: unknown e7efbaa6e7b97a7d72da6032044c67525291f4d1 clean
    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
2026-10-05 chore: resync installed Loom surfaces
    <!-- loom:provenance v1 build=unknown 347b71e65e709d9fd49aba75d3fb67877fc08818 clean prompts=none sweep=none story=none trace=f9653dd318724c98136e7cef63e551ed host=robb-pro base=4e8f7463e229c934f2401a1df0b6ad76490d2b06 run=loom-run/v1:timer:robb-pro/fleet-resync:cdc95970-9fb1-49fa-a0e6-037a3fab2099 installs=0.19.728 991dcebf6f6b2de6571f1d3400bec083498c6438 -->
    Loom-Trace-Id: f9653dd318724c98136e7cef63e551ed
    Loom-Build: unknown 347b71e65e709d9fd49aba75d3fb67877fc08818 clean
    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
2026-10-05 chore: resync installed Loom surfaces
    <!-- loom:provenance v1 build=unknown 5c0d18101f48fecb656f10fa37afa9b09bf41631 clean prompts=none sweep=none story=none trace=ddcf49552af364cbf6e884bd59584c1f host=loom-worker-1 base=a87f54f2ac865fd8493aadbab2101af06cf45224 run=loom-run/v1:timer:loom-worker-1/fleet-resync:5eb526a05f244f1985770579e7620ff1 installs=0.19.731 7484b71fce5179a025950e71a82855afaf6fd730 -->
    Loom-Trace-Id: ddcf49552af364cbf6e884bd59584c1f
    Loom-Build: unknown 5c0d18101f48fecb656f10fa37afa9b09bf41631 clean
    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
2026-10-05 chore: resync installed Loom surfaces
    <!-- loom:provenance v1 build=unknown 0b160514b6658e3ab26a71c6525791da25b46fcf clean prompts=none sweep=none story=none trace=311c3eb2c0ab9550d3de38df5523f3d7 host=robb-studio base=2b380f20e9e657fd202d91ee01a4652a75e57ca5 run=loom-run/v1:timer:robb-studio/fleet-resync:e6dec631-b42b-4cf2-b854-cc363cfde6e0 installs=0.19.731 d6146becf339a3d4e55e26e8807ac4571213a00b -->
    Loom-Trace-Id: 311c3eb2c0ab9550d3de38df5523f3d7
    Loom-Build: unknown 0b160514b6658e3ab26a71c6525791da25b46fcf clean
    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
2026-10-05 chore: resync installed Loom surfaces
    <!-- loom:provenance v1 build=unknown 5c0d18101f48fecb656f10fa37afa9b09bf41631 clean prompts=none sweep=none story=none trace=f1e8d4c6e73b8eec3e87a8da52e10f2d host=robb-pro base=61ee8d4607698e87fb7b982de989e2af2aa87c11 run=loom-run/v1:timer:robb-pro/fleet-resync:5518fd33-81cb-479f-93f0-287ea4b08876 installs=0.19.732 8592cf72c2d9172ec658f717173b6b18c439d06d -->
    Loom-Trace-Id: f1e8d4c6e73b8eec3e87a8da52e10f2d
    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
2026-10-05 chore: resync installed Loom surfaces
    <!-- loom:provenance v1 build=unknown ca170d11544ef499cc9500a45bbad152edacfbd1 clean prompts=none sweep=none story=none trace=6dcfc713b6a851b40932158c2eeb70af host=loom-worker-3 base=82a62be7b59eb8972515b7d9f56afc985703491b run=loom-run/v1:timer:loom-worker-3/fleet-resync:20ce0908ea5a468a9e055470104047ed installs=0.19.734 7ba6ea50c36dfdd2b5e2922dd22c65560980a5a2 -->
    Loom-Trace-Id: 6dcfc713b6a851b40932158c2eeb70af
    Loom-Build: unknown ca170d11544ef499cc9500a45bbad152edacfbd1 clean
    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
2026-10-05 chore: resync installed Loom surfaces
    <!-- loom:provenance v1 build=unknown 03f1c42302d15f8a83425a84a4e36ca484f3f625 clean prompts=none sweep=none story=none trace=f1bc879f8aa652d550764ffcd36e27d1 host=loom-worker-1 base=0fac1d5bf8f2657330ae87276418d0c68be67b51 run=loom-run/v1:timer:loom-worker-1/fleet-resync:f302a3cc8558413492093df510b02418 installs=0.19.734 967abe71d019ce6606018b4e57dee0223b84d96f -->
    Loom-Trace-Id: f1bc879f8aa652d550764ffcd36e27d1
    Loom-Build: unknown 03f1c42302d15f8a83425a84a4e36ca484f3f625 clean
    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
2026-10-05 chore: resync installed Loom surfaces
    <!-- loom:provenance v1 build=unknown ce7557ba58624d48fedbca2bc037dfa8ce3943e7 clean prompts=none sweep=none story=none trace=e1f2558834c47835cd9a53ec8c9a2ffa host=loom-worker-3 base=21f877aa2fb8b2299677442e4b0bc350c52dedc7 run=loom-run/v1:timer:loom-worker-3/fleet-resync:50f5f0046e2c4890961b3221bd360247 installs=0.19.734 ba9edb650872e5265eaca0c47f75e3cb828ecad2 -->
    Loom-Trace-Id: e1f2558834c47835cd9a53ec8c9a2ffa
    Loom-Build: unknown ce7557ba58624d48fedbca2bc037dfa8ce3943e7 clean
    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
2026-10-05 chore: resync installed Loom surfaces
    <!-- loom:provenance v1 build=unknown f92eaec38470a7b0732e065f4864faec9a1905d6 clean prompts=none sweep=none story=none trace=07aa020a8179d52651250562e9808b98 host=robb-studio base=90653a9f377ed0fc4713b99a22b2103fb7299d0e run=loom-run/v1:timer:robb-studio/fleet-resync:3b3ebdf2-b5f7-48ed-b7bb-5fb945094061 installs=0.19.734 78f3e99c44d0af6d4598adf7577bb6676baf3e8f -->
    Loom-Trace-Id: 07aa020a8179d52651250562e9808b98
    Loom-Build: unknown f92eaec38470a7b0732e065f4864faec9a1905d6 clean
    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
2026-10-06 chore: resync installed Loom surfaces
    <!-- loom:provenance v1 build=unknown ca170d11544ef499cc9500a45bbad152edacfbd1 clean prompts=none sweep=none story=none trace=fca9c14d74d6d634726f5823c51bc62a host=loom-worker-2 base=60aae6cd8243f9d11a5829ba0ec633215fe2ab76 run=loom-run/v1:timer:loom-worker-2/fleet-resync:23a23f0878c1494cb720941baddfea81 installs=0.19.741 3cede3920c6b567d5400789187a904970d46b0fb -->
    Loom-Trace-Id: fca9c14d74d6d634726f5823c51bc62a
    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
2026-10-06 chore: resync installed Loom surfaces
    <!-- loom:provenance v1 build=unknown e38a22941348fd8e83d1f4b06130d2a214adfb50 clean prompts=none sweep=none story=none trace=a7fe3a9a1fedfce89846c20f2e98ac31 host=robb-pro base=f562342cc15ba6a036d641361bae9001d90b8aeb run=loom-run/v1:timer:robb-pro/fleet-resync:2d770a42-f0e7-4695-abfa-b912e75382e6 installs=0.19.744 8bc5bcce93c4d9721817387afe8b4b6d79f26054 -->
    Loom-Trace-Id: a7fe3a9a1fedfce89846c20f2e98ac31
    Loom-Build: unknown e38a22941348fd8e83d1f4b06130d2a214adfb50 clean
    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
2026-10-06 chore: resync installed Loom surfaces
    <!-- loom:provenance v1 build=unknown f66ea90ff1bdec51aa4c8dc3f4b2e8d26e3dfd2d clean prompts=none sweep=none story=none trace=66d96c3bb00b04fae967865ee02fc4de host=loom-worker-3 base=f163e2ac408ec47a000b84638c11719240be036b run=loom-run/v1:timer:loom-worker-3/fleet-resync:eb2dceb410e848a19d58f96f678c995e installs=0.19.749 6135634b053dc30ef5aa8e6d733bfe79bb2ac734 -->
    Loom-Trace-Id: 66d96c3bb00b04fae967865ee02fc4de
    Loom-Build: unknown f66ea90ff1bdec51aa4c8dc3f4b2e8d26e3dfd2d clean
    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
2026-10-06 chore: resync installed Loom surfaces
    <!-- loom:provenance v1 build=unknown ade8a2c60cc8370d04d72f331141acb6fb32e121 clean prompts=none sweep=none story=none trace=6245fb88b5bdf9f7ccecb6b2168dc335 host=robb-studio base=7f6731c534ad57df59fd3147fcc1a7557804cff3 run=loom-run/v1:timer:robb-studio/fleet-resync:b305aed2-1a25-4576-aca7-9b017ac4377e installs=0.19.755 8d97d322e1cb3723988504337089beca73d0511c -->
    Loom-Trace-Id: 6245fb88b5bdf9f7ccecb6b2168dc335
    Loom-Build: unknown ade8a2c60cc8370d04d72f331141acb6fb32e121 clean
    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
2026-10-06 chore: resync installed Loom surfaces
    <!-- loom:provenance v1 build=unknown 2489bb7d5203844b3fbe8efbe007f44aa074685d clean prompts=none sweep=none story=none trace=0b5c9263a55c09e6fbd870b2d9ff5d9b host=loom-worker-2 base=a07a7bdf473819e4909a2552daf0e12b8174569e run=loom-run/v1:timer:loom-worker-2/fleet-resync:d3f5a5beb1144f72ac8be575767b3e03 installs=0.19.760 3a509582b179d91c2d5b5a65a7ba4650c3c08985 -->
    Loom-Trace-Id: 0b5c9263a55c09e6fbd870b2d9ff5d9b
    Loom-Build: unknown 2489bb7d5203844b3fbe8efbe007f44aa074685d clean
    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
2026-10-06 chore: resync installed Loom surfaces
    <!-- loom:provenance v1 build=unknown 986d16b700174622774ff68af4ef323e8d0e23ba clean prompts=none sweep=none story=none trace=cb518f1f5785c258556383940a46c461 host=loom-worker-1 base=f7aaf4aa6d205d52c71a9b153e4e9b75d1d3bc71 run=loom-run/v1:timer:loom-worker-1/fleet-resync:97df92c5eca846de85e979810663a94b installs=0.19.765 c6cec65c4f320f11153c72e840e49a5d6a6f1afc -->
    Loom-Trace-Id: cb518f1f5785c258556383940a46c461
    Loom-Build: unknown 986d16b700174622774ff68af4ef323e8d0e23ba clean
    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
2026-10-06 chore: resync installed Loom surfaces
    <!-- loom:provenance v1 build=unknown 85e52221261264d7f7643251de706f00c8db289f clean prompts=none sweep=none story=none trace=a2434124d73d8cca0ca77230fc85adf5 host=robb-pro base=6fadc1cd168563a3e32bd1d96bd0081030021c3a run=loom-run/v1:timer:robb-pro/fleet-resync:abffb067-59ed-4a6e-94b6-8cf3500c935c installs=0.19.768 c9f7ca975144d991bce40f492403b8292e8b7fae -->
    Loom-Trace-Id: a2434124d73d8cca0ca77230fc85adf5
    Loom-Build: unknown 85e52221261264d7f7643251de706f00c8db289f clean
    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
2026-10-06 chore: resync installed Loom surfaces
    <!-- loom:provenance v1 build=unknown 31b34ebfd7d4539094523eaa7b56a104bebe5fc0 clean prompts=none sweep=none story=none trace=16fac36f144dc183c71465eb36c89afc host=loom-worker-3 base=9af1096454e66158a159cef34a4964c31758509d run=loom-run/v1:timer:loom-worker-3/fleet-resync:c763e24590314b918c8ee8df5d2de1db installs=0.19.769 af995a5725fdadf708127f006aa8f248b482d7d7 -->
    Loom-Trace-Id: 16fac36f144dc183c71465eb36c89afc
    Loom-Build: unknown 31b34ebfd7d4539094523eaa7b56a104bebe5fc0 clean
    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
2026-10-06 chore: resync installed Loom surfaces
    <!-- loom:provenance v1 build=unknown 7bed309263b3785eae46a9cbc53b3b24a52b10d2 clean prompts=none sweep=none story=none trace=843adbd5eac450c43d3a2c43da1bf729 host=robb-studio base=fe188a17733515d7aaf6097bd38fc36e366e2c5a run=loom-run/v1:timer:robb-studio/fleet-resync:f83d5ba4-81f7-479a-9768-6af33d4cc825 installs=0.19.783 a9b459e0c2b1916ceb116db33053e7eb0df57e7b -->
    Loom-Trace-Id: 843adbd5eac450c43d3a2c43da1bf729
    Loom-Build: unknown 7bed309263b3785eae46a9cbc53b3b24a52b10d2 clean
    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
2026-10-06 chore: resync installed Loom surfaces
    <!-- loom:provenance v1 build=unknown 07bc40ba9ab0f7dfe7cd0990377b7ac07a52d220 clean prompts=none sweep=none story=none trace=563f186108419cf03cef002a62c3b201 host=loom-worker-2 base=5fd57e5f7369b8a50ef9f9565e8550779c87e296 run=loom-run/v1:timer:loom-worker-2/fleet-resync:944beccd157a4197b81feafdd19f443e installs=0.19.785 2f0a9dbb4f06053f747b8a5615a3519f8e30b527 -->
    Loom-Trace-Id: 563f186108419cf03cef002a62c3b201
    Loom-Build: unknown 07bc40ba9ab0f7dfe7cd0990377b7ac07a52d220 clean
    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
2026-10-06 chore: resync installed Loom surfaces
    <!-- loom:provenance v1 build=unknown 31b34ebfd7d4539094523eaa7b56a104bebe5fc0 clean prompts=none sweep=none story=none trace=ea6600df41a4b420b6d8e967f839ccfd host=loom-worker-3 base=b93c61cf27086162a06b9e7176494ae0ebbc59ea run=loom-run/v1:timer:loom-worker-3/fleet-resync:c80415b48fd5404bbd599c4f6cc8a448 installs=0.19.793 7ceff96944c39d33e3c2f1141ca650c2c4c05679 -->
    Loom-Trace-Id: ea6600df41a4b420b6d8e967f839ccfd
    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
2026-10-06 chore: resync installed Loom surfaces
    <!-- loom:provenance v1 build=unknown 596a53e525683919daae1b43e6babe9bf847a02f clean prompts=none sweep=none story=none trace=b9c0cb42a5a72ecc21726229c957ef1f host=loom-worker-2 base=aa041f8296620942c95e0234c046f3fccf48391c run=loom-run/v1:timer:loom-worker-2/fleet-resync:21d578f5cc0b4b7ba5f10759f5f30ae8 installs=0.19.801 524bdb33cb26c8355454d7550413c89e72c06fae -->
    Loom-Trace-Id: b9c0cb42a5a72ecc21726229c957ef1f
    Loom-Build: unknown 596a53e525683919daae1b43e6babe9bf847a02f clean
    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
2026-10-06 chore: resync installed Loom surfaces
    <!-- loom:provenance v1 build=unknown 40b591a33adb895d4f46977105f9b264d8a2599b clean prompts=none sweep=none story=none trace=e41c725fe0c176312eb412bc69fe5b01 host=robb-studio base=012ee3e1a18b537f6672db7c02648d1cc0da7a5b run=loom-run/v1:timer:robb-studio/fleet-resync:37d704dd-4dfd-4341-adb4-6551637ad147 installs=0.19.802 72ce1f7385747dd773d1644408ec22072b8a5d20 -->
    Loom-Trace-Id: e41c725fe0c176312eb412bc69fe5b01
    Loom-Build: unknown 40b591a33adb895d4f46977105f9b264d8a2599b clean
    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
2026-10-06 chore: resync installed Loom surfaces
    <!-- loom:provenance v1 build=unknown 31b34ebfd7d4539094523eaa7b56a104bebe5fc0 clean prompts=none sweep=none story=none trace=5ad0480c4b21b80f9c852c448319e7a1 host=loom-worker-3 base=09af691883794586ac925572bd376ceb4cf0f995 run=loom-run/v1:timer:loom-worker-3/fleet-resync:48e836f11f9547ddb96de5aa0d072a05 installs=0.19.810 933f828e779602e492e4e157812988a4b8128111 -->
    Loom-Trace-Id: 5ad0480c4b21b80f9c852c448319e7a1
    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
2026-10-07 chore: resync installed Loom surfaces
    <!-- loom:provenance v1 build=unknown f71cf25de9e75bae6060da4a599df8fbabe75890 clean prompts=none sweep=none story=none trace=64943e35511da4833bbd385cf288be8a host=loom-worker-2 base=40200497dcce4e476c66cc1286e6edd775c67f4c run=loom-run/v1:timer:loom-worker-2/fleet-resync:d69eb1b87d4849ae810a145b1b667d2f installs=0.19.822 1c6969ea8726c800a353c236d9f23456a5706f1a -->
    Loom-Trace-Id: 64943e35511da4833bbd385cf288be8a
    Loom-Build: unknown f71cf25de9e75bae6060da4a599df8fbabe75890 clean
    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
2026-10-07 chore: resync installed Loom surfaces
    <!-- loom:provenance v1 build=unknown 31b34ebfd7d4539094523eaa7b56a104bebe5fc0 clean prompts=none sweep=none story=none trace=cb192cb8f72cf6f2711f73f7ee12bebc host=loom-worker-3 base=6a5756b6941a1218f9eade884c779ecfa07d3f9b run=loom-run/v1:timer:loom-worker-3/fleet-resync:c1e385c3607e43ad8bed9c7d29811c66 installs=0.19.830 a966f7b89b714704fa1225b96e2dbee50480a4c6 -->
    Loom-Trace-Id: cb192cb8f72cf6f2711f73f7ee12bebc
    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
2026-10-07 chore: resync installed Loom surfaces
    <!-- loom:provenance v1 build=unknown 8abdd34fddc879aff407380278baa713eca6b758 clean prompts=none sweep=none story=none trace=ea945665dad5ccb3880de51c4448e8b9 host=robb-pro base=ca725110caba7c8499966e55297208e873b5b651 run=loom-run/v1:timer:robb-pro/fleet-resync:1466e397-b80c-46ea-a42c-26a7fbd4e00e installs=0.19.831 61814c9c1912925cdff7418842ff3ea17cd56fe4 -->
    Loom-Trace-Id: ea945665dad5ccb3880de51c4448e8b9
    Loom-Build: unknown 8abdd34fddc879aff407380278baa713eca6b758 clean
    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
2026-10-07 chore: resync installed Loom surfaces
    <!-- loom:provenance v1 build=unknown 628be5bb140bcff803d159201bd61e1b868901b0 clean prompts=none sweep=none story=none trace=093df1dc315c5e78dcccfca9d699d5f5 host=loom-worker-2 base=1b323170318811da366d7cb45a1ebc9afae0f385 run=loom-run/v1:timer:loom-worker-2/fleet-resync:0b0ea5e184c0429a9c431fcca6c791ad installs=0.19.832 1a0fc15974bf0575a9155fb8276f7529fc813542 -->
    Loom-Trace-Id: 093df1dc315c5e78dcccfca9d699d5f5
    Loom-Build: unknown 628be5bb140bcff803d159201bd61e1b868901b0 clean
    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
2026-10-07 chore: resync installed Loom surfaces
    <!-- loom:provenance v1 build=unknown 069e3b45d86c08f0d60c8fc2b0096de441e99bdc clean prompts=none sweep=none story=none trace=b1ba9d6b2b581e47827d9c099f717b04 host=loom-worker-1 base=33f6bb0aa342cfcb461f8cf80262920cbe6d2eca run=loom-run/v1:timer:loom-worker-1/fleet-resync:aada8278bd4843bcaecce69fdf91251e installs=0.19.837 9504f1e9b05e05ce908dd5cffad2aae723621f63 -->
    Loom-Trace-Id: b1ba9d6b2b581e47827d9c099f717b04
    Loom-Build: unknown 069e3b45d86c08f0d60c8fc2b0096de441e99bdc clean
    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
2026-10-07 chore: resync installed Loom surfaces
    <!-- loom:provenance v1 build=unknown 31b34ebfd7d4539094523eaa7b56a104bebe5fc0 clean prompts=none sweep=none story=none trace=ef030e94bce76f728497f5927960865f host=loom-worker-3 base=de39bff3807e4bd34ddce939b4bc89995f9ae15f run=loom-run/v1:timer:loom-worker-3/fleet-resync:28ba4284bfa446c888b501714eda0509 installs=0.19.840 59b533a2a1ed5e186fbf8446b5acbe42d7231854 -->
    Loom-Trace-Id: ef030e94bce76f728497f5927960865f
    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
2026-10-07 chore: resync installed Loom surfaces
    <!-- loom:provenance v1 build=unknown bc59c70c3412a87b31a0dbe65cd6abf968744328 clean prompts=none sweep=none story=none trace=766033e4e881801f24971d664c490ea3 host=robb-studio base=a1a9bdf9eb2c4ab622df054cd1a2022bbbd4f1d9 run=loom-run/v1:timer:robb-studio/fleet-resync:6b3b079a-890e-4a79-9c3a-0b4bb33ff7c4 installs=0.19.840 59b533a2a1ed5e186fbf8446b5acbe42d7231854 -->
    Loom-Trace-Id: 766033e4e881801f24971d664c490ea3
    Loom-Build: unknown bc59c70c3412a87b31a0dbe65cd6abf968744328 clean
    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
2026-10-07 chore: resync installed Loom surfaces
    <!-- loom:provenance v1 build=unknown a068938e7a6c13759bcb3943e408273a3d352257 clean prompts=none sweep=none story=none trace=76bec863c8f6aff2d49b3aa2be128619 host=robb-pro base=9546cdcc9bdd7d1142e5135a8d03d61c3931a409 run=loom-run/v1:timer:robb-pro/fleet-resync:d9927fc6-ee80-4b6a-ba2b-f13576bd5f9b installs=0.19.846 837b14d7440b89ae8a2cec6d045483ac33659af5 -->
    Loom-Trace-Id: 76bec863c8f6aff2d49b3aa2be128619
    Loom-Build: unknown a068938e7a6c13759bcb3943e408273a3d352257 clean
    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
2026-10-07 chore: resync installed Loom surfaces
    <!-- loom:provenance v1 build=unknown 628be5bb140bcff803d159201bd61e1b868901b0 clean prompts=none sweep=none story=none trace=5a6f676b4652a1a750bbce1386c68d06 host=loom-worker-2 base=31a3138c703f4fa24d5491ef1d630c8fa7a028a5 run=loom-run/v1:timer:loom-worker-2/fleet-resync:bd416e653be04ef4b13353430625e379 installs=0.19.850 3bb4bfc90603b6ad65cabca9b3eb42a59f1a9d3a -->
    Loom-Trace-Id: 5a6f676b4652a1a750bbce1386c68d06
    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
2026-10-07 chore: resync installed Loom surfaces
    <!-- loom:provenance v1 build=unknown 40215645df8a13508180b248b44244dc488bb078 clean prompts=none sweep=none story=none trace=29fde30615e6e47f39b41aa314c2c883 host=loom-worker-1 base=6acae49b39dc5ad53eb1fc6dd59a0e5d6109e21c run=loom-run/v1:timer:loom-worker-1/fleet-resync:d1fbedfcc7824ae59233c0ea94dc4650 installs=0.19.853 2889d5ed585b4da0935543cb916381cc03b19746 -->
    Loom-Trace-Id: 29fde30615e6e47f39b41aa314c2c883
    Loom-Build: unknown 40215645df8a13508180b248b44244dc488bb078 clean
    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
2026-10-07 chore: resync installed Loom surfaces
    <!-- loom:provenance v1 build=unknown 31b34ebfd7d4539094523eaa7b56a104bebe5fc0 clean prompts=none sweep=none story=none trace=cdf49c615da3f5ce46e9fcda1a24f787 host=loom-worker-3 base=95c80cf110fbbd8c01882a53982f61d1eb22df9a run=loom-run/v1:timer:loom-worker-3/fleet-resync:cab31e05b8a24df09bc88f53ee3fb501 installs=0.19.857 7a0b529e6f57a79713f6924bf58d8392ff404259 -->
    Loom-Trace-Id: cdf49c615da3f5ce46e9fcda1a24f787
    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
2026-10-07 chore: resync installed Loom surfaces
    <!-- loom:provenance v1 build=unknown 4b44e7c5db0de1d2b5927de7de229120d546aad3 clean prompts=none sweep=none story=none trace=dfa656ee3483a044378501f49d36f812 host=robb-studio base=893013dc6a73db0fa0acb203bda9988566361318 run=loom-run/v1:timer:robb-studio/fleet-resync:d80d6bc0-eb68-4a07-8226-2d947d328b3a installs=0.19.859 0aefebd79aba8ab33470f1af4b96847fc794bd0d -->
    Loom-Trace-Id: dfa656ee3483a044378501f49d36f812
    Loom-Build: unknown 4b44e7c5db0de1d2b5927de7de229120d546aad3 clean
    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
2026-10-07 chore: resync installed Loom surfaces
    <!-- loom:provenance v1 build=unknown b591c8cf436f0d4aa5870a9bc7cd5f7194e0e778 dirty prompts=none sweep=none story=none trace=6eca4b0c47205457aae7a3d721c17f17 host=robb-pro base=bec62c21160cfa1c54f7c4fa440e48b41b2f8038 run=loom-run/v1:timer:robb-pro/fleet-resync:64af20b3-58cb-47f2-b770-117197cb41e9 installs=0.19.864 128a7eba2bb5f7bcf8891ba284b14cb7ebf8dd3d -->
    Loom-Trace-Id: 6eca4b0c47205457aae7a3d721c17f17
    Loom-Build: unknown b591c8cf436f0d4aa5870a9bc7cd5f7194e0e778 dirty
    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
2026-10-07 chore: resync installed Loom surfaces
    <!-- loom:provenance v1 build=unknown b551219fd5b8347113c0cbc79ea416e81c39fa9d clean prompts=none sweep=none story=none trace=5ac7c8c62dad54841e21dd94f0920de3 host=loom-worker-2 base=c19d2b288ed599e6692bb1bef9cc48a3b50c996d run=loom-run/v1:timer:loom-worker-2/fleet-resync:d10fb10789e94930ab1af368c15a8f8b installs=0.19.864 128a7eba2bb5f7bcf8891ba284b14cb7ebf8dd3d -->
    Loom-Trace-Id: 5ac7c8c62dad54841e21dd94f0920de3
    Loom-Build: unknown b551219fd5b8347113c0cbc79ea416e81c39fa9d clean
    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
2026-10-07 chore: resync installed Loom surfaces
    <!-- loom:provenance v1 build=unknown 90fbd167e4e376894396e651676cf58fc9aa223a clean prompts=none sweep=none story=none trace=196876656e912171b28029ceca9f772d host=loom-worker-1 base=fa9df1b76f1017aa68733913e773c2e5e53c6b88 run=loom-run/v1:timer:loom-worker-1/fleet-resync:7b46720ff3a84a8184f2f2b3bc039260 installs=0.19.868 ee904e1c151bc9cf15b0eb55dfe9d57ad6136cff -->
    Loom-Trace-Id: 196876656e912171b28029ceca9f772d
    Loom-Build: unknown 90fbd167e4e376894396e651676cf58fc9aa223a clean
    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
2026-10-08 chore: resync installed Loom surfaces
    <!-- loom:provenance v1 build=unknown 5a3df331a0612dee585ef905015af01d08e3467f clean prompts=none sweep=none story=none trace=5690fa95febe608e500a46dde8a6ee92 host=loom-worker-2 base=1dc67f1726f5216ee37dce85de098059bd62dc85 run=loom-run/v1:timer:loom-worker-2/fleet-resync:5c9c35d59b704bff9d8bf096ee7ba7be installs=0.19.876 b16d54e63fbbec4d7f15f13c1f43a5e5b38145ce -->
    Loom-Trace-Id: 5690fa95febe608e500a46dde8a6ee92
    Loom-Build: unknown 5a3df331a0612dee585ef905015af01d08e3467f clean
    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
2026-10-08 chore: resync installed Loom surfaces
    <!-- loom:provenance v1 build=unknown 134eb3ff06c1a86f49a911c6c17464f55e719736 clean prompts=none sweep=none story=none trace=c7df110d490314040dcd1347b2481843 host=loom-worker-1 base=94e0bb7963e05c54c82cebe6c58b10a81523ebfd run=loom-run/v1:timer:loom-worker-1/fleet-resync:53d0cec2cd61484eb9a0f8fb1f24ac5e installs=0.19.879 c15619905bdd8a24506c3853f45490d26e8f1cad -->
    Loom-Trace-Id: c7df110d490314040dcd1347b2481843
    Loom-Build: unknown 134eb3ff06c1a86f49a911c6c17464f55e719736 clean
    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
2026-10-08 chore: resync installed Loom surfaces
    <!-- loom:provenance v1 build=unknown 8f86de23319d8f6cf049557dcc9cf2e321211d9d clean prompts=none sweep=none story=none trace=17de45f778fbfd714af8afad02c96375 host=loom-worker-3 base=1c9a245976da89b6d1cb0083605b5971993f587e run=loom-run/v1:timer:loom-worker-3/fleet-resync:9e3e5d4a08824de3b7bc02940be2a0da installs=0.19.882 c9f85af3d967986cdd7a3f27e088a16f88712b05 -->
    Loom-Trace-Id: 17de45f778fbfd714af8afad02c96375
    Loom-Build: unknown 8f86de23319d8f6cf049557dcc9cf2e321211d9d clean
    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
2026-10-08 chore: resync installed Loom surfaces
    <!-- loom:provenance v1 build=unknown 4a5fb2b6276e17ff26ee1382acfe2ea7360ebea5 clean prompts=none sweep=none story=none trace=67857e1b7189785825a2dfc70921cf85 host=loom-worker-2 base=20e91f1bfb9bd0272c38327ffc1a3995a72eadee run=loom-run/v1:timer:loom-worker-2/fleet-resync:dd6a5f3dceff4d8d8602a07a1dc89c95 installs=0.19.892 ce93e8a919d79a6f027bab268846a52084f9d94e -->
    Loom-Trace-Id: 67857e1b7189785825a2dfc70921cf85
    Loom-Build: unknown 4a5fb2b6276e17ff26ee1382acfe2ea7360ebea5 clean
    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
2026-10-08 chore: resync installed Loom surfaces
    <!-- loom:provenance v1 build=unknown b591c8cf436f0d4aa5870a9bc7cd5f7194e0e778 dirty prompts=none sweep=none story=none trace=28e7ca5fdb768489aa38bf002407d5a5 host=robb-pro base=a9310eb17c42672881f2013f284430e03af55a03 run=loom-run/v1:timer:robb-pro/fleet-resync:eb5f838e-a774-4e20-8102-c37ee3ff31ca installs=0.19.895 9b30d293bcba1e79d49cabfc1c5bb5b6f4c0dc77 -->
    Loom-Trace-Id: 28e7ca5fdb768489aa38bf002407d5a5
    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
2026-10-08 chore: resync installed Loom surfaces
    <!-- loom:provenance v1 build=unknown 5684fc8c8ac418d95ad66a002d001eaea1283c9a clean prompts=none sweep=none story=none trace=c864acd3b9a5dbb419fddd8bd2a6283b host=loom-worker-3 base=7499a82fb52485321b3951281eaf2b8804b377fa run=loom-run/v1:timer:loom-worker-3/fleet-resync:4771e7c630c34445b7f28539669d76e3 installs=0.19.898 3d55b9a1669c132d130d98f10a292c1325322c30 -->
    Loom-Trace-Id: c864acd3b9a5dbb419fddd8bd2a6283b
    Loom-Build: unknown 5684fc8c8ac418d95ad66a002d001eaea1283c9a clean
    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
2026-10-08 sim: route startup-stability matrix through klt sim batch backend (#320)
    Add corner-run.py --backend batch: one klt sim batch job per supply voltage,
    reports folded back into the existing record format with missing/duplicate
    corners, remote PDK mismatch and runner skew blocking an overall PASS.
    Loom-Story: 2AMLogic/sky130-bandgap#320
    Loom-Trace-Id: aba8ac4ebb8844301c35e97c2060c022
    Loom-Build: 0.19.868 ee904e1c151bc9cf15b0eb55dfe9d57ad6136cff clean
2026-10-08 sim: batch backend docs, infra-fault handling, status of live run (#320)
    A fleet job that dies before simulating (runner klt older than the client)
    is an error with job ids, not a FAIL record about the design.
    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
2026-10-08 chore: resync installed Loom surfaces
    <!-- loom:provenance v1 build=unknown 04a1189116c7320def7d9ce357d2d9268405ae92 clean prompts=none sweep=none story=none trace=8e55b27fc60ffb045554bd413ad8f3c8 host=robb-pro base=32cdd90bfc3081c28574a4629181b7a96e5fb95a run=loom-run/v1:timer:robb-pro/fleet-resync:83b69005-7c5b-44b3-96f8-33f07bf82f4b installs=0.19.917 d3c1ea3a4c81e01ce5487dc3e4bbdd86534e677e -->
    Loom-Trace-Id: 8e55b27fc60ffb045554bd413ad8f3c8
    Loom-Build: unknown 04a1189116c7320def7d9ce357d2d9268405ae92 clean
    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
2026-10-08 docs: replace README status changelog with compact 8-row scoreboard (#328)
    Loom-Story: 2AMLogic/sky130-bandgap#328
    Loom-Trace-Id: 3e7b029129c396fc6583e9f372cf3b17
    Loom-Build: 0.19.898 3d55b9a1669c132d130d98f10a292c1325322c30 clean
2026-10-08 sim: parameterize trim-lsb-chained on the design sizing and run it on the batch fleet (#327)
    Loom-Story: 2AMLogic/sky130-bandgap#327
    Loom-Trace-Id: 90ab0282ffd0b557ee5a3fc2b71aebc5
    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
2026-10-08 sim: trim-lsb-chained provenance, core-body verification, explicit missing-point grading, tests (#327)
    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
2026-10-08 sim: new trim-lsb-chained record at n_r2=51 (all DR-002 criteria PASS), report row 2, signoff regen (#327)
    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
2026-10-08 sim: grade literal DR-005 Trim row separately from DR-002 checks; derived qualification record (#333)
    Loom-Story: 2AMLogic/sky130-bandgap#333
    Loom-Trace-Id: 4dfda78fe4c654a9faecd737b65f9a87
    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
2026-10-08 sim: derived DR-005 3-sigma qualification of untrimmed MC, separate from the >=50% sanity floor (#334)
    Loom-Story: 2AMLogic/sky130-bandgap#334
    Loom-Trace-Id: c092c468128ccf317166402a4f21861f
    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
2026-10-08 signoff: single source of truth for klt grader pin and identity assertion (#338)
    KLT_VERSION lives only in check_signoff_freshness.py; ci.yml and
    regenerate.sh read it via --print-version, regenerate.sh's inline identity
    heredoc is replaced by --assert-grader, README reduced to a pointer.
    Loom-Story: 2AMLogic/sky130-bandgap#338
    Loom-Trace-Id: b5387870e3e0c73341fdd7f50288a883
    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
2026-10-08 reuse: record error_amp as kept in-tree via DR-014 (#337)
    Loom-Story: 2AMLogic/sky130-bandgap#337
    Loom-Trace-Id: 26a3531a56e3084c09a5319fe818e9ce
    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
2026-10-08 chore: resync installed Loom surfaces
    <!-- loom:provenance v1 build=unknown d2a55ce217b3ad1793611a2c54946676bb55b512 clean prompts=none sweep=none story=none trace=459637e4e8503593bdf58360865a7524 host=robb-pro base=b15c5a3407557f1e90e0a062c4a91b61f9bb7f45 run=loom-run/v1:timer:robb-pro/fleet-resync:95b3cf92-9cd9-4c36-8bbd-bdcace7c3874 installs=0.19.935 d347079cd0bad2db2c11ee4f0b760f04b2601d21 -->
    Loom-Trace-Id: 459637e4e8503593bdf58360865a7524
    Loom-Build: unknown d2a55ce217b3ad1793611a2c54946676bb55b512 clean
    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
2026-10-08 ci: widen syntax/JSON lint to directory-walking coverage (#343)
    Loom-Story: 2AMLogic/sky130-bandgap#343
    Loom-Trace-Id: e5ddeb653b8d30b7fde21e6b47ed8a8a
    Loom-Build: 0.19.929 e0381fd31734743649019281f22b12223f853f41 clean
2026-10-08 sim/README: move per-bench record history out of the runner-bypass table (#339)
    Loom-Story: 2AMLogic/sky130-bandgap#339
    Loom-Trace-Id: d7a2f19bcb69311043045a8e9fded91a
    Loom-Build: 0.19.895 9b30d293bcba1e79d49cabfc1c5bb5b6f4c0dc77 clean
2026-10-08 README: cover all top-level entries in Layout tree (#344)
    Loom-Story: 2AMLogic/sky130-bandgap#344
    Loom-Trace-Id: 543c7b7cbabfe512b67e484013c313a6
    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
2026-10-09 chore: resync installed Loom surfaces
    <!-- loom:provenance v1 build=unknown 05dba463c5b293d38f0ca071725983862498b3f3 clean prompts=none sweep=none story=none trace=14298316053024bcf5120bff695771ab host=robb-pro base=da9ad3975bd1b28cf4b879b6cbffb2e3d65f8846 run=loom-run/v1:timer:robb-pro/fleet-resync:2f384483-6d77-4ba2-9888-aa1e4b5be36c installs=0.19.953 b93d7a955d63411cb4c94b986fd5138d27dedb0f -->
    Loom-Trace-Id: 14298316053024bcf5120bff695771ab
    Loom-Build: unknown 05dba463c5b293d38f0ca071725983862498b3f3 clean
    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
2026-10-09 chore: resync installed Loom surfaces
    <!-- loom:provenance v1 build=unknown 7f06b288b150f2fe0a4b24c331a9b3ec093d709d clean prompts=none sweep=none story=none trace=a90c217ff3a3bd9e3a30282b8cadc24d host=robb-pro base=b34d1e233844c46e8d940215e161bf7ca202db24 run=loom-run/v1:timer:robb-pro/fleet-resync:6e5ec9f3-d6ef-4953-80f7-c93035e2d359 installs=0.19.965 e273add25ee705165a398b8d9233c650443be0a0 -->
    Loom-Trace-Id: a90c217ff3a3bd9e3a30282b8cadc24d
    Loom-Build: unknown 7f06b288b150f2fe0a4b24c331a9b3ec093d709d clean
    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
2026-10-09 chore: resync installed Loom surfaces
    <!-- loom:provenance v1 build=unknown 30c7a7ee2f74a6a2b5bb0f19fd9f049ec8ae8b5c clean prompts=none sweep=none story=none trace=7bc5ba399ff199d049d83d711920a157 host=robb-pro base=35e84a6ab59c989a3e600fca6868af1401f58f89 run=loom-run/v1:timer:robb-pro/fleet-resync:8e237160-c4d0-4ce3-85ac-c96aff5cf221 installs=0.19.982 2bc4cba624b9053535663441e6f0daf08a7acf2e -->
    Loom-Trace-Id: 7bc5ba399ff199d049d83d711920a157
    Loom-Build: unknown 30c7a7ee2f74a6a2b5bb0f19fd9f049ec8ae8b5c clean
    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
2026-10-10 chore: resync installed Loom surfaces
    <!-- loom:provenance v1 build=unknown 03c1cb521a10d5101bd8aa2c52a47cebfb0e795b clean prompts=none sweep=none story=none trace=09ccab293fce5c1a7b4aa907c7197bec host=robb-studio base=6256aab4ac8e996590cd5f0401ba0faa11347f64 run=loom-run/v1:timer:robb-studio/fleet-resync:ed2be6c5-20fe-4228-a206-940d35a4858f installs=0.19.996 0d2be7e9ae05753e2c9232a83b7399d45de5396e -->
    Loom-Trace-Id: 09ccab293fce5c1a7b4aa907c7197bec
    Loom-Build: unknown 03c1cb521a10d5101bd8aa2c52a47cebfb0e795b clean
    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
2026-10-10 chore: resync installed Loom surfaces
    <!-- loom:provenance v1 build=unknown a7d2b01d8eb7d09e597a4638e5cb3cdd8bab9156 clean prompts=none sweep=none story=none trace=35c1337ee84607e87ba2038523d63198 host=robb-pro base=abb75010891ce4cb6652febedd215fd50220232e run=loom-run/v1:timer:robb-pro/fleet-resync:6bf32a81-6c4a-48c5-a51e-1ad65c6bedfd installs=0.19.999 20513e3064fa3a7c4b3f1c641d97a00446e9ba78 -->
    Loom-Trace-Id: 35c1337ee84607e87ba2038523d63198
    Loom-Build: unknown a7d2b01d8eb7d09e597a4638e5cb3cdd8bab9156 clean
    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
2026-10-10 chore: resync installed Loom surfaces
    <!-- loom:provenance v1 build=unknown c156f673e072832aaacb4cd1ec65b742e7f45867 clean prompts=none sweep=none story=none trace=9de99c124c651049199abe9a75070dc7 host=robb-pro base=f5fbf7bcca26c82a9fb6de37e49bdb31badb096c run=loom-run/v1:timer:robb-pro/fleet-resync:f790885c-7154-4b3d-acd9-71fd537cd20b installs=0.19.1010 d1d5fcecb79550fe39658555a4419f98cec060fb -->
    Loom-Trace-Id: 9de99c124c651049199abe9a75070dc7
    Loom-Build: unknown c156f673e072832aaacb4cd1ec65b742e7f45867 clean
    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
2026-10-10 chore: resync installed Loom surfaces
    <!-- loom:provenance v1 build=unknown 52f79668bb5f93c1828b7f1ea4f7013b917b847b clean prompts=none sweep=none story=none trace=7057f3175071f1f6e34b354fab40a0ce host=robb-studio base=a6326e08fcd10c5f2ec31065b66a414f926472bd run=loom-run/v1:timer:robb-studio/fleet-resync:d8918779-1625-4202-b151-71f64465e8cd installs=0.19.1010 d1d5fcecb79550fe39658555a4419f98cec060fb -->
    Loom-Trace-Id: 7057f3175071f1f6e34b354fab40a0ce
    Loom-Build: unknown 52f79668bb5f93c1828b7f1ea4f7013b917b847b clean
    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
2026-10-10 chore: resync installed Loom surfaces
    <!-- loom:provenance v1 build=unknown 525fe43b7b1b2a0271084bba444c934a1541a8d8 clean prompts=none sweep=none story=none trace=0d4424bd058cf912b74934ec0e7bf37e host=robb-pro base=6b74a38e77da70a8d433e6ff26782a991c1d646f run=loom-run/v1:timer:robb-pro/fleet-resync:4812047c-8b9b-4da2-a5dc-13e6f6420a04 installs=0.19.1018 13e54f1cfc513507a7ef84ec6908085638d9c187 -->
    Loom-Trace-Id: 0d4424bd058cf912b74934ec0e7bf37e
    Loom-Build: unknown 525fe43b7b1b2a0271084bba444c934a1541a8d8 clean
    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
2026-10-10 chore: resync installed Loom surfaces
    <!-- loom:provenance v1 build=unknown 525fe43b7b1b2a0271084bba444c934a1541a8d8 clean prompts=none sweep=none story=none trace=d4059def94f46d8d158946acddd4d602 host=robb-studio base=32f803e67c357c53ca47cffd916c50ecb2b654f4 run=loom-run/v1:timer:robb-studio/fleet-resync:4a4d1995-968e-44c5-b5fe-804b4d477795 installs=0.19.1018 13e54f1cfc513507a7ef84ec6908085638d9c187 -->
    Loom-Trace-Id: d4059def94f46d8d158946acddd4d602
    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
2026-10-10 chore: resync installed Loom surfaces
    <!-- loom:provenance v1 build=unknown 5d5f41d89eef35adf478b92b96af06c6d86d27a6 clean prompts=none sweep=none story=none trace=05d2a40831b35ba1c48afada00c29519 host=robb-pro base=c273e4fe14104ce75921d9ece49a924ac818d0dc run=loom-run/v1:timer:robb-pro/fleet-resync:c58bb82e-a213-439d-b829-04234e141de9 installs=0.19.1027 59bb53f01eb99187ce25f22be1a64da5c877d115 -->
    Loom-Trace-Id: 05d2a40831b35ba1c48afada00c29519
    Loom-Build: unknown 5d5f41d89eef35adf478b92b96af06c6d86d27a6 clean
    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
2026-10-10 chore: resync installed Loom surfaces
    <!-- loom:provenance v1 build=unknown aa536103d6239818bb974a51d2f7f268eff38bad clean prompts=none sweep=none story=none trace=126a1328a3664e2119a0978086db9bea host=robb-studio base=8d1684ddcfbd91873dda5f620c414a5e0a7c5279 run=loom-run/v1:timer:robb-studio/fleet-resync:fbc4e361-e290-4d81-ae3a-8b5fde796815 installs=0.19.1031 286d609f09342e7c84f2e23771edbac5b1914659 -->
    Loom-Trace-Id: 126a1328a3664e2119a0978086db9bea
    Loom-Build: unknown aa536103d6239818bb974a51d2f7f268eff38bad clean
    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
2026-10-11 chore: resync installed Loom surfaces
    <!-- loom:provenance v1 build=unknown cf08873555e2eb95da295dcbee98b0dc34473381 clean prompts=none sweep=none story=none trace=67fbc483c3ca3e442d7928804c11ff06 host=robb-pro base=e1262698d170ffb8a64fac4864b38f696aac4e69 run=loom-run/v1:timer:robb-pro/fleet-resync:e3f97888-2b26-404a-bd47-86fd28a4eced installs=0.19.1041 b65c266b47d796bf37d1c04c6f616be0bc699056 -->
    Loom-Trace-Id: 67fbc483c3ca3e442d7928804c11ff06
    Loom-Build: unknown cf08873555e2eb95da295dcbee98b0dc34473381 clean
    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
2026-10-11 chore: resync installed Loom surfaces
    <!-- loom:provenance v1 build=unknown e91831edf7b55b29d3a2d88e266916fab9ce2563 clean prompts=none sweep=none story=none trace=f72dd67520a2c3802aa0495b80ac65a5 host=robb-studio base=5344658dc5715377f05841cb4873d0942d317bf8 run=loom-run/v1:timer:robb-studio/fleet-resync:91d2434e-eae5-45de-9305-d78c43fc7c7a installs=0.19.1042 5b6ebdcc40bfccc9357e15196984061f1d5e6178 -->
    Loom-Trace-Id: f72dd67520a2c3802aa0495b80ac65a5
    Loom-Build: unknown e91831edf7b55b29d3a2d88e266916fab9ce2563 clean
    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
2026-10-11 chore: resync installed Loom surfaces
    <!-- loom:provenance v1 build=unknown 5ec729b9f7dd55a2082752611e4c4964f49661fb clean prompts=none sweep=none story=none trace=efc2abc8b72538df6d1a6ea9d329603d host=robb-pro base=d7e4d8138186d976a7e6b9697018eaab9cb96d7a run=loom-run/v1:timer:robb-pro/fleet-resync:0d396c06-f26e-423e-97ac-6d3ac04a8e51 installs=0.19.1054 f6a73bc7fc942d7b297514b2e3f57a0ca2076010 -->
    Loom-Trace-Id: efc2abc8b72538df6d1a6ea9d329603d
    Loom-Build: unknown 5ec729b9f7dd55a2082752611e4c4964f49661fb clean
    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
2026-10-11 chore: resync installed Loom surfaces
    <!-- loom:provenance v1 build=unknown 745f69d0daad6c23e76cc006720fa4fbeaa3d887 clean prompts=none sweep=none story=none trace=3baabc4a039fd85029fff227a6ae690a host=robb-studio base=1273866bc0ff1d2f175f33309e350e9f374b2c5c run=loom-run/v1:timer:robb-studio/fleet-resync:3b3207d7-055d-49b5-a387-db375213668d installs=0.19.1058 00ceead491dd1ae20db00db16a650ea43dd0c09b -->
    Loom-Trace-Id: 3baabc4a039fd85029fff227a6ae690a
    Loom-Build: unknown 745f69d0daad6c23e76cc006720fa4fbeaa3d887 clean
    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
2026-10-11 chore: resync installed Loom surfaces
    <!-- loom:provenance v1 build=unknown b37a005ac1889262fb9e5338f7cff4e9ed4987da clean prompts=none sweep=none story=none trace=25c158d7e9591610b251780caaff1c5f host=robb-pro base=29ce85a4d4f8e70926e286c9063d99db0f608dae run=loom-run/v1:timer:robb-pro/fleet-resync:7f020bca-6920-47f7-a5e4-bbd5c82d9bb8 installs=0.19.1072 29b48db1ead9c4501304e0114a5c33310e1d589f -->
    Loom-Trace-Id: 25c158d7e9591610b251780caaff1c5f
    Loom-Build: unknown b37a005ac1889262fb9e5338f7cff4e9ed4987da clean
    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
2026-10-11 chore: resync installed Loom surfaces
    <!-- loom:provenance v1 build=unknown 81a6b4499cb57b3620785bc1625c300da34f0735 clean prompts=none sweep=none story=none trace=d08bbd290651d7bcbda8b216c0dfbcdf host=robb-studio base=8b80de1eda3e3480f968158ddf47d0024cf47bab run=loom-run/v1:timer:robb-studio/fleet-resync:71e05e3d-931c-46b4-b6d2-5f3f992c1e19 installs=0.19.1073 abb0872ba7d1d3f6f3a14f71f51a562e89308181 -->
    Loom-Trace-Id: d08bbd290651d7bcbda8b216c0dfbcdf
    Loom-Build: unknown 81a6b4499cb57b3620785bc1625c300da34f0735 clean
    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
2026-10-12 chore: resync installed Loom surfaces
    <!-- loom:provenance v1 build=unknown ddfb67ccf9a5115d62dd86924613a468b9328f44 clean prompts=none sweep=none story=none trace=772605234b9d8cafd6a4049200f7425c host=robb-pro base=e74e4bf6daab115aa26a493a53a4148639d3b300 run=loom-run/v1:timer:robb-pro/fleet-resync:1ef28ffc-0277-424f-9224-7ee6eca46377 installs=0.19.1081 be16cedf6a394661d3b1400531335927f5eb4519 -->
    Loom-Trace-Id: 772605234b9d8cafd6a4049200f7425c
    Loom-Build: unknown ddfb67ccf9a5115d62dd86924613a468b9328f44 clean
    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
2026-10-12 chore: resync installed Loom surfaces
    <!-- loom:provenance v1 build=unknown be358990895362019614bd207bcbe36bc9eeff2c clean prompts=none sweep=none story=none trace=f1dc643b95859c8f26e892ddb5e2c5d7 host=robb-studio base=2287f1fd25b2dc98208079967b840334c2cdf2a6 run=loom-run/v1:timer:robb-studio/fleet-resync:da486ca2-3e94-4a85-abd3-88707942489a installs=0.19.1086 d8cb20101a985145fb167c1933758075a14ce1ab -->
    Loom-Trace-Id: f1dc643b95859c8f26e892ddb5e2c5d7
    Loom-Build: unknown be358990895362019614bd207bcbe36bc9eeff2c clean
    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
2026-10-12 chore: resync installed Loom surfaces
    <!-- loom:provenance v1 build=unknown a579728c137cc11d08a48b178e0ff9aa21683e72 clean prompts=none sweep=none story=none trace=10832f2750dbcd63f6c6f301a6f4da9b host=loom-worker-2 base=fd3e6add520e1f1500f3519bae24fbdfa90c6663 run=loom-run/v1:timer:loom-worker-2/fleet-resync:180f6d5054f0479ab3990b86ab4522a5 installs=0.19.1087 51ac271f990b317a52ebf27cc21f34561e1179fb -->
    Loom-Trace-Id: 10832f2750dbcd63f6c6f301a6f4da9b
    Loom-Build: unknown a579728c137cc11d08a48b178e0ff9aa21683e72 clean
    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
2026-10-12 chore: resync installed Loom surfaces
    <!-- loom:provenance v1 build=unknown 02ecafe7734bf5faa945ce88940589f00eca78e9 clean prompts=none sweep=none story=none trace=5f71c537126994dc4c45179122427514 host=robb-pro base=0f1c8f99732a72c2bf72e4a1668e6eafeb8614fa run=loom-run/v1:timer:robb-pro/fleet-resync:6293e6da-8a67-45aa-b277-c9ef85ddb810 installs=0.19.1100 cb68783ad2c0695020e726d2ad67dac2fa9e501e -->
    Loom-Trace-Id: 5f71c537126994dc4c45179122427514
    Loom-Build: unknown 02ecafe7734bf5faa945ce88940589f00eca78e9 clean
    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
2026-10-12 chore: resync installed Loom surfaces
    <!-- loom:provenance v1 build=unknown 5918da96dcd60c9a677a195737c86ea38972d215 clean prompts=none sweep=none story=none trace=49bb7a8942d6a23bf41754ca27ff2368 host=loom-worker-2 base=a2ffb32f7581eeb36e5472ba30bcdabd79edfb19 run=loom-run/v1:timer:loom-worker-2/fleet-resync:2e973f04abd1447d8ee4b696c2e7d2b4 installs=0.19.1105 0ba0208975b8909f07005b5b04fd70276f919dfb -->
    Loom-Trace-Id: 49bb7a8942d6a23bf41754ca27ff2368
    Loom-Build: unknown 5918da96dcd60c9a677a195737c86ea38972d215 clean
    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
2026-10-12 chore: resync installed Loom surfaces
    <!-- loom:provenance v1 build=unknown 9885e6bbba36f53328e04be83140734c6eda9f58 clean prompts=none sweep=none story=none trace=72f34c4066d6ca844a10c33035a775bd host=loom-worker-1 base=db3f2f2253f5ef8906a984c127d16d91bc74ee23 run=loom-run/v1:timer:loom-worker-1/fleet-resync:8f5732bc51fd43379e17e0de51e86bae installs=0.19.1108 72427939d156341080a7006ae6fbb5ec96b2368e -->
    Loom-Trace-Id: 72f34c4066d6ca844a10c33035a775bd
    Loom-Build: unknown 9885e6bbba36f53328e04be83140734c6eda9f58 clean
    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
2026-10-12 chore: resync installed Loom surfaces
    <!-- loom:provenance v1 build=unknown 01467247f32c59822968bf02d3214d9a3d613452 clean prompts=none sweep=none story=none trace=0e97e9733eef09a33959cf96e6271f40 host=robb-studio base=fe9cc3d68b0c7b1e4acee38688cb5fa22d838417 run=loom-run/v1:timer:robb-studio/fleet-resync:53a4d390-3842-4216-9018-5dced9d0ea17 installs=0.19.1109 d9498fcd419776b2517e30b99c88e76bbe92d2f4 -->
    Loom-Trace-Id: 0e97e9733eef09a33959cf96e6271f40
    Loom-Build: unknown 01467247f32c59822968bf02d3214d9a3d613452 clean
    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
2026-10-12 chore: resync installed Loom surfaces
    <!-- loom:provenance v1 build=unknown e53c99fb3a3453071ca76cce4a40b0deee3010a1 clean prompts=none sweep=none story=none trace=5918b7b32b15194bf3b937a473250a05 host=robb-pro base=4e93a0c86a67ff0bdcd9b707f9d32d388e9a6f28 run=loom-run/v1:timer:robb-pro/fleet-resync:164b019c-09a4-43c2-9863-2afd2cd8c928 installs=0.19.1124 172a8b5e7fadbbac346679f692d4603683db486f -->
    Loom-Trace-Id: 5918b7b32b15194bf3b937a473250a05
    Loom-Build: unknown e53c99fb3a3453071ca76cce4a40b0deee3010a1 clean
    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
2026-10-12 chore: resync installed Loom surfaces
    <!-- loom:provenance v1 build=unknown 6d6a81bfd0d38dff3dfe3cc6d08965f57d71ab67 clean prompts=none sweep=none story=none trace=53e704452fd9a4802b952dbffcec3017 host=loom-worker-3 base=60fa5721f2f4b183791169952e7956f4bfe292cb run=loom-run/v1:timer:loom-worker-3/fleet-resync:da09a55781444da6865c7c3d6fcf7edb installs=0.19.1126 7736d1276b6d01778fba3461114c858ef1bf5e2d -->
    Loom-Trace-Id: 53e704452fd9a4802b952dbffcec3017
    Loom-Build: unknown 6d6a81bfd0d38dff3dfe3cc6d08965f57d71ab67 clean
    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
2026-10-12 chore: resync installed Loom surfaces
    <!-- loom:provenance v1 build=unknown 8d832cc8035d4ba07872510416468da0790332cd clean prompts=none sweep=none story=none trace=09a53bf60e96fc30a753caffd1de8c92 host=robb-studio base=c69dcdcb76e1c8d2025ffc3c236841ed3f3e9db0 run=loom-run/v1:timer:robb-studio/fleet-resync:baf4c30c-65d9-4d4e-a740-f6a80cbb975c installs=0.19.1132 8695bdd2b7b963dca9b76f4643a9d7c744294426 -->
    Loom-Trace-Id: 09a53bf60e96fc30a753caffd1de8c92
    Loom-Build: unknown 8d832cc8035d4ba07872510416468da0790332cd clean
    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
2026-10-12 chore: resync installed Loom surfaces
    <!-- loom:provenance v1 build=unknown aa1ed0d7d5499d2705977d971673d919dbbbaf4e clean prompts=none sweep=none story=none trace=2522608826ef5d5e4a88a9667055aeb7 host=loom-worker-2 base=c87fad7c48d7082fe698cb7ebc27081ed24b1c5f run=loom-run/v1:timer:loom-worker-2/fleet-resync:8f26b719c712455381744111c50e90b4 installs=0.19.1142 b91ae5d1b5204f499a1abb875a6cf5bffc1d90b1 -->
    Loom-Trace-Id: 2522608826ef5d5e4a88a9667055aeb7
    Loom-Build: unknown aa1ed0d7d5499d2705977d971673d919dbbbaf4e clean
    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
2026-10-12 chore: resync installed Loom surfaces
    <!-- loom:provenance v1 build=unknown 8b64614d017d6ce7491c3a2ac9da51e5e2901c97 clean prompts=none sweep=none story=none trace=66044c049ba635bcd6a4797c3a77e84b host=robb-pro base=c45941f969c9a4d8cfecc3f432ee700af9223cec run=loom-run/v1:timer:robb-pro/fleet-resync:68f56594-05d0-4cc0-9c07-36263359d698 installs=0.19.1144 9e4381cbbd2386393e44c7a979583252948a3998 -->
    Loom-Trace-Id: 66044c049ba635bcd6a4797c3a77e84b
    Loom-Build: unknown 8b64614d017d6ce7491c3a2ac9da51e5e2901c97 clean
    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
2026-10-13 chore: resync installed Loom surfaces
    <!-- loom:provenance v1 build=unknown e66f00108a9519331aa981da8a01c6569ca623a9 clean prompts=none sweep=none story=none trace=d3e476cf8c03d5ed37f8e146b3632190 host=robb-studio base=8b71b88a0b04cabffb746d012ddbb0415b50419c run=loom-run/v1:timer:robb-studio/fleet-resync:1d7ace45-2daf-4c92-a752-67b11e982245 installs=0.19.1146 972552531e3e890528f13c6cc8fb7406877c96f9 -->
    Loom-Trace-Id: d3e476cf8c03d5ed37f8e146b3632190
    Loom-Build: unknown e66f00108a9519331aa981da8a01c6569ca623a9 clean
    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
2026-10-13 chore: resync installed Loom surfaces
    <!-- loom:provenance v1 build=unknown 98d08ab78cc223361354ee9947d996b1cb914b30 clean prompts=none sweep=none story=none trace=8b73addcdeaa8fbd65998649f42a8c50 host=loom-worker-2 base=e6c9552c51152e0a6bb1dd4f28dd4660e7d0f100 run=loom-run/v1:timer:loom-worker-2/fleet-resync:3bfb13d52fca425f9cfced4541954cb6 installs=0.19.1148 1448fdfa79ac2dcab7fad6b95b72697b450f2a4a -->
    Loom-Trace-Id: 8b73addcdeaa8fbd65998649f42a8c50
    Loom-Build: unknown 98d08ab78cc223361354ee9947d996b1cb914b30 clean
    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
2026-10-13 chore: resync installed Loom surfaces
    <!-- loom:provenance v1 build=unknown d0bfbbc7ac309581d7abe02c4a269c7704010ee0 clean prompts=none sweep=none story=none trace=0ad6d167235000f3b5648cbd63d761ce host=robb-pro base=ea2eb815393dd54c047426cc756f26998cca2166 run=loom-run/v1:timer:robb-pro/fleet-resync:4f7cbe22-40b6-49ff-8811-003ae8577c28 installs=0.19.1151 08ee0f8708464aa8e0768640d56955d7f4fcbc98 -->
    Loom-Trace-Id: 0ad6d167235000f3b5648cbd63d761ce
    Loom-Build: unknown d0bfbbc7ac309581d7abe02c4a269c7704010ee0 clean
    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
2026-10-13 chore: resync installed Loom surfaces
    <!-- loom:provenance v1 build=unknown 7916c4043a1b57e97a53bc5c111e74c5038a1091 clean prompts=none sweep=none story=none trace=20b27ffb08c4130dc9836ee8d9d97b97 host=loom-worker-2 base=91fad28679d4c4eab8c36e43a5c0a81974353d66 run=loom-run/v1:timer:loom-worker-2/fleet-resync:d34532ec625a4162ae8b58dde1a6738f installs=0.19.1151 f7d1deaab02a9c483fce1ced33fadb1af6d86f59 -->
    Loom-Trace-Id: 20b27ffb08c4130dc9836ee8d9d97b97
    Loom-Build: unknown 7916c4043a1b57e97a53bc5c111e74c5038a1091 clean
    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
2026-10-13 chore: resync installed Loom surfaces
    <!-- loom:provenance v1 build=unknown 7916c4043a1b57e97a53bc5c111e74c5038a1091 clean prompts=none sweep=none story=none trace=773e9e41a5730d2f79f2381ad2cde068 host=robb-pro base=dcb92dc96473d87070a7da63a0236f7ba25e8415 run=loom-run/v1:timer:robb-pro/fleet-resync:b7ca0d34-434e-4536-85b9-57adfa603a8d installs=0.19.1151 a885af872d054695b81e8458dfc7bd717cbddba8 -->
    Loom-Trace-Id: 773e9e41a5730d2f79f2381ad2cde068
    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
2026-10-13 chore: resync installed Loom surfaces
    <!-- loom:provenance v1 build=unknown f57244868aa20ef22c18aa8025972184aaea43e4 clean prompts=none sweep=none story=none trace=8e03b78fe6cb43a017c4a4823362ffa7 host=loom-worker-2 base=fb67576dfa73771e240a909696fabd28e1ed70a3 run=loom-run/v1:timer:loom-worker-2/fleet-resync:eb553d2fc2a54589aa37879f12b18ed5 installs=0.19.1151 08ee0f8708464aa8e0768640d56955d7f4fcbc98 -->
    Loom-Trace-Id: 8e03b78fe6cb43a017c4a4823362ffa7
    Loom-Build: unknown f57244868aa20ef22c18aa8025972184aaea43e4 clean
    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
2026-10-13 chore: resync installed Loom surfaces
    <!-- loom:provenance v1 build=unknown f91cd239df41290ba3efb8bc14320984e3392c6f clean prompts=none sweep=none story=none trace=c1345a24765b7e1c5307ef032fd77486 host=loom-worker-3 base=9f7925fc8e7f452dccd1938ee33bab315a71f1fc run=loom-run/v1:timer:loom-worker-3/fleet-resync:c4883600330b4d70afac9e743a4e52e3 installs=0.19.1151 4b3b3e77e5ef42971b3c0c3e68c000736a0c7c21 -->
    Loom-Trace-Id: c1345a24765b7e1c5307ef032fd77486
    Loom-Build: unknown f91cd239df41290ba3efb8bc14320984e3392c6f clean
    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
2026-10-13 chore: resync installed Loom surfaces
    <!-- loom:provenance v1 build=unknown 6fe43c87955e02019c2bc8dfad4fbd160b89170c clean prompts=none sweep=none story=none trace=49a4590bf54e81899c26d965f682504c host=robb-studio base=94c6c2ebf4da9599c2a76603461f619f3ec9c0f1 run=loom-run/v1:timer:robb-studio/fleet-resync:459197b3-0050-4335-893e-e47b638eb819 installs=0.19.1151 4ec7e046f71ff70b92c88ed647cff72d6a9d1e85 -->
    Loom-Trace-Id: 49a4590bf54e81899c26d965f682504c
    Loom-Build: unknown 6fe43c87955e02019c2bc8dfad4fbd160b89170c clean
    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
2026-10-13 chore: resync installed Loom surfaces
    <!-- loom:provenance v1 build=unknown 5dc3a07d084d0ec4034f0782d572925dcad86af7 clean prompts=none sweep=none story=none trace=cbc11657acadf58858409fe543c342e1 host=robb-pro base=7f592a9b0f112e918fd01d91f49032760034c1d4 run=loom-run/v1:timer:robb-pro/fleet-resync:be586137-d91e-4e2c-82d6-3164d43aa9de installs=0.19.1152 2d5fe17958dca799058f16bdd74a12336990bec0 -->
    Loom-Trace-Id: cbc11657acadf58858409fe543c342e1
    Loom-Build: unknown 5dc3a07d084d0ec4034f0782d572925dcad86af7 clean
    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
2026-10-13 chore: resync installed Loom surfaces
    <!-- loom:provenance v1 build=unknown 27a266d5a27885323290840d2a837d73fcf4bcc6 clean prompts=none sweep=none story=none trace=e77cdd5477ef6bfc65fba6cc233788e0 host=loom-worker-2 base=95b550c192dc4358f0433db0c2dc11850cc254f9 run=loom-run/v1:timer:loom-worker-2/fleet-resync:7fac7d82f298441a91761382ac989183 installs=0.19.1152 43f03f1fe0988c7870431d6bba187c13018b4420 -->
    Loom-Trace-Id: e77cdd5477ef6bfc65fba6cc233788e0
    Loom-Build: unknown 27a266d5a27885323290840d2a837d73fcf4bcc6 clean
    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
2026-10-13 chore: resync installed Loom surfaces
    <!-- loom:provenance v1 build=unknown f2b62a2cf576d7d37092147b2281da809f8b5cf5 clean prompts=none sweep=none story=none trace=8adfa75521c72dded43e2932febb6329 host=loom-worker-3 base=fda25607e4fedc07598c0f9a21018cb3329b3250 run=loom-run/v1:timer:loom-worker-3/fleet-resync:8a8198f8f80e4703bc7365a5e10595e0 installs=0.19.1152 43f03f1fe0988c7870431d6bba187c13018b4420 -->
    Loom-Trace-Id: 8adfa75521c72dded43e2932febb6329
    Loom-Build: unknown f2b62a2cf576d7d37092147b2281da809f8b5cf5 clean
    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
2026-10-13 chore: resync installed Loom surfaces
    <!-- loom:provenance v1 build=unknown 84d11f248d368cae5e04a2255f6897a406c50089 clean prompts=none sweep=none story=none trace=8e50b4ccc3dc58f709a732f69d58fd44 host=robb-studio base=f0276c84a8d648ca4d88d3356c3ec1bc90335dfd run=loom-run/v1:timer:robb-studio/fleet-resync:05c9f3b1-eee2-412f-8996-5fbf02793d9e installs=0.19.1153 d8429a4fabdc955107af1cbc22c548e23eecf9b1 -->
    Loom-Trace-Id: 8e50b4ccc3dc58f709a732f69d58fd44
    Loom-Build: unknown 84d11f248d368cae5e04a2255f6897a406c50089 clean
    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
2026-10-15 loom: unpin verdict-staleness-guard.sh and the forge-helpers rate-limit test (2am#4345 Q7)
    Each pin here was a stopgap until an upstream fix landed, and each fix
    has now landed upstream:
    - scripts/verdict-staleness-guard.sh (#236/#237, the unsupported `merged`
    JSON field): upstream requests state-only since rjwalters/loom#6799.
    - scripts/tests/test-forge-helpers-rate-limit-fallback.sh (#205/#208,
    the FORGE_CMD_SRC consumer-checkout SKIP): upstream SKIPs since
    rjwalters/loom#6736.
    Keeping the pins stopped being harmless. The pinned
    verdict-staleness-guard.sh missed later hardening of the merge-safety
    verdict check: #9258 (an unmarked approval is STALE), #9548 (trusted
    markers only) an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
2026-10-15 sim: evaluate xschem expr() params; first live startup-stability batch run, 45/45 PASS (#320)
    Loom-Build: 0.19.1160 57eb4ca19ae4a3124f3d162a1130df2c9036ce5e clean
    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
2026-10-15 docs(sim): measure injector eviction margin at 27C corners; MNG clamp and weak stack fail itrav floor (DR-015)
    Loom-Build: 0.19.1162 f1ee755eeca1954f35bf83d19f4b84ad51feb9f5 clean
    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
2026-10-15 docs(sim): add per-node mode to injector eviction probe and record MNG clamp loss mechanism (DR-016)
    Loom-Build: 0.19.1163 695290c117c5d456d46b434f9e2817200184f217 clean
    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
2026-10-15 docs(sim): add VBE-raised NG clamp probe variant and record edge-eviction result (DR-017)
    Part of #315
    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
2026-10-15 docs(sim): record three-high injector stack failing startup-stability at 125C (35/45) and DR-018
    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
2026-10-15 feat(sim): run the PSRR injector screen on the batch fleet
    Enable psrr-dc-with-injector for corner-run --backend batch (AC deck, vector-slice
    expr measurements pass through klt unchanged) and add --backend batch to the
    psrr-injector-candidates harness: one ac and one op klt request per variant and
    supply voltage. Shared request/job-metadata code is factored out of batch_sim.
    Loom-Story: 2AMLogic/sky130-bandgap#361
    Loom-Trace-Id: 25b0b90b933dc69f8390e47ab3bc6d44
    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
2026-10-15 feat(sim): add VBE-raised-clamp variants (mngq, ref3_mngq) to the PSRR injector screen
    Loom-Build: 0.19.1164 4f137ac910d942a0fde6fb51791c679c89832ee6 clean
    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
2026-10-15 docs(sim): shard batch PSRR screen requests; record mngq failing 60 dB floor at 2.97 V (DR-019)
    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
2026-10-15 feat(sim): shard batch requests over remote.hosts to fit the fleet job ceiling
    Loom-Story: 2AMLogic/sky130-bandgap#364
    Loom-Trace-Id: cfca1d72323fc1bf4aff27583d63ce57
    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
2026-10-15 docs(spec): DR-020 records the MPC2-on-VSENSE injector screen; add mpc2_vs variants
    mpc2_vs lifts ff/125/3.63 PSRR from 24.8 to 67 dB at no device cost but leaves
    three 2.97 V corners under 60 dB; adding the MNG clamp clears PSRR but loses
    window-edge eviction at tt/27. Adds the variants to the candidate bench, a
    netlist test, and an mpc2vs token in the eviction probe.
    Part of #368
    Loom-Story: 2AMLogic/sky130-bandgap#368
    Loom-Trace-Id: 4cb77c54811ef4596c5ff8b13d469a98
    Loom-Build: 0.19.1166 8a9aad12e32504cea9a7c7d2ed774749c487f875 clean
2026-10-15 build(sim): re-pin PDK to open_pdks f6eeac7 via ciel and read revision from SOURCES
    Pin sim/pdk.json, CI, docs and scripts to f6eeac7 installed with ciel 2.6.1
    (~/.ciel). The resolver no longer calls 'volare path' and derives the
    installed revision from the tree's SOURCES file instead of the symlink path,
    so a stray ~/.volare tree is refused as a pin mismatch.
    Loom-Story: 2AMLogic/sky130-bandgap#369
    Loom-Trace-Id: a5021ca15f9b334f15c5309349a45933
    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
2026-10-15 test(sim): skip the klt-vs-local PSRR comparison when no pinned PDK is installed
    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
2026-10-17 refactor(layout): break gen_bandgap_routed <-> bus_routing import cycle
    Move the shared constants, MET1_BUS_NOTE, SCHEMATIC_INTER_BLOCK_NETS and
    schematic_net_coverage into layout_common.py so bus_routing.py imports
    nothing from gen_bandgap_routed.py. Drop the bus_routing deferred imports
    and cycle-explaining comment blocks.
2026-10-17 feat(signoff): attest T1 items 1, 2, 9, 10 with artifact-anchored envelopes on klt 0.7.0
    Bump the grader pin to 0.7.0 and grade against the checklist bundled with the
    wheel (drop --tiers-doc and the vendored copy). Add scripts/ci/attest_inventories.py,
    which derives hash-pinned inventories and generic envelopes for items 1, 2, 9
    and 10 from the tree (klt signoff --attest is not in 0.7.0), and wires them into
    the manifest, pinned-inputs.json and regenerate.sh. Commit xschem-derived
    netlists of the three schematics with a lock (scripts/ci/design_netlists.py)
    so a schematic edit without regenerating its netlist fails CI.
    Report moves 3/11 -> 6/11: items 1, 2, 9, 10 become met; item 6 becomes
    u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
2026-10-20 chore(layout): prune 8 trivial-cell runs duplicating the current record, fix README current-record pointer
2026-10-20 feat(sim): batch backend for psrr-dc and quiescent-current; translate meas decks
    Enable --backend batch for psrr-dc and quiescent-current (one tt/27C/3.3V
    corner each compared on the fleet against the newest records: identical).
    Add the single-step analysis_steps translation for decks with meas commands
    (line-regulation, output-voltage-tc, startup-ramp, startup-time), verified
    against the local deck with klt --backend local but held back because the
    fleet runner's klt rejects analysis_steps. error-amp-loop stays local.
    Part of #395
    Loom-Issue: 2AMLogic/sky130-bandgap#395
2026-10-20 feat(sim): add --backend batch to the translatable post-layout runners
    post_layout_common.py now accepts --backend local|batch (plus the batch
    capacity/version-check flags) and routes the matrix through batch_sim.execute.
    Enabled for psrr-dc, quiescent-current and startup-stability post-layout;
    the benches whose manifests use meas cards are refused with a stated reason.
    Single-corner batch records for quiescent-current and psrr-dc match the
    newest local records exactly.
    Part of #396
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2026-10-21 feat(sim): build klt Monte Carlo batch requests for error-amp-offset-mc
    --backend batch --dry-run prints one monte_carlo request per mismatch point
    (section as process, n/seed from the point, the runner's let vectors as
    measurements). A real batch run is refused until klt reports can be turned
    back into a record.
    Part of #398
2026-10-21 feat(sim): build klt Monte Carlo batch requests for monte-carlo-untrimmed
    --backend batch --dry-run prints one monte_carlo request per point (section as
    process, n/seed from the point, v(vref)/v(gdrv) as measurements). The config
    axis rides in each request's netlist as .param coefficient overrides after the
    circuit body, and the testbench's .save card is dropped. A real batch run is
    refused until klt reports can be turned back into a record.
    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
2026-10-21 feat(sim): add --backend batch and --dry-run to psrr-injector-attribution
    Each variant x supply becomes one ac and one op klt sim request over the
    process x temperature cross product, with the variant's body from
    variant_body() as the netlist (same shape as psrr-injector-candidates).
    --dry-run prints the 30 requests; a real batch run reuses the candidates
    screen's collection and record path (execution block, batch_integrity
    checks). --jobs now defaults to 2 and is refused with --backend batch.
    Closes #398
2026-10-22 fix(signoff): regenerate attestation inventories and report after PDK re-pin
    The ciel PDK re-pin (8d9d8832) landed alongside the inventories added in
    the signoff attestation merge, leaving their content hashes and the T1 item
    11 citation stale. Output of ./signoff/regenerate.sh; no hand edits.
2026-10-22 test(signoff): follow the re-pinned PDK commit in the pin-edit negative control
    The control replaced the old open_pdks commit in sim/pdk.json; after the
    ciel re-pin the string no longer occurs, so the edit was a no-op and the
    control asserted a failure that could not happen.
2026-10-22 signoff: cite a klt 0.7.0 LVS report with provenance for T1 item 4, pin item 11's LVS half
    Re-run the committed LVS request under the released klayout-tools 0.7.0 wheel
    into a new record (status match, error_count 0, provenance.input.content_hash
    recorded), re-measure combine determinism (1000/1000 match for both variants),
    and cite/pin it from the manifest for items 4 and 11. Item 4 grades met (7/11).
2026-10-22 feat: declare n-well ties in the ERC supply spec on klt 0.7.0
    Bump the ERC klt pin to v0.7.0, replace ties_disclosure with two ties[]
    entries selecting well classes via well_requires_boxes, add a swapped-net
    negative control, and gate erc.missing_tie in the record script.
2026-10-22 fix: regenerate T1 attestation inventories and signoff report
    Rebuild signoff/attest/* and block-manifest.json via attest_inventories.py
    --write and re-grade signoff-report.json with the pinned klayout-tools 0.7.0
    wheel (8/11 T1 items still met).
2026-10-23 refactor(layout): drop unused mos_pad and fmt_findings helpers
    Both had no callers; GDRV routes through mos_comb and mos_unit covers the
    single-pad case.
    Closes #428
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2026-10-27 feat(sim): collect batch Monte Carlo reports into the untrimmed-Vref record
    --backend batch without --dry-run now submits the per-point klt requests,
    folds each report's per-draw corners into the local path's sample structure,
    and writes the normal record; emit_klt_yield.py reads the batch samples file
    when no ngspice log exists.
2026-10-27 feat(signoff): cite klt sim envelopes minted from corner records for T1 item 5
    Mint one klt sim-shaped envelope per (bench, ratified spec row) from the
    committed corner records without re-simulating, declare spec_rows.5 with
    gaps for the Monte Carlo, trim and area rows, and move the grader pin to
    klt 0.8.0 (spec_rows / multi-citation item 5). Item 5 now grades
    check_failed naming rows 1b, 3a, 3b, 4b, 8a instead of no_evidence.
2026-10-27 build: pin klayout-tools==0.8.0 in layout requirements
    Replace both git+https commit pins with the PyPI release and refresh the
    header comments and layout/README.md text that described the git pins.
    Part of #448
    Loom-Issue: 2AMLogic/sky130-bandgap#448
2026-10-28 fix(layout): snap drawn bus rects to the 5 nm grid so the routed flow is DRC clean under klt 0.8.0
    Met1Bus._rect wrote route coordinates derived from non-grid pitches
    (e.g. y=55.6667 um); the 0.8.0 deck's *.ongrid.1 rules flagged 406 vertices.
    Snapping at emission clears them (drc clean, new record 20261028-063447-2c76afb7).
    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
2026-11-04 docs: update WORK_PLAN from current label state
    Automated document maintenance by Guide triage agent.
2026-11-04 sim: record failed N=20 batch smoke run (fleet capacity losses)
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2026-11-05 signoff: regenerate T1 attestation inventories after batch throttle changes
    Rebuilt via scripts/ci/attest_inventories.py --write; clears the stale
    testbench-inventory, item-9 evidence and block-manifest pins.
2026-11-06 chore(layout): run ERC flow from the shared layout venv, drop separate klt pin
    Both requirements files pin klayout-tools==0.8.0, so the second pin, its
    gitignored .venv-erc, and the duplicate venv bootstrap in
    run-erc-supply-flow.sh are removed; the flow now calls setup-venv.sh.
    Stale "by git ref" comments in setup-venv.sh are corrected. Committed ERC
    records and signoff files are untouched.
2026-11-06 fix: skip already-tracked bytes when publishing sim evidence
    publish_corner_evidence() now drops staged files whose sha256 matches a
    git-tracked file before klt artifact put, lists them in the summary, and
    fails closed when every file is a duplicate.
2026-11-06 feat: native klt pex pilot for output-voltage TC with recorded 15-corner result
    Adds sim/pex-native (reference composer, measure command, input checks,
    delta grader, run.sh) and the first pinned-klt 0.8.0 pex record. All graded
    deltas exceed the pre-declared limits; item 7 is left uncited.
    Closes #335
2026-11-07 docs: attribute pex-native pilot Vref delta to resistor-leg parasitics
    Add attribute_delta.py (leg resistance, normaliser value/TC check, single-corner
    probe with ablations), a test, and a dated attribution section in the README.
2026-11-11 feat(sim): enable batch backend for the four analysis_steps pre-layout benches
    line-regulation, output-voltage-tc, startup-ramp and startup-time move into
    BATCH_ENABLED_SLUGS now that the runner klt accepts analysis_steps. Each ran
    one tt/27C/3.3V corner on the fleet and equals the newest local record.
    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
2026-11-12 sim: re-qualify psrr-dc-with-injector under open_pdks f6eeac7 (DR-021 slice)
    45/45 corners on the batch fleet; results identical to the superseded
    record (25/45 FAIL in both), so the re-pin moved nothing. Index and
    per-row deltas appended to DR-021.
    Part of #370
2026-11-12 sim: re-qualify six pre-layout benches under open_pdks f6eeac7 (DR-021 slice B)
    Full 45-corner batch re-runs of line-regulation, output-voltage-tc, psrr-dc,
    quiescent-current, startup-ramp and startup-time, each --supersedes the record
    the characterization report cites. All measurement ranges and pass/fail counts
    match the superseded records; indexed in DR-021. Signoff envelopes regenerated
    with emit_klt_sim_envelopes.py --write. No existing record edited.
    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
2026-11-12 sim: re-qualify three batch-enabled post-layout benches under open_pdks f6eeac7 (DR-021 slice C)
    Batch re-runs of psrr-dc-post-layout, quiescent-current-post-layout and
    startup-stability-post-layout, each --supersedes the record the characterization
    report cites. Measurement ranges and pass/fail counts match the superseded
    records; indexed in DR-021, which also lists the four non-batch post-layout
    benches as not re-qualified. Signoff envelopes regenerated with
    emit_klt_sim_envelopes.py --write. No existing record edited.
    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
2026-11-13 sim: collect error-amp-offset-mc batch reports into a record
    `run_amp_offset_mc.py --backend batch` without `--dry-run` raised a
    `HarnessError` saying record collection was not implemented. It now submits
    one `klt sim` Monte Carlo request per `MismatchPoint`, collects the
    per-sample reports and feeds them through the same `rratio` derivation,
    operating-window partition, `evaluate()` and `render_record()` path as a
    local run. The record gains an `execution` block (job ids, fleet engine
    version) and its `tools.ngspice` line names the fleet's ngspice.
    Any submit/collect failure, wrong per-point sample count (with the
    unlaunched/lost shard counts appended), model-library sha256 mismatch or
    klt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
2026-11-13 docs: regenerate the characterization report onto the f6eeac7 records, and re-qualify error-amp-offset-mc
    `design/block-characterization-report.md` cited a record minted under the old
    open_pdks pin on every row. Twenty rows plus section 3 items 5-7 now cite the
    record DR-021 re-qualified under `f6eeac7`, re-derived from the newest record
    in each bench directory per the report's own section 0 regeneration rule. No
    verdict, binding corner or disposition moves. Three last-printed-digit updates
    (row 1b's `vref_27` range; row 4f's 317 -> 363 checks and 3 -> 4 variants) and
    one inherited rounding slip (rows 8d/8e `gdrv_final` 1.598 -> 1.597 V) are
    listed in the new section 0 revision entry, togeth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
2026-11-13 docs: attribute the MC draw difference to the backend seeding scheme, and state the real largest sigma move
    Addresses the Judge's two blocking findings on PR #521. Both are text fixes;
    no re-run, and no recorded number changes.
    1. Cause of the draw difference. DR-021 slice F, the Consequences paragraph,
    the characterization report and the offset-budget doc all said the draws
    differ because ngspice's mismatch draws for a given `setseed` are not
    portable across platform. The batch path does not use `setseed` at all:
    `run_amp_offset_mc.py`'s `build_batch_groups` replaces the
    `setseed`/`reset`/`dowhile` loop with klt `monte_carlo {n, seed}`, and klt
    derives each sample's `.opt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
2026-11-13 chore(signoff): rebuild T1 attestation for the edited sim runners
    The PR edits inventoried testbench runners under sim/, which changes their
    content hashes, so the committed attestation went stale against the tree and
    `npm run check:ci` failed on scripts/ci/attest_inventories.py.
    Regenerated with `python3 scripts/ci/attest_inventories.py --write`: the five
    inventoried runners' hashes in testbench-inventory.json, the item-9 envelope
    that pins that inventory, and the manifest pin on item-9. Pure derivation from
    the committed tree -- no hand-edited hashes.
2026-11-13 chore(signoff): re-grade the verdict of record after the attestation rebuild
    Rebuilding the T1 attestation moved the item-9 citation hash, so the committed
    signoff/signoff-report.json no longer reproduced from the manifest and the
    `klt signoff (T1 tier-verdict freshness)` job went red ("same verdict, citation
    drifted").
    Re-graded with ./signoff/regenerate.sh (throwaway venv + the pinned
    klayout-tools==0.8.0 registry wheel, as the script's grader-distribution
    discipline requires). Only the item-9 citation hash moves; the verdict is
    unchanged at T1 8/11 items met.
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2026-11-13 refactor(sim): build trim-lsb-chained requests with batch_sim.build_adhoc_group
    run_trim_lsb_chained.py carried a private copy of the `klt sim --backend
    batch` request document (`build_request()`) and its own request-directory
    writer. The copy predates `batch_sim.build_adhoc_group()` by a week and had
    since drifted from it: it sent no `remote.hosts` and no
    `options.ngspice_init`.
    The sharding row is load-bearing, not cosmetic. Each request here is 5 units
    (5 processes x 1 temperature) at `--timeout 1800`, so unsharded its serial
    job bound is 9120 s against the fleet's 3600 s whole-job ceiling. The shared
    builder sends `remote.hosts: 5`, which brings the per-shard bound to 1920 s.
    - delete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
2026-11-13 refactor(sim): one Monte Carlo batch collector for both MC benches
    `sim/error-amp-offset-mc/run_amp_offset_mc.py` and
    `sim/monte-carlo-untrimmed/run_mc_untrimmed.py` each carried their own copy of
    the batch-report collector -- `record_tools()`, `samples_path()` and a
    ~55-line `collect_batch()` body that differed only in one extra sidecar key,
    some comment wording, and the write ordering on the refusal path.
    Move the bench-independent part into `sim/bin/batch_sim.py` as
    `collect_mc_batch()`, beside the `samples_from_report()` / `shard_loss()` /
    `job_meta()` helpers both copies already called (issue #514 moved those for the
    same reason). `record_tools()` now takes the `tool_versions()` dict a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
2026-11-13 chore(signoff): rebuild T1 attestation and re-grade for the edited MC runners
    Both Monte Carlo runners are inventoried testbenches, so editing them moves
    their content hashes and the committed attestation goes stale against the tree
    (`npm run check:signoff-pins` fails on scripts/ci/attest_inventories.py).
    Regenerated with `python3 scripts/ci/attest_inventories.py --write`: the two
    runners' hashes in testbench-inventory.json, the item-9 envelope that pins that
    inventory, and the manifest pin on item-9. That moves the item-9 citation hash,
    so the verdict of record no longer reproduced from the manifest and the `klt
    signoff (T1 tier-verdict freshness)` job would have gone red ("same verdict,
    c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
2026-11-13 fix(sim): refuse an over-ceiling Monte Carlo batch budget and size the MC shard count
    An MC `klt sim` request's units are its `monte_carlo.n` draws, so the two MC
    runners' per-point `--timeout` defaults (3600 s / 7200 s) were passed through
    as a per-SAMPLE budget `n` times larger than klt enforces. At 3600 s even one
    sample exceeds the fleet's 3600 s whole-job ceiling, so no `remote.hosts` split
    fits and `shard_hosts()` fell back to one Spot host per sample. Nothing refused
    it: `build_groups()`'s `enforce_job_ceiling` flag (#510) was never wired to
    `build_mc_group()`. The three committed `monte-carlo-untrimmed` batch attempts
    each asked for 280 hosts and lost 174 / 177 / 170 shards, for samp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
2026-11-14 feat(signoff): cite the failing klt pex pilot for T1 item 7
    T1 item 7 graded `unmet` / `no_evidence` while a kind-correct, first-party
    `klt pex` report sat uncited in the tree since 2026-11-06. That understated
    what the repo holds: the evidence exists and fails its declared limits, which
    is a more useful verdict than none.
    Cite it. `signoff/block-manifest.json` gains an `evidence."7"` entry naming
    `sim/pex-native/records/20261106-pilot/pex-stdout.json`, and
    `signoff/pinned-inputs.json` gains the matching pin to the routed GDS its
    `provenance.input.content_hash` describes (`role: layout`, the same stream
    items 2, 3 and 11 pin). Both are hand-added static entries, following the
    items 3/4/6/11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
